Klajdi00/open_mabel/firmware/openarm_dual/include/README

Project headers: CAN bus wrapper (`CanBus.h`), DaMiao and Dynamixel actuators, `Robot`, and the `/robot.json` loader. See ../README.md.
