Klajdi00/open_mabel/web_gui/simulation_control_center/docs/figures/macnav_summary.txt

macnav experimental summary — regenerated by exp_macnav.py
2026-07-02 05:41
================================================================================================
E1 odom   square clean a=0.98            RMS pos 0.008 m (0.3 %/m), yaw RMS 0.26 deg, n=5
E1 odom   square nominal a=0.98          RMS pos 0.011 m (0.4 %/m), yaw RMS 0.56 deg, n=5
E1 odom   square harsh a=0.98            RMS pos 0.033 m (1.1 %/m), yaw RMS 3.04 deg, n=5
E1 odom   spin clean a=0.98              RMS pos 0.051 m (GT path only 0.12 m), yaw RMS 0.87 deg, n=5
E1 odom   spin nominal a=0.98            RMS pos 0.048 m (GT path only 0.12 m), yaw RMS 1.24 deg, n=5
E1 odom   spin harsh a=0.98              RMS pos 0.037 m (GT path only 0.12 m), yaw RMS 2.79 deg, n=5
E1 scrub  square                         gate on 0.008 m vs off 0.008 m RMS (1.0x, n=5+5)
E1 scrub  spin                           gate on 0.048 m vs off 0.076 m RMS (1.6x, n=5+5)
E1 yaw    square nominal                 wheel-only 1.7 deg vs gyro-only 0.60 deg RMS
E2 slam   home n10                       RMSE 0.050±0.001 m, F1 0.92, IoU 0.17, corr 0.66, 21 ms/upd, n=3
E2 slam   home base_n30                  RMSE 0.050±0.005 m, F1 0.89, IoU 0.15, corr 0.61, 60 ms/upd, n=3
E2 slam   home n50                       RMSE 0.053±0.003 m, F1 0.93, IoU 0.17, corr 0.67, 102 ms/upd, n=3
E2 slam   home no_hill                   RMSE 0.061±0.020 m, F1 0.83, IoU 0.16, corr 0.55, 57 ms/upd, n=3
E2 slam   home nxy0.05                   RMSE 0.052±0.004 m, F1 0.91, IoU 0.16, corr 0.63, 60 ms/upd, n=3
E2 slam   home nxy0.30                   RMSE 0.049±0.003 m, F1 0.92, IoU 0.17, corr 0.65, 59 ms/upd, n=3
E2 slam   factory n10                    RMSE 0.079±0.022 m, F1 0.79, IoU 0.20, corr 0.53, 37 ms/upd, n=3
E2 slam   factory base_n30               RMSE 0.069±0.000 m, F1 0.86, IoU 0.22, corr 0.60, 118 ms/upd, n=3
E2 slam   factory n50                    RMSE 0.061±0.004 m, F1 0.86, IoU 0.22, corr 0.61, 201 ms/upd, n=3
E2 slam   factory no_hill                RMSE 0.063±0.018 m, F1 0.77, IoU 0.18, corr 0.49, 117 ms/upd, n=3
E2 slam   factory nxy0.05                RMSE 0.073±0.006 m, F1 0.74, IoU 0.17, corr 0.46, 120 ms/upd, n=3
E2 slam   factory nxy0.30                RMSE 0.069±0.008 m, F1 0.85, IoU 0.22, corr 0.58, 118 ms/upd, n=3
E2 slam   warehouse n10                  RMSE 0.046±0.010 m, F1 0.83, IoU 0.25, corr 0.58, 41 ms/upd, n=3
E2 slam   warehouse base_n30             RMSE 0.060±0.002 m, F1 0.77, IoU 0.23, corr 0.53, 128 ms/upd, n=3
E2 slam   warehouse n50                  RMSE 0.067±0.003 m, F1 0.82, IoU 0.25, corr 0.57, 214 ms/upd, n=3
E2 slam   warehouse no_hill              RMSE 0.062±0.010 m, F1 0.61, IoU 0.15, corr 0.36, 124 ms/upd, n=3
E2 slam   warehouse nxy0.05              RMSE 0.065±0.001 m, F1 0.77, IoU 0.22, corr 0.53, 115 ms/upd, n=3
E2 slam   warehouse nxy0.30              RMSE 0.060±0.005 m, F1 0.83, IoU 0.26, corr 0.60, 103 ms/upd, n=3
E3 nav    home base K=256 lam=0.35       success 9/10, t 4±1 s, eff 1.21, min clear 0.34 m
E3 nav    factory base K=256 lam=0.35    success 10/10, t 4±1 s, eff 0.98, min clear 0.42 m
E3 nav    warehouse base K=256 lam=0.35  success 8/10, t 4±1 s, eff 0.99, min clear 0.00 m
E3 mppi   home K64_l0.2                  success 4/6, eff 1.15
E3 mppi   home K64_l0.35                 success 5/6, eff 1.07
E3 mppi   home K64_l0.6                  success 5/6, eff 1.11
E3 mppi   home K256_l0.2                 success 4/6, eff 1.04
E3 mppi   home K256_l0.6                 success 5/6, eff 1.04
