Klajdi00/open_mabel/hardware_bridge/docs/gravity_ff_tracking.pdf

## Gravity feed-forward vs. position tracking on the MABEL left arm

Hardware-bridge experiment gravity ff tracking

2026-07-14

Question

Does gravity feed-forward measurably improve joint position tracking on the real arm, and by how much? The concern is the classic failure of a PD servo: it sags under a sustained load and cannot be tuned out.

Why tuning cannot fix it

The arms run the DaMiao MIT law T = kp(q

∗ − q) + kd( ˙q

∗ − q˙) + tff. At a static hold ˙q = 0, so the motor must supply the joint’s gravity torque τg(q):

kp (q

∗ − q) + tff = τg(q) | =⇒ | ess =

τg(q) − tff
kp

With no feed-forward (tff = 0) the steady-state error is a pure droop ess = τg(q)/kp. It is not a tuning problem: DaMiao packs kd into 12 bits over [0, 5], so kd ≤ 5 is a hardware cap; a critically damped loop then caps kp ≈ 15 on the shoulder. A bigger gain is simply unavailable. A correct feed-forward tff = τg(q) cancels the load and drives ess → 0 regardless of kp.

Method

The left shoulder-pitch joint (left arm 2, kp = 14.9) was commanded to three elevated angles where gravity actually loads it (τg from 3.1 N m hanging to 7.3 N m lifting out). Each target was held 12 s; the steady-state angle is the median of the last 3 s. Targets were sent over the :9090 joint command wire message — the same path the iOS app uses — so this also confirms the operator control path end to end. The run was executed twice, once with MABEL HW ARMS FF SCALE=1 and once =0, and the FF state of each pass was verified against the running process (a first automated attempt left FF on in both passes; that run was discarded).

Result

target | FF OFF (pure PD) | FF ON (grav. comp) improvement
(deg) | settled (deg) | error | settled (deg) | error
17.2 | 10.0 | −7.2
| | ◦ | 16.8 | −0.3 ◦ 6.8

◦
31.5 | 19.0 | −12.5
- | 34.1 | +2.6
| | | | ◦ 9.9

◦
45.8 | 28.9 | −16.9
- | 50.2 | +4.4
| | | | ◦ 12.5

◦

1

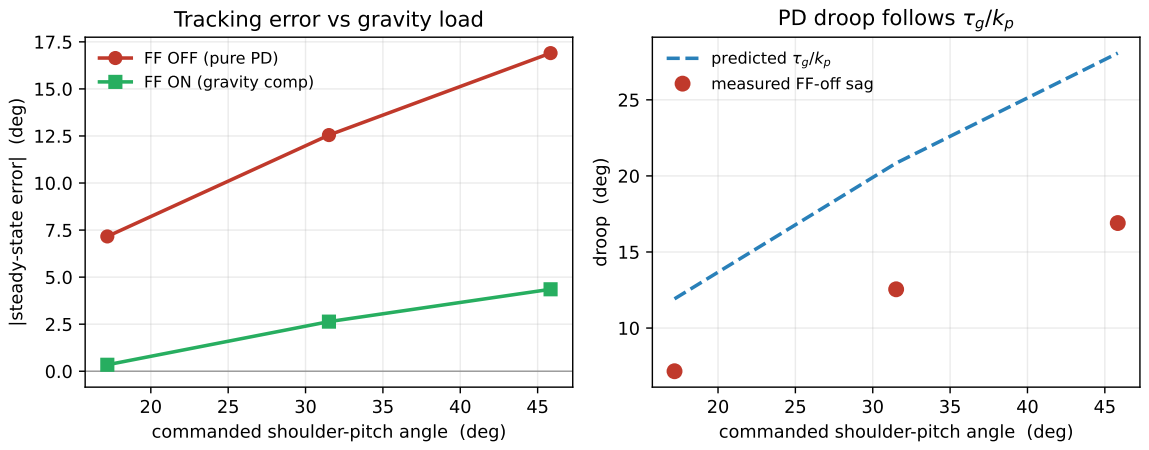
[picture p11: figure]
commanded shoulder-pitch angle (deg); |steady-state error| (deg); Tracking error vs gravity load; FF OFF (pure PD) FF ON (gravity comp); droop (deg); PD droop follows τg/kp; predicted τg/kp measured FF-off sag

Conclusion

Gravity feed-forward reduces the steady-state tracking error from as much as 17◦ of droop to within 4

◦
, and the FF-off droop tracks the predicted τg/kp — confirming the sag is the gravity term, not friction or a control bug. The remaining FF-on error is a slight over -shoot (+4.4

◦
) at the highest
angle, i.e. the model lifts marginally too hard there; this is the one open knob (the shoulder-mount tilt, 0◦ on the metal vs. −10◦
in the MJCF, and the hands-removed mass model). It is small and can be trimmed with MABEL HW ARMS FF SCALE slightly below 1 or by revisiting the mount angle. Net: gravity compensation is working and is essential — without it the arm cannot hold a lifted pose.

2
