Klajdi00/open_mabel/hardware_bridge/docs/figures/arm_controllers.pdf

Steady-state tracking error vs gravity load — the 3 controllers on the real left arm

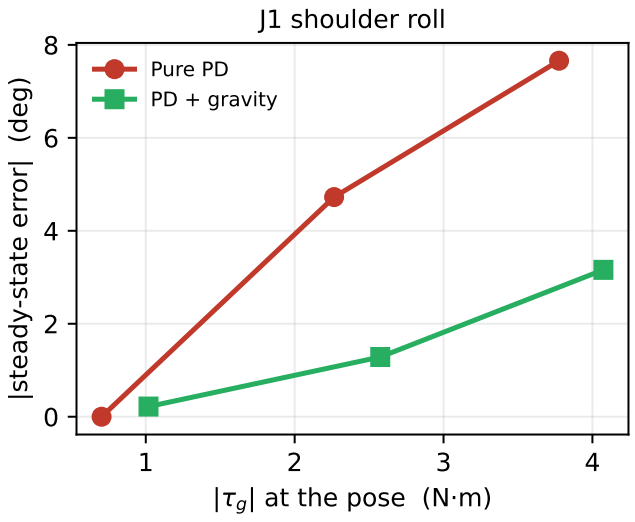
[picture p15: figure]
|τg| at the pose (N·m); |steady-state error| (deg); J1 shoulder roll; Pure PD PD + gravity
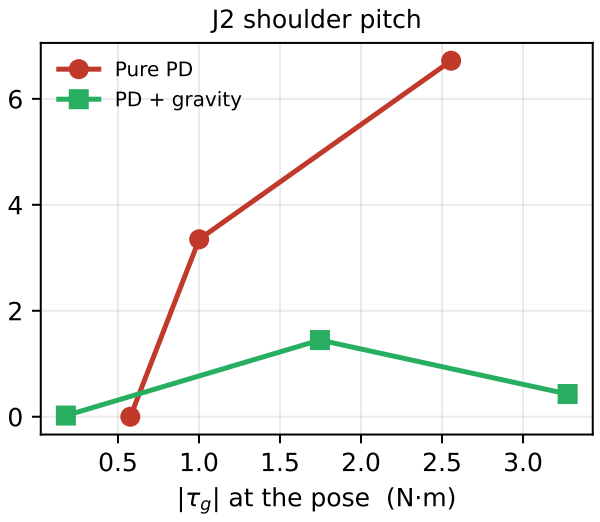
[picture p16: figure]
0.5 1.0 1.5 2.0 2.5 3.0 |τg| at the pose (N·m); J2 shoulder pitch; Pure PD PD + gravity
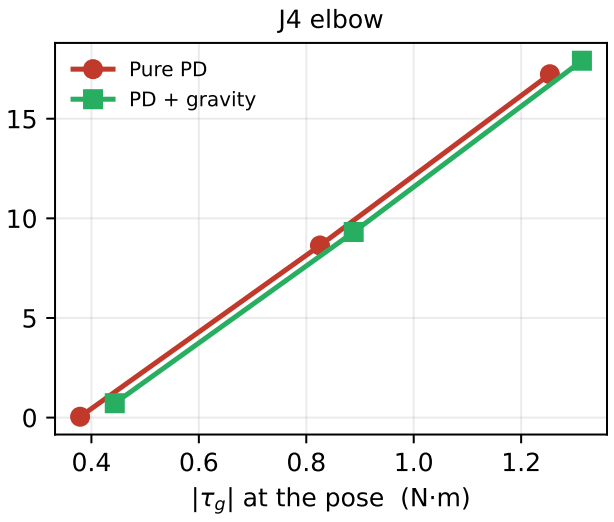
[picture p17: figure]
|τg| at the pose (N·m); J4 elbow; Pure PD PD + gravity
