Klajdi00/open_mabel/hardware_bridge/docs/figures/gravity_ff_tracking.pdf

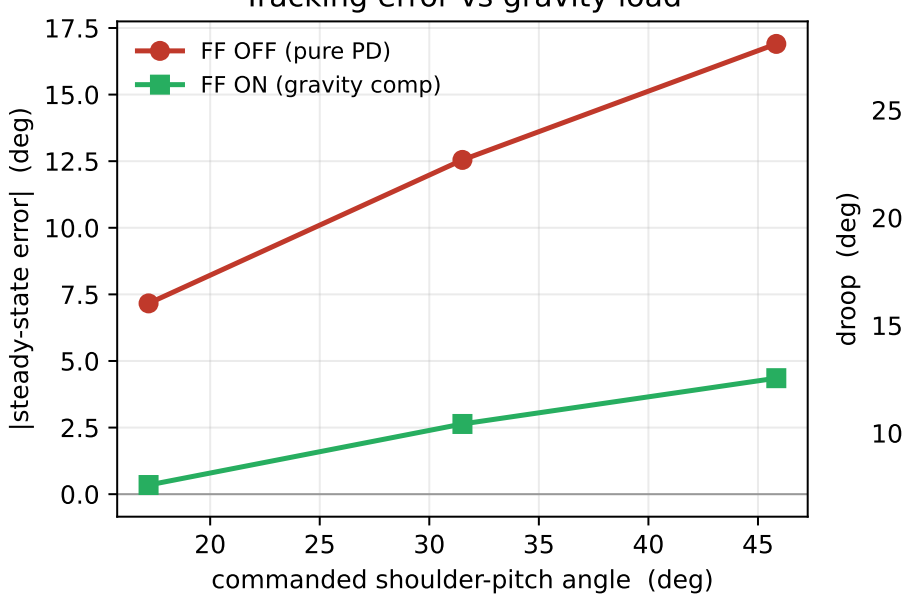
[picture p18: figure]
commanded shoulder-pitch angle (deg); |steady-state error| (deg); FF OFF (pure PD) FF ON (gravity comp); droop (deg)

### Tracking error vs gravity load

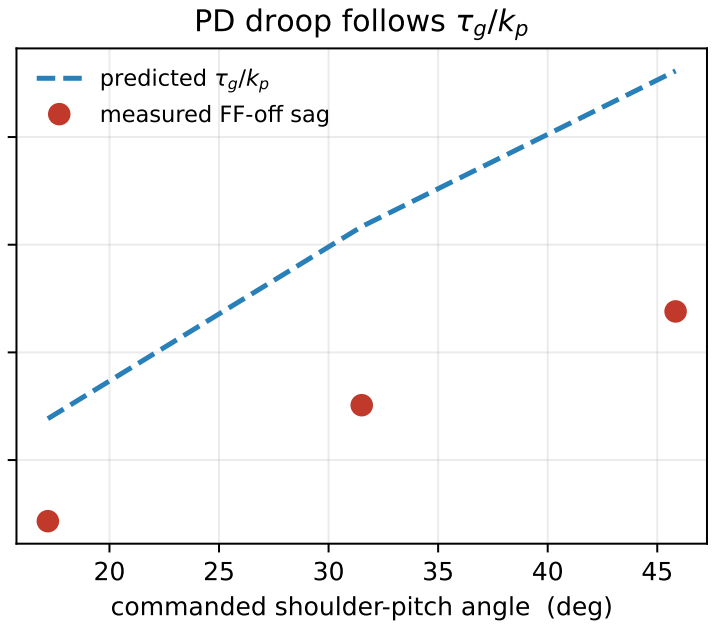
[picture p19: figure]
commanded shoulder-pitch angle (deg); ollo

p measured FF-o | r e dic t e d τ | / kp g ff sag
