Klajdi00/open_mabel/controller/docs/basic_controller.pdf

## A Minimal Task-Space Arm Controller for MABEL: Pure PD, and What Gravity Compensation Buys

MABEL controller subsystem

19 July 2026

Abstract

We rebuild MABEL’s arm controller from the smallest law that can hold a limb — a joint-space PD — and add task-space wrist tracking on top of it as a separate, independently measurable stage. The rewrite is motivated by a diagnosis problem rather than a performance one: in the layered controller it had become impossible to answer which stage was responsible when an arm misbehaved. We characterise the pure-PD baseline, show that its steady-state droop is exactly the uncompensated gravity torque (τg/kp, measured against prediction per joint), and quantify what a gravity feed-forward is worth. At kp = 400 the feed-forward reduces palm error from 14.2 mm to 0.38 mm — a 37× improvement — and a compensated arm at kp = 100 is more accurate than an uncompensated one at kp = 800, i.e. the feed-forward buys more than an eightfold stiffness increase without the stiffness.

Keywords: joint-space PD, gravity compensation, damped least squares, task-space control, redundancy resolution, MuJoCo.

## 1 Motivation

The previous arm controller was a layered stack: a retargeting engine, a whole-body torque engine, per-region set-points, and a facade routing between them. It worked, but it had one property that made it expensive to own — when the arm did something unexpected, the observable was a single symptom (“the arm sags”, “the hand goes crazy”) and there was no measurement that localised the cause. Two failures traced to that opacity: a gravity feed-forward that ran only when an operator pose frame arrived, so it never ran in the stick-only drive mode; and a set-point map that silently skipped the wrists, so the torque law re-defaulted them to the measured angle every tick — a damper, not a hold, which creeps.
This document describes the replacement baseline. The design goal is not peak performance; it is that every stage reports its own error.

## 2 Method

### 2.1 Joint-space PD

For each joint i in the controlled chain,

τi = kp,i (q

∗
i − qi) − kd,i q˙i + gi(q)
| {z }
optional
, | (1)

clamped to the actuator’s declared force range. With g ≡ 0 this is a pure PD. At equilibrium q˙ = 0 and the joint settles where the proportional term balances the load,

kp,i ei = τg,i | =⇒ | ei =

τg,i

kp,i

, | (2)

so the steady-state droop is fully determined by the gravity torque and the gain. Equation (2) is a prediction we test directly in §3.2.

One law per joint. The MJCF drives these joints with position actuators, which are themselves a PD (kp=100, kd=20 on the arms). Attaching our controller therefore neutralises the servo of every joint it owns and restores it on detach. Without this, any measurement describes the sum of two controllers rather than the one under test — an easy and completely silent way to characterise the wrong system.

Gravity term — model-based, and the same on hardware. The compensation is computed from an a-priori rigid-body model and the measured joint angles, in numpy, with no call into the simulator:
τg,i(q) = −

X

j≥i

zˆi × (cj − pi)
- (mj g), | (3)

the weight of every link distal to joint i, moment-armed about that joint’s axis. The axes zˆi
, anchors
pi and link centres of mass cj come from forward kinematics on q; the constants mj , the fixed link transforms and the COM offsets are baked once from the MJCF (extract arm params.py), the same class of a-priori data a URDF carries. An earlier version read MuJoCo’s qfrc bias — correct and one line, but privileged: it needs a live simulator, which the physical arm does not have, and it folds in contacts and external wrenches, which a feed-forward should not. Equation (3) needs only the model and the encoders, both of which exist on hardware, so one controller runs in simulation and on the robot. It is velocity-free by construction — no Coriolis, so no risk of cancelling the damping (1) relies on. Its agreement with MuJoCo’s own gravity torque (§3.7, < 3 × 10⁻⁷ N m over the workspace) is what licenses the swap. The finger links are lumped into their nearest arm ancestor at the hand’s rest pose; with the hand fully articulated this costs at most 0.14 N m (0.9%), measured, not assumed.

Base orientation. Gravity enters through the shoulder’s orientation, so a pitched torso changes the load. (3) takes the world←base rotation; on the robot it comes from the torso/lift encoders or an IMU, and it defaults to the rest-pose lean baked by the extractor rather than to a bare “upright” assumption, which would be a silent 10–20% error on the shoulder joints.

### 2.2 Task-space wrist tracking

The wrist target is resolved to joint angles by damped least squares. With J ∈ R

3×n
the palm’s
positional Jacobian restricted to the chain and e = x

∗ − x the task error,

∆q = J

⊤

JJ⊤ + λ
2
I

−1
e +
I − J
| | +J
kn (qrest − q). | (4)

The chain is 7-DOF against a 3-DOF task, so the null space is four-dimensional and must be resolved or it drifts: two frames identical at the fingertip can differ by an elbow swung through the torso. The second term applies a weak posture pull with gain kn.

Damping is a safety parameter. Near a singularity, or for a target outside the reachable set, JJ⊤ is ill-conditioned and an undamped pseudo-inverse requests unbounded joint rates — the familiar failure where dragging a target past the arm’s reach makes the arm explode. The λ

2
I term
bounds the step; §3.5 shows the residual growing linearly and the joints remaining inside their limits rather than diverging. λ should be tuned for stability, never for speed.

The ORCA wrist is excluded from the chain. It carries the hand and belongs to grasp orientation, not to reaching. Allowing a position-only solver to spend it is what twists the hand while the palm sits perfectly on target.

## 3 Experiments

All figures are regenerated from scratch by controller/experiments/exp basic controller.py against the canonical MJCF (simulation/mabel mujoco/scenes/mabel home.xml), right arm, 2 ms timestep, 4 s of settling per steady-state measurement, kd = 2p
kp.

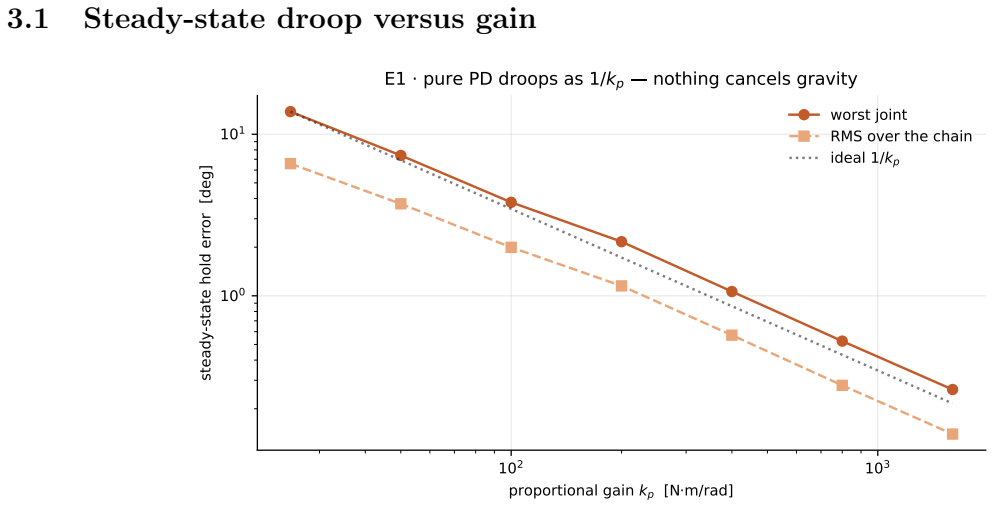
[picture p20: figure]
3.1 Steady-state droop versus gain; proportional gain kp [N·m/rad]; steady-state hold error [deg]; worst joint RMS over the chain; ideal 1/kp

E1 · pure PD droops as 1/kp nothing cancels gravity

The droop follows 1/kp across six octaves: 13.80◦ at kp=25 falling to 0.26◦ at kp=1600, each doubling of gain halving the error, exactly as (2) requires.

### 3.2 Per-joint droop against prediction

J1 | J2 | J3 | J4 | J5 | J6 | J7

1

0

1

2

3

4

steady-state error [deg]

E2 · the droop IS the gravity torque the PD cannot cancel

measured droop
predicted g/kp

Joint measured [◦
] predicted τg/kp [
| | ◦
]
J1 | +3.460 | +4.026
J2 | −0.762 | −0.950
J3 | +0.514 | +0.711
J4 | +3.791 | +4.073
J5 | −0.000 | +0.021
J6 | +0.070 | +0.189
J7 | −0.829 | −1.071

Measurement tracks prediction in sign and magnitude on every joint, and the load concentrates in J1 and J4 as expected. The systematic 10–25% shortfall is itself explained by (2): the joint droops, which changes the configuration, which reduces τg — the prediction is evaluated at the commanded pose, the measurement at the settled one.

### 3.3 Static wrist tracking, and where the error lives

+x | -x | +y | -y | +z | -z | diag

0

5

10

15

20

25

error [mm]

E3 · where the error lives: the IK found it, the PD did not hold it

IK residual (solver)
palm error (solver + PD)

At kp=400 over seven 10 cm offsets, the IK residual is 0.06–0.65 mm while the settled palm error is 12–27 mm. The solver is two orders of magnitude better than the arm that follows it: the entire task-space error is the joint-space droop. This is the diagnostic the rewrite exists to produce.

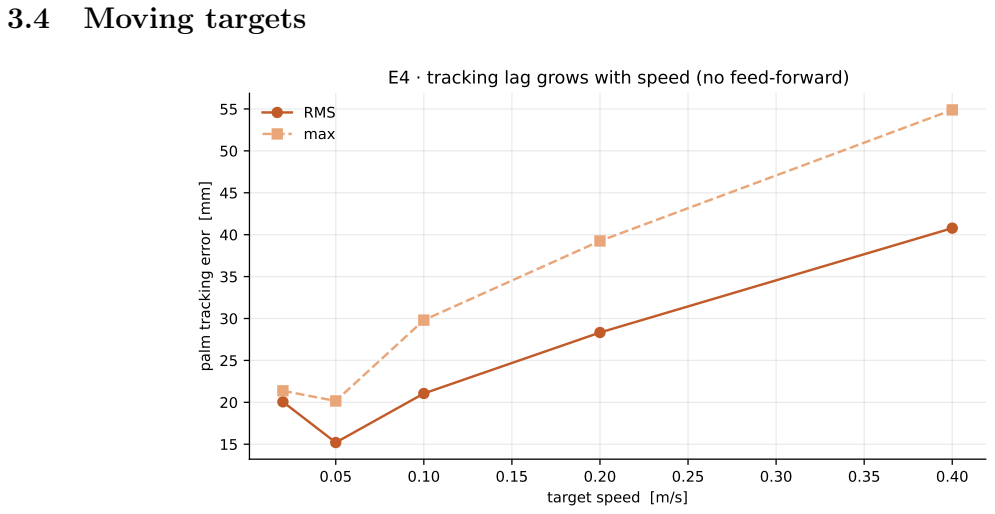
[picture p21: figure]
3.4 Moving targets; target speed [m/s]; palm tracking error [mm]; RMS max

E4 · tracking lag grows with speed (no feed-forward)

Tracking a 6 cm circle, RMS palm error grows from 20 mm at 0.02 m/s to 41 mm at 0.40 m/s. With no velocity feed-forward the lag is expected to grow with speed; the floor at low speed is again the static droop.

### 3.5 Behaviour past the reach limit

0 | 10 | 20 | 30 | 40 | 50 | 60
target distance beyond the home palm position [cm]

0

100

200

300

400

IK residual [mm]

E5 · past the reach limit the solver saturates, it does not diverge

Pushing the target outward, the residual stays near zero to ∼15 cm beyond the home palm position and then grows linearly (120 mm at +0.30 m, 417 mm at +0.60 m) — the solver saturates against the joint limits and reports a large residual rather than diverging.

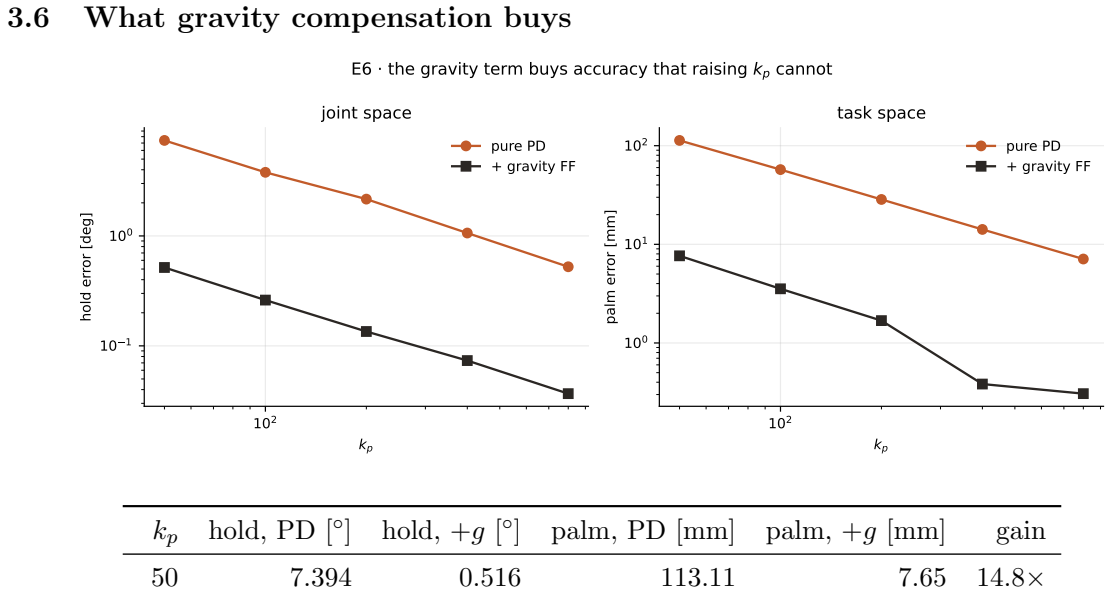
[picture p22: figure]
3.6 What gravity compensation buys; hold error [deg]; joint space; pure PD + gravity FF; palm error [mm]; task space; hold, PD [◦; ] hold, +g [; ] palm, PD [mm] palm, +g [mm]; gain

E6 · the gravity term buys accuracy that raising kp cannot

100 | 3.791 | 0.261 | 57.24 | 3.54 | 16.2×
200 | 2.162 | 0.135 | 28.51 | 1.69 | 16.9×
400 | 1.063 | 0.073 | 14.16 | 0.38 | 36.9×
800 | 0.524 | 0.037 | 7.10 | 0.31 | 23.2×

The feed-forward is worth one to two orders of magnitude at every gain. The practical statement is the cross-comparison: a compensated arm at kp=100 (3.44 mm) outperforms an uncompensated one at kp=800 (7.10 mm), so the gravity term buys more than an eightfold stiffness increase and leaves the arm compliant. Raising kp to hide droop purchases stiffness nobody asked for and an oscillation nobody wants.

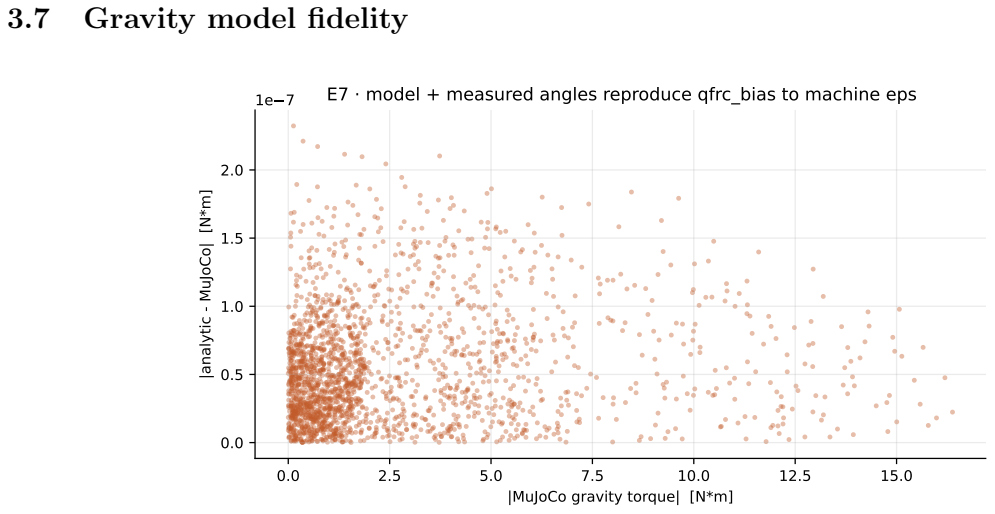
[picture p23: figure]
3.7 Gravity model fidelity; |MuJoCo gravity torque| [N*m]; |analytic - MuJoCo| [N*m]

1e 7 E7 · model + measured angles reproduce qfrc_bias to machine eps

Over 300 random arm poses the analytic model of (3) reproduces MuJoCo’s qfrc bias to 2.3 × 10⁻⁷ N m against torques up to 16.4 N m — machine precision, computed at runtime in numpy from the baked constants and the joint angles alone. This is the evidence that replacing the simulator-privileged term with a hardware-portable one costs nothing in simulation, so the same code can be trusted on the physical arm.

## 4 Implementation and usage

from mabel.basic import TaskSpaceArm
arm = TaskSpaceArm(model, data, side="right", kp=400, kd=40,
gravity=True).attach() | # numpy-only gravity model
arm.set_wrist_target([x, y, z]) | # world metres; None -> hold
while running:
arm.set_base_orientation(torso_R) | # encoders/IMU on the robot
arm.step() | # IK -> q*, then torque
mujoco.mj_step(model, data) | # (or the real arm’s step)
print(arm.ik_err, arm.task_error(), arm.joint_error())

mabel/basic/ is: pd.py (the law + actuator ownership), wrist ik.py (DLS with null-space posture), arm.py (the composition + measurement surface), gravity.py (the numpy gravity model) and arm params.py (constants baked by extract arm params.py). Guarded by controller/tests/test basic controller.py (15 tests): the 1/kp law, the > 5× gravity improvement, torque clamping, actuator restoration, out-of-reach saturation, the velocity-independence of the gravity term, the machine-precision match to qfrc bias, that gravity.py imports no simulator (AST-checked), and that the baked masses still match the MJCF.

## 5 Limitations

- Position-only IK. Palm orientation is unconstrained. Grasping needs a 6-DOF task; (4) extends to a stacked Jacobian, but the redundancy shrinks to one dimension and the posture term matters more.
- No velocity feed-forward. §3.4’s lag is the direct consequence. A x˙
∗
term through J

+ is
the obvious next step.
- Model-based gravity, fixed payload. g(q) is only as good as the baked masses. The arm’s own links are known well; a grasped load is not modelled, and the ORCA hand alone is 1.74 kg per wrist, so a heavy object will droop until an online payload estimate is added.
- Single arm, no whole-body coupling. Torso, lift and base are outside the chain, so their motion is a disturbance the PD rejects rather than a coordinated degree of freedom.
- Simulation only. Every number here is MuJoCo. Nothing in this document has been measured on the physical robot.

## 6 References

1. Y. Nakamura and H. Hanafusa, “Inverse kinematic solutions with singularity robustness for robot manipulator control,” J. Dyn. Sys. Meas. Control, 108(3), 1986.
2. C. W. Wampler, “Manipulator inverse kinematic solutions based on vector formulations and damped least-squares methods,” IEEE Trans. SMC, 16(1), 1986.

3. S. Chiaverini, “Singularity-robust task-priority redundancy resolution for real-time kinematic control of robot manipulators,” IEEE Trans. Robotics and Automation, 13(3), 1997.
4. B. Siciliano and O. Khatib (eds.), Springer Handbook of Robotics, 2nd ed., 2016, ch. 8 (Motion Control).
5. E. Todorov, T. Erez, Y. Tassa, “MuJoCo: A physics engine for model-based control,” IROS, 2012.
