Klajdi00/open_mabel/controller/docs/mabel_controller.pdf

## The MABEL Teleoperation Control Stack: A Complete and Honest Technical Reference

Frames, Retargeting, Whole-Body Control, Mobile-Base IK, the Tip-Over Motion Model, Self-Collision Avoidance, and Safety

MABEL Project — Control & Teleoperation

July 28, 2026

Abstract

This is the single, end-to-end reference for MABEL’s teleoperation control stack: an operator wearing a head-mounted tracker (Apple Vision Pro, but the design is device-agnostic) drives a mobile bimanual humanoid — a 3-module swerve base, a cascaded vertical lift, a leaning torso, a 3-DoF neck, two 7-DoF arms, and two 17-DoF ORCA hands. We follow the data the whole way through, from raw operator poses to robot actuator targets, deriving every optimization, stating every control law, and — critically — being explicit about every hardcoded constant and every design decision taken along the way (the --lock mode, the collision-avoidance integration, the ORCA-wrist treatment, the objective-weight balancing). All robot-side quantities are computed by forward kinematics on the robot model (no privileged simulator state), so the same code runs in simulation and on hardware. The document is honest about the present state: two implementations coexist and are being consolidated (§1); we say which is which throughout.

Keywords: teleoperation, humanoid whole-body control, inverse kinematics, control barrier functions, swerve drive, tip-over stability, retargeting, MuJoCo.

## Contents

1 State of the codebase (read this first) | 2
2 The pipeline at a glance | 3
3 Frames and the operator→robot map | 3
4 Hand retargeting optimization | 4
5 Arm IK optimization | 5
6 Neck optimization | 7
7 Whole-body control | 7
8 Mobile-base inverse kinematics (swerve) | 9
9 Base motion model (tip-over safety) | 9

10 Self-collision avoidance | 10
11 Safety: fail-safe engagement and clutch | 11
12 Deployment: the bridge integration | 12
13 Experiments | 13
14 The configuration registry: control param.json | 17
15 Every hardcoded part, in one place (honesty section) | 18
16 Limitations | 19

## 1 State of the codebase (read this first)

Two control stacks currently exist and are being merged into one library:

- Production controller — the package controller/mabel/. It is installable (pip install -e

controller/, or controller/install.sh; import mabel) and exposes a frontend-agnostic facade MabelTeleop mapping an OperatorPose to a RobotCommand. Since the 2026–07 reorganisation the package is structured by control responsibility: sources/ (device ingest: wire / Vision Pro ZMQ / mock → OperatorPose); hand retargeting/ (keypoint IK, vector, anatomical — positioncontrolled, decoupled from the body); whole body retargeting/ (clutch wrist SE(3) map, cosine arm IK, the decoupled neck look-at, lazy followers, per-operator calibration); motion model/ (the lift-aware tip-over/ZMP envelope tip over.py — NumPy-only, re-exported by config — plus live CoM measurement and the calibrated base response); dynamic models/ (the MuJoCo dynamics oracle, the generalized-momentum observer, and the three control regions arms/, upper body/, whole body/); and whole body controller/ (differential IK, the Day-1 PD position controller, gravity compensation, capsule collision avoidance, admittance = wrench estimation + base glide, region-selectable compliance, the swerve base controller, and the WBCEngine runtime). plant.py is the single sim/real seam. Every old flat module path (mabel.wbc, mabel.swerve, mabel.dynamics, . . . ) remains importable through compatibility shims.

- Research / simulation stack — the package simulation/mabel mujoco/scripts/teleop/, driven by avp teleop.py. It re-implements retargeting with a cosine-similarity formulation (the subject of most of §4–§7), and adds the safety layer (§11) and the arm self-collision projector (§10).

Where a component differs between the two, both are described and the difference is flagged. The shared, single-source pieces — the swerve IK (§8), the tip-over motion model (§9), and the capsule self-collision guard (§10) — live in mabel and are used by both. The safety primitives (§11) were developed in the research stack and have been ported into mabel.safety.

Single | deployment | surface. As of this revision the production WebSocket bridge
(server/sim teleop bridge.py) drives the robot exclusively through MabelTeleop: every frontend

(Apple Vision Pro, iOS, web) sends the same teleop frame wire payload, which the package itself ingests (OperatorPose.from teleop frame, mabel.wire), and the bridge issues one teleop.update() per physics substep. All control orchestration — mode/region switching, the whole-body torque engine, the direct joint override, the operator push, the clutch and the fail-safe — now lives behind the facade (§12), so the controller can be modified without touching the bridge or the apps.

## 2 The pipeline at a glance

The control loop is a feed-forward flow with two cross-cutting layers (safety and self-collision) wrapped around it:

operator pose

§3
−−→ frame map −→

h
hand retarget
| | {z | }
| §4
, arm IK | {z }

§5

, neck |{z}

§6

i

−→ whole-body cascade
| | {z | }
§7

−→ base motion model
| | {z | }
§9
−→ swerve IK | | {z | }

§8

−→ robot.

The self-collision filter (§10) projects the arm targets onto a barrier-safe set; the safety supervisor (§11) eases the whole body to a home pose on tracking loss and re-engages on recovery. The robot is physically simulated: retargeted joint angles drive position-servo actuators with a feed-forward gravity torque g(q) so the arms/lift/torso hold their pose without PD sag.

## 3 Frames and the operator→robot map

Operator poses arrive in an ARKit-style world: +Y up, +X right, −Z forward. They are carried into the robot world (Z up, −X front, +Y right) by a fixed rotation A, anchored once at calibration by the pair (p

op
0

, prob
0

) = (operator head, robot head via FK):

W(p) = p

rob
0 + s A (p − p

op
0

), A =

0 0 1
1 0 0
0 1 0
- , | s = reach scale. | (1)

A maps forward→front, up→up, right→right. [hardcoded] A is a fixed permutation; in the production stack it is config.AVP TO ROBOT and the relative-rotation variant composes it with a fixed WRIST ALIGN (identity unless a headset needs a calibrated wrist-axis correction). Because the anchor is a world reference, the robot tracks the operator’s global translation and heading (walking, turning), not just head-relative motion.

Reach calibration (design decision). s is not a guess: the operator extends both arms straight forward; we measure the human reach (head→wrist, mean of the tracked hands) and the robot reach (a self-contained damped-least-squares extension of the arm), and set s = robot reach/human reach (clipped to [0.5, 3.0], default 1.2). Only the arm targets are scaled by s; the finger optimization is fully decoupled with its own per-finger scales (§4).

Capture rule (redesigned 2026-07-19). The app-driven capture (engine. calibrate step) locks the scale when the arm-length number stabilises: over a rolling 1.0 s window the reach samples must (i) number n ≥ 3, (ii) span ≥ 0.5 s of wall time, and (iii) have standard deviation ≤ 2 cm; after 0.25 s of sustained stillness the window median is captured. The previous rule (≥ 5 samples

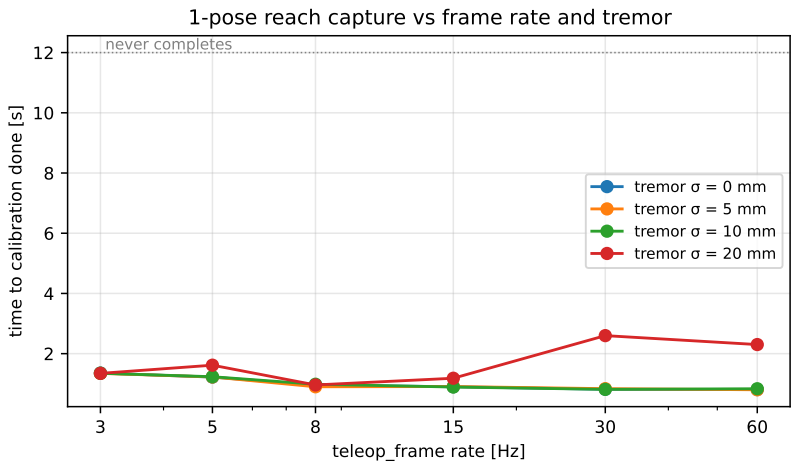
[picture p39: figure]
teleop_frame rate [Hz]; time to calibration done [s]; never completes; tremor = 20 mm

## 1-pose reach capture vs frame rate and tremor

tremor = 0 mm tremor = 5 mm tremor = 10 mm

Figure 1: Reach-capture completion time vs. teleop frame rate and synthetic wrist tremor σ under the redesigned stillness rule (span ≥ 0.5 s, n ≥ 3, std ≤ 2 cm, 0.25 s hold, median capture), measured end-to-end over the WebSocket wire. Every cell completes; under the old count-andrange rule the ≤ 5 Hz column and the high-rate σ = 20 mm cells never did. Regenerate with server/tools/exp calibration robustness.py (seeded, 2 trials/cell).

inside a 0.6 s window with max − min ≤ 5 cm) failed in both directions, measured over the real wire by server/tools/exp calibration robustness.py (Fig. 1): below ∼ 8 Hz effective frame rate five samples never fit the window, so the capture could never complete (a loaded headset app streams that slowly), while under 2 cm operator tremor the range statistic grew with the sample count, so a faster stream was more likely to fail (60 Hz failed where 8 Hz passed). Time-span plus standard deviation are rate-independent, and the median rejects single ARKit outliers: after the redesign all 24 sweep cells (3–60 Hz × 0–20 mm tremor, 2 trials each) complete in 0.8–2.6 s; before it, 10 of 24 never completed. The Vision Pro app mirrors the rule on-screen (CalibrationCoach) and additionally displays the server’s own live median (additive calibrationStatus.reachLive/spread/hold telemetry), so the ring can never fill ahead of the capture the server is actually timing.

## 4 Hand retargeting optimization

Goal: map the operator’s finger skeleton to the 16 actuated finger DoFs/hand so the robot fingertips do what the human’s do — including touching when the human’s touch.

Canonical palm frame (key design decision). Each finger keypoint is matched in a canonical palm frame (forward = down the middle finger, side = index→pinky, normal = palm out) built independently from the operator anatomy and from the ORCA geometry. Because both frames come from their own hand, a given anatomical direction aligns by construction; this removed a hand-guessed rotational offset R offset that the earlier version needed (and which made hand orientation track poorly). The frame is built from the named knuckle/metacarpal joints when present, else from the 21-point MediaPipe array.

Cosine-similarity objective (research stack). For the 16-DoF finger vector q, with robot keypoint set {rk(q)} (FK in the canonical frame) and scaled human keypoints {hk}, minimize

Lhand(q) = Wc

1 −

⟨r,h⟩
∥r∥ ∥h∥

| | {z | }
direction

+ Wr

X

(a,b)

(rb−ra) − (hb−ha)

2

| | {z | }
relative (pinch) distances

+Ws∥q − qprev∥

2 + Wreg∥q∥

2
, (2)

where r, h are the stacked keypoint vectors. The relative-distance term over the thumb↔fingertip pairs is what makes the robot fingertips meet when the operator pinches: two coincident operator tips map to one robot point regardless of scale, so the gap goes 0 → 0. Solved with SLSQP. [hardcoded] the per-finger scales SCALES (default all 1.0), the weights Wc=20, Wr=150, Ws=0.5, Wreg=0.02, and the finger/joint name maps.

Production stack alternative. HandIKRetargeter solves the same correspondence by Gauss– Newton (4 iterations, ≈ 0.5 ms/hand, warm-started, background-threaded at 20 Hz) — much faster than the SLSQP reference (≈ 3 ms). A legacy frame-invariant angle-extraction mapping (hand retarget) and a pinch-only fallback (hands.apply grasp) also exist.

Live app path (since 2026-07). On the WebSocket app path (Vision Pro / iOS / web via MabelTeleop → TeleopEngine) the fingers run scripts/teleop/hand anatomical.py: a validated line-faithful port of the control-center GUI’s webcam anatomical decomposition (bodyteleop.decomposeHand + the calibrated ORCA ranges, PIP+¹
2DIP coupling, thumb opposition from the metacarpal’s dive below the palm plane), so every input device — webcam or headset — maps hands through one algorithm. Parity with the actual JS is regression-tested to machine precision (scripts/tools/exp vp app teleop.py, E1: max ∆ = 6.7×10⁻¹⁶ rad over 200 random hands; note the chirality sign flips for true-ARKit skeletons because MediaPipe labels handedness on the selfie-mirrored convention). The SLSQP optimizer (2) remains the desktop-entry solver and still provides the canonical robot palm frame to the arm retargeter. The same 2026-07 rewiring restored the arm cost’s elbow term on the headset path (elbows derived from ARKit forearm arm) and the base yaw-follow (elbow-line body yaw estimated in-engine); see teleop system.pdf §6.

## 5 Arm IK optimization

Goal: place each hand at the operator’s wrist/contact target with a human-like posture — no weird twist, graceful near singularities, fast.

Why cosine SLSQP, not Jacobian DLS. The research arm IK lifts the finger optimizer’s idea to the arm: it matches directions and a contact point rather than inverting a Jacobian, so it is smooth and never erratic at singularities (no J

−1
). The optimized vector is q = [Arm1 . . . Arm7, wrist] (§5.1). The cost is

Larm(q) = Wwrist ∥c(q) − c

⋆
∥

2
(contact position — primary)

+ Welbow
1 − eˆ(q)·eˆ

⋆
(elbow direction from the shoulder )

+ Worient-
(1 − f ·f

⋆
) + (1 − u·u

⋆
)
(palm forward + normal axes) (3)

+ Wsmooth∥q − qprev∥

2 +

X

i

ρi (qi − q

nom
i

)

2
. (temporal + per-joint posture)

The contact point c(q) = wrist(q) +hand reach·Rp(q) ˆx sits a fixed distance ahead of the ORCA wrist along the palm, so bimanual fingertip contact maps to one robot point (scale-invariant, like the fingers). The elbow term takes the direction from the shoulder (not the head) — this is the single most important anti-twist term: it pins the redundant elbow to the human’s, stopping the arm from “flipping” into back-of-robot configurations.

Objective-weight balancing (experimentally tuned, §13). The balance principle, confirmed by a sweep: position must dominate (Wwrist=600 ≫ the rest) or the hand misses; the elbow term shapes the null-space but if it climbs (≳ 100) it fights the wrist and tracking degrades — Welbow=30 is the balance; orientation Worient=20; smoothness Wsmooth=2 is the sweet spot (1 jitters, ≥ 4 lags and loses accuracy). The per-joint posture weights ρi are a mobility prior : [hardcoded] ARM REG W= [0.08, 0.08, 0.40, 0.08, 0.02, 0.08, 0.60] — hold shoulder-roll (Arm3) hard so the roll is done by the forearm, leave forearm-roll (Arm5) free so the hand can flip up, and hold wrist-yaw (Arm7) hard.

Wrist-yaw constraint (design decision). A human wrist barely yaws (radial/ ulnar deviation ≈ ±25◦
). So Arm7’s optimization bound is hard-clipped to rest ±arm j7 yaw lim = 0.45 rad (intersected with the model range), forcing any palm flip onto the forearm and the ORCA wrist rather than letting the solver spin the last joint to fake orientation. This was added after observing exactly that failure mode (Arm7 spinning, arm twisting).

The --lock mode (design decision). A CLI flag fixes Arm7 at its rest value, giving a 6-DoF arm + the ORCA wrist. It was added for hardware where Arm7 is unreliable or for a simpler kinematic chain; the IK then optimizes 6 (or 7 with the wrist) joints and Arm7 is held at j7 lock val.

### 5.1 The ORCA wrist as a jointly-optimized DoF

This was a deliberate change with a measured justification. The ORCA hand has a 1-DoF wrist (pitch). Originally it was hardcoded: the operator’s 1-DoF wrist flexion was projected onto it (set wrist flex), decoupled from the arm IK. We made it an 8th jointly-optimized DoF (solved from the orientation objective, ARM OPTIMIZE WRIST=True, light regularization ARM REG WRIST= 0.03). Rationale: the extra DoF adds redundancy that the orientation term can use to flip the palm up/down without twisting Arm7 or the shoulder. Measured head-to-head (§13), even giving the hard-coded mode the oracle (ground-truth) wrist, the jointly-optimized wrist tracked better (contact 23 → 20 mm), matched orientation better, and twisted less (wrist-yaw 9.1 → 7.1

◦
). End-to-end
IK accuracy improved 30 → 16 mm (median). The +2 ms cost of the 8th DoF was recovered by lowering the SLSQP iteration cap 45 → 35 (the wrist DoF aids convergence). When hardcoded mode is selected, set wrist flex maps the human flexion with [hardcoded] WRIST FLEX GAIN= 1, WRIST FLEX SIGN= 1.

Production stack alternative. WholeBodyIK tracks the palm SE(3) pose with weighted dampedleast-squares: ˙q = W⁻¹J

⊤(JW⁻¹J

⊤ +λ
2
I)

−1vdes plus a null-space posture pull to qrest, integrating lift + torso + 7 arm + wrist per side (8 DoF/side). It is faster per step but can be erratic near singularities; the cosine method trades a little speed for robustness.

## 6 Neck optimization

The research stack maps the operator’s relative head rotation (vs. calibration) into the 3-DoF neck: ∆R = A (RhR⊤
h,0

) A⊤ gives yaw/pitch/roll, each scaled by NECK GAIN= 1 and a per-axis sign ([hardcoded] yaw +, pitch −, roll + — the pitch sign was flipped after the head tilted the wrong way). The production NeckController instead solves an active-perception look-at-point: given a gaze target it computes the 3-DoF neck that points HEAD FORWARD LOCAL at the point (HoMMI-style), used in both teleop modes so the robot looks where the operator looks.

## 7 Whole-body control

Goal: coordinate the redundant body DoFs (torso, lift, base) that extend the operator’s reach, so the arms stay inside their comfortable workspace and the wrist never ends up behind the body.

Head-displacement bounding box (research stack). The base-engage criterion is an asymmetric, front-of-head box on the operator’s head displacement ∆ = A(phead − phead,0), decomposed into forward f = −∆x (robot front = −x) and lateral ℓ = ∆y. The part inside the box, fin = clip(f, −bback, bfwd), is absorbed by the torso (it bends ∝ fin, the fast first responder); only the overflow f − fin drives the base, with a position target ∝ w(f − fin) resolved by a P-controller to a body velocity. The box is [hardcoded] deep in front (bfwd = 0.18 m, so leaning/reaching forward uses torso+lift, not the wheels) and shallow behind (bback = 0.02 m, so backing up engages the base immediately); the per-direction weights (wback > wfwd) and the high gain Kp = 3.5 make backing up the most responsive. These are pure sensitivity gains, not separate objectives. The lift follows head height (speed-limited), and the operator’s body heading drives the base yaw.

Front-line clamp (design decision — “no twist to the back”). Even an eager base cannot out-run a fast operator, so we additionally hard-clamp the wrist/contact target to stay in front of the body’s vertical line: in the chassis frame, xcontact ≤ arm wrist front = −0.05 m. The arm therefore physically cannot be stretched/twisted behind the robot, regardless of base lag; the base then backs up to bring the operator’s intent forward of the line. Because the line rides with the chassis, the system is stable (the base moving back releases the clamp).

Production stack alternative. lazy base.LazyBase/LazyLift/LazyTorso are reactive boundingbox followers keyed to the hand targets (rather than the head), with their own LAZY * envelopes; same intent (keep the hands reachable), different signal.

Task-space | (wrist-method) | whole-body | reach | (2026-07). The | wrist | method’s
dragged/streamed palm targets now get the same reach cascade, via three additions (measured end-to-end in the Control Lab; full experiments and the defect chain in web gui/control lab/docs/control lab.tex §Wrist task-space reach):
- Sync-Lift units in WholeBodyIK. The lift is a tendon-cascaded stage pair (Sync Lift: Upper = Lower; ctrl = stage sum). The IK now keeps target q["Lift"] in joint units, doubles the lift Jacobian column, clips to the stage joint range, writes ctrl = 2×target, and moves both stage joints in every scratch-pose FK — dragging the targets up recruits the lift at the 60 mm/s hardware ceiling (0.442 m in 8 s, palm settling at 22.6 mm). Consumers mirror the target onto the wire as lift lower=lift upper=target.

- task space.BaseFollow — the base is the EAGER reach DoF. The base is not an IK DoF; this follower (new module in whole body controller/) is a hysteretic position+heading servo implementing the human-like priority (operator directive): the chassis drives to its HOMEpose offset from the target centroid (the working distance the arms were designed for, ∼80% of the measured 0.67 m usable reach — ∼2 cm of drag engages) and the heading squares the shoulders to the target PAIR axis pr−pl (wrapped ±90◦
): equal-lateral drags STRAFE (a centroid-bearing turn left the far palm 200 mm short), a rotated pair YAWS the robot with the operator’s body turn; the centroid bearing is only the degenerate-pair fallback and the comeabout override, min-distance-gated (the ungated bearing servo measured a −3.3 rad/s spin limit cycle on arrival). Both servos are snap-stop hysteretic (engage > ON, decisive minimum speed, ZERO below OFF — a plain P-law floats near its deadband), all errors are planar, the LAZY lift/torso (weights 50/30) are eased to rest while .active (“don’t lean into what you’re walking to”), a deliberate stick wins, and everything routes through safe base step. Edge-case sweep (12 cases: fwd/back/left/right/up/down/ squeeze/spread/diagonal/rotate, realtime): all settle 0.8–5.2 s, float ≤1 mm std, zero residual twist, pitch ≤0.5

◦
- Static-stability: rate caps + a CoM net. Chasing an out-of-reach target, the DLS slams the torso and the swing’s angular momentum tips the robot (MABEL’s home support margin is only 0.094 m; full both-arm forward reach is statically infeasible). MAX TORSO IK SPEED (= 0.5 rad/s) removes the slam — natural trajectories then bottom out at +0.014–0.031 m of live margin without falling — and WholeBodyIK.apply carries a last-ditch CoM guard below that band (COM GUARD MARGIN= 0.010 m): near the line it projects ˙q onto the margin-preserving tangent (CBF damper on the finite-differenced support margin). A uniform stop-scale ratchets into folded-arm attractors (0.6–0.9 m of lost reach), which is why the net does not shape normal operation.

The same audit fixed two latent lift-unit bugs on the hold path: TeleopEngine.hold current now adopts the measured lift extension (the tendon actuator is excluded from the joint-transmission hold list, so a Stiff re-entry used to replay a stale ctrl), and the facade’s measured ctrl no longer indexes jnt qposadr with the Lift’s tendon id (torque re-enable reseeded a stored lift target from the free joint’s x).

Torque engine — Hold (impedance) vs Soft (compliance), by region. WBCEngine (the same object the standalone scripts/compliance.py drives) runs the joint/wrist methods as a per-joint torque law τj = bj (q, q˙) + K (q

des
j − qj ) − D q˙j on the managed joints (their stiff position servos are neutralised on enter, so they are torque-driven and back-drivable). Hold = impedance (K > 0, the app’s stiffness slider): it springs to the set-point q

des, which the app supplies via joint targets. Soft = compliance (K ≡ 0): pure gravity/bias cancellation + viscous damping, so the arm floats and is dragged freely, and q

des
j ← qj is re-anchored to the live pose every tick — the operator drags the robot (in the Mac sim, the desktop viewer, or by hand on the real arm) and it holds where left, with a seamless hand-off to Hold (the set-point already equals the dragged pose). In Soft the engine takes no position target from the app on the managed arm/torso joints (only grips/lift/ fingers still track); the small residual sag is the gravity-comp model error, not a spring. Three regions parameterise how much of the body yields, exactly mirroring the app’s picker: arm (arms + wrists), upper body ( + torso + lift, both gravity-comp), and whole body ( + the mobile base glides under the net push: external base wrench reduces the arm-body wrenches to a planar (fx, fy, mz), BaseAdmittance integrates it, and §9’s tip-safe ramp drives the swerve). The operator push xfrc applied (app external force plus the desktop-viewer Ctrl+drag perturbation)

is composed once per substep, before the control law, so the whole-body base-wrench estimate sees the same forces mj step applies.

Reference smoothing (design decision — “track the wrist slower but surely”). In Hold, the impedance set-point q

des for the wrist method arrives over the wire as a multi-joint IK solution (the green-ball planner, a wrist drag, or a streamed Cartesian goal). Its null-space / redundancy resolution can flip between wire frames, so the raw q

des jumps at the 60 Hz command rate. Fed verbatim into the spring K(q

des
j − qj ) with the modest joint damping D = 0.6, every jump is a torque impulse and the arm buzzes — the operator’s report that “task-space wrist tracking is jittery, unlike the smooth joint slider” (the slider is smooth only because its q
| des moves slowly and
one joint at a time). We therefore filter the reference the spring tracks, at the single choke point in WBCEngine.step: a dt-correct first-order low-pass (time constant τref = 0.08 s) rejects the high-frequency IK wiggle, and a slew cap ( ˙qref ≤ 3.0 rad/s) turns a large jump into a deliberate ramp rather than an impulse. A smooth, slow command — the joint slider, or the client-eased green-ball Execute (joint-space smoothstep) — sits below both the corner and the cap, so it passes with only a few tens of ms of lag; the reference is seeded to the measured pose so the Soft→Hold hand-off stays bumpless. Constants are WBC REF TAU / WBC REF SLEW (env-overridable); the fix is server-side, so it lands for iOS, Vision Pro, and web at once. Quantified in §13.1.

Sticky control spec (design decision — “Soft must not snap back”). The bridge follows one active driver, but the spec (method/type/region) is now sticky: it changes only when the active client sends an explicit control mode, and otherwise persists. Previously, once an operator engaged Soft and then dragged the robot without sending app input, the driver claim expired after CMD HOLD S= 4 s (idle frames carry no claim) — or a brief WebSocket reconnect handed the client a fresh id with no spec — and the effective spec reverted to the navigation default, which exited the torque engine and snapped the arm back onto its position servos. Holding the last explicit spec keeps the robot gravity-compensated until a client deliberately changes mode (leaving the Body tab sends navigation), which is also the safe idle default for a home robot.

## 8 Mobile-base inverse kinematics (swerve)

swerve ik(vx, vy, ω,data) turns a body-frame twist into the three modules’ steering angles and wheel speeds, vmodule = vcom + ω × rmodule. Two practical refinements: shortest-path steering (never sweep a steering column > 90◦ — reverse the wheel instead), and an anti-slip cosine choke drive ×= cos(steer error) when the steering error exceeds [hardcoded] a 0.52 rad deadband, so wheels don’t scrub while reorienting. This is single-source in mabel.swerve and shared by both stacks.

## 9 Base motion model (tip-over safety)

Goal: hand a desired base velocity to the wheels without tipping the robot, especially with the lift raised.
The realized velocity is ramped toward the target through a dynamic envelope whose speed/accel caps shrink as the CoM rises. Braking at |a| tips the robot over the support edge it pushes against (lever d, CoM height h): mah ≤ mgd ⇒ atip = g d/h. Raising the lift raises h ≈ z0 + kz, so the safe accel and speed scale as ∼ 1/h. The binding direction is the front edge (MABEL’s triangular base has a single rear wheel and a slightly forward CoM), so forward braking is kept conservative (safety factor 2.0) while lateral/rear run near the tip limit (SF 1.2) for snappy reversals. For combined motion we enforce the full support-polygon (ZMP) criterion — the zero-moment point xzmp = xcom − (h/g)ac must stay inside the wheel-contact triangle, with ac including Coriolis/centripetal/ tangential terms. config.safe base step does one tip-safe ramp step; it is the single source shared by the teleop smoother and the stability tests. [hardcoded] the levers and CoM fit (re-derived 2026-06 after the 0.10 m lift-base drop, see the stability study: TIP LEVER FWD= 0.078, TIP LEVER BACK= 0.241, TIP LEVER LAT= 0.108, COM Z0= 0.369, COM DZDLIFT= 0.451) are measured from the chassis support polygon in the XML; if the chassis or payload changes they must be re-measured (experiments/wbc stability.py E4 flags drift; currently 0.2 cm XY bias, 1.5 cm height-fit error).

Validated envelope (measured). experiments/exp wbc validation.py (V1–V2) verifies the model: the per-axis speed/decel caps are monotone non-increasing in lift height (forward speed 0.80 → 0.47 m/s, forward decel 1.04 → 0.58 m/s² over the lift range); per-axis steps and reversals never exceed the per-axis accel caps and hold ZMP usage ≤ 1; a stop command from an over-limit twist at full lift converges in 0.74 s (no deadlock). One honest caveat the tests surfaced: usage is quadratic in the twist, so the path between two individually admissible combined twists (drive + spin) is not necessarily admissible — during a target switch the instantaneous usage can transiently exceed 1 (max 1.07 within the teleop-reachable command envelope |v| ≤ 0.8, |ω| ≤ 1.5; max 1.51 under an adversarial unrestricted sweep). The accel clamp’s contract u ≤ max(1, u0) held in all 450k random steps, and physically replaying the adversarial worst case on the floating-base model peaks at 4.2

◦

chassis tilt (the same commands raw fall at >80◦ ); the transient is bounded by the ≥ 1.2 safety factors and is a documented property, not a hazard.

Reverse guard (design decision, from an experiment). A simulation sweep found that at full lift the robot tips when reversing: accelerating backward throws the CoM over the short front lever, and the rigid ZMP model under-protected the compliant articulated robot. We added a reference-governor reverse guard that scales backward velocity to zero as the lift rises (frac = 1−z/zmax); forward/ lateral/turning pass through. With it, every reachable command stays upright across the full lift range (§13). It is a swappable base filter on the whole-body controller — the same hook intended for a future control-barrier/geofence.

## 10 Self-collision avoidance

Goal: a hand can never be driven into the torso, head, or the other arm.

Capsule guard (single source, mabel.self collision). The two forearms and hands (which move under the arm DoFs) and the torso + head (which they crash into) are wrapped in capsules; for a pair the surface gap is d(q) = ∥ca − cb∥ − ra − rb with ca, cb the closest points on the core segments (Ericson’s segment–segment test, so no dependence on a particular MuJoCo version). The discrete control-barrier constraint on the gap rate ˙d = n
⊤(Ja − Jb) ˙q is

− n

⊤(Ja − Jb) ˙q ≤ αc (d − ds) | for d < dinf, | (4)

i.e. the gap may shrink ever more slowly as it nears the safety distance ds. The guard offers three laws: a uniform velocity scale (“stop”), a tracking QP, and a torque barrier force. [hardcoded] the radii (SC RADII: forearm 0.035, hand 0.055, torso 0.09, head 0.12 m) and the monitored pair list.

Arm projector (research stack, design decision). The cosine arm IK can drive a hand into the body, so we keep the natural IK pose qdes and project it onto the safe set with a one-step velocity QP over both arms jointly:

min
q˙

1/2∥q˙ − q˙des∥

2
s.t. Gq˙ ≤ h, q˙lo ≤ q˙ ≤ q˙hi, | qsafe = qcur + ˙q ∆t, | (5)

with G, h assembled from (4) and ˙qdes = (qdes − qcur)/∆t at the frame interval (so αc [1/s] is dimensionally correct). The hand thus slides along the obstacle while tracking as closely as the barrier allows. It is ON by default everywhere as of 2026-07 (config.SELF COLLISION ENABLE=True seeds WholeBodyIK, WBCEngine and the TeleopEngine projector; the bridge exposes an explicit optout, --no-self-collision / MABEL SELF COLLISION=0, and the standalone teleop --no-collision) — previously the guard was opt-in and three of the four entry points started unguarded. A related bug was fixed at the same time: the engine gated the projector on “was ever built” instead of the enable flag, so set self collision(False) did not actually disable a once-enabled guard. When on, it is a strict no-op (targets pass through, no QP, no velocity clamp) until a monitored gap drops below the influence distance — so it never slows free motion. We use a slightly more conservative influence/gain (SELFCOL INFLUENCE= 0.10, SELFCOL ALPHA= 8) than the shared defaults so the margin holds under the snappier (low-smoothing) arm. Measured: a hand marched into the chest holds +4.1 cm (margin 2.5 cm) where the unguarded arm penetrated to −3.5 cm; the QP costs ≈ 0.4 ms.

Why the software guard is the only arm–arm defense (measured). The MJCF deliberately disables arm–arm contact pairs (the arm/hand collision geoms carry conaffinity=0, so two contype=1/conaffinity=0 geoms never generate a contact): with the guard off, crossing the arms passes the hands through each other with no contact force at all. Hand–torso pairs do contact physically, but only after the meshes touch — well inside the capsule margin. The end-to-end validation (exp wbc validation.py V3, §13) therefore treats the capsule guard as a hard requirement, and the default-ON change above is load-bearing for safety.

## 11 Safety: fail-safe engagement and clutch

Tracking-loss fail-safe (EngagementSupervisor). It watches the freshness of the stream, head, hands, and elbows and drives one rate-limited blend scalar α ∈ [0, 1] applied to the upper-body position actuators + the lift: ctrl = (1 − α) home + α live. On loss (headset off → stream stalls, or a limb drops out) α ramps to 0 over SAFE RETREAT TIME= 4 s, easing the upper body to a safe HOME pose (rest arms, [hardcoded] lift lowered to 0) and freezing the base; on re-acquire α ramps to 1 over SAFE ENGAGE TIME= 2.5 s with the live target being the operator’s current pose, and the world map (1) is re-anchored on the rising edge so there is no jump. [hardcoded] the timeouts (0.4 s stream, 0.5 s signal). A stop console command parks the robot at HOME the same way. Signal-adaptive gating: the elbow term is optional — the desktop ZMQ stream and (since 2026-07) the webcam web client carry elbows, and the headset wire path now derives them from ARKit’s forearm arm joint (the elbow end of the forearm), so all paths feed the arm cost’s Welbow term; the supervisor requires the elbow’s freshness only once an elbow has actually appeared. (The wire accepts explicit leftElbow/rightElbow transforms, which win over the derived ones; a present elbow is mapped through the same world map as the contact point — see the webcam retargeting doc, simulation control center/docs/retargeting.pdf §5.3.) Without this, a head+hands frontend could never satisfy the “complete frame” test and the robot would stay pinned at HOME. By the same logic the hands term is dropped in navigation mode (require hands, cleared by the facade when the active method is navigation): driving streams head + joystick only, so requiring hands would disengage the fail-safe and pin the lift at HOME (the base still drives, as the swerve actuators are not supervisor-managed) — the exact symptom of the right-stick lift going dead. Stream and head freshness still gate engagement, so a real link or headset drop still fail-safes while driving.

Clutch / re-indexing (ClutchController). A single-hand double pinch (either hand; hysteresis on each hand’s thumb–index gap, two clicks within CLUTCH DOUBLE WINDOW= 0.6 s, a cooldown so one gesture is one toggle) toggles a whole-body freeze: the robot holds its pose and the base stops while the operator recenters; another double-pinch releases and re-anchors so the robot eases from its held pose to the operator’s new pose. A single pinch is left free for grasping. [hardcoded] the pinch thresholds (0.03 on, 0.055 m off). Design history: this began as a two-handed sustained fist (too twitchy / collided with bimanual grasps), then a keyboard button, and settled on the either-hand double-pinch.

## 12 Deployment: the bridge integration

Every client — Apple Vision Pro, iOS, web — talks to one WebSocket bridge (server/sim teleop bridge.py) that owns transport only (client arbitration, cameras, recording, naming, security) and delegates all control to a single MabelTeleop instance. The apps are never modified to change the controller; the wire contract they already speak is sufficient.

Wire → pose. An app teleop frame carries a head transform and, per hand, an anchorTransform plus a list of named joint localTransforms (ARKit frame). mabel.wire turns this raw payload into an OperatorPose: a joint’s world transform is anchor· local; it builds the wrist/thumb-tip/index-tip list the retargeter reads, keeps the full named skeleton for the finger IK, and derives the thumb– index pinch gap that drives the clutch. The navigation stick is mapped to the controller frame by app joystick (the forward/strafe axes are negated; yaw/lift pass through), so the body-frame convention is a one-line library edit rather than a per-app change.

Message | → | method. Each | wire | message | maps | onto | one | facade | call:
control mode→set control spec (selects navigation / retarget / joint / wrist and, for the torque methods, (re)enters WBCEngine with the chosen type+region on the control thread); joint command→set joint targets (direct overrides applied after IK so an explicit slider wins); external force→apply external force (the world-frame wrench the compliance/whole-body engine admits); reset→reset; recalibrate→recalibrate. The bridge follows a single active driver so a second idle client can neither move the base nor change the mode.

One call per substep. The bridge owns physics: it accumulates real time and, per mj step, calls cmd = teleop.update(pose, joystick, dt). That one call runs the whole stack — clutch → (retarget + whole-body IK or the torque engine) → fail-safe → direct joint override — and returns a RobotCommand (ctrl, engaged, clutched, mode); on hardware the same call runs against a kinematic mirror and the RobotCommand is forwarded to the robot.

### 12.1 The direct joint-target route: measured semantics (2026-07)

The joint command route ( apply joint targets) became the execution backend of the studio’s choreography composer (simulation control center/docs/choreography.pdf), which exercised it far harder than sliders ever did. Its contract, established empirically against the live sim:

- Coverage. | Both | 7-DoF | arms, | both | ORCA | wrists, | individual | finger | joints

({side} {finger} {mcp,pip,dip,abd}), torso, the lift (lift lower+lift upper are summed into the single Lift actuator), and a per-hand scalar {side} grip∈ [0, 1] that maps through the grasp table. The neck has no route — it is owned exclusively by the head-tracking path, a real limitation for scripted expressive motion.

- Latched targets, partial commands. Targets are held after the sender goes silent (verified: a raised-arm pose held for 8+ s with zero re-sends and no reclaim by idle clients). Joints omitted from a joint command keep their previous targets — but a first command that names only one joint leaves every other joint on the controller’s own output, so scripted motion should always send full upper-body poses.
- Tracking. Steady-state error < 0.05 rad in the workspace interior, up to 0.15 rad at gravityloaded extremes (shoulder pitch commanded −1.20, read −1.05); held-pose gravity sag 0.07 rad to 0.14 rad (T-pose abduction 0.104, bow 0.135).
- Arbitration. A stick deflection > 0.04 or any joint command takes the strong (active-driver) claim; idle pose-streaming clients observe without reclaiming.
- Base interaction. With no nav stream, arm reaction forces walk the free swerve base (0.221 m during one wave emote); streaming navJoystick zeros alongside pins it to 0.002 m. Drive gains measured through this route: v = 0.80 ly m/s (forward/reverse symmetric), ω = 1.50 rx rad/s; open-loop turns under-rotate as angle grows (−1.6% at 90◦

, −11% at 180◦
, worse in clutter).
- Release must zero (2026-07). A headless driver (the web Control Center / a phone in basedriving streams a stick but no head pose) sets the base velocity target only from the stick. The unified apply stick path updated the target only while the stick was deflected, so on centering it latched the last non-zero twist and the base drove on non-stop — linear and yaw. Because a head-less frame has no head-follow term to overwrite the target, the centered-stick branch must now command (v, ω) = 0 explicitly (a head-tracked driver still keeps its head-follow base target, so immersive teleop is unchanged). Verified across forward/strafe/yaw: driven |v| = 0.80/0.80/1.50 → released |v|<0.02 (simulation control center/tests/test nav joystick.py). The lift is a rate jog, so it already stops the instant the stick releases.

## 13 Experiments

All numbers are regenerated headless by the harnesses tools/teleop benchmark.py (the live pipeline on a scripted operator) and tools/tune retargeting.py (the weight sweep), both under simulation/mabel mujoco/scripts/. Fig. 2 collects per-stage latency, the tip-safe base envelope, and the self-collision barrier.

- Speed. | Control/physics ≈ 500 Hz (0.6 ms/step, lidar sensors disabled). | Hand retarget
≈ 2.7 ms to 3.7 ms, arm IK ≈ 5 ms (8-DoF, cold-start), self-collision QP ≈ 0.4 ms. Both retargeters run twice per VR frame (≈ 120 Hz aggregate).

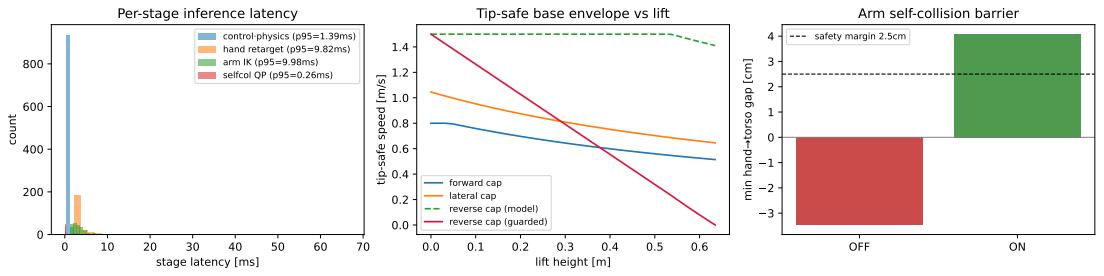
[picture p40: figure]
stage latency [ms]; count; Per-stage inference latency; control·physics (p95=1.39ms) hand retarget (p95=9.82ms) arm IK (p95=9.98ms) selfcol QP (p95=0.26ms); lift height [m]; tip-safe speed [m/s]; Tip-safe base envelope vs lift; forward cap lateral cap reverse cap (model) reverse cap (guarded); OFF; min hand torso gap [cm]; Arm self-collision barrier; safety margin 2.5cm

Figure 2: Left: per-stage inference latency. Middle: tip-safe base speed envelope vs. lift height (forward, lateral, model reverse cap, and the guarded reverse cap that goes to zero raised). Right: minimum hand→torso gap with the arm self-collision barrier OFF vs. ON against the safety margin.

- Arm-IK accuracy. On reachable targets (cold-start): 16 mm (p50)/ 65 mm (p95), improved from 30 mm p50 by the wrist DoF.
- ORCA wrist: hardcoded (oracle) vs jointly-optimized. contact 23→20 mm, orientation err 0.017→0.014, wrist-yaw twist 9.1→7.1

◦
, natural-elbow fraction 23→60%. Optimizing wins on every axis.
- Tip-over. Across the reachable command envelope and lifts {0, 0.32, 0.635} m, max chassis tilt < 4

◦
; the reverse guard takes backward speed 0.8→0 m/s as the lift rises — all upright, where the unguarded model tipped.
- Fail-safe / clutch. Eases to HOME on loss (4 s) and back on re-acquire (2.5 s), re-anchored, no jump; the clutch toggles exactly once per double-pinch and ignores single pinches.
- Weight sweep. The current arm weights sit at/near the optimum; the only robust change was lowering ARM MAXITER 45 → 35 (the wrist DoF aids convergence), and confirming Wsmooth=2 as the jitter/lag sweet spot.
- Direct joint route, live (2026-07). The choreography composer’s validation campaign (30 scripted actions, wire replays on the live sim) doubles as an end-to-end test of §12.1: every animation returned to neutral within 0.05 rad on all 14 arm joints, a 29.5 s five-action choreography executed cleanly, and a full 360◦
scripted pirouette closed within 2.4

◦
. Methods, calibration tables and figures: simulation control center/docs/choreography.pdf.

### 13.1 End-to-end validation harness (2026-07)

controller/experiments/exp wbc validation.py exercises the FULL deployed stack — the MabelTeleop facade (SLSQP hand + arm retargeting, whole-body cascade, fail-safe, clutch, self-collision projector, WBC torque engine) — offline against real physics (mabel home.xml, mj step), with a fixed seed and a patched deterministic clock. Synthetic OperatorPose streams at 100 Hz drive four stressor trajectories; every run is repeated with the self-collision guard ON (default) and OFF. Table 1 gives the measured numbers (tracking error = distance from the robot contact point to the commanded, front-clamped target while it moves, so it includes trajectory-following lag).

WBC torque engine (V4). Joint-impedance steps on Right Arm 4 (+0.4 rad, damping fixed at D=0.6): rise time 0.16/0.09/0.06 s and overshoot 24/38/45 % at K = 20/50/100 Nm/rad —

guard ON (default) | guard OFF
trajectory | err m/p95 [mm] gap [cm] err m [mm] gap [cm] limit viol. | drift
cross-body reach | 154 / 279 | +5.4 | 70 | +1.2 | 0 / 0 | ≤0.1 mm
overhead reach | 42 / 94 | +9.0 | 33 | +8.8 | 0 / 0 | ≤0.1 mm
cross-arm swap | 138 / 293 | +4.4 | 111 | −5.7 | 0 / 0 | ≤0.1 mm
chest poke (deliberate) | 205 / 388 | +2.5 | 58 | −2.5 | 0 / 307 | ≤0.1 mm

Table 1: Retargeting stressors at 100 Hz (V3). With the guard ON no capsule pair ever interpenetrates (min gap ≥ the 2.5 cm margin) and there are zero joint-limit violations; with it OFF the crossing arms pass through each other (−5.7 cm; the MJCF generates no arm–arm contacts) and the chest poke penetrates and jams 307 steps of joint-limit violation. The base holds still (<0.1 mm) when the operator’s head is still. The guard’s tracking cost is zero at rest (all pairs >11 cm > the 10 cm influence), bounded on a near-head pass (+9 mm mean on overhead), and large only when the command itself is unsafe (by design — the wall, not the operator, wins).

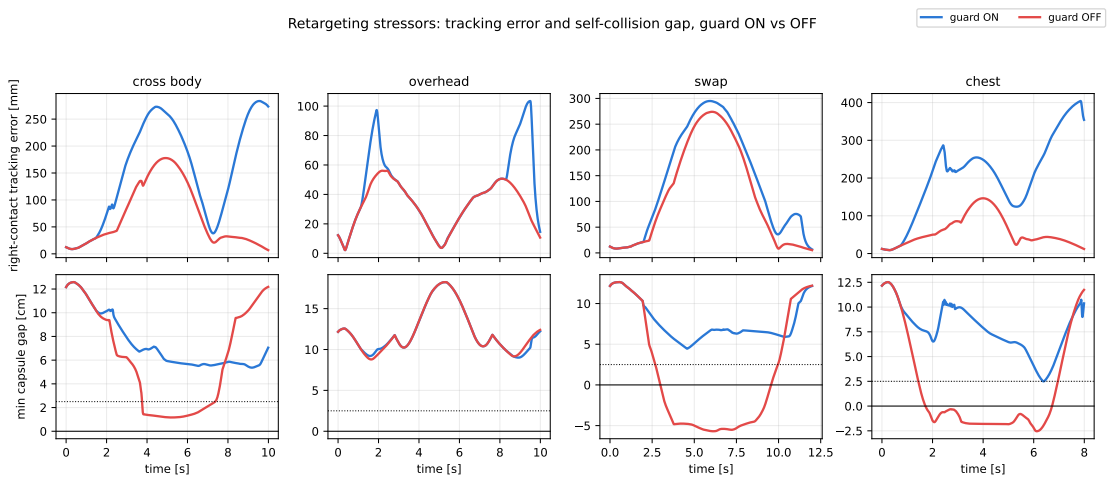
[picture p41: figure]
right-contact tracking error [mm]; cross body; overhead; swap; chest; time [s]; min capsule gap [cm]

Retargeting stressors: tracking error and self-collision gap, guard ON vs OFF | guard ON | guard OFF

Figure 3: V3 traces: right-contact tracking error (top) and minimum capsule gap (bottom) per stressor, guard ON (blue) vs OFF (red). Dotted line = the 2.5 cm safety margin.

the fixed D makes the response more underdamped as K grows (ζ ∝1/

√
K); steady-state error is
< 0.35◦
for every K because the bias feed-forward cancels gravity exactly in simulation. A 40 N push deflects the palm 30 cm and it returns to within 3.6 mm on release; in compliance (K=0) the same class of push yields 86 cm and holds where left (<0.1 mm post-release drift — the documented yield-and-hold design, not a spring-back). The base stays put in region=arm (<0.1 mm during the push). The torque-domain soft wall stops a 30 N drag into the torso at a +1.2 cm capsule gap where the unguarded drag penetrates to −7.9 cm.

### 13.2 Retargeting latency: where the operator’s lag actually lives

An operator reported (2026-07-28) that whole-body retargeting felt “way too slow . . . I need it to be fast and more real time.” “Slow” is at least two different defects with different fixes — the robot starting late (dead time) versus starting on time and crawling (a rate limit) — so the first job was separating them rather than turning a knob.
Two harnesses do it. server/tools/exp retarget latency.py measures the whole loop over

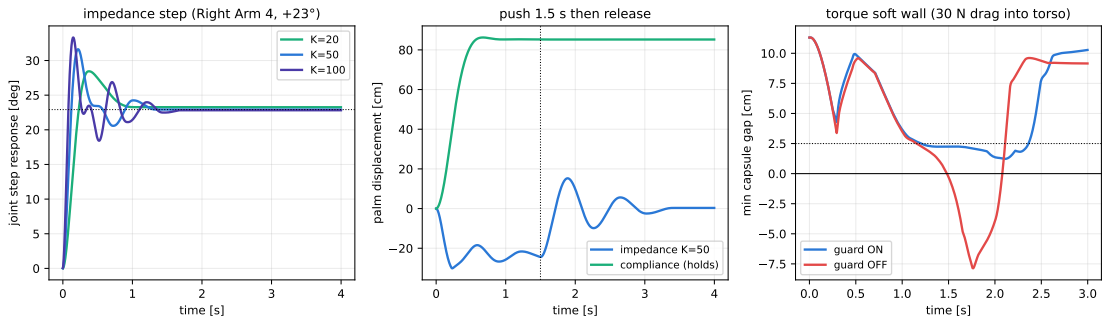
[picture p42: figure]
time [s]; joint step response [deg]; impedance step (Right Arm 4, +23°); palm displacement [cm]; push 1.5 s then release; impedance K=50; compliance (holds); min capsule gap [cm]; torque soft wall (30 N drag into torso); guard ON; guard OFF

Figure 4: V4: impedance step responses vs stiffness (left), impedance push-recovery vs compliance yield-and-hold (middle), and the torque-domain self-collision soft wall (right).

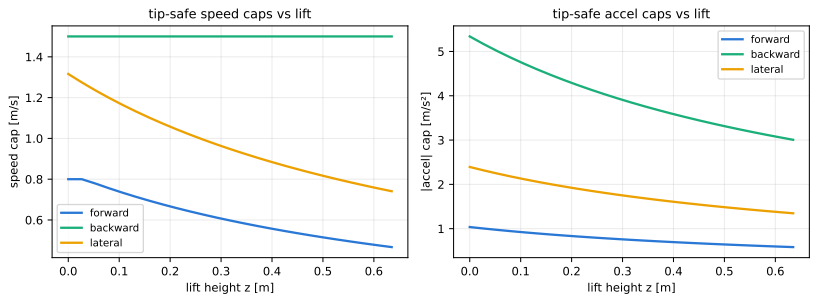
[picture p43: figure]
lift height z [m]; speed cap [m/s]; tip-safe speed caps vs lift; forward backward lateral; |accel| cap [m/s²]; tip-safe accel caps vs lift; forward backward; lateral

Figure 5: V1: tip-safe speed and acceleration caps vs lift height — monotone non-increasing per axis (forward binds; lateral/rear run nearer the tip limit for agility).

the live wire: it streams a scripted operator hand at the app’s 30 Hz, forward-kinematics the joint angles that come back, and reports the step response to a 25 cm hand jump plus the crosscorrelation delay under a continuous 0.4 Hz sweep — the second being what teleoperation actually is. controller/experiments/exp retarget latency.py then runs the same operator against the engine in-process with two different plants: an ideal one where every joint lands on its command instantly, and the real mj step physics. The difference between the two is the servo’s contribution, and it is not measurable from the wire alone.
The decomposition was unambiguous. Against the ideal plant the engine’s following lag is 0 ms: the arm IK is a per-frame solve with no integrator, and neither ARM W SMOOTH nor the trust region binds at conversational hand speeds. Against real physics the same engine lagged 170 ms. The lag was the arm servo, not the retargeter.
The servo gains were then found to be inconsistent within the repository: models/mabel full.xml ran the arm joints at kp = 100, kv = 20, while models/right arm.xml has always run the same joints with the same force limits at kp = 500, kv = 45. Adopting the latter in the full model (with kv ∝

p
kp, which holds the damping ratio — raising kp alone rings) cut the servo’s contribution from 170 ms to 55 ms with no actuator-force saturation and only a mild rise in high-frequency content (a normalised ringing index of 0.93 to 1.21). A 9× cell reached 30 ms but at 1.77, and was not taken. Force ranges are the hardware limit and are unchanged.
That fixed continuous tracking but left the 25 cm step at 455 ms to 63 % of travel, with the arm’s peak joint speed measured at 2.62 rad s⁻¹ — exactly ARM TRUST STEP × f for the app’s f = 30 Hz. The trust region was defined per solve, and its own comment justified the value as “0.10 rad @

60 Hz frames = a 6 rad s⁻¹ per-joint slew — far above human teleop speed.” The Vision Pro app later dropped to 30 Hz to kill a SwiftUI invalidation storm, and the slew silently halved to 3 rad s⁻¹ ,
which is not above human teleop speed. Redefining it as a rate (ARM TRUST RATE, 6 rad s⁻¹
, times
the measured frame interval, capped by ARM TRUST MAX) restores the guarantee the constant always claimed, at whatever rate a client happens to stream.
| before | after | budget
step dead time [ms] | 138 | 79 | 120
step t63 [ms] | 467 | 264 | 350
step t90 [ms] | 761 | 449 | —
following lag [ms] | 245 | 140 | 180
sweep amplitude retained | 0.95 | 1.00 | 0.55
Table 2: | Whole-body retargeting latency, measured over ws://...:9090/teleop against
server/run.sh, before and after the arm-servo gains and the rate-defined trust region. Five of five checks pass after; two of five before.

A note on what did not change: the arm-fidelity battery (server/tools/exp arm fidelity.py, 9/9) and the tracking-channel battery (exp tracking channels.py, 16/16) both still pass, and every arm joint that can hold its parked target got tighter with the stiffer servo (±11◦
to ∼3

◦
). Two
joints cannot hold it at either gain: the wrist roll (±7 N m) sits saturated at exactly 7.00 N m, 45.8
- out at the old gains and 57.1
- at the new, because it must roll the 1.74 kg ORCA hand back against gravity; the elbow (±27 N m) saturates from some parking poses for the same reason. Both were verified in-process with the engine’s gravity feed-forward running, and both predate the gain change — they are the same fact the OpenArm bring-up recorded, that this arm cannot hold itself on PD alone. The channel-park check therefore asserts on the joints that can reach their target and reports these two with their saturation, since asserting a target the actuator cannot hold tests nothing.

## 14 The configuration registry: control param.json

Every tunable in the honesty list below (§15) is now catalogued in one human-editable file,

controller/control param.json, read through controller/mabel/control params.py. The file began (2026-07) as the single source of the arm PD gains and gravity feed-forward — the numbers the setup studio’s armctl, the real-robot arm law (arm control/gravity.py), and mabel hw’s per-joint command defaults all read, so they can never silently disagree. It was then expanded (2026-07-17) into the master registry for the whole control stack: the pure-PD position controller, WBC gravity compensation, the self-collision control barrier, the admittance base, the compliance workspace box, the whole-body IK, the base/tip-over motion model, the neck, the hands, and the lift/torso/body.

Gains and system identity live together. The arm block carries not only the per-joint kp/kd/vmax and the gravity-FF envelope (enabled, clamp, scale, ramp s, pose pad, hand-mass choice) but also the joint system identity — the firmware joint IDs (l j1. . . r j7), their MJCF joint-name map, the backend/link, the calibration slice, and the per-side torque/position/velocity ceilings. The calibration dir and raw window are deliberately not copied here: they are measured by the setup studio and owned by the CalibrationStore (the calib slice), so this file stays the naming-and-limit registry without becoming a second, drifting copy of the calibration.

Block | Authoritative source today | Status
arm.gains / gravity feedforward | control param.json | LIVE
arm.impedance / rate limit | arm control/{impedance,rate limit}.py | MIRROR
position control | position controller/pd.py (servo-inherited) | MIRROR
gravity compensation | gravity compensation/gravity comp.py | MIRROR
collision avoidance | config.py (SC *) | MIRROR
admittance | config.py (ADMIT *) + wrench estimation.py | MIRROR
compliance | config.py (DRAG *, LAZY *) | MIRROR
whole body ik | config.py (IK *) | MIRROR
base / tip over | motion model/tip over.py, config.py | MIRROR
neck | config.py (NECK *) | MIRROR
hands | hand retargeting/*, config.py | MIRROR
lift / torso | config.py (LAZY *), tip over.py | MIRROR
*.hardware, body | mabel hw/config.py | PLACEHOLDER

Table 3: The control param.json registry: each block, where its numbers are authoritative today, and whether the JSON copy is live-wired, a documentation mirror, or a not-yet-configured placeholder.

Three | honesty | tags. Because | most | subsystems | still | read | their | numbers | from
controller/mabel/config.py (and the base/tip-over constants from motion model/tip over.py), each block carries a source tag so the file never lies about what is wired:
- LIVE — read by running code today; editing the number changes robot behaviour with no code change. Currently the arm block (gains + gravity FF + rate limit).
- MIRROR — a documentation copy of a value that is authoritative in config.py / tip over.py. Editing here does not yet change behaviour; the authoritative field names the real source. Kept so this file is the one place to read every tunable. Migrating each MIRROR block to LIVE (having config.py load it from the JSON, exactly as the arm gains already do) is the tracked next step.
- PLACEHOLDER — the subsystem is not yet fully brought up on the real robot (hands’ realized servo gains, the DaMiao body/neck/torso bus, the lift Pico); the numbers are conservative starting points or hardware defaults.

Table 3 maps each block to its authoritative source and status.

## 15 Every hardcoded part, in one place (honesty section)

Every constant below is now catalogued in control param.json (§14); the values here and there are kept in sync.

- Frame map A = avp to robot (fixed permutation); wrist-align identity.
- Reach scale default 1.2 (auto-calibrated, clipped [0.5, 3.0]).
- Hand per-finger SCALES (1.0); weights 20/150/0.5/0.02; finger/ joint/body name maps; fingertip pad offset 22 mm.
- Arm Wwrist/elbow/orient/smooth = 600/30/20/2; ARM REG W = [0.08, 0.08, 0.40, 0.08, 0.02, 0.08, 0.60]; wrist reg 0.03; HAND REACH= 0.14 m; Arm7 yaw clamp ±0.45 rad; ARM MAXITER= 35; j7 lock val (rest); wrist-flex gain/sign 1/1.

- Neck gain 1, per-axis signs (+, −, +), local forward/up axes.
- Whole-body box bfwd/back/lat | = 0.18/0.02/0.12 m; weights wfwd/back/lat | = 1.0/1.3/1.0;
Kp = 3.5, Kp,yaw = 2, vmax = 0.8, ωmax = 1.5; torso gain 2.5; lift rate 0.25; front-line clamp

arm wrist front = −0.05 m.

- Swerve steering-error deadband 0.52 rad; module geometry from the XML.
- Motion model tip levers, CoM fit, safety factors, stop times, speed floors/ceilings — measured from the chassis support polygon; re-measure on any mass/geometry change.
- Self-collision capsule radii, monitored pairs, influence/margin/α (0.10/0.025/8); QP velocity cap 4 rad/s.
- Safety timeouts 0.4/0.5 s; retreat/engage 4/2.5 s; HOME lift 0; clutch pinch 0.03/0.055 m, double-window 0.6 s, cooldown 0.8 s.

## 16 Limitations

(1) Two implementations (§1) still coexist; the consolidation onto mabel is in progress and the cosine vs. DLS arm-IK choice is not yet unified. (2) Walk/reach composition: (1) scales the operator’s global walk by s while the base follows 1:1, so during locomotion the arm target outruns the base by (s − 1)× walk plus the box (≈ 200 mm); the front-line clamp masks the worst case but a cleaner fix scales only the hand-relative component. (3) Reverse at full lift is handled by a guard, not a fundamentally more stable base. (4) The tip-over constants are geometry-specific and must be re-measured if the chassis/payload changes; the envelope also ignores the measured payload / external wrench (the estimator in force estimation.py exists but is not fed into tip usage — a shrink-only coupling is the recommended next step, cf. ZMP disturbance observers). (5) No force/haptic feedback — the loops close vision and motion, not touch. (6) The self-collision projector slows both arms uniformly through the QP coupling and guards only distal links vs. torso/head/opposite arm; since the MJCF generates no arm–arm contacts, it is the sole defense for that pair (§10). (7) The torque engine’s joint damping is a fixed D=0.6, so impedance overshoot grows with the stiffness slider (24 → 45 % for K 20 → 100, §13.1); a critical-damping schedule D ∝

√
K would be the minimal fix. (8) Under combined-twist target switches the instantaneous ZMP usage can transiently exceed 1 (bounded by the ≥1.2 safety factors; physically verified upright, §9).

## References

[1] C. Ericson, Real-Time Collision Detection, Morgan Kaufmann, 2004.
[2] E. Papadopoulos, D. Rey, “A new measure of tipover stability margin for mobile manipulators,” IEEE ICRA, 1996.
[3] O. Khatib, “A unified approach for motion and force control,” IEEE J. Robotics and Automation, 1987.
[4] A. D. Ames et al., “Control barrier functions: theory and applications,” ECC, 2019.
[5] S. Buss, “Introduction to inverse kinematics with Jacobian transpose, pseudoinverse and damped least squares methods,” 2004.
