Klajdi00/open_mabel/controller/docs/motion_model.pdf

## The MABEL Tip-Over Safety Motion Model:

Lift-Aware Speed/Deceleration Envelopes and the Coupled ZMP Limiter
(mabel.motion model)

MABEL Project — Control & Teleoperation

November 2, 2026

Abstract

Every base velocity command in the MABEL stack — joystick, iOS/VisionPro nav sticks, web GUI, ROS navigation, or the admittance glide — must pass through one function, safe base step, before it reaches the swerve inverse kinematics. This document derives that function: the per-direction tip-over acceleration/speed caps and their 1/h dependence on the lift height, the coupled zero-moment-point (ZMP) criterion for combined translation + rotation, the degree-2 homogeneity argument that gives a closed-form projection of a steady twist into the safe envelope, and the transient acceleration clamp. We report the measured constants (CoM levers, the linear CoM-height fit and its ≤ 1.5 cm error), the validation evidence (a 450 000-step random sweep with zero contract violations; physical MuJoCo manoeuvres at 5.7

- peak tilt
where the unprotected base falls at 69◦+), and one honestly-documented limitation: a liveness boundary for artificially injected far-over-limit states. The module is NumPy-only by design so
the ROS navigation node imports it on the robot without MuJoCo.

Keywords: tip-over stability, zero-moment point, mobile manipulation, motion model, teleoperation safety.

## 1 Overview and design position

MABEL is a 62 kg mobile manipulator on a three-wheel (triangular) swerve base with a 0.635 m cascaded lift. Raising the lift raises the centre of mass (CoM), so the base’s safe acceleration — and therefore safe speed — shrinks with lift height. The companion study wbc stability.pdf shows that for MABEL’s mass distribution the dominant and essentially only tip risk is dynamic base acceleration (static CoM shift needs a ∼14–18 kg hand payload to matter), which makes this motion model the robot’s primary anti-tip-over defense.
The subpackage has three modules:
- tip over.py | — the safety envelope and safe base step | (this document’s subject).
NumPy-only; the constants are measured from the canonical MJCF and re-derived by experiments/wbc stability.py (E4). mabel.config re-exports everything, so from mabel.config import safe base step works everywhere.
- com support.py — live measurement of the true CoM, the wheel-contact support polygon and the support margin from a running MuJoCo model; used to verify and re-fit the constants baked into tip over.py.
- base response.py — the system-identified forward model of the base (§5), used by ROS command-odometry.

The rule: never call whole body controller.base controller.swerve ik on a raw twist. Always route it through safe base step first.

## 2 Per-direction tip condition

Model the robot as a rigid body of mass m with CoM at height h braking (or accelerating) at |a| on a flat floor. In the decelerating frame the inertial force ma acts at the CoM; the robot begins to tip about a support edge at horizontal lever distance d (CoM ground-projection to that edge) when the overturning moment exceeds the restoring moment:

m a h ≤ m g d | =⇒ | atip(h) = g d
h
, | (1)

mass cancels. The safe cap divides by a per-direction safety factor S:

a

(k)

max(z) = g dk
Sk h(z)
, | k ∈ {fwd, back, lat}. | (2)

MABEL’s triangular base (single rear wheel) with a slightly forward CoM makes the front edge binding: the measured levers are dfwd = 0.078 m, dlat = 0.108 m, dback = 0.241 m (re-measured 2026-06 after the lift-base drop). Forward braking keeps a conservative Sfwd = 2.0; lateral/rearward run agile at S = 1.2 (more margin and less dangerous).

CoM height vs. lift. The lift raises the CoM approximately linearly. The fit, re-measured from settled MuJoCo states,

h(z) = z0 + k z, | z0 = 0.369 m, k = 0.451, | (3)

has a maximum error of 1.5 cm over the full travel (E4 of wbc stability.py); the worst case under -estimates h at z = 0, over-estimating amax by <4% — comfortably inside the 1.2–2.0 safety factors.

Speed caps. A speed cap is the speed a full stop from which takes a nominal stop time: v

(k)
max =
a

(k)
max · Tk with Tfwd = 0.80 s (long, gentle) and Tagile = 0.55 s (snappy reversals), clamped to

[ vfloor, v

(k)
ceil ] so the robot can always at least crawl (0.15 m/s) fully raised. Fig. 1 plots Eq. (2) and the resulting caps: forward speed falls from 0.80 m/s at z = 0 to 0.47 m/s fully raised (decel 1.04→0.58 m/s

2
).

## 3 Coupled motion: the ZMP criterion

The per-axis caps are the pure-axis special case. Under combined translation + rotation the CoM picks up Coriolis, centripetal and tangential accelerations, so a turn while driving can tip the robot at “safe” per-axis speeds. In the body frame, with CoM ground offset rc = (rx, ry) (measured: (−0.076, −0.001) m), body twist ξ = (vx, vy, ω) and its rate (ax, ay, ω˙), the horizontal CoM acceleration is

ac =

ax − ωvy − ω r ˙ y − ω

2
rx
ay + ωvx + ˙ω rx − ω

2
ry

!
, | (4)

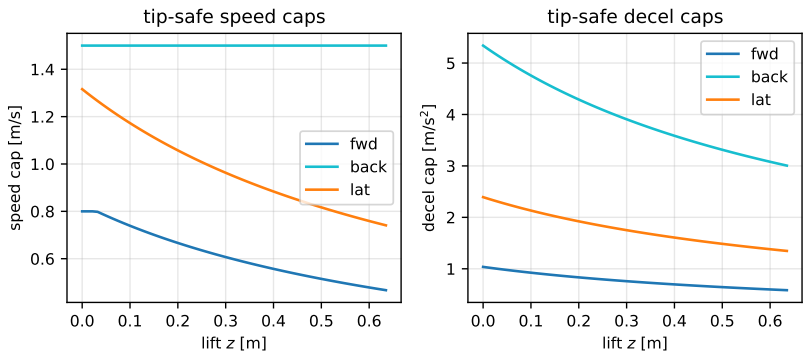
[picture p44: figure]
0.0 0.1 0.2 0.3 0.4 0.5 0.6 lift z [m]; speed cap [m/s]; tip-safe speed caps; fwd back; lat; decel cap [m/s; tip-safe decel caps; fwd back lat

Figure 1: Tip-safe speed (left) and deceleration (right) caps vs. lift height, per direction (Eq. (2); generated by experiments/doc module figures.py).

(transport/Coriolis + tangential + centripetal). The zero-moment point xzmp = xcom − (h/g) ac must stay inside the wheel-contact triangle [1, 2]. Equivalently, for each support edge k with outward unit normal ok and CoM-to-edge lever dk,

(−ok) · ac ≤

g dk
Sk h(z)
. | (5)

We define the usage

u(ξ, ˙ξ, z) = max

k

(−ok) · ac
+
g dk/(Sk h(z)), | (6)

so u ≤ 1 is tip-safe. Fig. 2 maps the steady usage over (vx, ω): the safe region visibly shrinks as

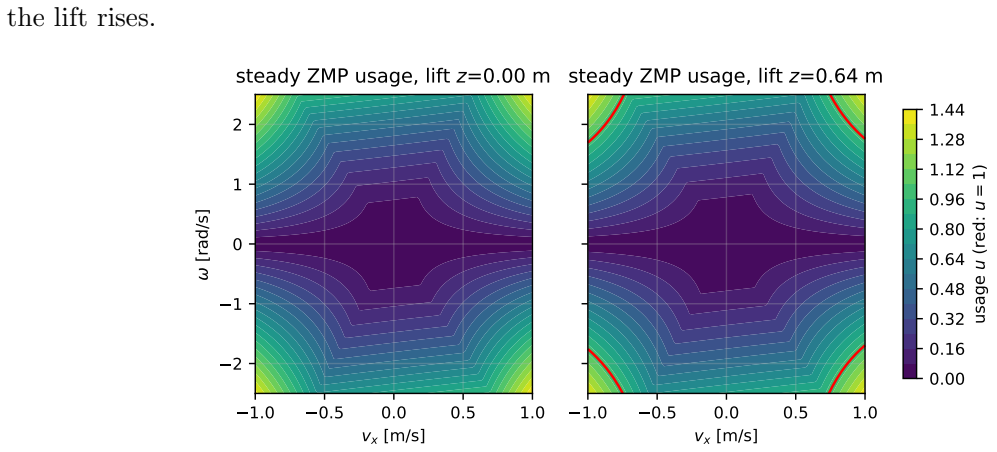
[picture p45: figure]
the lift rises.; [rad/s]; steady ZMP usage, lift z=0.00 m; steady ZMP usage, lift z=0.64 m; usage; u (red: u

Figure 2: Steady ZMP usage (Eq. (6) at zero command acceleration) over forward speed and yaw rate, at z = 0 (left) and full lift (right). Red contour: u = 1.

### 3.1 Closed-form steady projection (homogeneity)

At zero command acceleration the steady CoM acceleration ac = (−ωvy − ω

2
rx, ωvx − ω

2
ry) is
degree-2 homogeneous in the twist: ac(s ξ) = s

2ac(ξ). Usage (Eq. (6)) is positively linear in ac,

hence
u(s ξ) = s
2 u(ξ) | =⇒ | s

⋆ = min
1, u(ξ)

−1/2
(7)

projects any steady twist into the envelope in closed form (tip speed scale). Two properties matter for safety: u(0) = 0 ⇒ s

⋆ = 1, so a stop command is never throttled; and an over-limit target is scaled back in rather than rejected, so the commanded set-point always lies inside the envelope. This replaced an earlier blend that dead-locked (held velocity) when the current twist already violated the constraint. The property u(sξ) = s

2u(ξ) is verified to 10⁻⁹
relative accuracy
over 200 random twists in tests/test motion model.py.

### 3.2 Transient clamp

The per-axis ramp toward the projected target can still create an unsafe transient ac (accelerating while turning). accel safe scale scales the command acceleration (ax, ay, ω˙) by αℓ ∈ [0, 1] such that
u
ξ, αℓ

˙ξ, z
≤ max
1, u0
, | u0 = u(ξ, 0, z), | (8)

found by 12 bisection iterations. The cap max(1, u0) makes αℓ = 0 always feasible and passes any usage-reducing (braking) command through unscaled.

### 3.3 The full step

safe base step(ξ, ξtgt, ∆t, z) chains: (1) clip ξtgt to the per-axis speed caps (Eq. (2)·Tk); (2) project it into the steady envelope (Eq. (7)); (3) ramp each axis toward it at its direction-appropriate acceleration cap; (4) clamp the resulting transient with Eq. (8). The same function runs in the teleop smoother, the navigation stack, the admittance base and the validation harness, so all exercise identical logic.

## 4 Live CoM / support measurement (com support.py)

The constants above are baked; com support.py measures the truth at runtime from a MuJoCo state: the robot subtree CoM (robot com), the support polygon from the actual wheel–floor contacts (support polygon), the signed support margin (distance of the CoM projection to the nearest edge, negative outside), an angular tip margin, and live tip usage (Eq. (6) with the live CoM and polygon instead of the constants). E4 of wbc stability.py compares fixed vs. live: XY bias 0.2 cm at home, height-fit error ≤ 1.5 cm — if a model change pushes these past ∼ 1 cm XY, re-paste the printed constants into tip over.py.

## 5 Calibrated base response (base response.py)

System identification (experiments/motion id.py, full robot on a bare floor through the package’s own swerve IK) found the base’s command response is strikingly clean inside the envelope:

ξactual = G · clamp

ξcmd, envelope
, | G = 0.989, | (9)

one uniform 1.1% slip gain on all three axes, fully decoupled (cross-terms <0.5%), linear with no deadband down to 0.05 m/s. Command changes ramp with a first-order time constant τ = 0.13 s (the steer-and-choke transient, § swerve in whole body controller.pdf); the stateful BaseMotionModel includes it, the stateless predict twist/integrate assume held commands. As a process model it dead-reckons to ∼1% in free space and, because it integrates the command, it is immune to wheel spin — disagreement against wheel encoders (encoders ≫ model) is a slip/stuck detector.

## 6 Experiments

Numbers | from | experiments/doc module figures.py | (figures | here),
experiments/exp wbc validation.py | (V1, | V2) and experiments/wbc stability.py | (E1–E4);
all reproducible from scratch.
claim | | test | | result
per-axis caps monotone in lift | V1 (analytic sweep) | pass (fwd 0.80 → 0.47 m/s)
accel-clamp contract u ≤ max(1, u0) | V1, 450k random steps | 0 violations
teleop envelope |v| ≤ 0.8, |ω| ≤ 1.5 | V1 sweep | max u = 1.069
stop from over-limit (0.5, 0.8, 1.8) @ full lift | V1 liveness | stopped in 0.74 s
combined manoeuvre, physical MuJoCo @ z=0.30 | V2 | tilt 5.7
| | | ◦ (raw: 69.3

◦
| | | | , falls)
combined manoeuvre @ full lift | V2 | tilt 3.2

◦

| | | | (raw: 80.1 ◦
)
worst adversarial transient replay | V2 | tilt 4.2
| | | | ◦
fixed-CoM XY bias / height-fit error | E4 | 0.2 cm / 1.5 cm
homogeneity u(sξ) = s
| 2u(ξ) | pytest, 200 random | | 10⁻⁹ rel.
stop never throttled; braking passes unscaled | pytest | pass

## 7 Per-module actuator model (swerve modules.py)

base response is a body-level filter fitted to the MJCF; it has no wheels and so cannot say whether a motor is inside its limits, nor how non-holonomic the base is while a module resteers. SwerveModules realises a commanded twist module by module: rigid-body module velocities, whole-twist desaturation to a safe wheel speed, a rate-limited first-order steer (shortest path, flip past 90◦
), the controller’s own drive choke (0 past 0.52 rad of steer error, cos e inside it), a torque-derived wheel-acceleration cap, and a least-squares forward kinematics whose residual is scrub. Limits: drive 1.2 m/s safe (80 % of the measured SPARK loop collapse at 1.5 m/s; free speed 4.81 m/s), 5.5 N m (50 % of the MJCF’s 11 N m) ⇒ 7.0 m/s

2
; steer at full speed, which on the hardware is current-limited to a 90◦
turn in ∼170 ms (Ωs = 10 rad/s, τs = 20 ms; measured on NOVA’s identical MAXSwerve modules). Profiles: mabel, mabel mjcf (the faster MJCF steer servo), nova (NOVA’s driver). Derivation, sources and the measurements on a live Vision Pro take are in web gui/retarget lab/docs/retarget lab.pdf (§Swerve modules, E5d); tests in tests/test swerve modules.py. It is used by the Retarget Lab and, through it, by NOVA’s gateway; the robot’s own command path is unchanged (safe base step → swerve ik).

## 8 Implementation & usage

- NumPy-only import (asserted by tests/test imports compat.py): from mabel.config import

safe base step costs no MuJoCo — this is what mabel ws/src/mabel navigation does on the Jetson.

- Per-tick pattern (every consumer):

vx, vy, w = safe base step(vx, vy, w, tvx, tvy, tw, dt, lift z) swerve ik(vx, vy, w, data)

- Constants live in mabel/motion model/tip over.py; re-derive after any MJCF mass/geometry

change with wbc stability.py (E4).

## 9 Limitations

- Liveness boundary for injected states. For a state far outside the envelope (e.g. (1.2, 1.0, 2.0) at full lift, u0 ≫ 1), every braking direction transiently raises the worst-edge usage, so Eq. (8) freezes the state instead of decelerating (tests/test motion model.py documents this as a strict xfail). Such states are unreachable through safe base step itself, but a lift rising under a fast twist shrinks the envelope toward this region. Candidate fix: a small (∼2%) transient usage tolerance for strictly-decelerating commands; requires re-running V1/V2 before adoption.
- The CoM-height fit is linear (max error 1.5 cm); the constants go stale silently when the MJCF changes (mitigated by the E4 re-sync rule).
- Flat, level floor and rigid wheels are assumed; no payload term (a ∼14–18 kg hand payload shifts the static envelope, see wbc stability.pdf).
- The friction limit (wheel slip before tip) is not modelled; on MABEL’s rubber wheels the tip constraint binds first in every measured case.

## References

[1] M. Vukobratovi´c and B. Borovac, “Zero-moment point — thirty five years of its life,” Int. J. Humanoid Robotics, 1(1), 2004.
[2] E. G. Papadopoulos and D. A. Rey, “A new measure of tipover stability margin for mobile manipulators,” Proc. IEEE ICRA, 1996.
[3] Y. Cheng et al., “HoMMI: Learning whole-body mobile manipulation from human demonstrations” (CoM-over-support cost comparison in wbc stability.pdf).
