Klajdi00/open_mabel/controller/docs/whole_body_controller.pdf

## The MABEL Whole-Body Controller Suite:

Differential IK, Day-1 PD, Gravity Compensation, Self-Collision Avoidance, Admittance, Compliance, and the Swerve Base Controller
(mabel.whole body controller)

MABEL Project — Control & Teleoperation

July 24, 2026

Abstract

This document specifies every control law on the output side of the MABEL stack — the layer that turns desired motion (retargeted poses, app joint targets, or an operator’s physical push) into safe per-actuator commands. Each law lives in its own subpackage and composes through a runtime engine: bimanual damped-least-squares differential IK with null-space posture; a plain PD position controller that runs on Day-1 hardware with no system identification (with a measured discrete-stability argument for why its gains must be per-joint); region-selectable gravity compensation; a capsule-based self-collision guard (velocity-damper “stop” law, CBF tracking-QP, and a torque-domain soft wall); admittance control of the mobile base driven by estimated external wrenches; region-selectable compliance (“dance with the robot”); and the delta-swerve base controller with shortest-path steering and an anti-slip cosine choke. Measured highlights: the Day-1 PD droops 0.242 rad under gravity and 0.000 rad with the gravity feedforward hook; the admittance tracks its analytic steady state vss = F/bl exactly and coasts to rest in 0.76 s; whole-body compliance glides the base under a 30 N palm pull while never leaving the tip-safe envelope. A dedicated section states and measures the mode-invariance of gravity compensation — selecting a control space must change the reference generator and nothing else — after a defect in which leaving Drive silently dropped the feedforward on 8 of 22 upper-body DoFs
and walked the operator’s palm 26.5 mm down over five space changes, now 0.7 mm.

Keywords: whole-body control, differential inverse kinematics, impedance control, admittance control, control barrier functions, self-collision avoidance, swerve drive.

## 1 Architecture

subpackage | law | domain
ik | weighted-DLS bimanual SE(3) IK + null-space posture | velocity/position
position controller | per-joint PD (+ optional feedforward hook) | torque
gravity compensation | τ = b(q, q˙) − Dq˙ per region | torque
collision avoidance | capsule CBF / velocity damper / soft wall | both
admittance | wrench estimation + virtual planar mass-damper base | force→velocity
compliance | gravity-comp’d back-drivable region | torque
base controller | swerve IK (steer + wheel speed) | velocity
engine | WBCEngine: (impedance | compliance) × region runtime | orchestration

Two hard safety rules bind every consumer: (1) base twists reach swerve ik only through motion model.safe base step (the tip-over gate, motion model.pdf); (2) the self-collision guard is ON by default and is the only arm–arm defense — the MJCF disables arm–arm contact pairs, so disabling the guard removes the physics backstop too. All torque controllers talk to the robot through the Plant seam (mabel/plant.py), so the identical code drives the MuJoCo twin and the real actuators. Dynamics quantities come from mabel.dynamic models (equations derived in dynamic models.pdf; not repeated here).

## 2 Differential IK (ik.py)

Both palm targets stack into a 12-dimensional task velocity v = (vL, ωL, vR, ωR), built per palm from the pose error with proportional gains, deadbands (2 mm / 0.5

◦
, so the arm never chases
gravity sag at rest) and speed caps (1.5 m/s, 3 rad/s). With the stacked 12 × n Jacobian J and a diagonal weight W (Wlift = 50, Wtorso = 2, arms 1 — higher = lazier joint), the weighted damped-least-squares step is

q˙

⋆ = W⁻¹J

⊤

JW⁻¹J

⊤ + λ
2
I

−1
v +
I − J

+J

k

post
p
(qrest − q), | (1)

i.e. tracking in the weighted least-squares sense (minq˙ ∥Jq˙ − v∥

2 + λ

2∥q˙∥

2
W , λ = 0.05) with a null-space pull toward the rest posture. An arms-only mode drops the lift/torso columns so manipulation never disturbs the body height. The result is post-processed by the self-collision guard (§5): the default “stop” law scales ˙q

⋆ uniformly, the legacy “cbf” law re-solves the QP of Eq. (5). Per-DOF velocity boxes and joint-limit dampers bound the integration, and apply() integrates q

cmd += ˙q ∆t
into the position actuators.

## 3 Day-1 PD position control (position controller/)

Before system identification exists, the only safe torque law is model-free:

τj = kp,j (q

des
j | − qj ) − kd,j q˙j + | τ

ff
| | j
|{z}
| | optional hook
, | |τj | ≤ τ

max
j
. | (2)

Why gains must be per-joint (measured). With explicit integration at ∆t the damping term alone updates ˙q ← q˙(1 − kd∆t/I), stable only if kd∆t/I < 2; the stiffness bound is ω ∆t ≲ 2 with ω =

p
kp/I. A single gain pair that is soft on a shoulder is violently unstable on the tiny ORCA wrist: at ∆t = 2 ms, kd = 4 demands I > 8 × 10⁻³ kg m² — the wrist has O(10⁻³
) and was
measured limit-cycling at 14.7 rad/s. The controller therefore defaults to inheriting each joint’s tuned position-servo gains from the model (kp = gainprm[0], kd = −biasprm[2]), which are per-joint, inertia-matched and stable at the model timestep by construction; hardware plants without a model must pass explicit per-joint gains.

Day-1 → Day-2. With τ

ff = region.gravity ff() the same controller becomes gravity-aware: the measured hold-pose droop falls from 0.242 rad to 0.000 rad (Fig. 1, kp=25 deliberately soft to expose the droop). Targets re-seed bumplessly (hold current()), and the effort clamp τ

max (default
40 Nm) bounds any single-joint fault.

### 4 Gravity compensation (gravity compensation/)

τj = bj (q, q˙)−Dj q˙j on a region’s joints (bias and regions derived in dynamic models.pdf; hold-vs-sag evidence there: 0.000 rad vs 1.01 rad over 2 s). Arm joints use light damping (0.6 Nm s); torso/lift

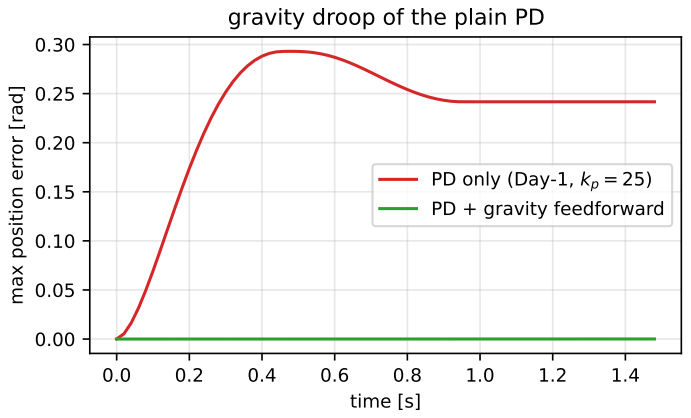
[picture p58: figure]
time [s]; max position error [rad]; gravity droop of the plain PD; PD only (Day-1, kp = 25) PD + gravity feedforward

Figure 1: Gravity droop of the plain PD (Eq. (2)) holding the settled pose, with and without the gravity feedforward hook. Generated by experiments/doc module figures.py.

use “lazy” damping (12 Nm s). The controller optionally adds the guard’s soft-wall torque (§5) and neutralises the managed position servos on entry. It is both a standalone mode (back-drivable float) and the feedforward source for Eq. (2).

## 5 Self-collision avoidance (collision avoidance/)

Each protected link (forearms, hands, torso, head) is wrapped in a capsule; for a pair the surface gap is d(q) = ∥ca − cb∥ − ra − rb with ca, cb the closest points of the core segments. Along the unit separation n, the gap rate is
˙d = n

⊤(Ja − Jb) ˙q ≡ a

⊤q.˙ | (3)

Three enforcement laws share this geometry:

1. “stop” (default): uniform velocity damper. Scale the tracking solution ˙q
| ⋆ by the largest
s ∈ [0, 1] such that every pair’s closing speed obeys

− ˙d ≤ min
α (d − ds),

q
2 astop (d − ds)
, | (4)

the Faverjon–Tournassoud damper [1] plus a braking-distance cap (the fastest approach that can still decelerate to rest at astop = 2 m/s

2 within the remaining gap — the √ | · term dominates

at speed and absorbs the velocity-level linearization error). Pure scaling preserves direction: the hand decelerates to a stop along the operator’s intended path — a wall, not a force field. Tangential sliding and retraction are never impeded.

2. “cbf”: tracking QP. Impose the discrete control-barrier constraint ˙d ≥ −α(d − ds) for all monitored pairs and re-solve tracking:

min
q˙

1/2 q˙

⊤Hq˙ + g

⊤q˙ s.t. Gq˙ ≤ h, q˙lo ≤ q˙ ≤ q˙hi, | (5)

with H = J

⊤J + λ
2W + µI, g = −(J

⊤vdes + µ q˙post) reproducing Eq. (1) when no constraint is active (Goldfarb–Idnani dual active-set via quadprog, OSQP and a clamp as fallbacks). This law can slide the hand around obstacles (the “force-field” feel) — kept as the legacy option.

3. Torque-domain soft wall (for compliance/gravity-comp, where there is no QP):

f = kv

˙dmin − ˙d
+

+ kp

ds − d
+
, | τ += a f, | (6)

with ˙dmin = −α(d − ds): brakes only gap-closing motion and springs back out of the margin; identically zero in free motion (verified at rest in the tests).

Parameters: influence 6 cm, margin 2.5 cm, α = 6 s⁻¹
. Validated by exp wbc validation.py (guard ON: no interpenetration on adversarial crossings; OFF: interpenetrates — which is what makes the guard load-bearing) and re-checked in tests/test collision avoidance.py.

### 6 Admittance (admittance/)

Wrench sensing. Simulation reads the ground truth (external base wrench: xfrc applied reduced to the chassis planar frame). Hardware uses the estimation pipeline — momentum observer → friction/joint-limit attribution → hypothesis-scoring contact localization ON the arm surface — derived in dynamic models.pdf and implemented here (wrench estimation.py); ContactEstimator reduces the wrench from the localized contact point, so pushing the elbow and pushing the hand both steer the base correctly. Estimation is arms-only by design: chassis/lift/torso contacts would require system identification the platform does not have. Validated against ground truth in the Control Lab (web control gui/control lab/experiments/exp wrench est.py): palm pushes recover ∥F∥ to 0.5 N, direction cosine 0.993, contact point 1.7 cm; forearm/elbow 1.1 N / cosine 0.93; rest, post-push and moving-arm negative controls all contact-free.

Base response. The chassis behaves as a virtual planar mass-damper with static (Coulomb) and viscous friction:
m v˙ = F − bl v, | I ω˙ = Mz − ba ω, | (7)

with a static deadband (|F| ≤ 3 N, |Mz| ≤ 5 Nm produce no motion — no creep) and a kinetic stop (unforced and slow ⇒ snap to rest — no endless roll). Steady state vss = F/bl
| | ; time constant
m/bl = 0.20 s (m = 4.5 kg, bl = 22 N s/m, ba high so a one-hand push yaws only gently). A comfort-box gate (referenced to the neutral hand pose) ramps the drive in over 4 cm of excursion so the base engages before the arm reaches its workspace limit. The output twist goes through safe base step — the admittance can never violate the tip envelope. Fig. 2 shows the measured response: the sub-deadband poke produces nothing, the 20 N step rises to exactly vss = 0.909 m/s, release coasts to rest in 0.76 s.

### 7 Compliance (compliance/)

Gravity compensation plus target bookkeeping: while compliant, the desired pose q

des continuously tracks the measured pose, so when the operator later switches to impedance (“Hold”) the arm holds wherever it was left — no spring-back. for region() matches the engine’s region semantics: arms keeps torso, lift and base on their servos; upper body adds the torso (lazy) and frees the lift; whole body is realised by the engine (§9) as compliance + base admittance. Measured (tests/test compliance.py): a 15 N palm push yields >0.1 rad; after release the arm settles within 0.35 rad of where it was left; the arms region provably leaves the lift servo untouched, upper body provably frees it.

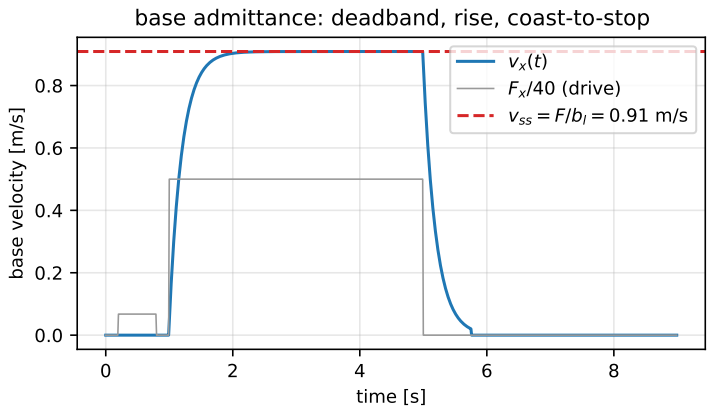
[picture p59: figure]
time [s]; base velocity [m/s]; vx(t) Fx/40 (drive); vss = F/bl = 0.91 m/s

## base admittance: deadband, rise, coast-to-stop

Figure 2: Base admittance (Eq. (7)): Coulomb deadband, first-order rise to vss = F/bl , kinetic
coast-to-stop on release.

## 8 Swerve base controller (base controller/)

For module i at chassis offset ri

, rigid-body kinematics give the wheel velocity vi = (vx−ωri,y, vy + ωri,x); the steering target is θi = atan2(vi,y, vi,x) (minus the module’s mechanical mount yaw) and the wheel speed ∥vi∥/rw (rw = 38.1 mm). Two protections: shortest-path steering — if the steering error exceeds 90◦

, steer to θi ± 180◦ and reverse the drive sign, so a column never sweeps more than ±90◦
; and the anti-slip choke — drive power is scaled by cos(eθ) (the velocity component the misaligned wheel can actually realise) and cut to zero above the 30◦ deadband, so wheels re-aim before they push (Fig. 3). This choke is the physical origin of the 0.13 s command-response ramp

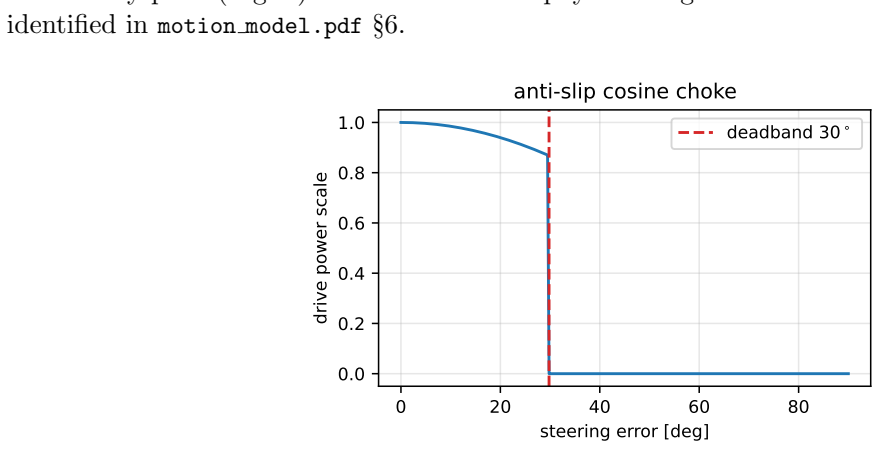
[picture p60: figure]
identified in motion model.pdf §6.; steering error [deg]; drive power scale; anti-slip cosine choke; deadband 30

Figure 3: Anti-slip drive choke vs. steering error: cos eθ, cut at the 30◦ deadband.

## 9 The runtime engine (engine.py)

WBCEngine is what the facade drives when an app selects a torque mode. It is parameterised on two orthogonal axes — control type ∈ {impedance (“Hold”), compliance (“Soft”)} and region ∈ {arm, upper body, whole body} — and applies

τj =

(
bj (q, q˙) + K (q

des

j | − qj ) − D q˙j + τ sc
| j , j ∈ M(region) (the torque law)
gj (q), | j ∈ U \ M(region) (the shared gravity layer)

(8)

with K the operator-tunable stiffness (K=0 in compliance), τ

sc the soft wall (Eq. (6)), M the torque-managed set (§10) and U the actuated upper body of Eq. (2) in dynamic models.pdf. The second case is what makes the engine’s compensation mode-invariant: M ∪ (U \M) = U for every region and control type, so the same 22 DoFs are held against gravity here as under the kinematic stack (§10). Entry/exit is bumpless: entering seeds q
des from the measured pose, neutralises exactly the managed servos (region-dependent; the lift joins in upper body/whole body) and snapshots the actuator gains; exit restores them byte-identically (verified in the tests). In whole-body compliance the engine adds the base loop: wrench (sim truth or estimator) → Eq. (7) → safe base step → swerve ik. Measured (tests/test compliance.py): a sustained 30 N palm pull glides the base at >0.02 m/s with tip usage ≤ 1 throughout; release coasts to <0.02 m/s; the arm region holds the base exactly still under the same pull.

## 10 Mode-invariant gravity compensation

The operator’s control space — Drive, Task, Joint — selects a reference generator, and nothing else is supposed to change. Getting that wrong is an easy and long-lived class of bug, so this section states the invariant and the measurement that enforces it.

The defect (2026-07-24). “When I switch from drive to joint or task space the robot arm will sag.” In the Simulation Control Center those buttons set one wire field: Drive → method="navigation", Task and Joint → method="joint" (Stiff, region arm, K = 27 Nm/rad at the default slider). Gravity compensation, however, was implemented twice, over two different joint sets. The kinematic stack fed all of U; this engine called plant.begin(), which zeroes the whole qfrc applied vector, and then re-applied effort only to M — the 14 arm joints. The ORCA wrists are outside the torque law by design (§9), the torso is outside it in the arm region, and the lift is outside it unless freed. So leaving Drive silently dropped the feedforward on 8 upper-body DoFs, and they settled to their servos’ τg/kp error.

The invariant. One shared layer (dynamic models.pdf, § “One layer for every control space”), with this engine feeding exactly U \M — the second case of Eq. (8). The compensated set is then U in every mode by construction. tests/test mode switch no sag.py asserts the set, not the drift, because drift is only how the violation surfaces and it surfaces far larger on hardware, where kp is finite.

Measurement. experiments/exp mode switch sag.py settles the robot in Drive, switches space, holds, and reports per-group drift — on both deployments, because they fail differently. In-process (sim:mujoco, the Control Lab bench) the engine owns MjData, so servo neutralisation is real. Split (sim:bridge — the default, what server/run.sh runs, and the structural twin of the real robot) the gateway holds a kinematic mirror and ships (targets, effort) to the physics owner at 120 Hz; there a second half of the defect appears, namely that SimBridgePlant.advance() transmitted the effort channel only if wbc active, so in Drive the feedforward was computed into a model the gateway never steps and then discarded — 0 of 22 compensated DoFs reaching the robot. Both halves are fixed; the flag MABEL UNIFIED GRAVCOMP=0 restores the old behaviour, which is how the “before” column below is generated by the same code.

in-process | split (sim:bridge)
quantity | group | before | after | before | after
compensated DoFs, Drive | | 22/22 | 22/22 | 0/22 | 22/22
compensated DoFs, Task/Joint | | 14/22 | 22/22 | 14/22 | 22/22
drift, Drive → Task [deg] | wrists | 1.62 | 0.01 | 1.23 | 0.02
| neck | 0.28 | 0.00 | 0.28 | 0.00
| torso | 0.17 | 0.00 | 0.16 | 0.00
| arms | 0.05 | 0.02 | 0.03 | 0.02
right palm [mm] | | 1.11 | −0.53 | 0.99 | −0.38
5× Drive↔Task | arms [deg] | 0.24 | 0.08 | 1.58 | 0.12
(cumulative) | palm [mm] | 2.17 | 1.02 | 26.53 | −0.68

Three things are worth reading off that table. First, the in-process bench understates the fault by more than an order of magnitude: it shows 1.6 deg of wrist droop and 2.2 mm of palm travel, while the deployment the operator actually runs ratchets — each return to Drive sags the arms with no compensation at all, and the next Task entry re-seeds q

des from that sagged pose, walking the right palm 26.5 mm down over five cycles (run-to-run 22 mm to 40 mm; this loop’s timing is wallclock dependent, so the ratchet magnitude is not deterministic, unlike the single-switch numbers above it, which repeat to the reported precision). After the fix the same five cycles leave 0.7 mm. Second, the drift is independent of K across the operator’s whole slider range (4.5 Nm/rad to 45 Nm/rad), which is the signature of a missing feedforward rather than a soft spring. Third, the residual is a small rise, not a sag: with the wrists compensated they settle nearer their commanded reference than the drooped pose Drive left them in.

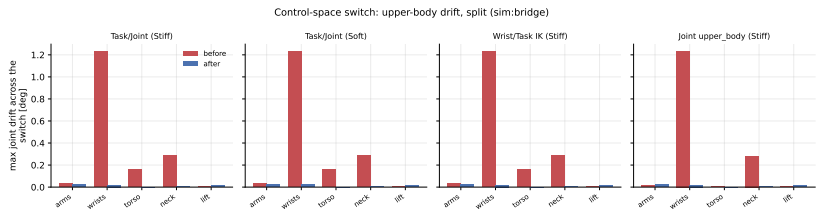
[picture p61: figure]
arms; wrists; torso; neck; lift; max joint drift across the; switch [deg]; Task/Joint (Stiff); before after; Task/Joint (Soft); Wrist/Task IK (Stiff); Joint upper_body (Stiff)

Control-space switch: upper-body drift, split (sim:bridge)

Figure 4: Upper-body drift across each control-space switch on the sim:bridge deployment, before and after unifying the gravity layer. Generated by experiments/exp mode switch sag.py.

## 11 Experiments

Impedance step responses, push-recovery and compliance yield-and-hold are characterised in V4 of exp wbc validation.py (figure wbcval impedance.pdf); self-collision in V3/V4 and tests/test collision avoidance.py; the module-level measurements of this document come from experiments/doc module figures.py and tests/:

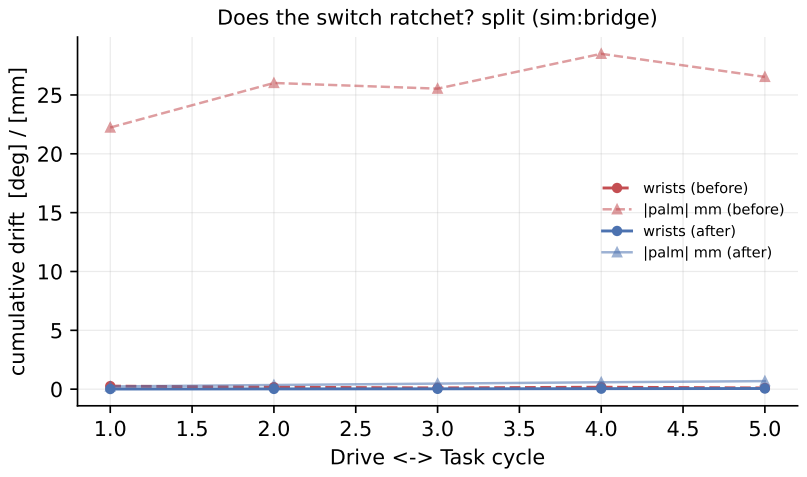
[picture p62: figure]
Drive <-> Task cycle; cumulative drift [deg] / [mm]; wrists (before) |palm| mm (before) wrists (after) |palm| mm (after)

### Does the switch ratchet? split (sim:bridge)

Figure 5: The ratchet: cumulative drift over repeated Drive↔Task cycles. Before the fix the error compounds because each entry adopts the already-sagged measured pose as its set-point.

| law | claim | | | result
PD (Day-1) | step tracking, servo-inherited gains | err <0.15 rad, no limit cycle
PD | droop plain / + gravity ff | 0.242 / 0.000 rad
PD | effort clamp under huge error | |τ | ≤ τ
| | | | | max exactly
gravity comp | hold vs sag, 2 s | 0.000 vs 1.010 rad
admittance | vss vs F/bl | 0.909 vs 0.909 m/s
admittance | deadband / coast-to-stop | no creep / 0.76 s
compliance | yield / hold after release | >0.1 / <0.35 rad
engine | whole-body glide within tip envelope | u ≤ 1 throughout
engine | exit restores servo gains | byte-identical
guard | adversarial crossing, ON / OFF | gap ≥ 0 / interpenetrates

## 12 Implementation & usage

from mabel.whole body controller import (WholeBodyIK, WBCEngine, JointPositionController, GravityCompController, ComplianceController) # Day-1 hardware:
pd = JointPositionController(plant, region joints("arms"))
pd.set targets({"Left Arm 3": 0.4}); pd.update() # per tick
# app torque modes (what the facade does):

eng = WBCEngine(model, data); eng.enter("compliance", "whole body")
eng.step(dt) # wrench=None -> sim truth; pass an estimate on hardware
Legacy | imports | (mabel.wbc, | mabel.wbc runtime, | mabel.swerve, | mabel.self collision,
mabel.admittance) resolve here through compatibility shims.

## 13 Limitations

- The engine’s impedance stiffness K is operator-tunable and unbounded in software; hardware deployment should clamp it against actuator limits.

- The soft wall (Eq. (6)) and the estimated-wrench admittance path are simulation-validated only; hardware validation pending.
- quadprog/osqp absence degrades the “cbf” law to a clamp (the default “stop” law is unaffected).
- The swerve choke trades command latency (0.13 s ramp) for zero scrub; aggressive gains would need the friction limit modelled.
- Guard capsules are hand-fitted at the rest pose (SC RADII); a geometry change requires rechecking the rest pose is collision-free.
- §10 is verified in simulation on both deployments, but the real plant reaches the robot differently: ROSPlant does not read qfrc applied at all — it publishes an arm-only feedforward from ArmGravityCompensator on /arms/command.effort, which is already mode-independent, so the physical arms are covered. The physical neck, torso, lift and ORCA wrists get no host-side feedforward on that path in any mode; they rely on their own servos. Closing that gap needs hardware validation and is deliberately not done blind.
- The gravity layer’s recompute is throttled on a wall clock, so a harness running faster than real time recomputes less often per simulated second. Harmless for the sag measurements above (the robot is stationary and g(q) is then constant — visible in the table as drift that does not move across the stiffness sweep), but a fast-motion study should drive it from sim time.

## References

[1] B. Faverjon and P. Tournassoud, “A local based approach for path planning of manipulators with a high number of degrees of freedom,” Proc. IEEE ICRA, 1987.
[2] A. D. Ames et al., “Control barrier functions: Theory and applications,” Proc. ECC, 2019.
[3] B. Siciliano and O. Khatib (eds.), Springer Handbook of Robotics, 2nd ed., 2016 (differential IK, impedance/admittance chapters).
[4] N. Hogan, “Impedance control: An approach to manipulation,” ASME J. Dyn. Sys., 1985.
