Klajdi00/open_mabel/controller/docs/whole_body_retargeting.pdf

## Whole-Body Retargeting for MABEL:

Clutch-Relative and Shoulder-Anchored Wrist Mapping, Cosine-Directional Arm IK, the Decoupled Look-At Neck, and the Lazy Reach Followers
(mabel.whole body retargeting)

MABEL Project — Control & Teleoperation

November 2, 2026

Abstract

This subpackage maps the operator’s body pose — head and wrist transforms plus optional named hand skeletons, from any source (Vision Pro ARKit or a webcam skeleton via the web studios; mabel.sources normalises both) — onto MABEL’s body targets. Every piece is decoupled and independently usable: three wrist-pose retargeting laws (a clutch-relative UMIstyle mapping with per-operator scale, a per-shoulder extension-fraction mapping, and — the live default since 2026-07-24 — a root-uniform scaled-keypoint mapping in the style of Retargeting Matters/GMR [4], which preserves the operator’s head–wrist–wrist pose triangle so the robot tracks the human’s scale), a cosine-directional contact-point arm IK for parity with the apps’ engine, a 3-DOF gaze look-at neck controller that reads only the head pose and writes only the neck (verified), and the lazy base/lift/torso followers that recruit the big DOFs only when the hand centroid leaves a comfort box. Per-operator anthropometry (the scale γ, shoulder anchors, finger sizes) comes from the calibration pipeline documented separately in calibration.pdf. Finger retargeting is deliberately not here (hands are position-controlled and decoupled, hand retargeting.pdf). We also report and fix a pervasive redundant-arm limit cycle (a trust-region artifact) that made held poses visibly oscillate — the reported instability.

Keywords: teleoperation retargeting, general motion retargeting, scaled keypoint mapping, workspace mapping, look-at control, mobile manipulation, embodiment transfer, redundancy resolution.

## 1 Structure

module | class | role
teleop engine/ | TeleopEngine | GMR scaled-keypoint wrist map (live; §4)
wrist clutch.py | Retargeter | wrist SE(3) targets (clutch / shoulder-anchored)
arm cosine.py | ArmRetargeter | directional contact-point arm IK (damped GN)
neck.py | NeckController | decoupled 3-DOF gaze look-at
followers.py | LazyBase/Lift/Torso | comfort-box reach assists
calibration.py | OperatorProfile | per-operator anthropometry (see calibration.pdf)

Two arm paths coexist deliberately (flagged in mabel controller.pdf): the DLS path — Retargeter produces palm SE(3) targets consumed by the differential IK (whole body controller.pdf §2) — and the cosine path — ArmRetargeter solves arm joints directly, matching the apps’ engine. The neck and the followers compose with either.

### 2 Wrist mapping (wrist clutch.py)

Clutch-relative position (default). At (re-)calibration the operator wrist w0 and robot palm r0 are anchored; thereafter
p
ee = r0 + S ⊙ M (w − w0), | | (1)

where M is the fixed ARKit→robot axis remap and S the per-axis workspace scale. The deliberate amplification (S = (1.3, 1.3, 1.4)) keeps the operator’s hands in a small comfortable box while the lazy followers (§7) carry large reaches. With a calibrated profile the scale is corrected by arm length relative to the reference operator, S ← S · clip(Lref/Luser), so the hand-tuned feel is preserved for the reference operator and adjusted for others (calibration.pdf). In body-relative mode the anchor r0 is stored in the chassis frame and re-expressed through the current chassis pose each frame, so targets ride with the driving/turning base.

Shoulder-anchored position (option). Anatomically faithful reach:

p

ee = c

rob
sh + γ M
w − c

hum
sh |
, | γ =

robot arm reach (live FK)
operator arm length | , | (2)

with the operator shoulder c

hum
sh located from the calibrated head-relative offsets; falls back to Eq. (1) when inputs are missing.

Orientation. Relative-rotation clutch by conjugation:

R

ee =
MRwR

⊤

w0M⊤
R0, | (3)

(the rotation angle is conjugation-invariant, which the diagnostic HUD exploits for a 1:1 tracking check). In skeleton mode with a calibrated palm constant K, the absolute geometric match Ree = FopK⊤ is used instead, making the robot’s natural palm frame equal the operator’s. Grasp scalars derive from the calibrated pinch span.

## 3 Cosine-directional arm IK (arm cosine.py)

A faithful port of the research stack’s arm solver so the apps and the viewer produce matching motion. On a scratch MjData the arm joints q (plus the ORCA wrist as a jointly-optimised 8th DOF) minimise

E(q) = Wwrist
c

rob(q) − c

hum

2 + Welbow
1 − ê

rob(q) · ê

hum

+ Worienth
1 − ˆf
rob
·

ˆf
hum
+
1 − nˆ

rob
- nˆ

hum

i

+ Wsmooth∥q − qprev∥

2 + ∥q − qnom∥

2
Wreg

,

(4)

solved under joint bounds — since 2026-07-22 by a projected damped Gauss–Newton with analytic Jacobians (§5, Solver performance; the damping keeps steps bounded at singularities), previously by SLSQP (35 iterations, warm-started; retained as the parity reference). The terms: the hand contact point c = pwrist +ℓ

ˆf (ℓ = 14 cm along the palm forward axis, ≈ middle fingertip) is tracked in position (W=600, lets the two hands meet precisely); the elbow enters only as a direction from the shoulder and auto-disables when the source sends no elbow (ARKit); palm orientation enters as cosines of the forward and normal axes of the anatomically-constructed natural frame (identical construction on operator skeleton and robot FK, hand retargeting.pdf §2); and the per-joint posture regularisation is deliberately asymmetric (Wreg = (0.08, 0.08, 0.40, 0.08, 0.02, 0.08, 0.60)): hard on shoulder-roll and wrist-yaw so roll resolves at the forearm and wrist pitch — the way a human arm does — instead of spinning the shoulder.

## 4 GMR scaled-keypoint mapping (the live engine map)

The live engine (mabel/teleop engine/engine.py — the controller the MabelTeleop facade composes for BOTH the simulated and the real robot) feeds the cosine arm IK of §3 wrist targets built by a root-uniform scaled-keypoint map in the style of Retargeting Matters/GMR [4]. It supersedes (2026-07-24) the per-shoulder extension map of §5, which superseded the legacy head-anchored map; all three are selectable (MABEL ARM MAP).

Why scale, and why a single root. The live requirement is that the robot reproduce the human’s pose shape: the operator’s three tracked upper-body coordinates — head and the two wrists — must sit, relative to one another, where the robot’s do (up to the size difference). GMR
[4] formalises this as a similarity transform about a common root. For a body b with per-body scale sb and general size ratio h/href, GMR places p

tgt
b = (h/href) sb (p

src
b − p

src
root) + p

tgt
root and
uniformly scales the root translation — crucial to avoid foot sliding in their locomotion setting. MABEL has no legs to slide, but the same one-root similarity is exactly what preserves the head– wrist–wrist triangle. We take the root as the operator’s mid-shoulder point rh =

1/2(s

r
h + s

l
h

)
(ShoulderEstimator.root world) and the robot root as its mid arm-mount rr, one uniform upper-body scale σ = Lr/Lh (robot usable reach over the operator’s measured arm length, §5 Step 3; a single ratio, since MABEL’s two arms are symmetric), and the body-frame rotation Mt of (12):
c0 = rr + σ Mt (w − rh), | σ = Lr/Lh. | (5)

Because a single (σ, Mt

, r) acts on both wrists, the operator’s inter-wrist vector maps to σMt(w

| | r −
w

l
) exactly: the pose triangle is preserved by construction, at every separation and direction. This is the structural cure for the per-shoulder map’s collapse (§5): anchoring each wrist on the robot’s own shoulder — which is 3× narrower than a human’s — distorts the triangle and drove clearly-separated human wrists to overlap on the robot, a defect that map could only paper over with an anti-collapse floor (Step 7). Measured (§5.2): the scaled-keypoint position error (the GMR Eg-mpbpe analogue over head + two wrists) is 26 mm for this map versus 182 mm for the per-shoulder map and 92 mm for the head map, and the inter-wrist scale ratio is 0.965 (ideal 1.0) versus 0.541 and 0.902.

Extension renormalisation near full reach. A pure similarity does not by itself guarantee that a fully extended human arm fully extends the robot: Lh is the operator’s own arm length, so σ∥w − rh∥ at ρ = ∥w − sh∥/Lh = 1 need not sit at the robot’s reach boundary once the root offset r is added. So above a gate ρ ≥ 0.85 the target magnitude about the robot’s own shoulder sr is smoothstep-blended to the extension-exact radius ρLr od(ρ) (the Step-6 law of the extension map, overdrive od and all):

λ = S

ρ−0.85

0.15
, c = sr + û
(1 − λ) ∥c0 − sr∥ + λ ρLr od(ρ)
, û =

c0−sr
∥c0−sr∥
, | (6)

so mid-workspace is the pure pose-preserving GMR map and full extension keeps the extension map’s one guarantee (measured ρr = 0.96 at full human reach, the elbow at its hardware stop).

The bimanual proximity blend and anti-collapse floor of Step 7 still apply, but are now essentially inactive (the triangle is already correct); they matter only at true hand contact, where (14) fades to the operator’s 1:1 separation so touching hands still touch. Steps 1–5 and 8–11 below are shared verbatim (the body frame, shoulder anchors, arm length, synthesised elbow, palm orientation, the solver, and basin escape); only the wrist-target law changes.

## 5 Extension-fraction shoulder-anchored mapping (the prior map)

From 2026-07-21 to -24 this per-shoulder map was the live map, and it remains selectable (MABEL ARM MAP=extension); it is retained here both because it is still shipped and because Steps 1–11 document the shared pipeline the GMR map (§4) builds on. It feeds the cosine arm IK of §3 extension-normalised wrist targets instead of the legacy head-anchored map. Motivation, from a live operator report: with the head map, a fully extended human arm left the robot’s elbow visibly bent. The head map places the target at c = p

rob
head + γxy M0 (w − p

hum
head) with the horizontal offset scaled by the calibrated reach ratio and the vertical mapped 1:1; because the robot’s shoulder does not sit where the scaled human shoulder does relative to the head, the fully extended human wrist lands strictly inside the robot’s reachable envelope and the IK tracks that interior point exactly — elbow bent. Measured (§5.2): interior elbow angle 121◦ at full human extension, 61◦
from the joint
limit.

### 5.1 The mapping pipeline, step by step

Inputs per frame: the ARKit head pose H = (RH, pH) ∈ SE(3) (world +ŷ up), the per-hand named skeletons with wrist positions w

r

, wl
, and the robot’s live FK (chassis rotation Rch, arm-mount positions s

r/l
r ). All operator quantities are in the ARKit world; all robot targets are emitted in the robot world. Superscripts r/l are dropped where a step applies per side.
Step 1 — operator body frame Bop. A yaw-only, gravity-aligned frame with columns [ˆr û

ˆf]
(right, up, forward):

û = êy, rˆ =

A⊤

sin ψ, − cos ψ, 0

⊤

·

,

ˆf = û × r, ˆ | (7)

where ψ is the torso heading from the analytic body-frame estimator (head + two wrists; it rejects look-around, reach, and gaze-fixed motions that fool a head-only heading, and its wrist-consensus grounding makes it non-accumulating — body frame.pdf) expressed through the fixed axis permutation A (AVP TO ROBOT); before the estimator is ready, ˆf falls back to the head heading flattened to the horizontal, ˆf ∝ (I −uûˆ
⊤)(−RHeẑ). Head pitch/roll never tilt this frame, so a glance neither orbits the estimated shoulders (Step 2) nor rotates the map (Step 4).
Step 2 — stature and shoulder anchors. Stature from the HMD eye height with the Winter eye-height ratio, kept as a running maximum so crouching never shrinks the skeleton:

Hst ← max
Hst, clip

pH,y/0.936, 1.40, 2.10

. | (8)

The shoulder centres are fixed offsets in the body frame (measured OperatorProfile values when present, Winter ratios otherwise: half-width b =

1/2 0.259 Hst, eye→acromion drop d = 0.118 Hst):

s

r/l
h | = pH ± b rˆ − d u. ˆ | (9)

Step 3 — operator arm length Lh. The calibrated profile length when measured; otherwise a live estimate floored by the anthropometric prior,

Lh = max
0.332 Hst, runmax
t

med5 ∥w − sh∥

∈ [0.30, 0.90] m, | (10)

where med5 is the median of the last five samples (rejects single-frame ARKit spikes, which a raw running max would latch forever) and samples are discarded outside a plausibility band. The prior FLOOR matters: early sub-maximal reaches must not shrink Lh and over-read the extension; a longer-than-prior arm is adopted after its first full extension (measured: ρr at ρh=0.8 recovers from 0.95 to 0.82 after one full reach). A shorter -than-prior arm requires the measured profile (limitation, §Limitations). The 1-pose arms-forward calibration is MIRRORED (2026-07-23): the retarget runs alongside the capture, so the robot extends with the operator (ρr = 0.96 during the hold, its full-extension maximum) and Lh self-calibrates from those same frames — the earlier hold-still-while-measuring behaviour gave no visual confirmation and starved (10) of exactly the full-reach evidence it needs.

Step 4 — extension coordinates (the body-relative ground truth). Per side,

v = w − sh, ρ = min∥v∥
Lh

, 1

, nˆ =

v
∥v∥

, χ = B

⊤
opn, ˆ | (11)

i.e. the wrist is reduced to how far along the operator’s own arm it is (ρ) and which body-relative direction it points (χ = [χr, χu, χf ]

⊤, components along the operator’s right/up/forward). (ρ, χ) is invariant to where the operator stands and which way they face — this is the representation in which the mapping is defined, so it cannot “mess up over time”: no world anchor is ever consulted.

Step 5 — the frame map Mt (operator body → robot body). The robot’s semantic basis is built from its LIVE chassis rotation (Ralign turns chassis axes into robot-body axes, x=fwd/y=left/z=up; the front is chassis −x):
W = RchRalign, | Rrob =
− Wê2 Wê3 Wê1
(right, up, fwd), Mt = Rrob B

⊤
op. (12)

Mt maps any operator-world vector to the robot-world vector with the SAME body-semantic components. Invariance is immediate: a whole-body operator turn Ry sends Bop → RyBop and every skeleton vector v → Ryv, so Mtv → RrobB⊤

opR⊤
y Ryv = Mtv; a chassis turn cancels identically on the robot side. Before the estimator has axes (or with MABEL ARM BODY FRAME=0) Mt degrades to the fixed world permutation A — the pre-2026-07-22 behaviour, which E6 measures failing at π rad for a 180◦ operator turn.
Step 6 — raw wrist target. With Lr the robot’s usable per-side reach (measured once by DLS from the arm mount: 0.669 m right, 0.660 m left),

c0 = sr + od(ρ) ρ Lr Mt n, ˆ od(ρ) = 1 + 0.04 S

ρ − 0.85
0.15
, | (13)

with S the smoothstep S(x) = clip(x, 0, 1)²
(3 − 2 clip(x, 0, 1)). The robot’s wrist is commanded to the same fraction of its own arm length, along the same body-relative direction from its own shoulder : full human extension is full robot extension by construction, for every operator size and direction, and the target rides the robot’s own body (lift/torso motion carry it). The overdrive od pushes the target marginally past the reach boundary only near ρ = 1, so the IK’s position term overrules the posture regularisers and the elbow saturates its hardware range; mid-workspace stays exactly 1:1.

Step 7 — bimanual coupling (blend + anti-collapse floor). Per-shoulder anchoring is exact per arm but couples the PAIR only through anatomy, and the robot’s biacromial width (0.148 m) is 3× smaller than a human’s (∼0.45 m): inward-angled directions cross the robot’s midline far sooner (measured 1.6 cm robot separation at 30 cm human — the reported wrist overlap). With d = w

r − w

l
(operator, metric):

ω = S

0.35 − ∥d∥
0.35 − 0.12
, | cr/l ← (1 − ω) c

r/l + ω

c¯±

1
2Mt d
, | (14)

F = min
0.18, ∥d∥

, | cr/l ← c¯±
1/2 Fâ iff ∥c

r − c

l
∥ < F, | (15)

where ¯c is the pair midpoint and â the current separation axis. (14) fades the pair to the operator’s EXACT 1:1 metric separation near contact (touching hands touch); (15) is the anti-collapse floor — deliberately absolute, not γ-proportional: it can never push a target whose natural separation already exceeds a hand clearance, so one-arm tasks with the other arm hanging are untouched (a γ∥d∥ floor measurably contaminated them: full-reach ρr rose 0.959 → 0.988 and circle tracking tripled its error), while F → ∥d∥ near contact keeps (14) authoritative. Finally each target is clamped in front of the chassis front line (§2) so no arm can be commanded behind the torso.

Elbow-hint standoff (2026-10-16; applies to Step 8’s output). Whatever produced the elbow hint er (the tracked forearm line or Eq. (17) below, mapped onto the robot’s shoulder sr), it is shifted outward before it enters the IK’s elbow-direction cost:

e

′
r = er + a

Πxy(sr − s

other
r

)
∥Πxy(sr − s

other
r

)∥

, | a = ARM ELBOW ABDUCT = 0.15 m, | (16)

with Πxy the horizontal projection. Only the direction e

′
r − sr is scored (Welbow = 15 against the wrist’s 600), so this is a soft abduction bias, strongest on a hanging arm and fading as the elbow rises; the wrist target is untouched. Reason: a human elbow hangs beside a torso about as wide as the shoulders, while the robot’s shoulders are ∼ 3× narrower against its torso, so copying the operator’s elbow direction parked the upper arm on the self-collision margin (operator on NOVA: “way too close to the body, it feels tucked”). Measured on three live Vision Pro takes through NOVA’s deployed retargeter (E9 of the Retarget Lab doc, web gui/retarget lab/experiments/exp elbow body.py): median elbow clearance to the torso capsule 62–125 → 106–196 mm, upper arm within 20 mm of the torso on 3.6–11.2 → 0.0–0.7 % of frames, wrist error p50 27–38 → 23–33 mm. a = 0 restores the plain copy.
Step 8 — synthesised elbow (swivel from the palm roll). ARKit streams no tracked elbow (its forearm joint is a hand-anchor extrapolation), and with no elbow objective the redundant arm’s configuration is weakly determined for high or close targets (measured 0.36–0.52 rad/tick basin flips). A two-link elbow is synthesised from the estimated shoulder, wrist, and HAND ORI-ENTATION, with u = 0.56Lh (upper arm), f = 0.44Lh (forearm), ℓ = min(∥v∥, u+f). The law of cosines fixes the flexion; the swivel basis (ˆr0,tˆ0) is gravity-referenced:

cos α =

u

2 + ℓ

2 − f

2
2uℓ | , | rˆ0 =

(I − nˆnˆ

⊤)(−û)
∥ · ∥ | , | tˆ0 = ˆn × rˆ0,
eh = sh + u cos α nˆ + u sin α (cos φ rˆ0 + sin φ tˆ0), | (17)

so φ = 0 is the relaxed elbow-down pose. The swivel φ is estimated from the PALM’S ROLL about the arm axis (2026-07-22, “when I push my elbow up the sim does not follow”): raising the elbow rotates the humerus and the whole distal arm rolls with it — and from a palm-down posture pronation is already near-saturated, so the palm must roll with a rising elbow. With ˆnp the palmar normal (the LEFT side’s mirrored normal is flipped first) projected off the arm axis,

θ = atan2
(ˆr0 × pˆ)·n, ˆ rˆ0 ·pˆ

, φraw = clip
sgn θ max(0, |θ| − θdead), ±2.6
, | (18)

where θdead = 60◦ deadbands the pronation/supination slack that rolls the palm with NO elbow motion (the formal under-determination of wrist-only data). φ is EMA-smoothed (α = 0.1/frame; the raw per-frame roll wobbles with hand geometry and unfiltered it tripled the circle direction RMS), and the elbow objective adapts to it: Weff
elbow = Welbow(1+1.5|φ|) and the Arm-3 shoulder-roll regulariser relaxes ∝ |φ| — at a large raise the rolled palm orientation is UNREACHABLE (J5/J6 saturate) and its cost exactly cancelled the elbow gain (two equal-cost basins, the arm stalling halfway); when the operator steers the elbow, its look wins the tie, while a neutral swivel keeps the original balance (fast-circle tracking unchanged at 3.8
- RMS). Finally a TORSO-CLEARANCE clamp solves λ(φ) = P cos φ + Q sin φ + R = λmin exactly (the root nearest the desired φ; an earlier stepped walk made the hint jump discretely) so the elbow never crosses inward past the shoulder — complementing the new l/r upper↔torso pairs added to the self-collision guard (the upper arm was previously entirely unguarded). These are ELBOW SPHERES (r = 0.035 m) with a 3 mm per-pair margin, and the geometry forced both choices: the settled right elbow rests only 0.136 m from the torso axis, so an upper-arm segment capsule sits 6 cm inside the torso capsule at rest, and the global 2.5 cm margin spring-loads the natural rest pose (measured: 15◦ of fake “sag” in impedance holds as the torque-domain barrier pushed a merely-hanging arm), while a zero margin let the discrete CBF overshoot ∼1 mm negative under an adversarial crossing. The hint maps like every other vector, erob = sr + Mt(eh − sh), feeds only the direction cosine of (4), is overridden by any tracked (webcam) elbow, and is gated OFF when ∥d∥ < 0.35 (near bimanual contact it measurably fought closure by 3 cm). Validation (E7): the robot’s elbow swivel follows a commanded 0 to −115◦

sweep with 23–40◦
error — the robot’s INTRINSIC capability is itself ∼20◦
short at mid swivels (probed with a dominant Welbow=600: J5/J6 saturate holding the rolled palm) — the elbow visibly rises from −16 cm below the shoulder to 4 cm above, and a cross-body reach holds the upper-arm capsules at the QP’s exact 2.5 cm margin with zero solver fallbacks.
Step 9 — palm orientation. The operator’s natural palm frame Fop (§3) is carried through the SAME map, ˆftgt, nˆtgt from MtFop — with the fixed world map a turned operator’s palm axes stayed world-anchored and the hands twisted with the body heading.
Step 10 — the arm solve. The targets (c, erob,

ˆftgt, nˆtgt) enter the cost (4), minimised by the projected damped Gauss–Newton of the Solver performance paragraph: stacking the weighted residual rows (using 1 − â

⊤ˆb =

1/2∥â − ˆb∥
2
to express the cosine terms as least squares)

r(q) =

√
Wwrist
c

rob(q) − c
p
Welbow/2
ê

rob(q) − ê
p
Worient/2

ˆf

rob(q) − ˆftgt
p
Worient/2
nˆ

rob(q) − nˆtgt
√
Wsmooth

q − qprev
p
Wreg ⊙

q − qnom

,

J

⊤J + λI
∆q = −J
⊤r, | (19)

with every Jacobian block analytic (mj jac; unit-vector blocks via Jvˆ = (I − vˆvˆ

⊤)Jv/∥v∥, rotatingaxis blocks via ∂(Ra)/∂qj = Jω,j × (Ra)), λ = 10⁻²
, bounds handled by the active-set reduction, and warm solves trust-region bounded to qprev ± 0.10 rad (a 6 rad/s slew — far above teleop speed, but inter-frame basin hops become impossible). The engagement-ease clock is separately clamped to 40 ms/tick so a wall-clock stall can never fast-forward the safety ease (a measured 1.5 s stall once published a 1.2 rad step).
Step 11 — basin escape (history independence). A long excursion can strand the warm-started redundant arm in a poorer local minimum which the trust region then faithfully preserves (measured 81 mm residual after a walk loop). Whenever the target has stayed inside a 1 cm ball for 12 frames, the incumbent q is compared against a converged cold solve q◦ from qnom over the full joint range, by total cost with the smoothness term neutralised (else it always vetoes the challenger):

E◦(q◦) < 0.98 E◦(q) =⇒ latch q

⋆ = q◦ and walk q → q

⋆
in trust-bounded steps. (20)

The latch is essential — a single steered step is pulled straight back by the incumbent minimum on the next warm solve — and is dropped the moment the target moves. Since q◦ is a deterministic function of the (body-relative) target, every quasi-static pose becomes history-independent: the property the E6 walk-loop test asserts.

Solver performance (2026-07-22). Profiling on the Mac (canonical model mabel full.xml) took the whole-body retarget frame time from 33 ms p50 — an effective ∼30 Hz ceiling — to 6.0 ms p50 / 10.5 ms p95 (167 Hz p50 / 96 Hz p95). Two fixes live here. First, the cosine arm IK’s SLSQP — whose finite-difference gradients cost nine full-model mj kinematics evaluations each — was replaced by a projected damped Gauss–Newton on the same cost (4) using MuJoCo’s analytic Jacobians (mj jac): 0.2–0.6 ms per side versus 6.2–7.3, with verified-identical optima on static targets (8 outer iterations with early stop, damping 10⁻²
; MABEL ARM SOLVER=slsqp keeps the scipy reference for parity checks). An active-set pass proved essential: coordinates that hit their box bound are fixed at the bound and the reduced normal equations re-solved, so the step slides along the active face — naive clipped GN zig-zags and leaves a 12.4

◦
circle-direction tracking lag at any iteration count, versus 3.9
- with the pass (1.3
- SLSQP reference; the residual is transient lag on a deliberately fast test trajectory — static accuracy is identical). Second, the engine’s ThreadPoolExecutor over the two arm sides became inline sequential solves: with submillisecond solves the pool’s dispatch and GIL handoff measured 5–6 ms per frame — 10× the work it parallelised (MABEL ARM POOL=1 restores it for A/B; the finger-solver savings are documented in hand retargeting.pdf). Separately, the canonical MJCF’s arm position-servo gains were raised kp 100 → 500, kv 20 → 45 (left arm.xml/right arm.xml, 7 actuators each): on a 0.5 Hz / 0.3 rad sine track with gravity compensation the joint error fell from 5.87◦

to 3.33◦ p50 (15.1

- to 5.6 | ◦ p95)
and the phase lag from 188 to 86 ms, with ≤ 4 % overshoot on a 0.5 rad step; the large-step t90 floors at ∼170–200 ms, set by forcerange saturation (±40/27/7 N m) — physics, not gains — and the WBC position controller inherits these gains from the model by design (pd.py reads gainprm). The bridge loop itself was verified healthy: the facade substep fast path (stale frame, memoized) costs 0.038 ms and mj step 3.3 ms at the 4 ms timestep (1.2× real-time) — the old 33 ms retarget spike was what starved the physics accumulator.

Global (body-frame) mapping, separation floor, and basin escape (2026-07-22). Three additions make the map globally consistent, motivated by a live report: after walking around and returning to face forward with the same reach, the retargeting failed to reproduce the configuration, and clearly-separated human wrists sometimes overlapped on the robot. (i) Bodyframe decomposition. The wrist-from-shoulder direction, palm orientation axes and synthesised elbow were mapped through the fixed ARKit→robot world rotation M, so the map depended on the operator’s world heading (and ignored the chassis heading). They are now decomposed in the OPERATOR body frame (right/up/forward from the body-frame estimator — wrist-consensus-grounded, non-accumulating) and reconstructed in the ROBOT’S chassis body frame:
Mt = Rrob
sem(t) Bop(t)

⊤, both sides rotating with their own body, so the same body-relative pose maps to the same body-relative robot config for any operator heading, any walk history, and any chassis yaw (MABEL ARM BODY FRAME=0 reverts). (ii) Anti-collapse separation floor. The robot’s shoulders are 0.148 m apart vs a human’s ∼0.45 m, so inward-angled directions cross the midline far sooner on the robot — the geometric root of the overlap (measured: 1.6 cm robot separation at 30 cm human). The inter-wrist distance is now floored at min(0.18 m, dhuman), symmetric about the pair midpoint: deliberately absolute, so one-arm tasks are never touched (a γ-proportional floor measurably contaminated them), while it fades to the operator’s own 1:1 separation near contact so touching hands still touch. (iii) Basin escape. A long excursion can strand the warm-started redundant arm in a poorer IK basin that the trust region then faithfully preserves (measured 81 mm residual after a walk loop). When the target has been quasi-static (inside a 1 cm ball) for 12 frames, the incumbent is compared against a converged cold solve from the nominal posture (smoothness term neutralised); a genuinely better canonical basin is latched and walked to in trust-bounded steps — one-shot steering is pulled straight back by the incumbent minimum. Quasi-static poses thereby become history-independent.

### 5.2 Experiments (exp retarget fidelity.py)

Headless, deterministic (synthetic clock, fixed seeds), driven through the shipped engine’s per-frame path on synthetic operators with known ground truth; measurements are FK of the commanded actuator targets. Statures 1.55/1.75/1.95 m; the head-map baseline uses its calibrated reach (what the 1-pose calibration measures for the same operator). All 34 assertions across E1–E10 pass. The E8 scale-fidelity battery is the direct test of the live requirement — that the robot track the human’s head–wrist–wrist scale. Over a library of eight bimanual poses it reports the scaled-keypoint position error (the GMR Eg-mpbpe analogue: each wrist relative to the mid-shoulder root, scaled by σ and mapped, versus the robot’s realised wrist relative to its root) and the inter-wrist scale ratio ∥c

r − c

l∥rob/(σ∥w

r − w

l∥hum):

scale fidelity (mean over the pose library) | GMR | extension | head
scaled keypoint error (g-mpbpe analogue) | 26 mm | 182 mm | 92 mm
p95 | 60 mm | 191 mm | 120 mm
inter-wrist scale ratio (ideal 1.0) | 0.965 | 0.541 | 0.902
inter-wrist direction error | 0.7
- 4.3
- 0.1
| | | ◦

The per-shoulder extension map, exact on extension, is by far the worst on scale: anchoring on the robot’s narrow shoulders halves the inter-wrist separation. The GMR map is within 3.5 % of the ideal scale and 26 mm on the triangle. The reach/tracking metrics (unchanged by the map choice — they share Steps 1–11) remain:

metric (forward reach unless noted) | | extension | head (legacy)
ρr at full human extension (mean over statures) | | 0.962 | 0.920
elbow interior angle at full extension (hw max 161.4
| ◦
| ) | 161.9
- 122.8

◦
circle tracking ρ RMS (at ρ=0.7) | | 0.031 | 0.065
circle tracking direction RMS (GN solver) | | 1.6
- 25.7

◦
robot inter-wrist gap at 5 cm human gap | 5.0 cm | —

The trust-region limit cycle (the “very unstable” report), found and fixed. A live report of the whole-body retargeting being “very unstable” resolved to a redundant-arm limit cycle, exposed by the E10 held-pose sweep: a single static hold pose can land in a clean IK basin by luck (an earlier one-pose check read 0.00 mrad), so E10 holds a grid of 36 bimanual reaches and reports the worst per-joint command standard deviation. 16 of 36 poses oscillated at ±0.10 rad — exactly the trust step. The mechanism: the warm-started arm solve ran the Gauss–Newton iterations inside the trust box qprev ± 0.10, which re-centres on qprev every frame; when the basin’s true local optimum lay outside the box, the “converged” q was a box edge — not a stationary point — and that edge flipped sides each frame, a stable 2-cycle (confirmed: escape-off and smoothness ×10 both left it; trust-off removed it, converging to a clean fixed point). The fix (arm.py solve()) is to run the GN on the full joint range from the warm start — a local method, so it stays in the current basin (the anti-hop property the trust region protects is kept: the E6 walk-loop still reproduces the active arm to 6.5 mm) — and clip the result to the trust box. On a static pose the optimum is then a constant, so the arm walks to it monotonically and stops. After the fix:

E10 stability (GMR map, 36-pose held-reach sweep) | before | after
poses that oscillate (> 2 mrad command std) | 16 / 36 | 0 / 36
worst per-joint command std over the sweep | ∼50 mrad | 1.77 mrad
conversational-trajectory wrist tracking RMS | — | 16.9 mm
max per-tick joint step on the slow sweep | — | 0.095 rad

As a bonus the fix improved tracking (warm solves now reach true optima, not box edges): circletracking direction RMS 3.8

- → 1.6

◦

, and the walk-loop idle arm settled from 16 mm/31◦ to
2.3 mm/0.4

◦

Elbow human-likeness (E9). The arm must “bend like a human’s, not twist at weird angles.” The elbow-direction residual is dominated by robot kinematics, not any IK weight (raising Welbow from 30 to 120 moves mean error only 28◦ → 24◦

, p95 flat at 65◦ — and W ≥ 45 re-opens the limit cycle above), so the human-likeness lever is the swivel deadband θdead that maps palm roll to elbow swivel (18). Tightening it 1.05 → 0.45 rad (a human forearm pronates only ∼ ± 25◦ with the elbow still) cuts the swivel-follow error 28.7

- → 15.7

◦
(E9 deadband ablation, GMR map) — the elbow now tracks a commanded raise instead of hiding it — while the wrist-yaw “twist” DoF stays inside its ±25.8
- anatomical clamp. The E6 global-consistency battery asserts the new invariants: the identical body-relative pose at world yaws 0/90/180/270◦ produces identical arm commands (max difference 0.000 rad; the world-fixed map fails at 3.142 rad); after walking a square, spinning 360◦ and returning, the ACTIVE arm reproduces to 8.4 mm wrist / 0.4

◦
elbow /
1.5
- palm (the idle arm’s cost-flat rest micro-pose is bounded loosely at 50 mm); and the separation transfer drob(dhum) is monotone with a minimum 18 cm robot gap while the human is clearly apart (> 25 cm), closing to 5.0 cm at a 5 cm human gap. The robot’s elbow hardware range stops at −95.7

◦
(161.4

◦
interior): at full human extension the extension map drives it to within 0.5
- of
that mechanical maximum — the residual bend is the OpenArm’s geometry, not the retargeting. All 12 edge-case assertions pass: hyper-extension saturation, wrist-at-shoulder degeneracy, handdropout freeze + reacquire, ARKit origin jump (no snap; the shoulder-anchored map is translationinvariant, pose recovered to 0.004 rad), crouch invariance, long-arm self-calibration, immediate profile apply, headless frames, lock j7, and co-existence with the self-collision guard. The endto-end real-dispatch chain (exp real retarget chain.py) passes 5/5 consecutive runs with every published command step-bounded.

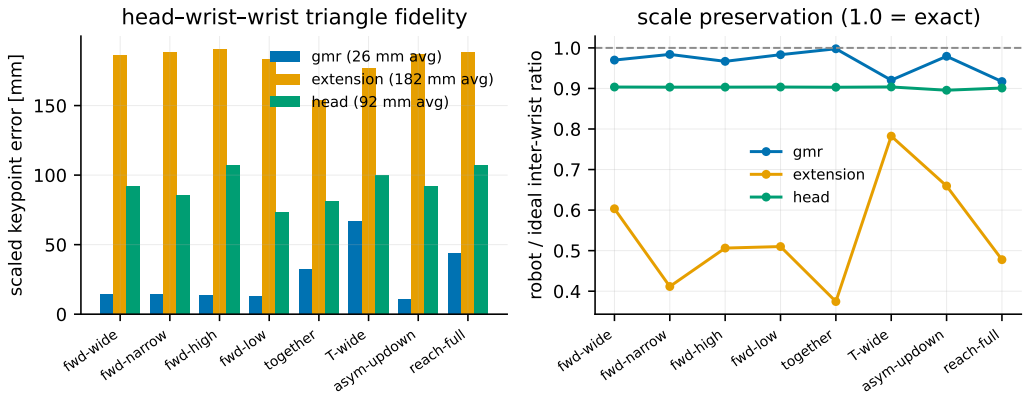
[picture p63: figure]
fwd-wide; fwd-narrow fwd-high; fwd-low together; T-wide; asym-updown reach-full; scaled keypoint error [mm]; head wrist wrist triangle fidelity; gmr (26 mm avg) extension (182 mm avg) head (92 mm avg); robot / ideal inter-wrist ratio; scale preservation (1.0 = exact); gmr extension head

Figure 1: Scale fidelity (E8), the direct test of “track the human’s scale.” Left: per-pose scaled-keypoint error (head–wrist–wrist triangle) for the three maps over the pose library — the GMR map (blue) holds 26 mm average where the per-shoulder extension map (orange) is 7× worse. Right: inter-wrist scale ratio (1.0 = the operator’s separation, scaled); the extension map collapses to 0.54 (the robot’s narrow shoulders), the GMR map tracks 0.965.

## 6 The decoupled neck (neck.py)

Copying the operator’s 6-DOF head pose onto a 3-DOF neck of different height is kinematically impossible; instead the head command reduces to a single 3D look-at point (the HoMMI relaxation: roll left free). The gaze ray (operator head rotation applied to the calibration gaze, made body-local so driving does not drag the gaze) is cast into the scene (mj ray, self-hits within 25 cm rejected, 1.5 m fallback); the neck’s yaw/pitch/roll targets then point the head’s optical axis at the hit point by differential pointing with gain kp=4. Decoupling contract: the controller reads only the head pose/scene and writes only the three neck actuators — asserted by tests/test retargeting.py — so it composes with any arm/hand mode and steps aside entirely when a client drives the neck in joint space (the facade evicts stale neck joint targets when the head-follow owns it).

### 6.1 Live engine: gaze coverage and the neck-yaw→base-yaw handoff

The live engine (teleop engine/geometry.py::neck angles) maps the head’s rotation relative to a latched, torso-relative datum R0 directly onto the neck, after removing the measured chassis yaw ψc and torso pitch: ∆R = Rz(−ψc) M R⊤

0 Rh M⊤, decomposed as yaw–pitch–roll (M = ARKit→robot axes). The full-immersion Vision Pro view shows the head camera on a head-locked window, so the picture is always drawn where the operator looks. It is the right picture only while the neck can follow. Range (MJCF ctrlrange): yaw ±90◦

, pitch ±45◦

, roll ±45◦

Coverage, neck only (experiments/exp head gaze coverage.py, part A). Synthetic ARKit head poses on a 5◦ grid (yaw ±180◦

, pitch −80◦

..+60◦
; 73 × 29 poses) are mapped through neck angles, clipped exactly as the engine clips, and the zed left optical axis is measured by MuJoCo FK in the chassis frame (torso and chassis at the home keyframe). Inside the range the camera follows the head exactly (0.0◦

error at pitch −10/ − 20/ − 30/ − 45◦ and yaw 45/90◦ ; a
nod down moves the camera down 1:1). Outside it the error grows 1:1 with the excess: 15◦ at a 60◦

look-down, 30◦ at a 120◦

look left, 90◦
looking behind. Only 33.2 % of the grid (39.8 % of the

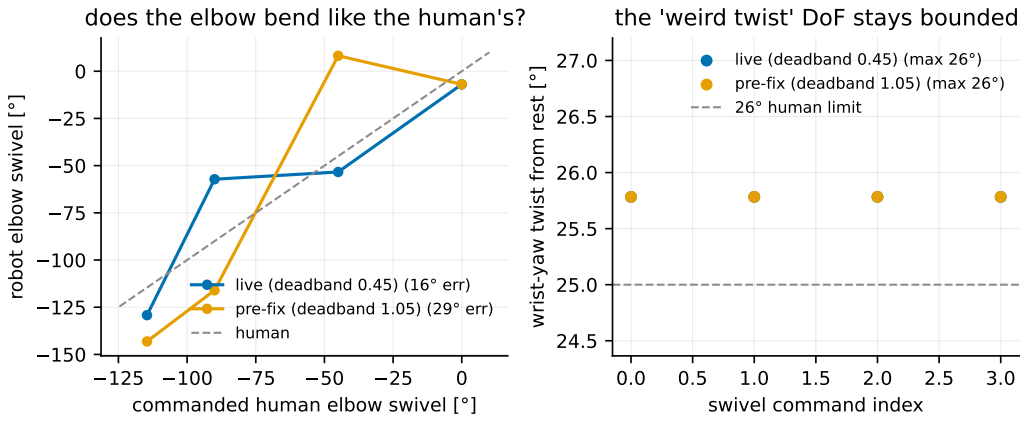
[picture p64: figure]
commanded human elbow swivel [°]; robot elbow swivel [°]; does the elbow bend like the human's?; live (deadband 0.45) (16° err) pre-fix (deadband 1.05) (29° err) human; 0.0 0.5 1.0 1.5 2.0 2.5 3.0 swivel command index; wrist-yaw twist from rest [°]; the 'weird twist' DoF stays bounded; live (deadband 0.45) (max 26°) pre-fix (deadband 1.05) (max 26°) 26° human limit

Figure 2: Elbow human-likeness (E9). Left: robot elbow swivel vs the operator’s commanded swivel (identity dashed) — the tightened deadband (blue) follows a raised elbow that the pre-fix deadband (orange) hid. Right: the wrist-yaw “weird twist” DoF stays inside the ±26◦ human anatomical clamp for both.

sphere, area-weighted) is within 2◦
(Fig. 6).

The handoff (teleop engine/neck handoff.py, operator 2026-10-23: “I need to have 360 view as I move my head”). Let ψn be the unclipped neck yaw that neck angles asks for, so ψn = ψh − ψc. Past a handoff angle ψ

⋆ = 80◦

(10◦
inside the joint limit, so the neck still tracks a fast head while the base catches up) the excess becomes a base yaw rate:

e = ψn − clip(ψn, −ψ

⋆

, ψ⋆
), | ωz = clip(k e, −ωmax, ωmax), | (21)

with k = 2 s⁻¹ and ωmax = 0.8 rad/s, below BASE WMAX. Because ψc is measured (encoders and odometry are mirrored into the model on the real robot, server/plant.py), the turn closes the loop by itself: as the chassis turns, ψn → ψ

⋆ and e → 0. The rate is added at the point of consumption (base step(extra wz=), never written back into the persistent base tgt). It then passes through the tip-safe BaseMotionModel like every base twist. It is active in every scope, but never in Drive (the stick owns the base), while clutched, when the neck is frozen, or when not engaged and streaming. MABEL NECK YAW HANDOFF=0 disables it. Assumptions: the closed loop needs a live chassis-yaw measurement. Stall guard: the handoff integrates the yaw it commanded and the (unwrapped) yaw actually measured. Once commanded exceeds measured by 45◦
| | (stale odometry,
a blocked base), it latches off until the next engage, clutch, or Set Forward. A rate law alone would otherwise spin the base indefinitely.

Closed loop in physics (part B). The operator snaps the head to ψ and holds it. Each 100 Hz tick runs neck angles with the measured chassis yaw, the handoff, BaseMotionModel, swerve ik, and mj step on scenes/mabel bare.xml:

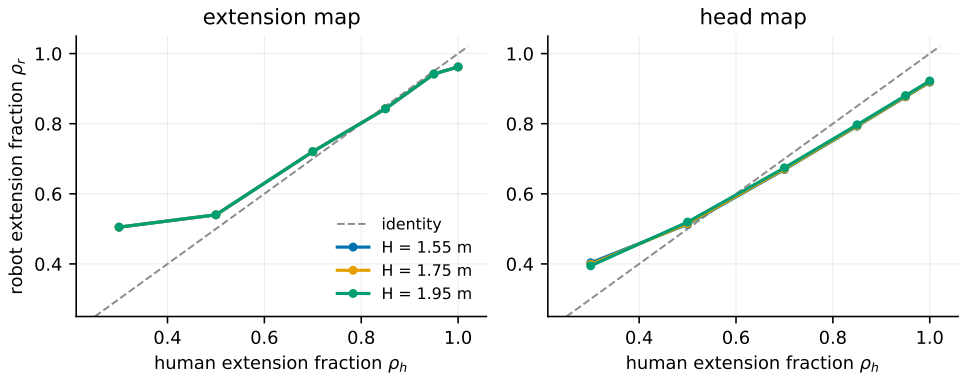
[picture p65: figure]
human extension fraction h; robot e; xtension fraction r; extension map; identity H = 1.55 m H = 1.75 m H = 1.95 m; head map

Figure 3: Extension transfer ρr(ρh), forward reach, three statures. The extension map (left) is identity up to the hardware elbow stop for every operator size; the calibrated head map (right) distorts mid-workspace and saturates at ρr ≈ 0.92 — the reported bent elbow. The GMR map inherits this full-extension guarantee via the renormalisation (6).

hold | t90 [s] final error | neck yaw | chassis yaw | stalled
60◦ | 0.23 | 0.2◦ | 59.8
- 0.0
- no
100◦ | 0.28 | 0.2◦ | 80.3
- 19.9
- no
135◦ | 0.76 | 0.2◦ | 80.3
- 54.9
- no
180◦ | 1.65 | 0.2◦ | 80.7
- 99.6
- no

Every hold, including a look straight behind, converges to 0.2

| | | ◦
, with the neck parked at the handoff angle and the chassis carrying the rest (Fig. 7). Unit contracts (no motion inside the range, sign, cap, closed-loop settle, a full 360◦ without a false stall, latch-off on stale odometry, reset re-arms) are in tests/test neck yaw handoff.py. Pitch has no handoff: the base cannot pitch, so a look down past 45◦
stays capped (the error grows 1:1 past it, as in part A).

## 7 Lazy reach followers (followers.py)

MABEL’s analogue of root-translation handling: the big, slow DOFs move only when the handtarget centroid c leaves a comfort box, each by a piecewise-linear deadband P-law

| v = k

e − emax
| | +

− k

| | | emin − e
| | | +
, | (22)

applied to: the base (forward error over [0, 0.80 m] from the chassis centre — the lower bound pinned to the body line so the base retreats the instant a wrist crosses behind the torso; lateral half-span 0.25 m; yaw deadband 0.30 rad); the lift (centroid height about a 0.63 m reference, half-span 0.12 m, rate capped at the firmware’s 60 mm/s); and the torso (forward lean beyond 0.45 m of forward reach, before the base must translate). Follower base twists pass through safe base step downstream like every other twist.

### 7.1 Live engine torso law: box vs trunk angle

The live engine’s cascade (teleop engine/wholebody.py, WholeBodyController.update targets) drives the torso from the operator’s HEAD displacement (d, h) since calibration (forward, drop;

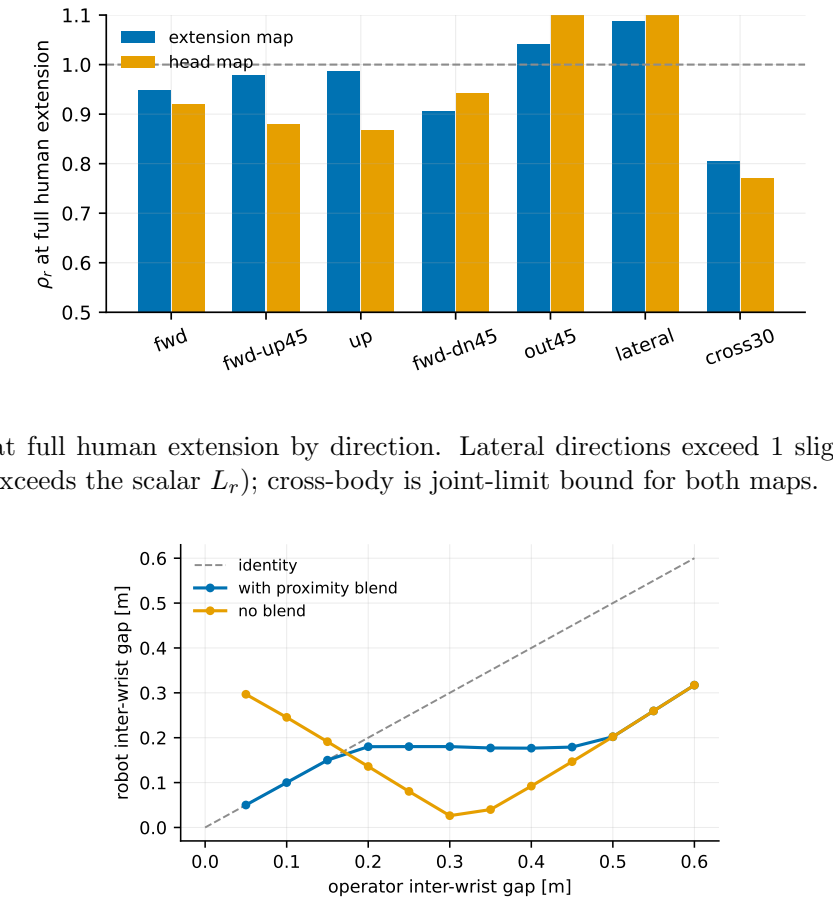
[picture p66: figure]
fwd; fwd-up45; fwd-dn45; out45; lateral; cross30; r at full human e; xtension; extension map head map; operator inter-wrist gap [m]; robot inter-wrist gap [m]; identity with proximity blend no blend

Figure 4: ρr at full human extension by direction. Lateral directions exceed 1 slightly (the true lateral reach exceeds the scalar Lr); cross-body is joint-limit bound for both maps.

Figure 5: Bimanual closure: robot inter-wrist gap vs the operator’s, with and without the proximity correction.

robot frame). The shipped box law is

qtorso = q0 − kt db

clip(d, −bback, bfwd), δ
, | kt = 2.5, bfwd = 0.18, δ = 0.06, | (23)

(db the soft deadband), which saturates at kt(bfwd−δ) = 0.30 rad (17◦ ) however deep the bend, on a joint that reaches 60◦
. On a live Vision Pro take the torso sat at exactly −0.300 while the operator’s head went 0.23 m forward and 0.15 m down (web gui/retarget lab/docs/retarget lab.pdf, E5). The angle law (TORSO LEAN MODE=angle) reads the trunk pitch from a hip-pivot model of length L (0.70 m, hip to eyes): a pitch θ moves the head Lsin θ forward and L(1 − cos θ) down, so
θd = atan2(d, L − h), | θh = arccos(1 − h/L), | θ = max

θd, min(θh, arcsin(d/Lmin)) , (24)

and qtorso = clip(q0−kθ db(θ, δθ)) with kθ = 1, δθ = 0.08 rad. The forward reading is robust for small leans; the drop reading carries deep bends, in which the neck and lower spine also flex and the head falls further than a rigid hip pivot predicts (measured: θd = 22◦

, θh = 38◦
); the cap arcsin(d/Lmin), Lmin = 0.35 m, makes a squat (drop with no forward travel) a lift motion rather than a bend. Two couplings follow from the model: in GLOBAL scope the base walks only on the forward travel a

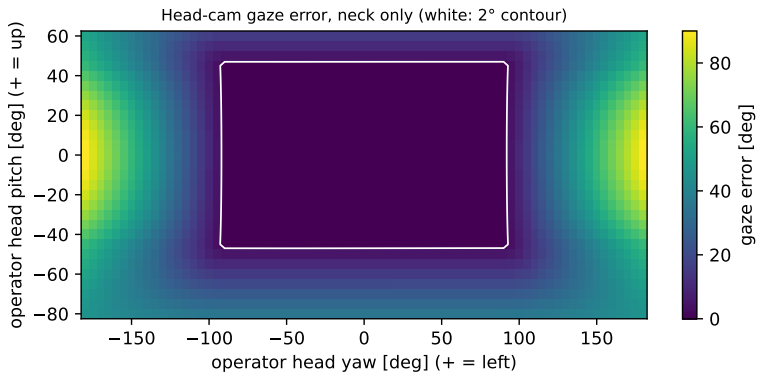
[picture p67: figure]
operator head yaw [deg] (+ = left); operator head pitch [deg] (+ = up); gaze error [deg]

Head-cam gaze error, neck only (white: 2° contour)

Figure 6: Head-camera gaze error over operator head yaw × pitch, neck only. The white contour

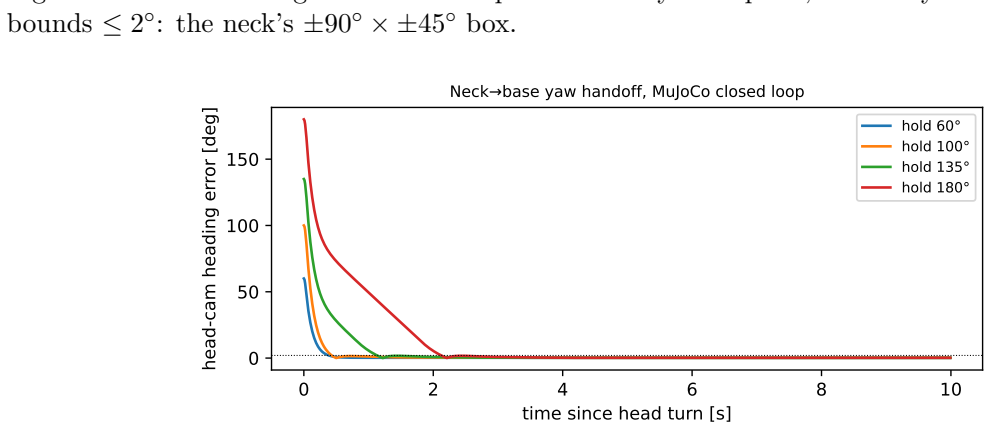
[picture p68: figure]
bounds ≤ 2; : the neck’s ±90◦ × ±45◦ box.; time since head turn [s]; head-cam heading error [deg]; hold 60° hold 100° hold 135° hold 180°

Neck base yaw handoff, MuJoCo closed loop

Figure 7: Neck→base yaw handoff in MuJoCo: heading error after the operator turns and holds the head. Dotted line: 2◦

bend does not explain, d − clip(d, 0, Lsin θh) (a walk keeps the head level, a bend lowers it); and the lift follows head height plus L(1 − cos θ), since the robot’s own torso bend reproduces that drop. Assumptions: the operator bends at the hips facing forward; a sideways lean or a crouchand-reach violates the model (it degrades to the forward reading). Default box on the robot: a 60◦
real torso lean moves the CoM far forward and must be validated with wbc stability.py first. The Retarget Lab runs angle. Pinned by tests/test torso lean model.py (box saturation as the control, 20/40/55◦ bends, the measured deep bend, squat, walk vs bend in GLOBAL, lift).

## 8 Experiments

claim | source | result
mapping anchors and stays finite; R ∈ SO(3); unit gaze | pytest | pass
neck writes only neck actuators | pytest | pass
followers silent inside the comfort box | pytest (facade e2e) | pass
end-to-end retarget under physics (V3 rig) | exp wbc validation.py | currently failing
per-operator scale recovery | calibration.pdf | Fig. 8

Honesty note: the V3 harness (wbcval retarget.pdf traces) predates an in-flight engine change and fails at its priming assertion (world ref never anchored) independently of the 2026-07 package reorganisation (byte-identical before/after); it needs re-alignment with the engine before its

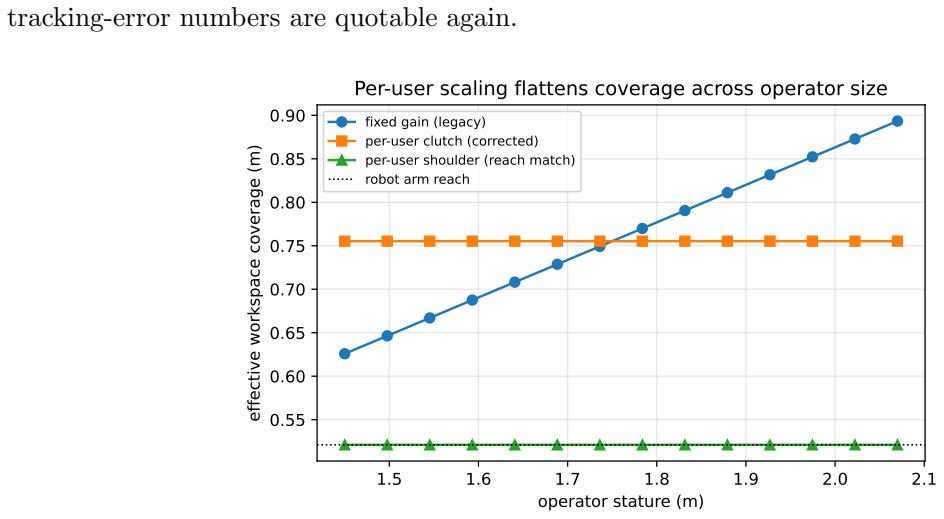
[picture p69: figure]
tracking-error numbers are quotable again.; operator stature (m); effective workspace coverage (m); robot arm reach

Per-user scaling flattens coverage across operator size

fixed gain (legacy) per-user clutch (corrected) per-user shoulder (reach match)

Figure 8: Per-operator workspace-scale recovery (from the calibration pipeline; derivations and full experiments in calibration.pdf).

### 8.1 Operator heading: the lazy-neck model

Both whole-body channels are referred to the operator’s TRUNK heading: the base yaw follows it (GLOBAL scope) and the arm map’s body frame is built on it (ShoulderEstimator, every scope). ARKit measures only the head. The live engine fused head and both wrists (BodyFrameEstimator); on real Vision Pro data (H1, below) it latched 30–75◦ offsets from where the operator faced after a hand-tracking dropout — it re-seeds from its own last state and has no absolute reference — and kept them for tens of seconds.

Model. The head yaw ψh is absolute and drift-free; the neck turns the head relative to the trunk within a comfortable range, and a head held turned means the trunk turned. With trunk estimate ψb and slack β,

e = wrap(ψh − ψb), | ψb ← ψb + sign(e) max(0, |e| − β), | (25)
ein = wrap(ψh − ψb), | ψb ← ψb +

| 1 − e −∆t/τ
g ein, | g = ⊮

|ψ˙

h| < 20◦
/s
, | (26)

with |ψ˙
h| low-passed at 0.15 s. Properties (each a test in tests/test heading and follow.py): (i) |ψb−ψh| ≤ β at every instant; (ii) ψb → ψh exponentially (τ ) whenever the head is held — no offset can persist, which is the defect; (iii) a turn larger than β is followed at once; (iv) a glance that returns within ∼ τ moves ψb by at most (1 − e

−theld/τ ) of it, and not at all while the head moves;
(v) hands are not used, so a hand dropout cannot corrupt it. Output in the engine’s body yaw convention (the robot-frame heading of the body’s right axis, atan2(rx, −ry); π when facing ARKit −z). Assumption and its cost: the trunk eventually faces where the head is held. A seated operator who looks at a side task for several seconds turns the robot.

H1–H3 (experiments/exp heading.py; three live Retarget Lab takes and 96 seated EgoDex clips, every 8th of the corpus). H1 return: the heading error wherever the operator faces their calibration direction again (head within 10◦

, held 3 s). H2 follow: |ψb − ψh| during held turns (> 60◦ , 1 s). H3
seated spread: p95 of |ψb − ψb,0| per clip, where the trunk is fixed by construction and the head looks around (head spread 2.9/12.1◦
, median/p90 clip). The head is the reference only where it is unambiguous: ARKit gives no trunk truth.
H1 return p90 [deg] H1 return p90 | H1 return p90 | H3 seated spread p95 [deg]
estimator | live test1 | walking | rotations | median / p90 clip (worst)
head+wrist (shipped) | 13.3 | 72.7 | 51.0 | 3.1 / 14.4 (82.0)
lazy neck, β = 25◦
, τ = 2 s | 4.7 | 5.0 | 3.5 | 1.6 / 7.7 (23.9)

Table 1: H1/H3. The lazy-neck model against the shipped estimator.

Base follow, 1:1 in the body frame. With BASE TRANSLATION MODE=body the head displacement d (robot frame via AVP TO ROBOT) is rotated into the operator’s current body frame, db = R(−(ψb − π)) d; the comfort box and the lean are read on db; the overflow ob = db − clip(db, box) is rotated out along the robot’s heading, R(ψchassis,0 + ∆ψb) ob, and added to the calibration base pose with gain 1. The shipped law (shipped) used a backward gain of 1.3, a reach multiplier up to 2× and the box in world axes: a lean after a turn read as a sidestep, and an operator not facing ARKit’s −z at calibration walked the robot partly sideways. The base yaw then tracks ψb with no deadband. Measured end to end in the Retarget Lab (its E6): heading p90 72→8

- and position
p90 0.69→0.34 m on the walking take.

Follow rates. The lift target was a per-frame low-pass (frame-rate dependent, ∼60 ms at 60 Hz, unbounded speed); it is now slewed at LIFT FOLLOW SPEED (0.03 m/s) and the torso lean at TORSO FOLLOW SPEED (0.5 rad/s, config.MAX TORSO IK SPEED’s tip-over reason), whenever the engine passes its frame interval. Robot defaults: HEADING MODE=bodyframe, BASE TRANSLATION MODE=shipped (unchanged); the rate limits apply everywhere.
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
