Klajdi00/open_mabel/server/docs/data_collection.pdf

## Imitation-Learning Data Collection for MABEL: A Single-Tap Full-Bus Recorder from rosbag2/MCAP to Rerun

MABEL project — server/

October 17, 2026

Abstract

This document describes the MABEL data-collection subsystem: the pipeline that captures complete teleoperation demonstrations — robot proprioception, the human operator’s commands, every camera and depth stream, point clouds, the volumetric environment mesh, the 2-D occupancy map, odometry, and the full transform tree — into a single self-describing dataset suitable for learning long-horizon navigation and manipulation policies. A demonstration is started and stopped with one tap in the iOS app; the teleoperation bridge that owns the simulated robot spawns a ros2 bag record child that writes the entire ROS 2 message bus to a rosbag2 / MCAP container on the local host (never pushed to version control). A companion converter replays a bag into a Rerun recording, reconstructing the tf tree as a spatial entity hierarchy so the whole episode — images, depth, clouds, mesh, map, paths, and every joint/command time series — is visualized in one coherent, time-synchronized scene. We document the trigger path, the storage-format rationale, the recorded topic schema, the recorder lifecycle, and the bag-to-Rerun mapping, and we report the current verification state.

Keywords: imitation learning, demonstration recording, rosbag2, MCAP, Rerun, ROS 2, teleoperation, mobile manipulation, navigation, MuJoCo.
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
