Klajdi00/open_mabel/simulation/mabel_mujoco/assets/textures/artdeco.png

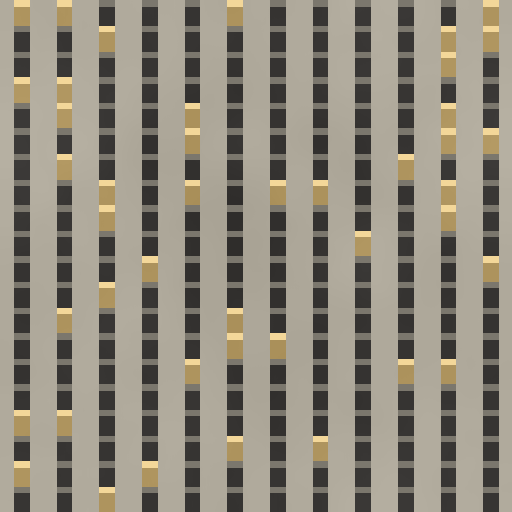
simulation/mabel_mujoco/assets/textures/artdeco.png
