Klajdi00/open_mabel/simulation/mabel_mujoco/assets/textures/asphalt.png

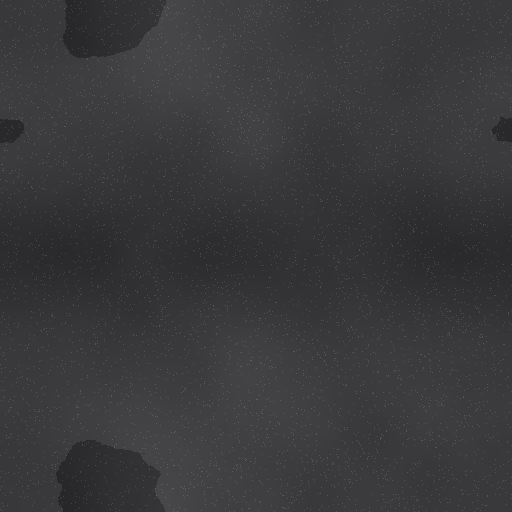
simulation/mabel_mujoco/assets/textures/asphalt.png
