Klajdi00/open_mabel/simulation/mabel_mujoco/assets/textures/awning_green.png

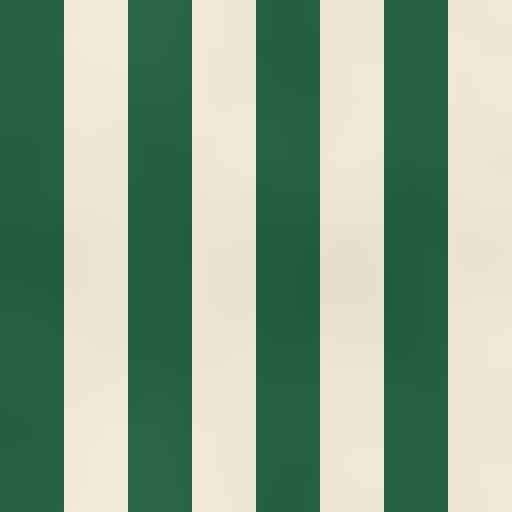
simulation/mabel_mujoco/assets/textures/awning_green.png
