Klajdi00/open_mabel/simulation/mabel_mujoco/assets/textures/bark.png

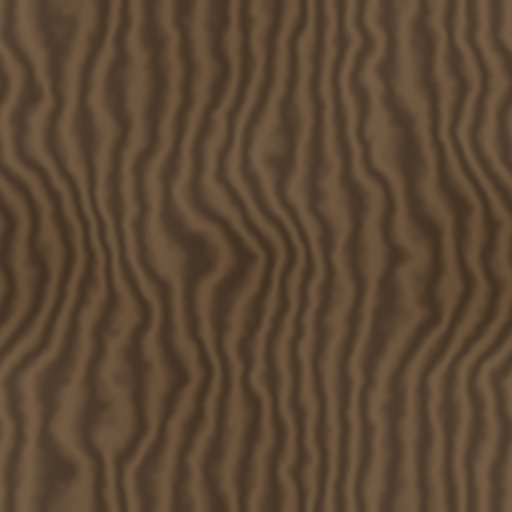
simulation/mabel_mujoco/assets/textures/bark.png
