Klajdi00/open_mabel/simulation/mabel_mujoco/assets/textures/bedding.png

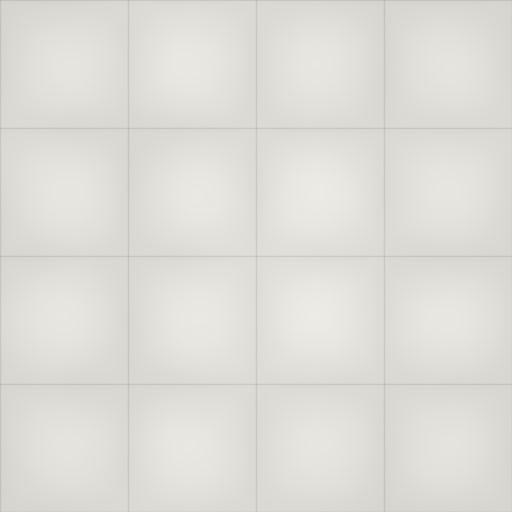
simulation/mabel_mujoco/assets/textures/bedding.png
