Klajdi00/open_mabel/simulation/mabel_mujoco/assets/textures/book_spines.png

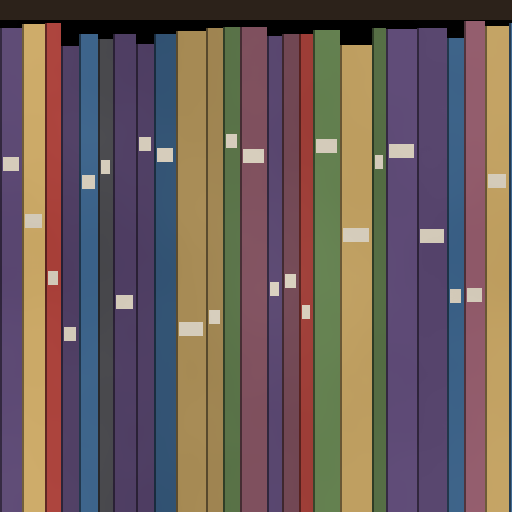
simulation/mabel_mujoco/assets/textures/book_spines.png
