Klajdi00/open_mabel/simulation/mabel_mujoco/assets/textures/brick.png

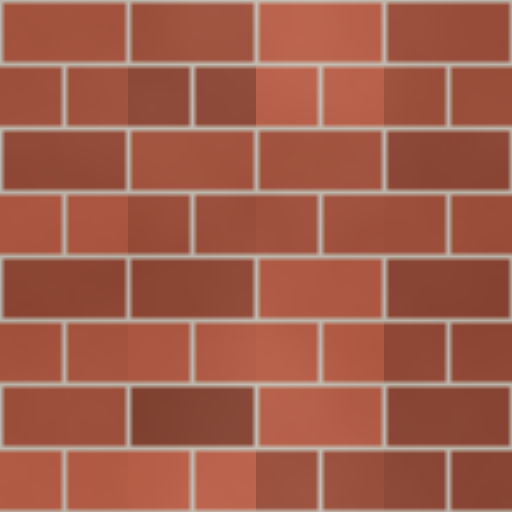
simulation/mabel_mujoco/assets/textures/brick.png
