Klajdi00/open_mabel/simulation/mabel_mujoco/assets/textures/brownstone.png

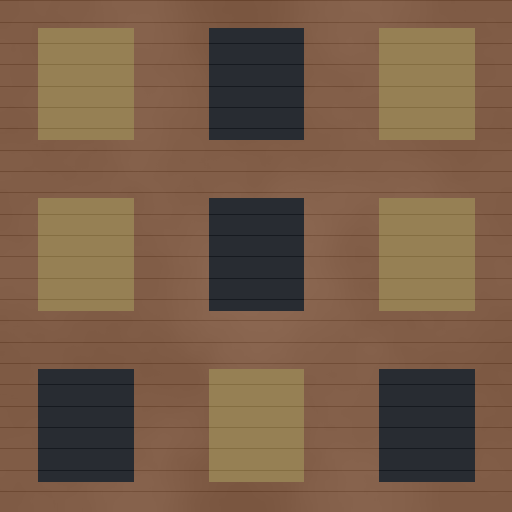
simulation/mabel_mujoco/assets/textures/brownstone.png
