Klajdi00/open_mabel/simulation/mabel_mujoco/assets/textures/cardboard.png

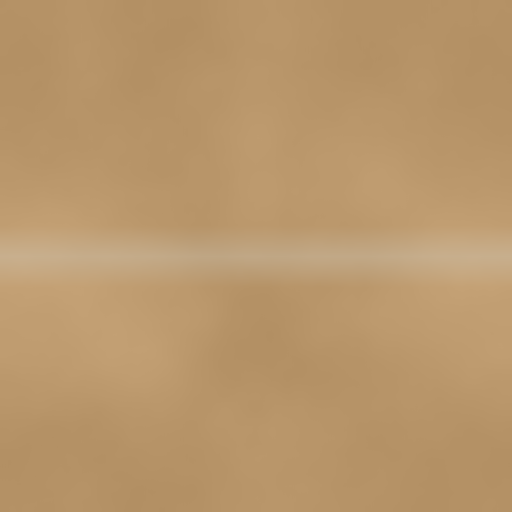
simulation/mabel_mujoco/assets/textures/cardboard.png
