Klajdi00/open_mabel/simulation/mabel_mujoco/assets/textures/carpet_beige.png

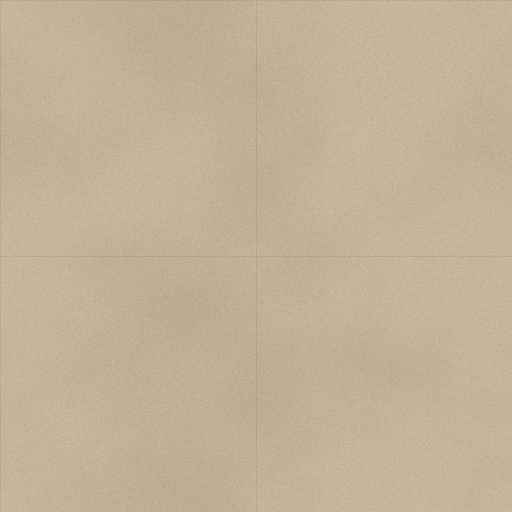
simulation/mabel_mujoco/assets/textures/carpet_beige.png
