Klajdi00/open_mabel/simulation/mabel_mujoco/assets/textures/carpet_gray.png

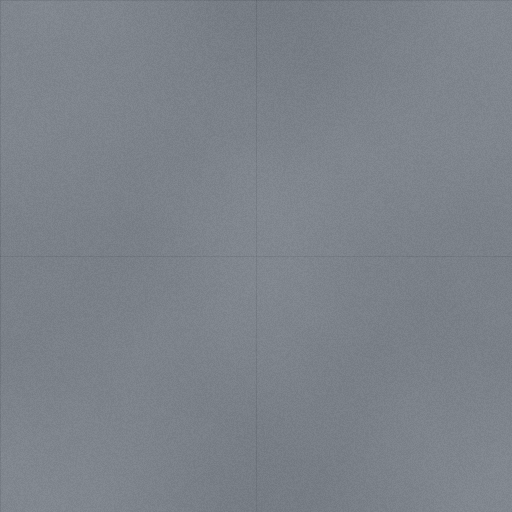
simulation/mabel_mujoco/assets/textures/carpet_gray.png
