Klajdi00/open_mabel/simulation/mabel_mujoco/assets/textures/concrete.png

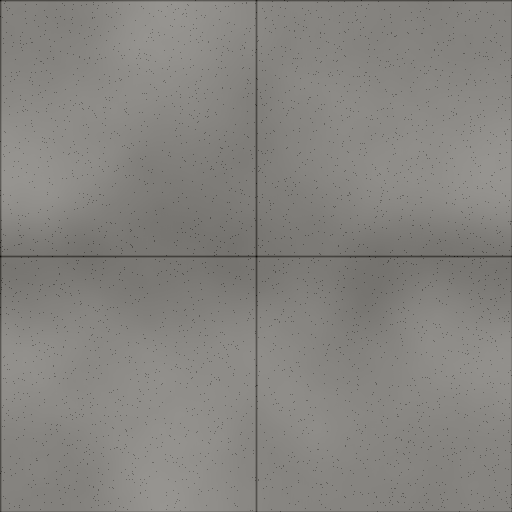
simulation/mabel_mujoco/assets/textures/concrete.png
