Klajdi00/open_mabel/simulation/mabel_mujoco/assets/textures/conveyor.png

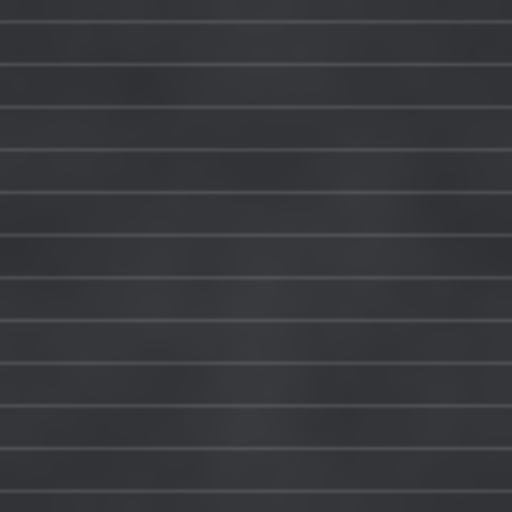
simulation/mabel_mujoco/assets/textures/conveyor.png
