Klajdi00/open_mabel/simulation/mabel_mujoco/assets/textures/curtainwall.png

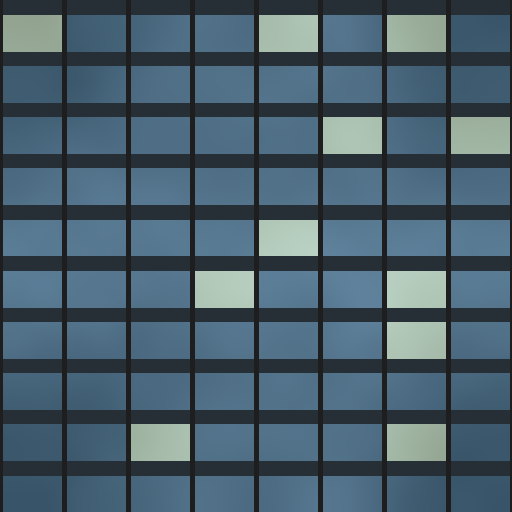
simulation/mabel_mujoco/assets/textures/curtainwall.png
