Klajdi00/open_mabel/simulation/mabel_mujoco/assets/textures/fabric_blue.png

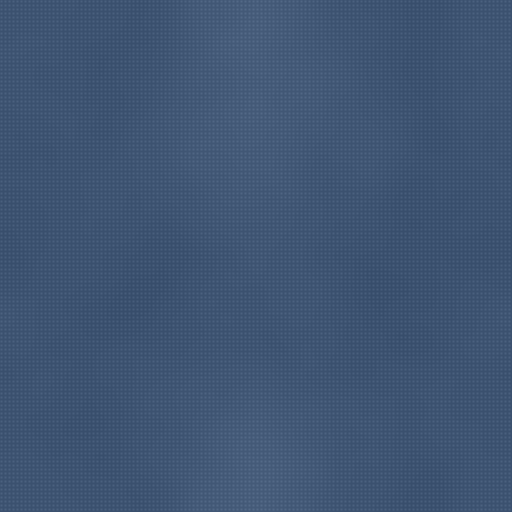
simulation/mabel_mujoco/assets/textures/fabric_blue.png
