Klajdi00/open_mabel/simulation/mabel_mujoco/assets/textures/facade.png

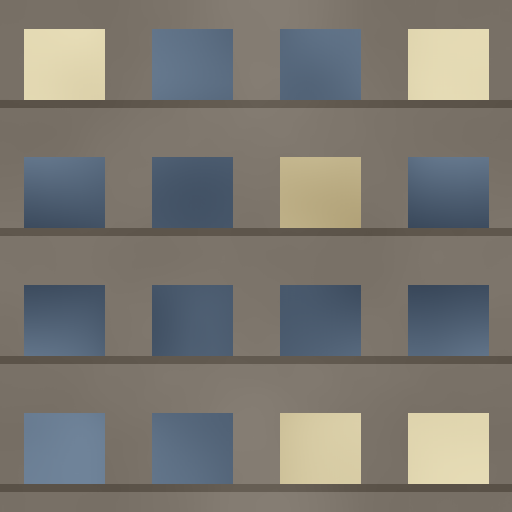
simulation/mabel_mujoco/assets/textures/facade.png
