Klajdi00/open_mabel/simulation/mabel_mujoco/assets/textures/fairway.png

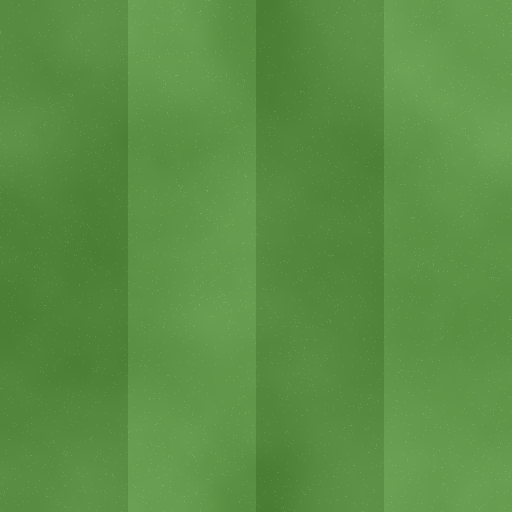
simulation/mabel_mujoco/assets/textures/fairway.png
