Klajdi00/open_mabel/simulation/mabel_mujoco/assets/textures/foliage.png

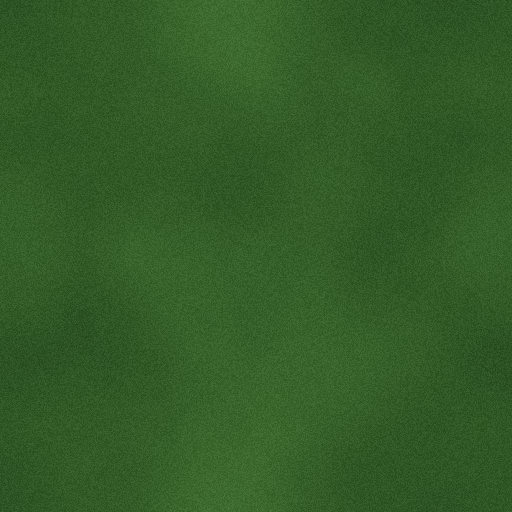
simulation/mabel_mujoco/assets/textures/foliage.png
