Klajdi00/open_mabel/simulation/mabel_mujoco/assets/textures/grass.png

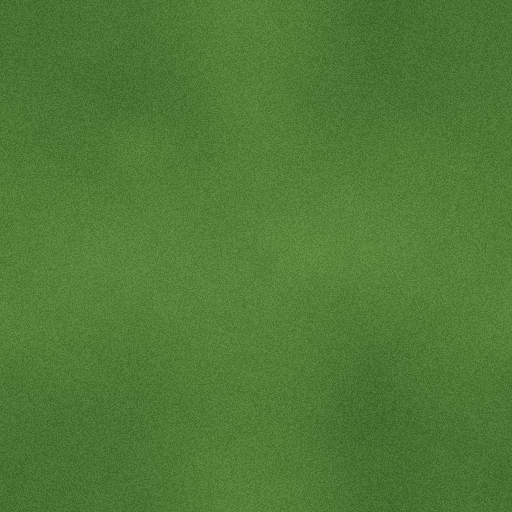
simulation/mabel_mujoco/assets/textures/grass.png
