Klajdi00/open_mabel/simulation/mabel_mujoco/assets/textures/gravel.png

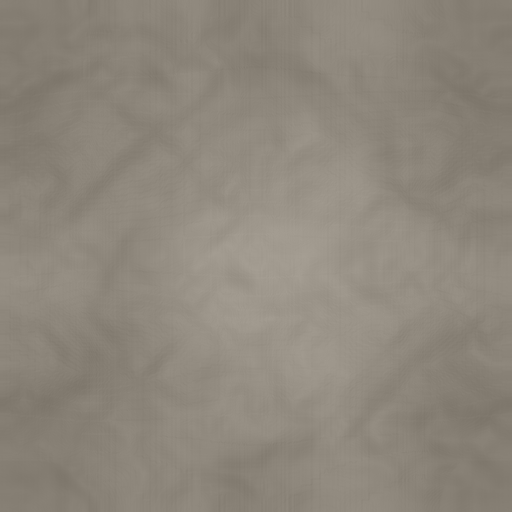
simulation/mabel_mujoco/assets/textures/gravel.png
