Klajdi00/open_mabel/simulation/mabel_mujoco/assets/textures/marble_counter.png

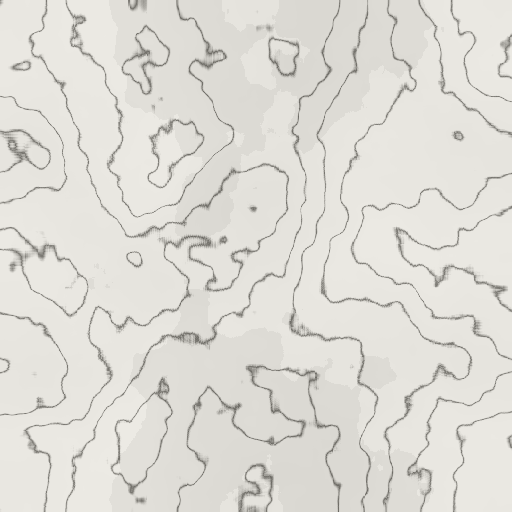
simulation/mabel_mujoco/assets/textures/marble_counter.png
