Klajdi00/open_mabel/simulation/mabel_mujoco/assets/textures/menu_board.png

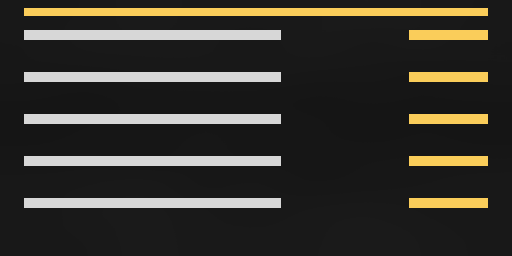
simulation/mabel_mujoco/assets/textures/menu_board.png
