Klajdi00/open_mabel/simulation/mabel_mujoco/assets/textures/metal_brushed.png

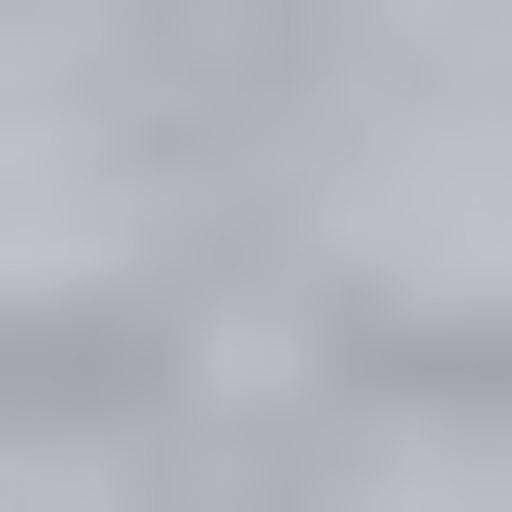
simulation/mabel_mujoco/assets/textures/metal_brushed.png
