Klajdi00/open_mabel/simulation/mabel_mujoco/assets/textures/monitor.png

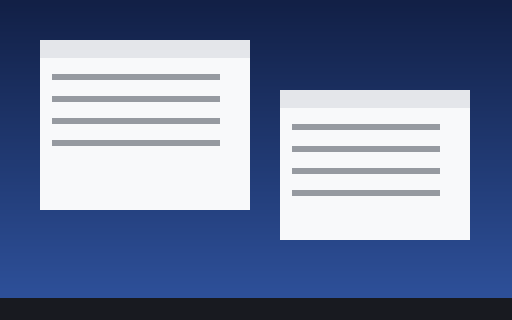
simulation/mabel_mujoco/assets/textures/monitor.png
