Klajdi00/open_mabel/simulation/mabel_mujoco/assets/textures/products.png

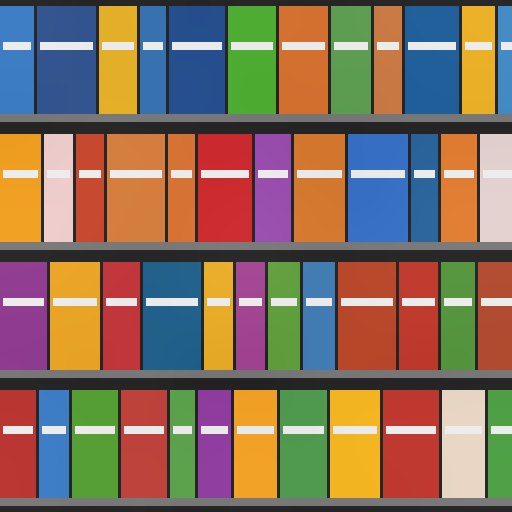
simulation/mabel_mujoco/assets/textures/products.png
