Klajdi00/open_mabel/simulation/mabel_mujoco/assets/textures/rubber_floor.png

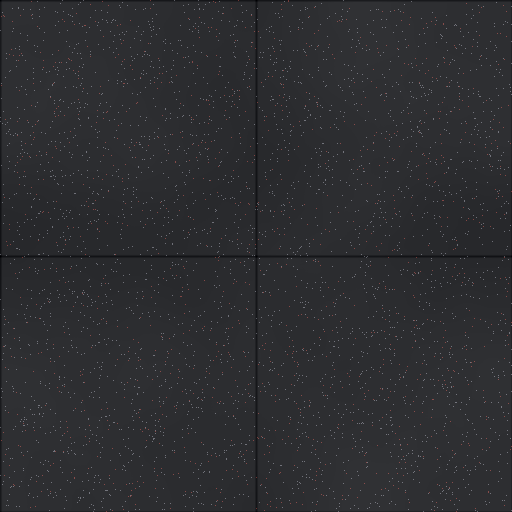
simulation/mabel_mujoco/assets/textures/rubber_floor.png
