Klajdi00/open_mabel/simulation/mabel_mujoco/assets/textures/rug.png

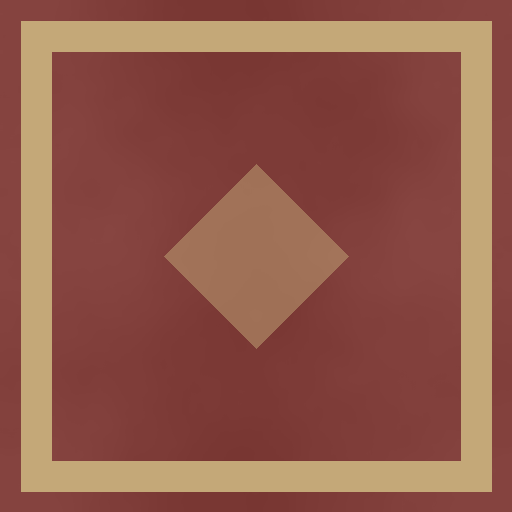
simulation/mabel_mujoco/assets/textures/rug.png
