Klajdi00/open_mabel/simulation/mabel_mujoco/assets/textures/sand.png

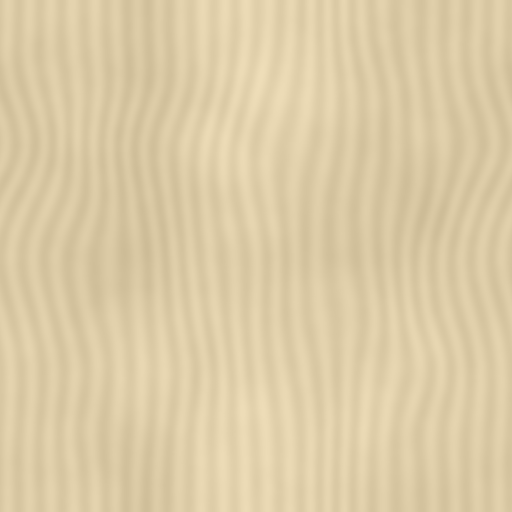
simulation/mabel_mujoco/assets/textures/sand.png
