Klajdi00/open_mabel/simulation/mabel_mujoco/assets/textures/sidewalk.png

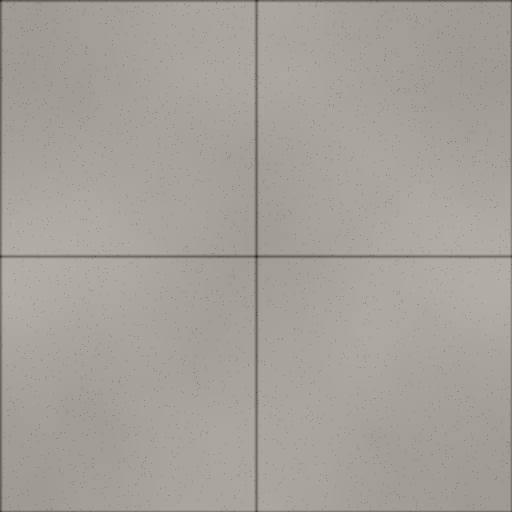
simulation/mabel_mujoco/assets/textures/sidewalk.png
