Klajdi00/open_mabel/simulation/mabel_mujoco/assets/textures/storefront.png

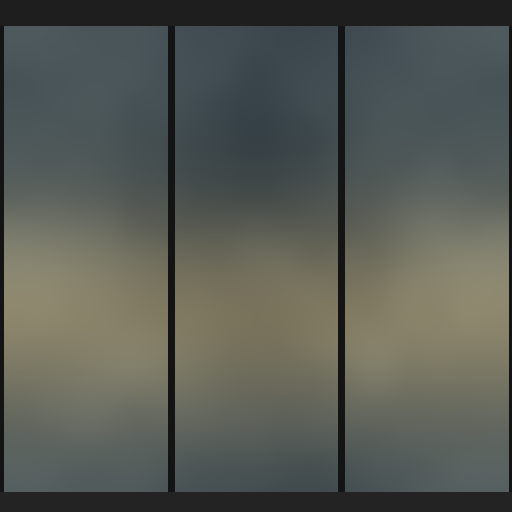
simulation/mabel_mujoco/assets/textures/storefront.png
