Klajdi00/open_mabel/simulation/mabel_mujoco/assets/textures/tile.png

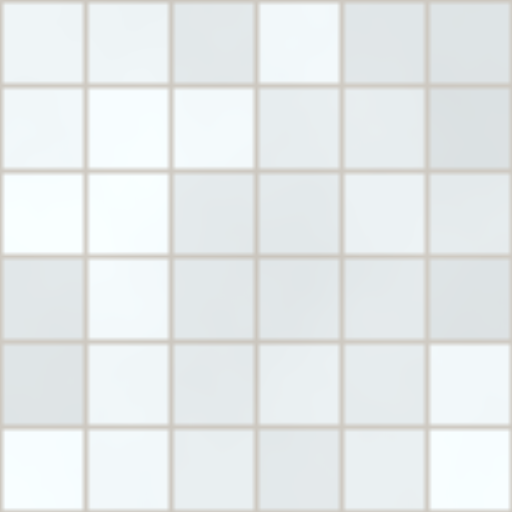
simulation/mabel_mujoco/assets/textures/tile.png
