Klajdi00/open_mabel/simulation/mabel_mujoco/assets/textures/tile_checker.png

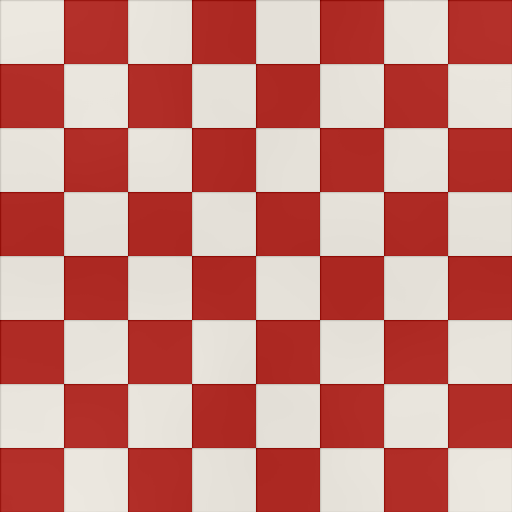
simulation/mabel_mujoco/assets/textures/tile_checker.png
