Klajdi00/open_mabel/simulation/mabel_mujoco/assets/textures/tile_small.png

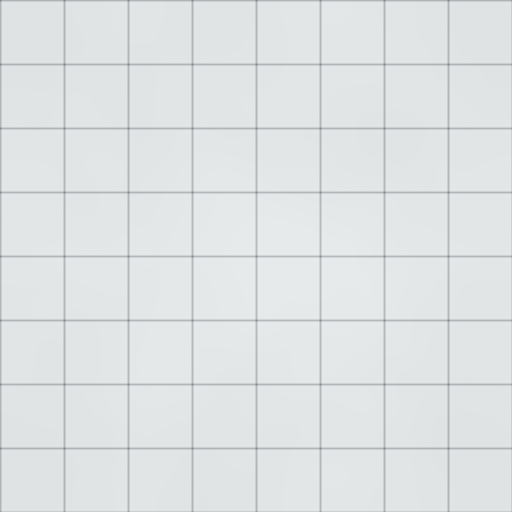
simulation/mabel_mujoco/assets/textures/tile_small.png
