Klajdi00/open_mabel/simulation/mabel_mujoco/assets/textures/wall.png

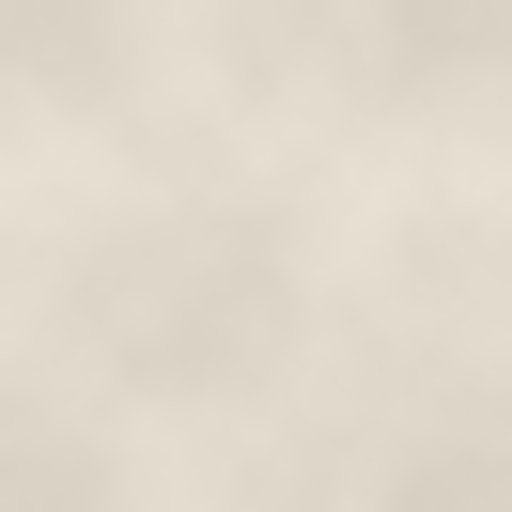
simulation/mabel_mujoco/assets/textures/wall.png
