Klajdi00/open_mabel/simulation/mabel_mujoco/assets/textures/water.png

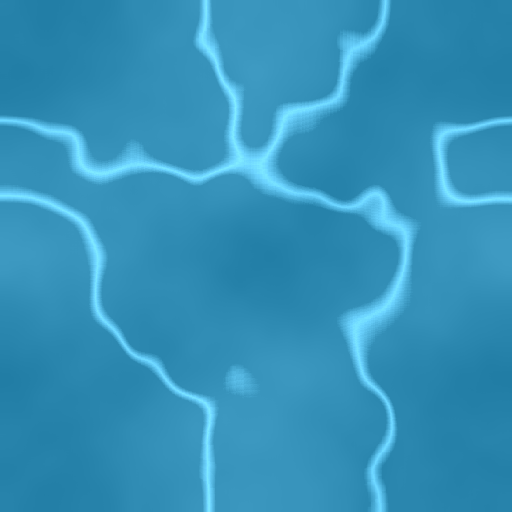
simulation/mabel_mujoco/assets/textures/water.png
