Klajdi00/open_mabel/simulation/mabel_mujoco/assets/textures/whiteboard.png

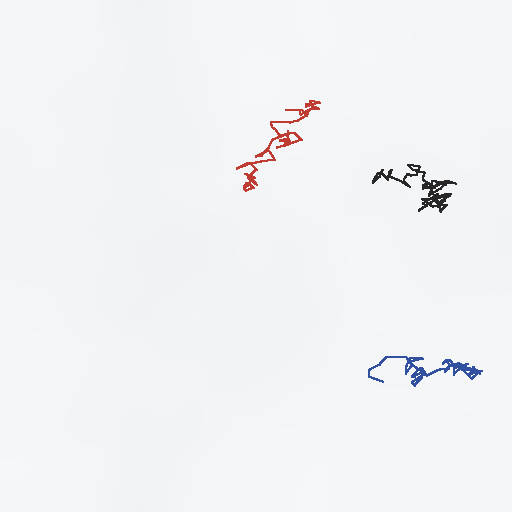
simulation/mabel_mujoco/assets/textures/whiteboard.png
