Klajdi00/open_mabel/simulation/mabel_mujoco/assets/textures/wood_floor.png

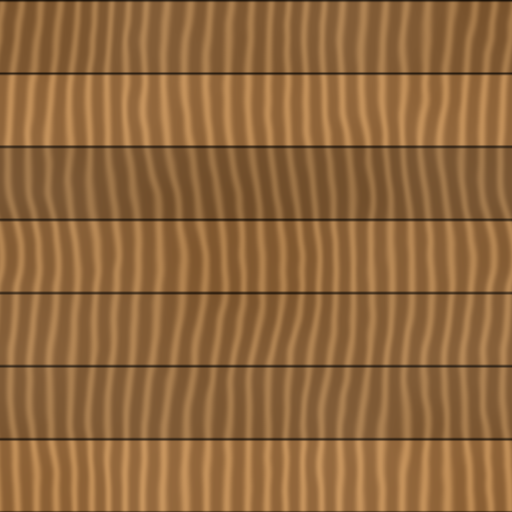
simulation/mabel_mujoco/assets/textures/wood_floor.png
