Klajdi00/open_mabel/simulation/mabel_mujoco/assets/textures/wood_furniture.png

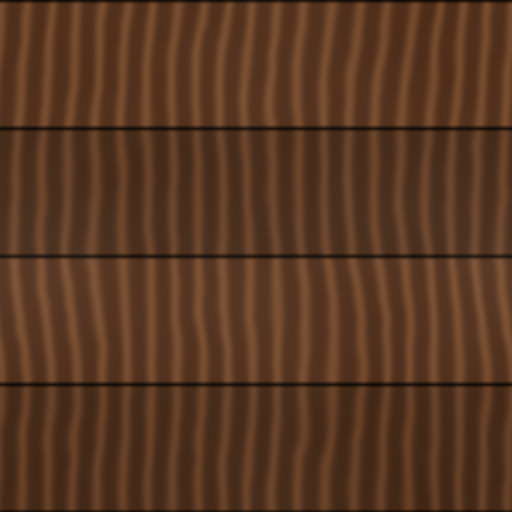
simulation/mabel_mujoco/assets/textures/wood_furniture.png
