Klajdi00/open_mabel/simulation/mabel_mujoco/scenes/thumbs/.small/airport.jpg

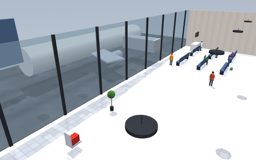
simulation/mabel_mujoco/scenes/thumbs/.small/airport.jpg
