Klajdi00/open_mabel/simulation/mabel_mujoco/scenes/thumbs/.small/bedroom.jpg

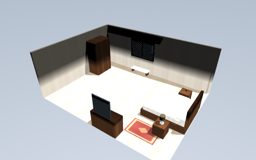
simulation/mabel_mujoco/scenes/thumbs/.small/bedroom.jpg
