Klajdi00/open_mabel/simulation/mabel_mujoco/scenes/thumbs/.small/boulevard.jpg

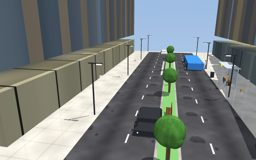
simulation/mabel_mujoco/scenes/thumbs/.small/boulevard.jpg
