Klajdi00/open_mabel/simulation/mabel_mujoco/scenes/thumbs/.small/cafe.jpg

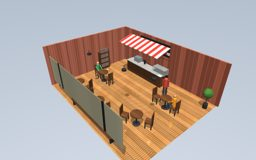
simulation/mabel_mujoco/scenes/thumbs/.small/cafe.jpg
