Klajdi00/open_mabel/simulation/mabel_mujoco/scenes/thumbs/.small/cafe_industrial.jpg

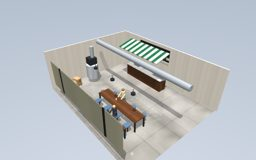
simulation/mabel_mujoco/scenes/thumbs/.small/cafe_industrial.jpg
