Klajdi00/open_mabel/simulation/mabel_mujoco/scenes/thumbs/.small/city_sidewalk.jpg

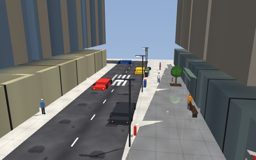
simulation/mabel_mujoco/scenes/thumbs/.small/city_sidewalk.jpg
