Klajdi00/open_mabel/simulation/mabel_mujoco/scenes/thumbs/.small/factory.jpg

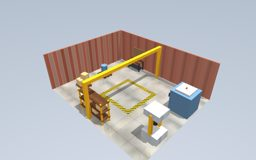
simulation/mabel_mujoco/scenes/thumbs/.small/factory.jpg
