Klajdi00/open_mabel/simulation/mabel_mujoco/scenes/thumbs/.small/fastfood.jpg

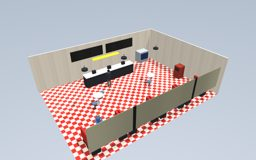
simulation/mabel_mujoco/scenes/thumbs/.small/fastfood.jpg
