Klajdi00/open_mabel/simulation/mabel_mujoco/scenes/thumbs/.small/fine_dining.jpg

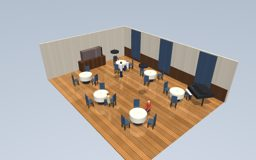
simulation/mabel_mujoco/scenes/thumbs/.small/fine_dining.jpg
