Klajdi00/open_mabel/simulation/mabel_mujoco/scenes/thumbs/.small/front_yard.jpg

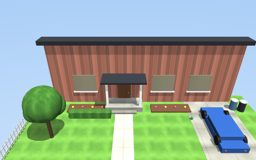
simulation/mabel_mujoco/scenes/thumbs/.small/front_yard.jpg
