Klajdi00/open_mabel/simulation/mabel_mujoco/scenes/thumbs/.small/full_house.jpg

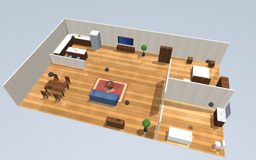
simulation/mabel_mujoco/scenes/thumbs/.small/full_house.jpg
