Klajdi00/open_mabel/simulation/mabel_mujoco/scenes/thumbs/.small/garage.jpg

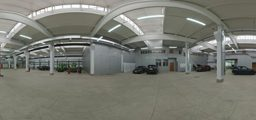
simulation/mabel_mujoco/scenes/thumbs/.small/garage.jpg
