Klajdi00/open_mabel/simulation/mabel_mujoco/scenes/thumbs/.small/golf.jpg

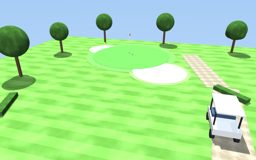
simulation/mabel_mujoco/scenes/thumbs/.small/golf.jpg
