Klajdi00/open_mabel/simulation/mabel_mujoco/scenes/thumbs/.small/gym.jpg

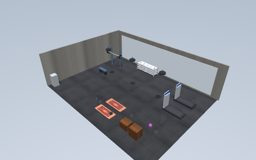
simulation/mabel_mujoco/scenes/thumbs/.small/gym.jpg
