Klajdi00/open_mabel/simulation/mabel_mujoco/scenes/thumbs/.small/home.jpg

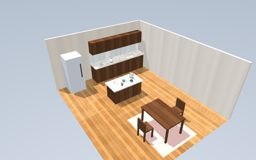
simulation/mabel_mujoco/scenes/thumbs/.small/home.jpg
