Klajdi00/open_mabel/simulation/mabel_mujoco/scenes/thumbs/.small/intersection.jpg

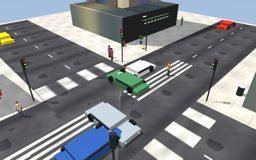
simulation/mabel_mujoco/scenes/thumbs/.small/intersection.jpg
