Klajdi00/open_mabel/simulation/mabel_mujoco/scenes/thumbs/.small/kitchen_fk.jpg

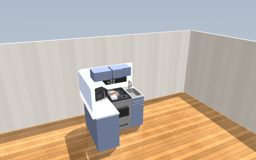
simulation/mabel_mujoco/scenes/thumbs/.small/kitchen_fk.jpg
