Klajdi00/open_mabel/simulation/mabel_mujoco/scenes/thumbs/.small/la_suburb.jpg

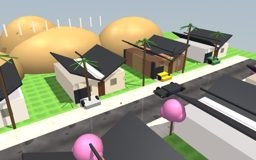
simulation/mabel_mujoco/scenes/thumbs/.small/la_suburb.jpg
