Klajdi00/open_mabel/simulation/mabel_mujoco/scenes/thumbs/.small/living_room.jpg

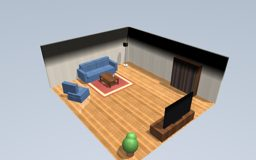
simulation/mabel_mujoco/scenes/thumbs/.small/living_room.jpg
