Klajdi00/open_mabel/simulation/mabel_mujoco/scenes/thumbs/.small/living_room_family.jpg

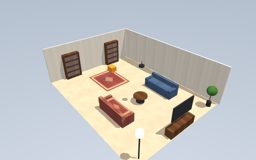
simulation/mabel_mujoco/scenes/thumbs/.small/living_room_family.jpg
