Klajdi00/open_mabel/simulation/mabel_mujoco/scenes/thumbs/.small/loft.jpg

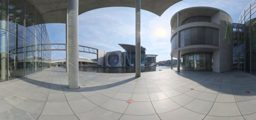
simulation/mabel_mujoco/scenes/thumbs/.small/loft.jpg
