Klajdi00/open_mabel/simulation/mabel_mujoco/scenes/thumbs/.small/manip_table.jpg

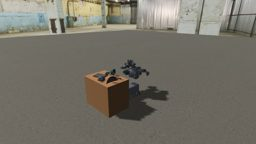
simulation/mabel_mujoco/scenes/thumbs/.small/manip_table.jpg
