Klajdi00/open_mabel/simulation/mabel_mujoco/scenes/thumbs/.small/office.jpg

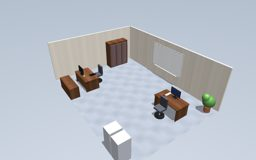
simulation/mabel_mujoco/scenes/thumbs/.small/office.jpg
