Klajdi00/open_mabel/simulation/mabel_mujoco/scenes/thumbs/.small/outdoor.jpg

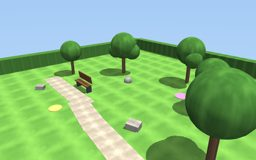
simulation/mabel_mujoco/scenes/thumbs/.small/outdoor.jpg
