Klajdi00/open_mabel/simulation/mabel_mujoco/scenes/thumbs/.small/plaza.jpg

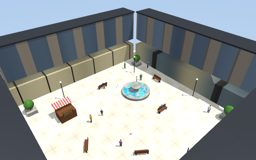
simulation/mabel_mujoco/scenes/thumbs/.small/plaza.jpg
