Klajdi00/open_mabel/simulation/mabel_mujoco/scenes/thumbs/.small/restaurant.jpg

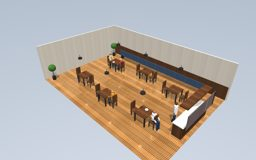
simulation/mabel_mujoco/scenes/thumbs/.small/restaurant.jpg
