Klajdi00/open_mabel/simulation/mabel_mujoco/scenes/thumbs/.small/rooftop_lounge.jpg

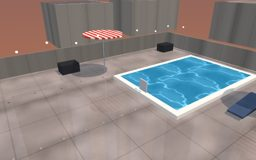
simulation/mabel_mujoco/scenes/thumbs/.small/rooftop_lounge.jpg
