Klajdi00/open_mabel/simulation/mabel_mujoco/scenes/thumbs/.small/street.jpg

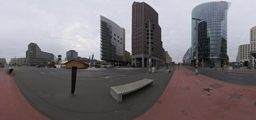
simulation/mabel_mujoco/scenes/thumbs/.small/street.jpg
