Klajdi00/open_mabel/simulation/mabel_mujoco/scenes/thumbs/.small/supermarket.jpg

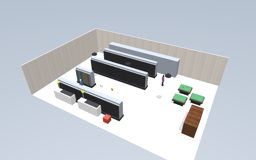
simulation/mabel_mujoco/scenes/thumbs/.small/supermarket.jpg
