Klajdi00/open_mabel/simulation/mabel_mujoco/scenes/thumbs/.small/venice_beach.jpg

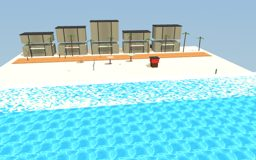
simulation/mabel_mujoco/scenes/thumbs/.small/venice_beach.jpg
