Klajdi00/open_mabel/simulation/mabel_mujoco/scenes/thumbs/.small/warehouse3d.jpg

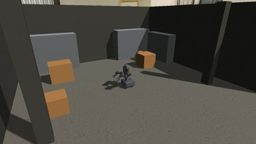
simulation/mabel_mujoco/scenes/thumbs/.small/warehouse3d.jpg
