Klajdi00/open_mabel/simulation/mabel_mujoco/scenes/thumbs/.small/washroom.jpg

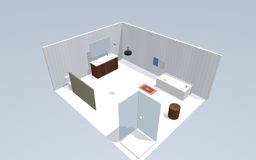
simulation/mabel_mujoco/scenes/thumbs/.small/washroom.jpg
