Klajdi00/open_mabel/simulation/mabel_mujoco/scenes/thumbs/golf.png

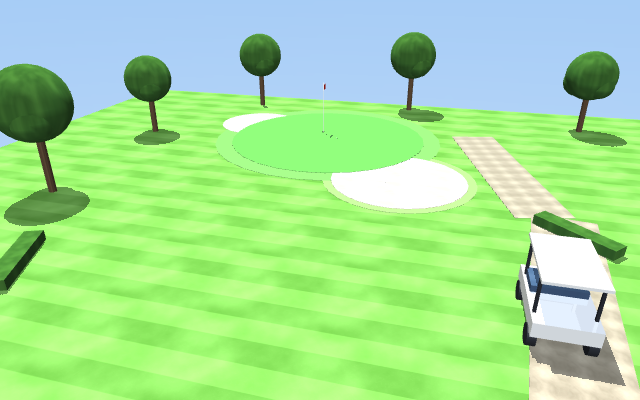
simulation/mabel_mujoco/scenes/thumbs/golf.png
