Klajdi00/open_mabel/simulation/mabel_mujoco/scenes/thumbs/venice_beach.png

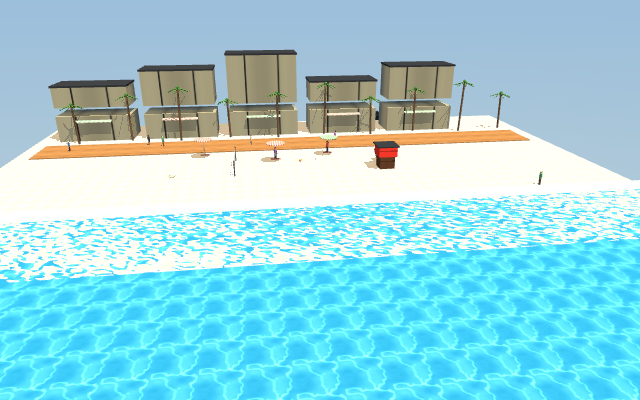
simulation/mabel_mujoco/scenes/thumbs/venice_beach.png
