Klajdi00/open_mabel/simulation/mabel_mujoco/scenes/thumbs/warehouse.png

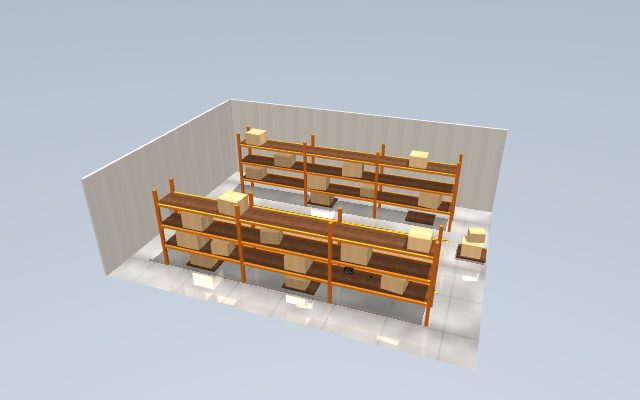
simulation/mabel_mujoco/scenes/thumbs/warehouse.png
