Klajdi00/open_mabel/web_gui/simulation_control_center/docs/figures/retarget_shot_armsup.jpg

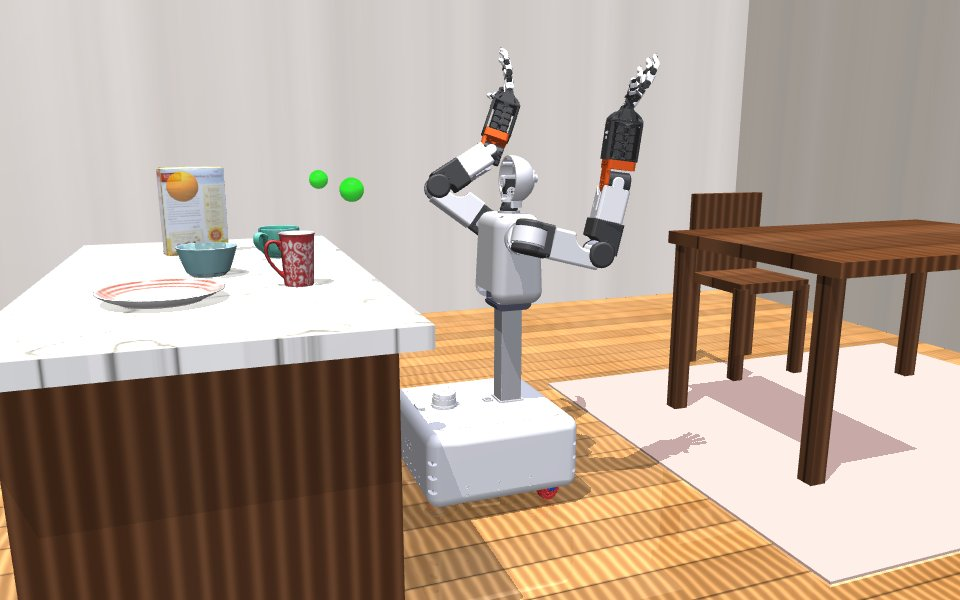
web_gui/simulation_control_center/docs/figures/retarget_shot_armsup.jpg
