Klajdi00/open_mabel/hardware/bom/figures/bom_buildbuy.pdf

0 | 2000 | 4000 | 6000 | 8000
| | USD

MABEL

AgileX PiPER x2

OpenArm 2.0
assembled

OpenArm 2.0 online +
ZED top camera

$2,622

$4,998

$6,480

$7,300

### Arms — both sides

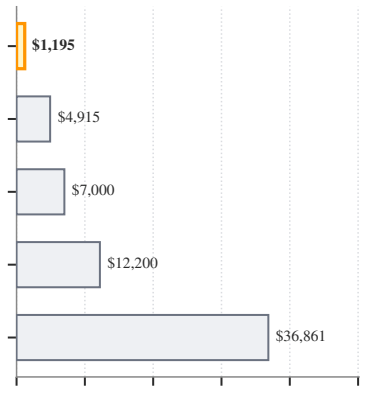
[picture p152: figure]

0 10000 20000 30000 40000 50000 USD

MABEL

ORCA hand

orcahand

orcahand touch

Allegro Hand

### Hands — both sides
