Klajdi00/open_mabel/hardware/bom/figures/bom_functional.pdf

### Where the money goes — Recommended build, $9,283

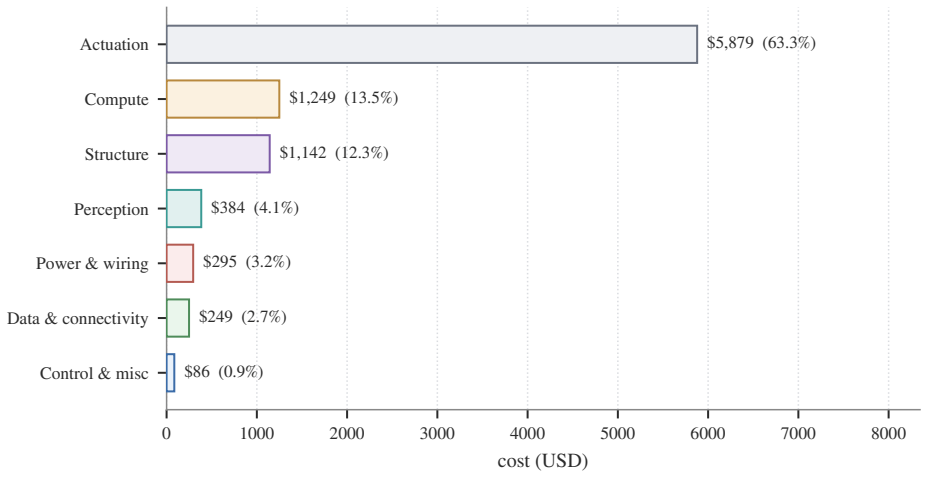
[picture p153: figure]
cost (USD); Control & misc; Data & connectivity; Power & wiring; Perception; Structure; Compute; Actuation
