Klajdi00/open_mabel/hardware/bom/figures/bom_scenarios.pdf

S1
As built

S2
Budget compute

S3
Platform, no
onboard compute

S4
Actuation +
structure only

0

2000

4000

6000

8000

10000

12000

14000

total BOM (USD)

$10k

### Build scenarios

$12,874

$9,624 | $9,375
$7,852
