Klajdi00/open_mabel/hardware/bom/figures/bom_subsystems.pdf

0 | 1000 | 2000 | 3000 | 4000
| | cost (USD)

Structure & fasteners

Head & neck

Electronics & power

Body

Hands

Sensing

Mobile base

Arms

Compute

### MABEL BOM by subsystem — $12,874 as built

$184 (1.4%)

$296 (2.3%)

$611 (4.7%)

$899 (7.0%)

$1,234 (9.6%)

$1,523 (11.8%)

$1,920 (14.9%)

$2,709 (21.0%)

$3,499 (27.2%)
