Klajdi00/open_mabel/hardware/bom/figures/bom_variance.pdf

submitted
sheet

Swerve
modules

Neck
Dynamixel servos

Base
and arm MCUs

Onboard
compute

verified
BOM

0

2000

4000

6000

8000

10000

12000

14000

### total BOM (USD)

## What verification changed

$13,107 | −$352 | +$57 | +$63 | −$1 | $12,874
