Klajdi00/open_mabel/simulation/mabel_mujoco/assets/meshes/hands/left/visual/left_visual_tower_main.stl

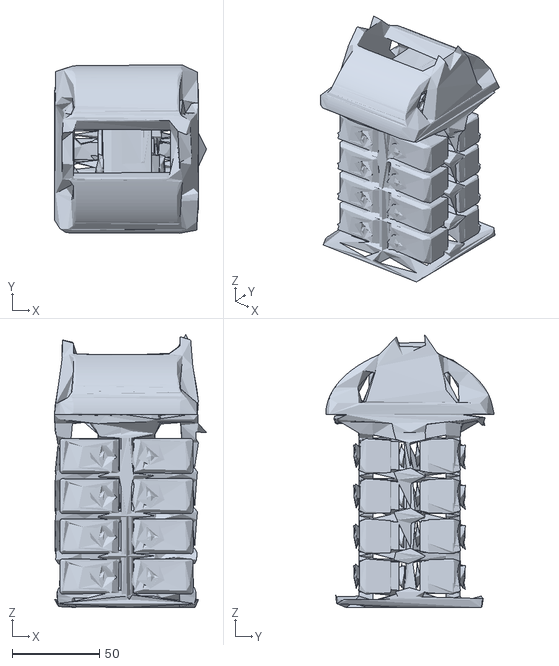
[picture p154: CAD file, 2026-11-04]
simulation/mabel_mujoco/assets/meshes/hands/left/visual/left_visual_tower_main.stl
87.2 x 96.6 x 156.5
