Klajdi00/open_mabel/simulation/mabel_mujoco/assets/meshes/hands/left/collision/left_collision_tower_main.stl

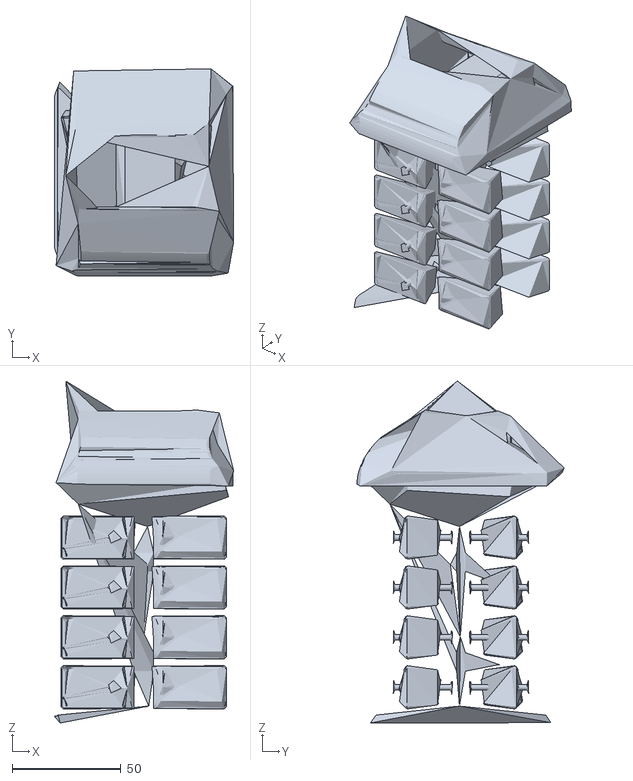
[picture p155: CAD file, 2026-11-04]
simulation/mabel_mujoco/assets/meshes/hands/left/collision/left_collision_tower_main.stl
82.6 x 95.5 x 157.6
