Klajdi00/open_mabel/apps/ios/MABEL Mobile App/Resources/MabelRig/rig_head_mount__v15.ply

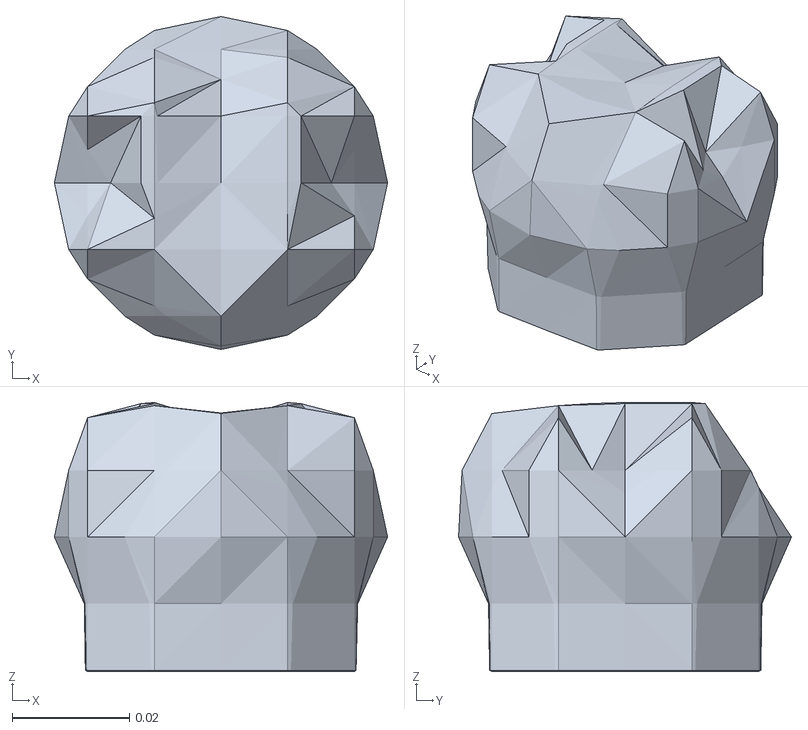
[picture p156: CAD file, 2026-11-04]
apps/ios/MABEL Mobile App/Resources/MabelRig/rig_head_mount__v15.ply
0.057 x 0.0569 x 0.046
