Klajdi00/open_mabel/apps/ios/MABEL Mobile App/Resources/NovaRig/nova_gripper_v1_right_gripper_finger2_47.ply

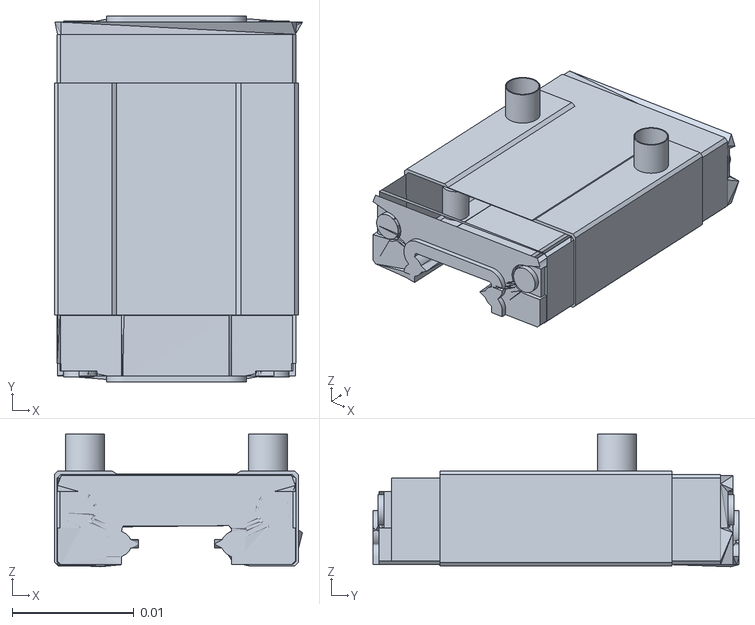
[picture p157: CAD file, 2026-11-04]
apps/ios/MABEL Mobile App/Resources/NovaRig/nova_gripper_v1_right_gripper_finger2_47.ply
0.0203 x 0.03 x 0.0109
