Klajdi00/open_mabel/apps/visionos/MabelTeleop/Resources/NovaRig/nova_gripper_v1_right_gripper_base_43.ply

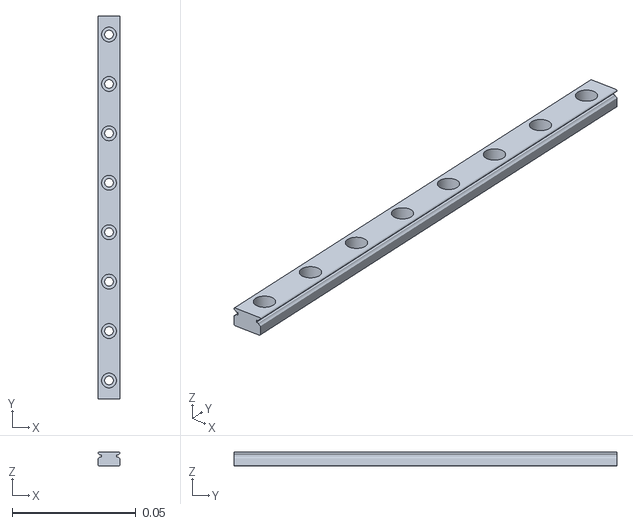
[picture p158: CAD file, 2026-11-04]
apps/visionos/MabelTeleop/Resources/NovaRig/nova_gripper_v1_right_gripper_base_43.ply
0.009 x 0.155 x 0.0055
