Klajdi00/open_mabel/electrical/exports/Motherboard.step

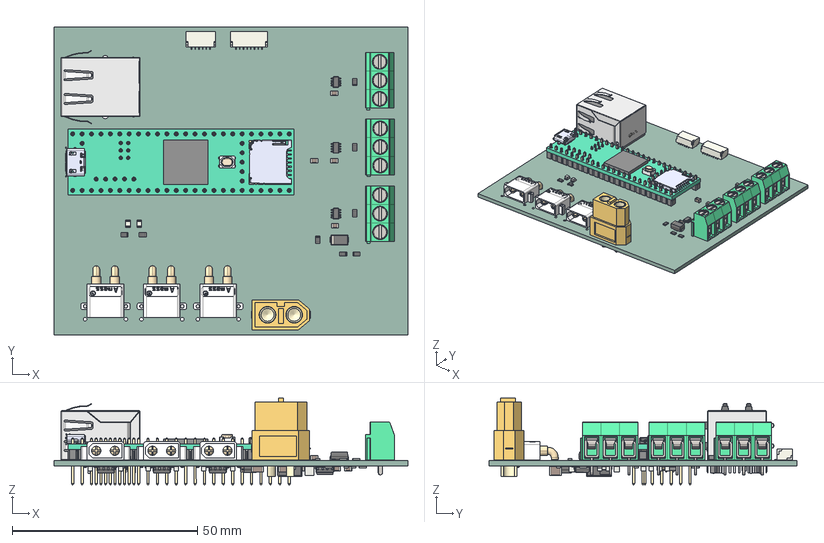
[picture p159: CAD file, 2026-11-04]
electrical/exports/Motherboard.step
95.5 x 83.0 x 23.4 mm
JST_SH_SM06B-SRSS-TB_1x06-1MP_P1.00mm_Horizontal
JST_SH_SM08B-SRSS-TB_1x08-1MP_P1.00mm_Horizontal
TSOT-23-8 x 3
CONN-TH_3P-P5.00_MAX_MX126-5.0-GN01-03P-CU-S-A x 3
CONN-TH_XT30PW-M x 3
C_0805_2012Metric x 19
RJ45-TH_J1B1211CCD
R_0805_2012Metric x 24
DEV-16771
LED_0805_2012Metric x 2
D_SMA x 2
XT60 female v5
C_1206_3216Metric x 3
MP1584EN-LF-P
Crystal_SMD_3215-2Pin_3.2x1.5mm
C_1210_3225Metric
SOIC-8_3.9x4.9mm_P1.27mm x 3
L_APV_APH0630
BNO085
SOT-223
Motherboard_PCB
