Klajdi00/open_mabel/electrical/Motherboard/parts/MP1584EN/MP1584EN.step

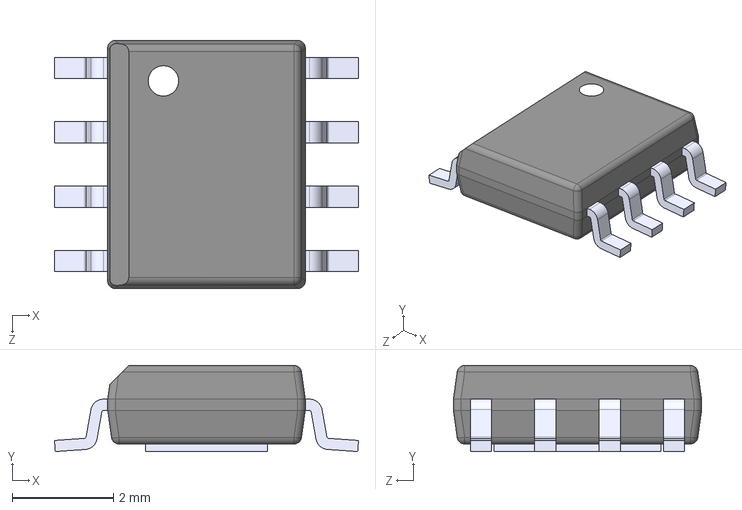
[picture p160: CAD file, 2026-11-04]
electrical/Motherboard/parts/MP1584EN/MP1584EN.step
6.00 x 1.70 x 4.90 mm
