Klajdi00/open_mabel/robot_learning/reinforcement_learning/mjlab/src/mjlab/asset_zoo/robots/i2rt_yam/xmls/assets/model2__12.stl

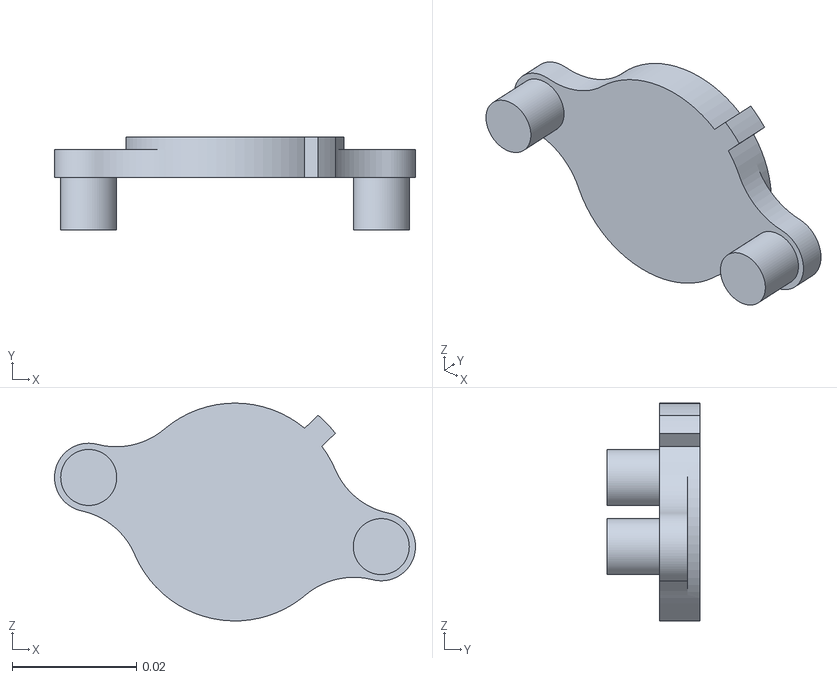
[picture p161: CAD file, 2026-11-04]
robot_learning/reinforcement_learning/mjlab/src/mjlab/asset_zoo/robots/i2rt_yam/xmls/assets/model2__12.stl
0.058 x 0.015 x 0.035
