Klajdi00/open_mabel/robot_learning/reinforcement_learning/mjlab/src/mjlab/asset_zoo/robots/unitree_g1/xmls/assets/left_ankle_roll_link.STL

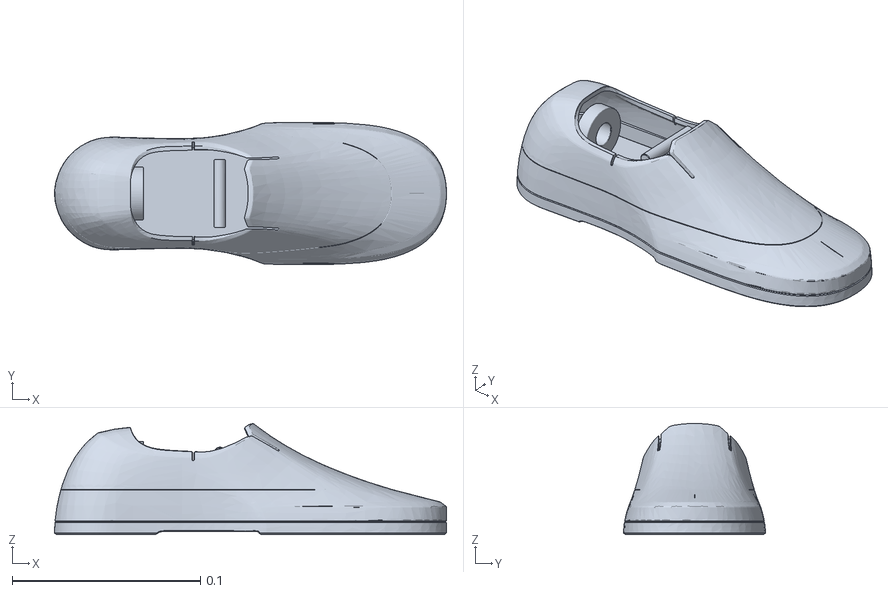
[picture p162: CAD file, 2026-11-04]
robot_learning/reinforcement_learning/mjlab/src/mjlab/asset_zoo/robots/unitree_g1/xmls/assets/left_ankle_roll_link.STL
0.208 x 0.0756 x 0.059
