Klajdi00/open_mabel/robot_learning/reinforcement_learning/mjlab/src/mjlab/asset_zoo/robots/unitree_go1/xmls/assets/trunk.stl

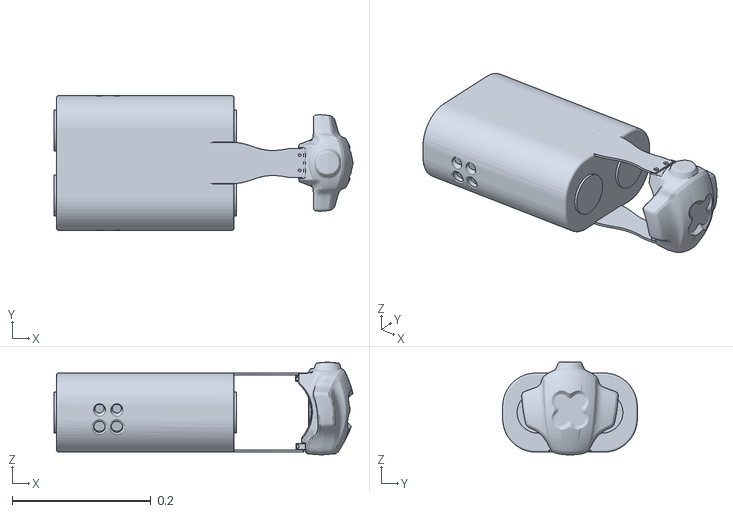
[picture p163: CAD file, 2026-11-04]
robot_learning/reinforcement_learning/mjlab/src/mjlab/asset_zoo/robots/unitree_go1/xmls/assets/trunk.stl
0.431 x 0.194 x 0.134
