Klajdi00/open_mabel/robot_learning/reinforcement_learning/wbc_rl/assets/meshes/openarm_gripper_v1/finger_1.stl

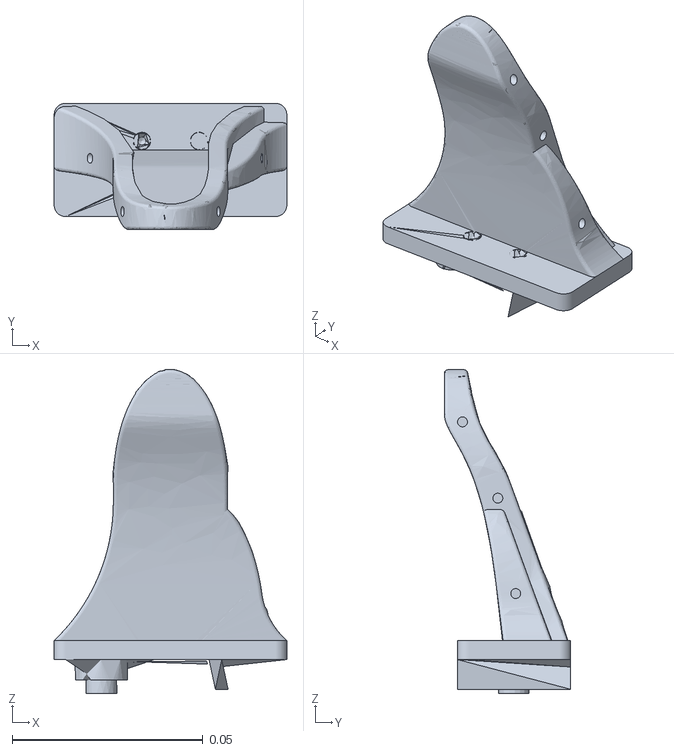
[picture p164: CAD file, 2026-11-04]
robot_learning/reinforcement_learning/wbc_rl/assets/meshes/openarm_gripper_v1/finger_1.stl
0.061 x 0.0332 x 0.0849
