Klajdi00/open_mabel/ros/src/mabel_description/meshes/arms/left/7_linkage_1.stl

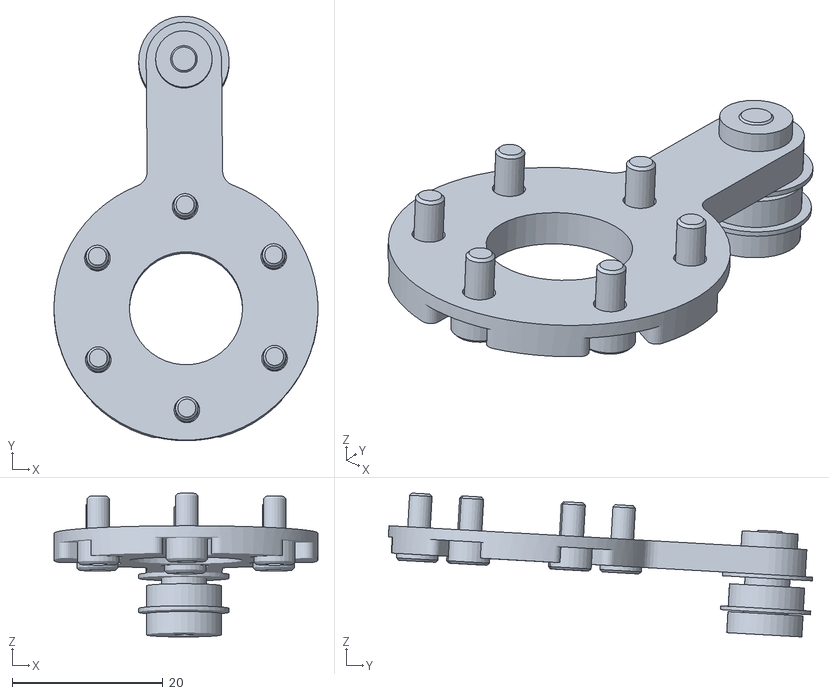
[picture p165: CAD file, 2026-11-04]
ros/src/mabel_description/meshes/arms/left/7_linkage_1.stl
35.0 x 56.3 x 19.1
