Klajdi00/open_mabel/ros/src/mabel_description/meshes/arms/right/3_shoulder_to_elbow.stl

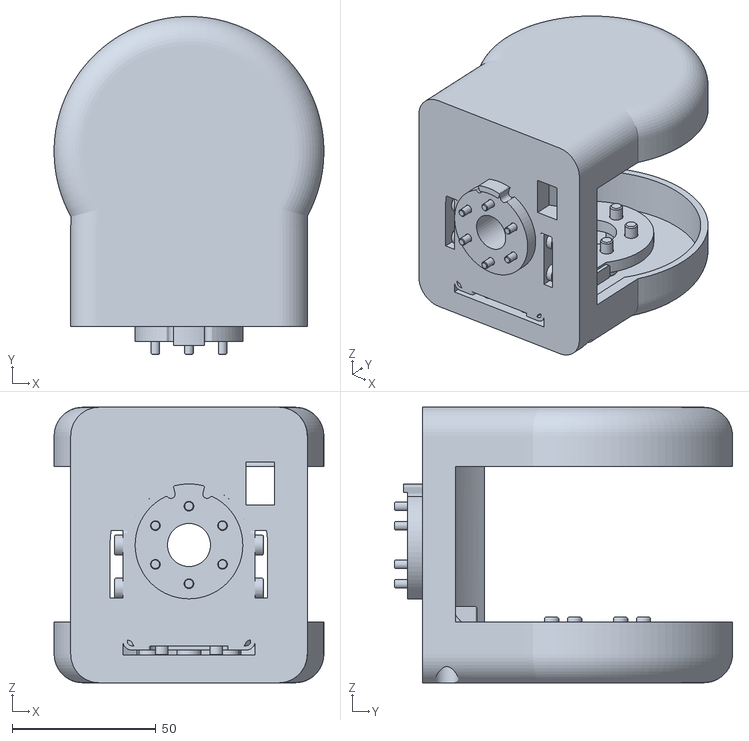
[picture p166: CAD file, 2026-11-04]
ros/src/mabel_description/meshes/arms/right/3_shoulder_to_elbow.stl
94.0 x 117.7 x 96.0
