Klajdi00/open_mabel/ros/src/mabel_description/meshes/base/mobile_base.stl

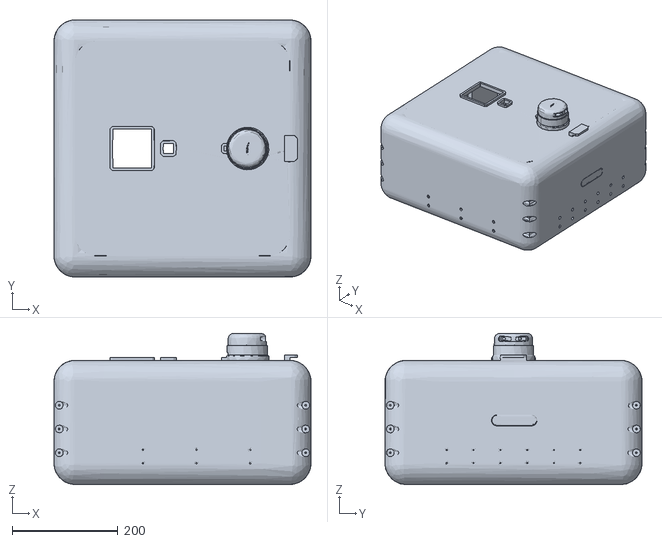
[picture p167: CAD file, 2026-11-04]
ros/src/mabel_description/meshes/base/mobile_base.stl
486.9 x 486.8 x 286.2
