Klajdi00/open_mabel/ros/src/mabel_description/meshes/body/body_link.stl

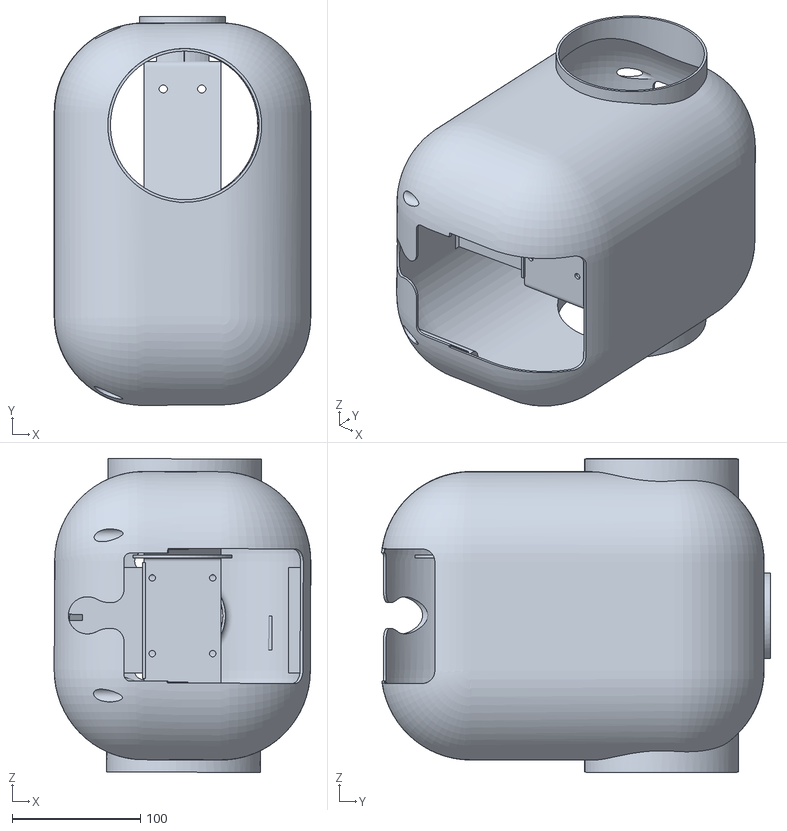
[picture p168: CAD file, 2026-11-04]
ros/src/mabel_description/meshes/body/body_link.stl
200.3 x 303.6 x 245.1
