Klajdi00/open_mabel/ros/src/mabel_description/meshes/hands/left/collision/left_collision_tower_camera.stl

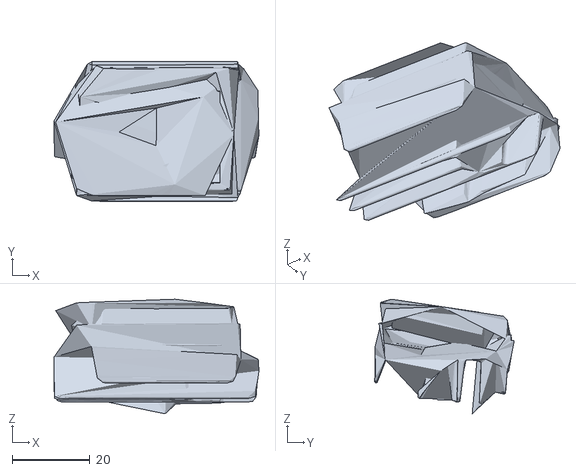
[picture p169: CAD file, 2026-11-04]
ros/src/mabel_description/meshes/hands/left/collision/left_collision_tower_camera.stl
52.6 x 35.9 x 29.4
