Klajdi00/open_mabel/ros/src/mabel_description/meshes/hands/left/visual/left_visual_index_pp_skin.stl

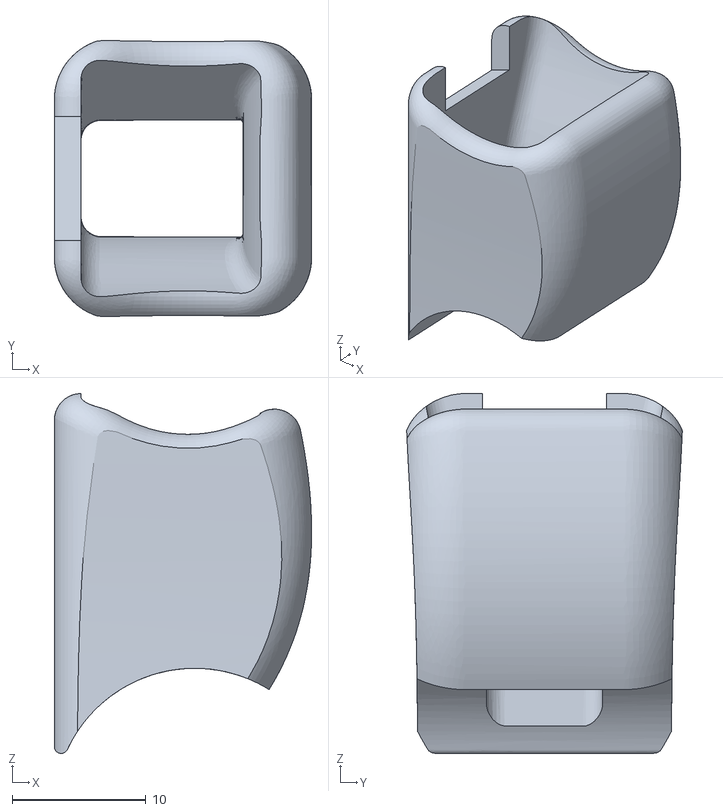
[picture p170: CAD file, 2026-11-04]
ros/src/mabel_description/meshes/hands/left/visual/left_visual_index_pp_skin.stl
19.2 x 20.6 x 26.9
