Klajdi00/open_mabel/ros/src/mabel_description/meshes/hands/right/collision/right_collision_pinky_pp.stl

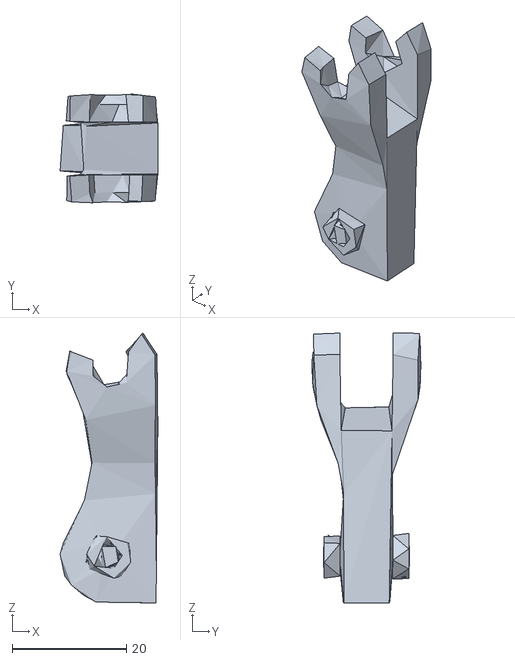
[picture p171: CAD file, 2026-11-04]
ros/src/mabel_description/meshes/hands/right/collision/right_collision_pinky_pp.stl
17.1 x 19.0 x 47.2
