Klajdi00/open_mabel/ros/src/mabel_description/meshes/hands/right/visual/right_visual_middle_ip_skin.stl

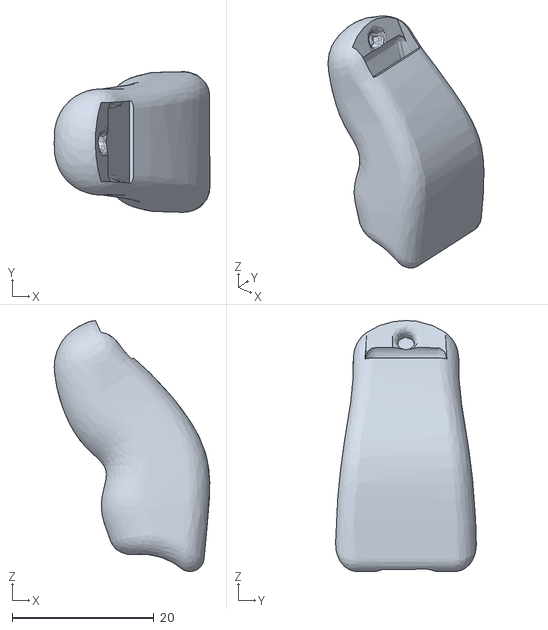
[picture p172: CAD file, 2026-11-04]
ros/src/mabel_description/meshes/hands/right/visual/right_visual_middle_ip_skin.stl
22.0 x 19.9 x 35.5
