Klajdi00/open_mabel/ros/src/mabel_description/meshes/head/3_neck_2.stl

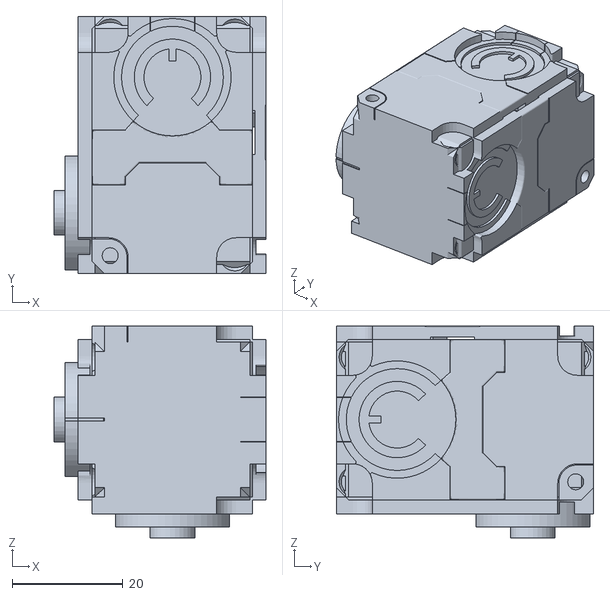
[picture p173: CAD file, 2026-11-04]
ros/src/mabel_description/meshes/head/3_neck_2.stl
38.3 x 46.5 x 38.3
