Klajdi00/open_mabel/ros/src/mabel_description/meshes/lift/lift_mid_link.stl

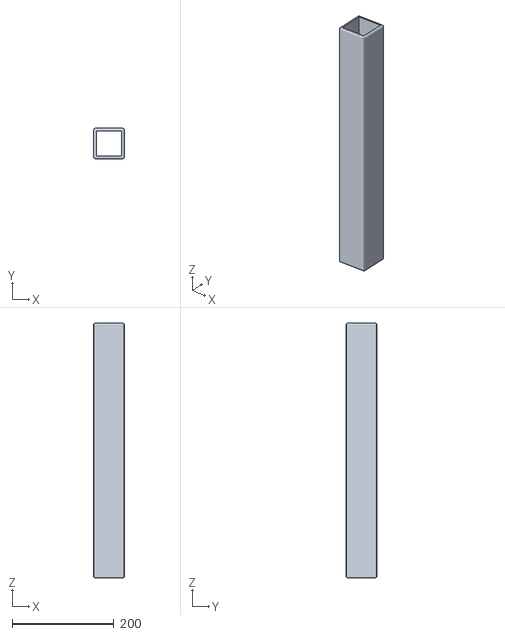
[picture p174: CAD file, 2026-11-04]
ros/src/mabel_description/meshes/lift/lift_mid_link.stl
60.0 x 60.0 x 500.0
