Klajdi00/open_mabel/ros/src/mabel_description/meshes/swerve_drive/drive_motor.stl

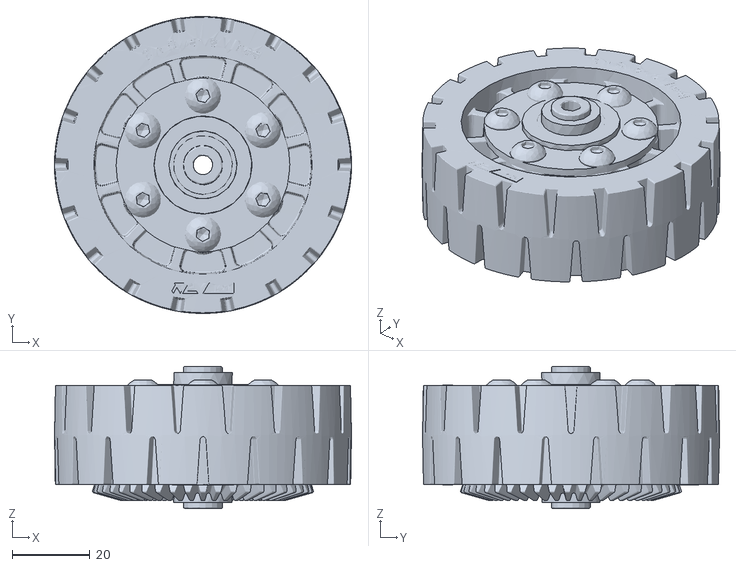
[picture p175: CAD file, 2026-11-04]
ros/src/mabel_description/meshes/swerve_drive/drive_motor.stl
76.2 x 76.2 x 36.5
