Klajdi00/open_mabel/simulation/mabel_mujoco/assets/meshes/arms/left/7_wrist.stl

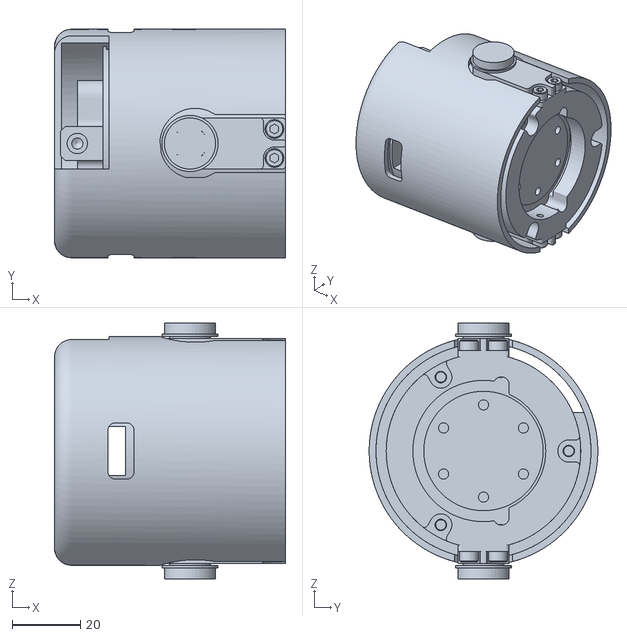
[picture p176: CAD file, 2026-11-04]
simulation/mabel_mujoco/assets/meshes/arms/left/7_wrist.stl
67.7 x 67.0 x 75.0
