Klajdi00/open_mabel/simulation/mabel_mujoco/assets/meshes/arms/right/1_body_to_shoulder.stl

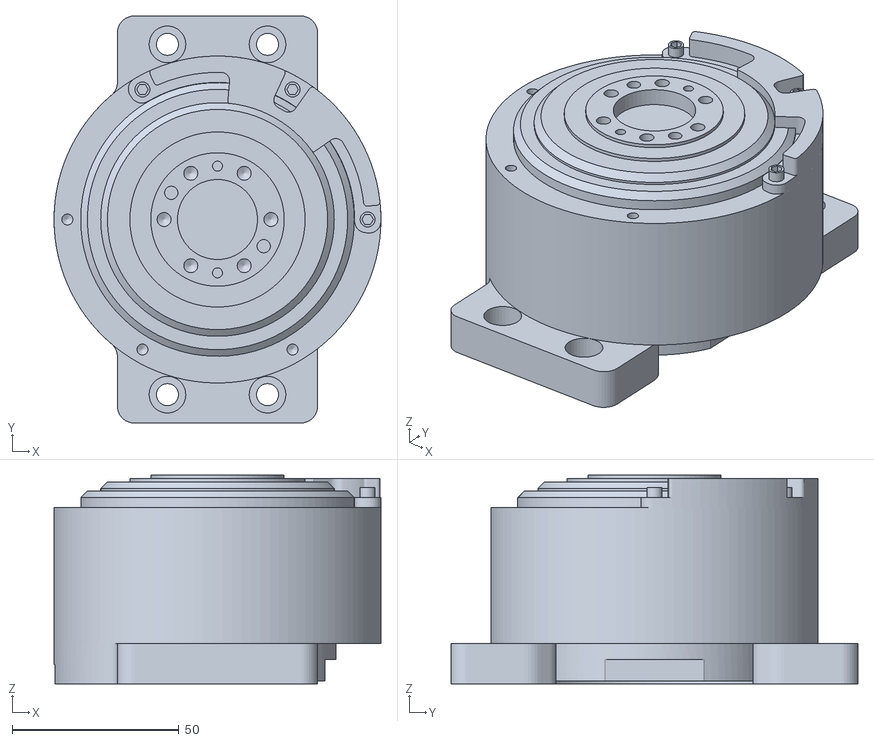
[picture p177: CAD file, 2026-11-04]
simulation/mabel_mujoco/assets/meshes/arms/right/1_body_to_shoulder.stl
98.0 x 122.0 x 62.5
