Klajdi00/open_mabel/simulation/mabel_mujoco/assets/meshes/hands/left/collision/left_collision_index_pp.stl

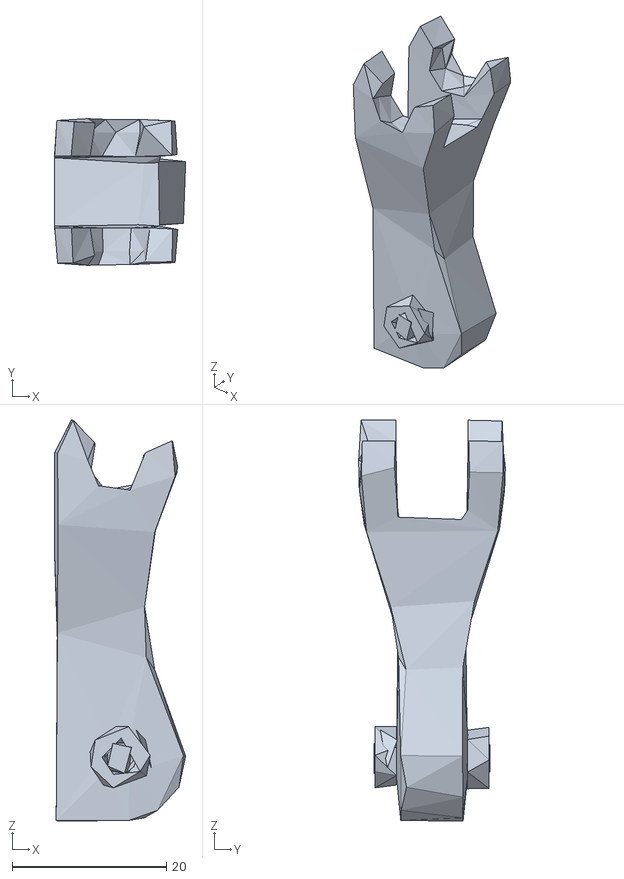
[picture p178: CAD file, 2026-11-04]
simulation/mabel_mujoco/assets/meshes/hands/left/collision/left_collision_index_pp.stl
17.0 x 19.0 x 51.9
