Klajdi00/open_mabel/simulation/mabel_mujoco/assets/meshes/hands/left/visual/left_visual_tower_fans.stl

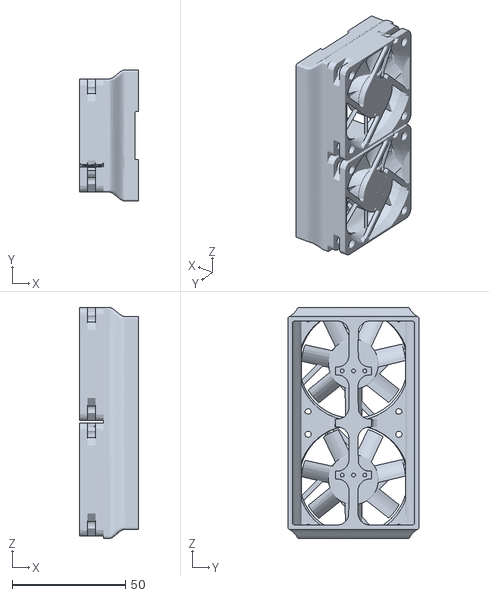
[picture p179: CAD file, 2026-11-04]
simulation/mabel_mujoco/assets/meshes/hands/left/visual/left_visual_tower_fans.stl
26.1 x 58.0 x 102.0
