Klajdi00/open_mabel/simulation/mabel_mujoco/assets/meshes/hands/right/collision/right_collision_palm_skin.stl

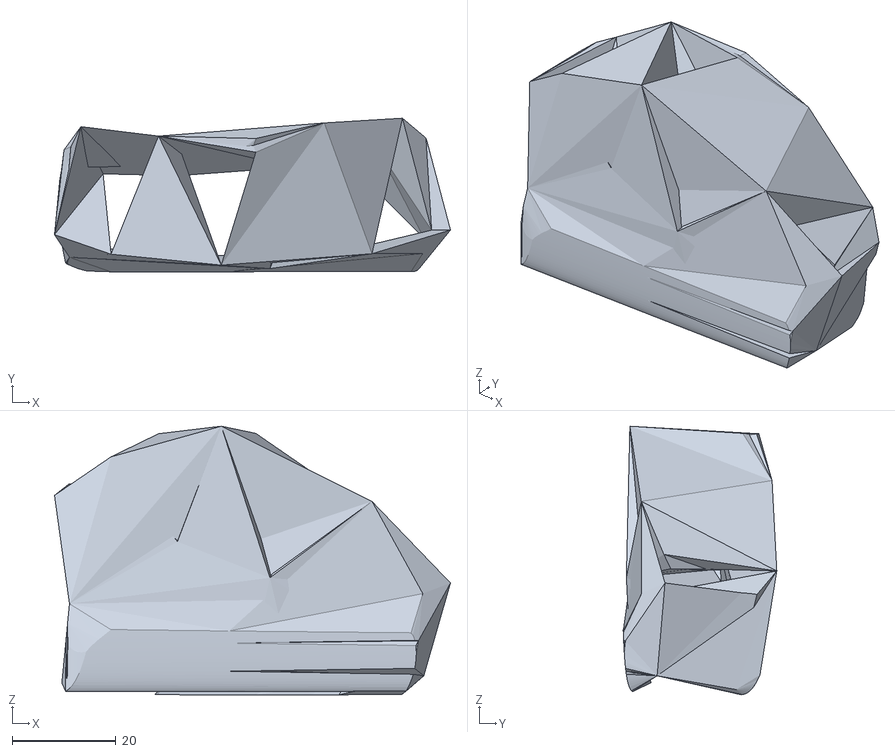
[picture p180: CAD file, 2026-11-04]
simulation/mabel_mujoco/assets/meshes/hands/right/collision/right_collision_palm_skin.stl
76.4 x 29.6 x 51.8
