Klajdi00/open_mabel/simulation/mabel_mujoco/assets/meshes/head/1_body_to_head.stl

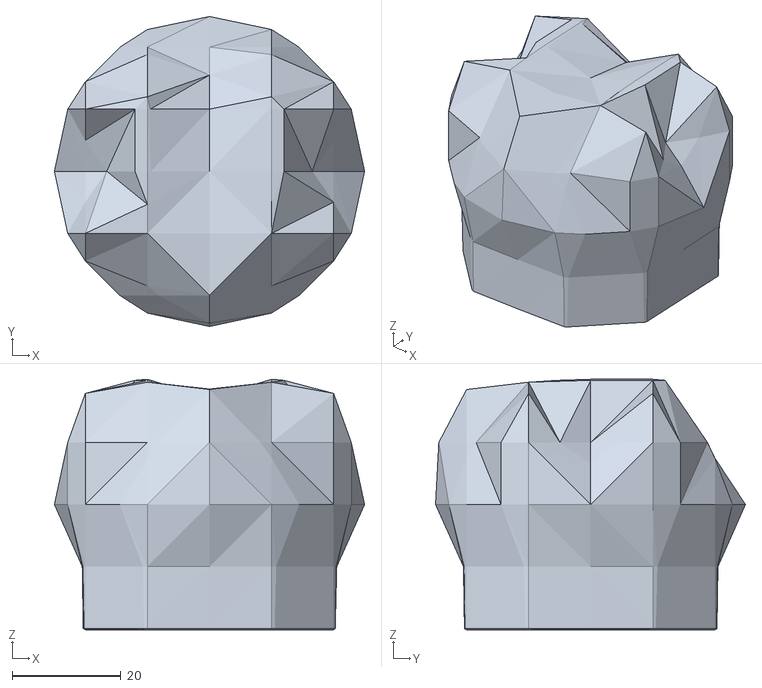
[picture p181: CAD file, 2026-11-04]
simulation/mabel_mujoco/assets/meshes/head/1_body_to_head.stl
57.0 x 56.9 x 46.0
