Klajdi00/open_mabel/simulation/mabel_mujoco/assets/meshes/lift/lift_top_link.stl

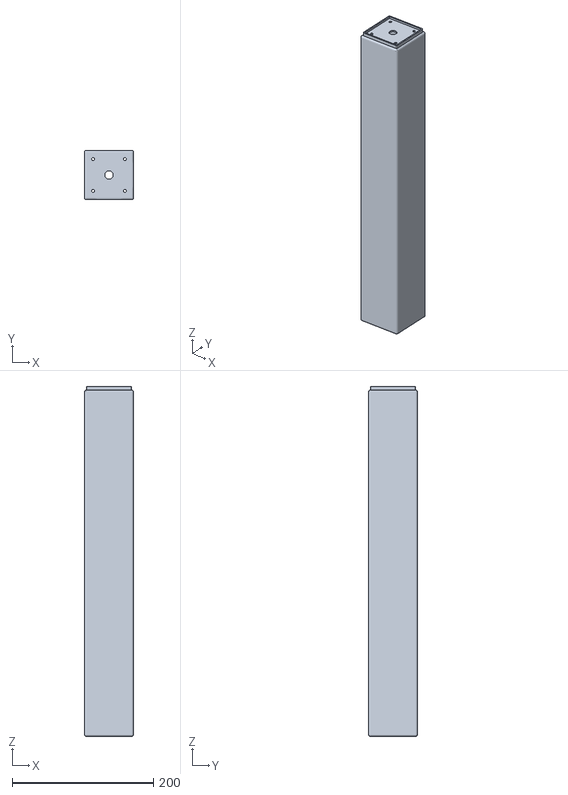
[picture p182: CAD file, 2026-11-04]
simulation/mabel_mujoco/assets/meshes/lift/lift_top_link.stl
70.0 x 70.0 x 495.0
