Klajdi00/open_mabel/simulation/mabel_mujoco/assets/objects/ACE_Coffee_Mug_Kristen_16_oz_cup/model.obj

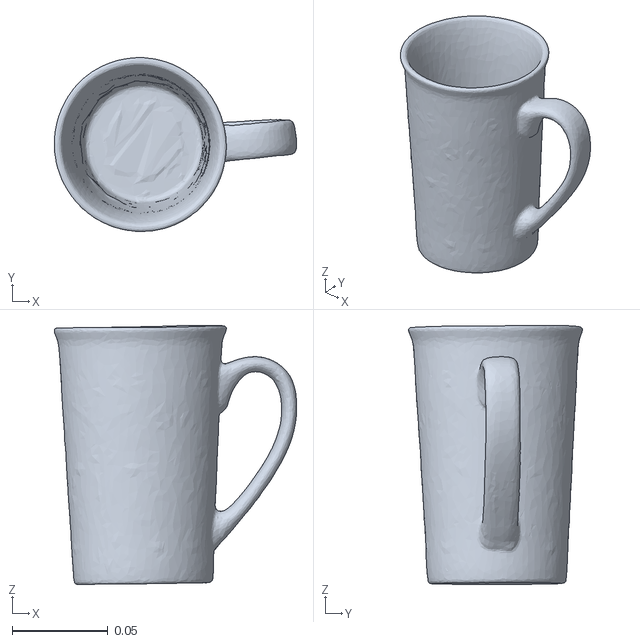
[picture p183: CAD file, 2026-11-04]
simulation/mabel_mujoco/assets/objects/ACE_Coffee_Mug_Kristen_16_oz_cup/model.obj
0.126 x 0.0906 x 0.135
