Klajdi00/open_mabel/simulation/mabel_mujoco/assets/objects/Cole_Hardware_Mug_Classic_Blue/model.obj

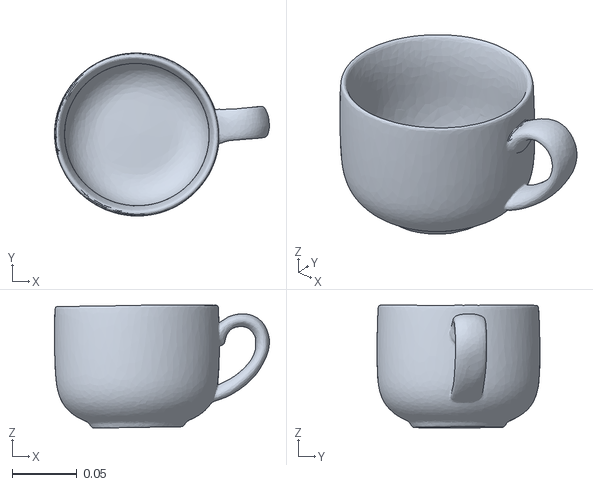
[picture p184: CAD file, 2026-11-04]
simulation/mabel_mujoco/assets/objects/Cole_Hardware_Mug_Classic_Blue/model.obj
0.166 x 0.126 x 0.0948
