Klajdi00/open_mabel/simulation/mabel_mujoco/assets/objects/Room_Essentials_Bowl_Turquiose/model.obj

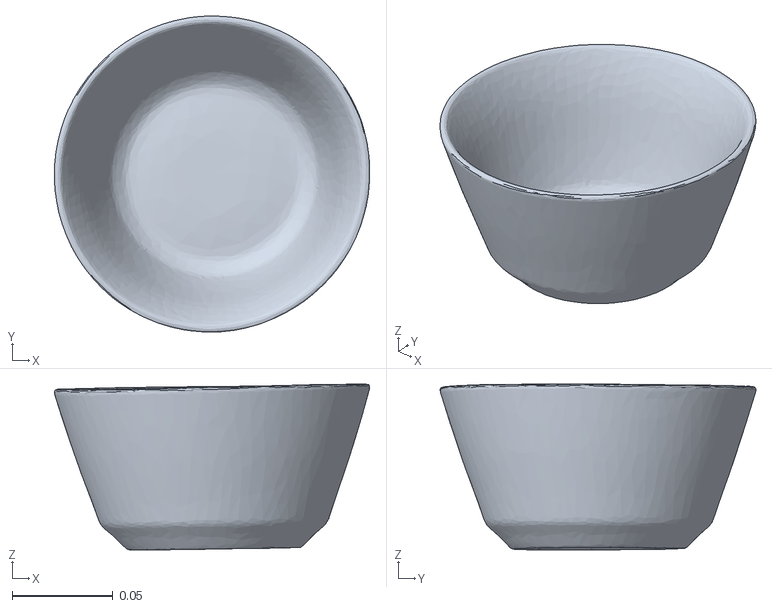
[picture p185: CAD file, 2026-11-04]
simulation/mabel_mujoco/assets/objects/Room_Essentials_Bowl_Turquiose/model.obj
0.157 x 0.157 x 0.0826
