Klajdi00/open_mabel/simulation/mabel_mujoco/assets/objects/Threshold_Bistro_Ceramic_Dinner_Plate_Ruby_Ring/model.obj

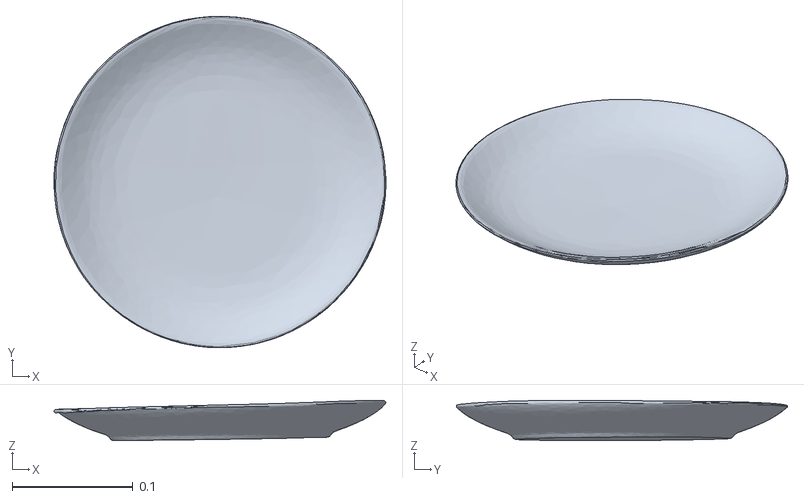
[picture p186: CAD file, 2026-11-04]
simulation/mabel_mujoco/assets/objects/Threshold_Bistro_Ceramic_Dinner_Plate_Ruby_Ring/model.obj
0.274 x 0.274 x 0.0333
