Klajdi00/open_mabel/simulation/mabel_mujoco/assets/objects/Threshold_Porcelain_Pitcher_White/model.obj

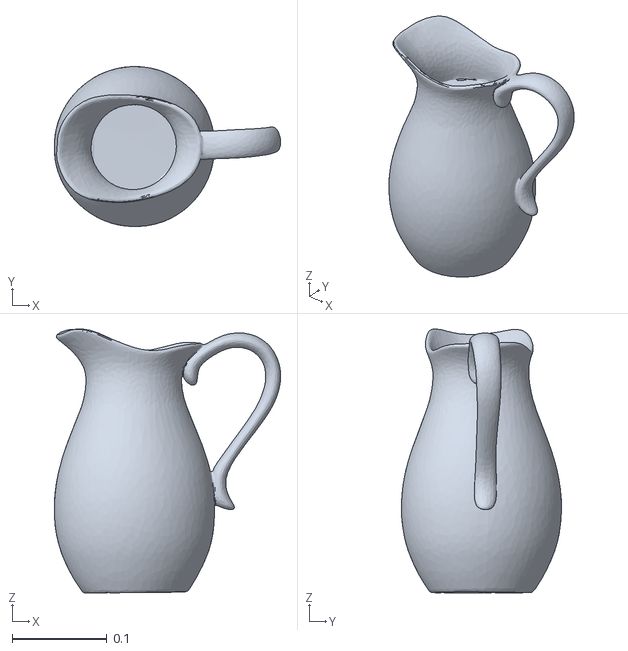
[picture p187: CAD file, 2026-11-04]
simulation/mabel_mujoco/assets/objects/Threshold_Porcelain_Pitcher_White/model.obj
0.239 x 0.169 x 0.278
