Klajdi00/open_mabel/simulation/mabel_mujoco/assets/objects/Threshold_Porcelain_Teapot_White/model.obj

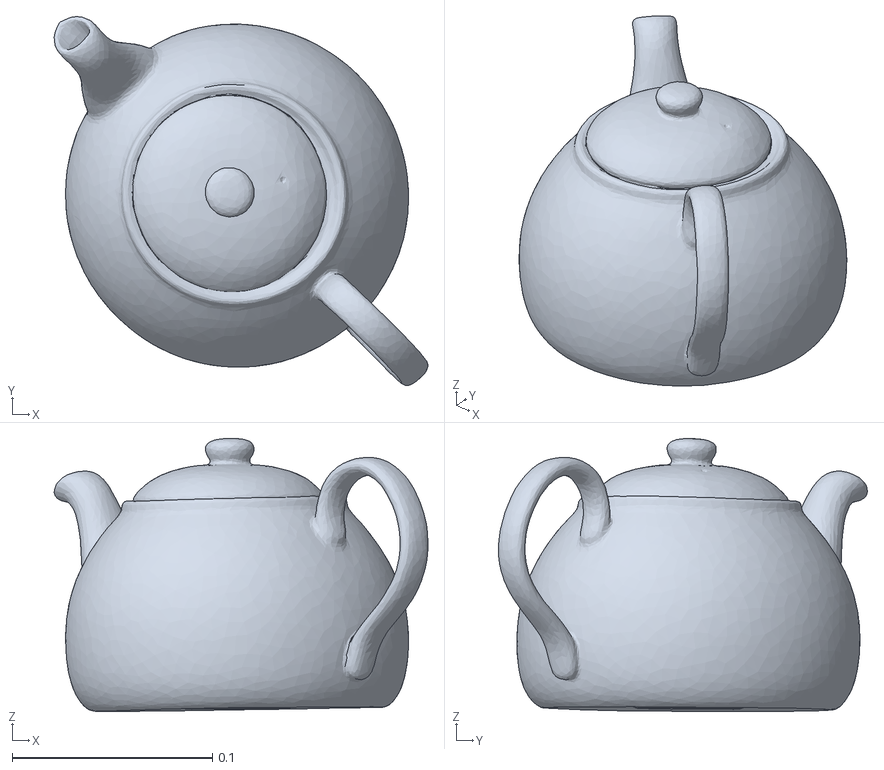
[picture p188: CAD file, 2026-11-04]
simulation/mabel_mujoco/assets/objects/Threshold_Porcelain_Teapot_White/model.obj
0.187 x 0.184 x 0.136
