Klajdi00/open_mabel/simulation/mabel_mujoco/models/meshes/collision/gripper/hand.stl

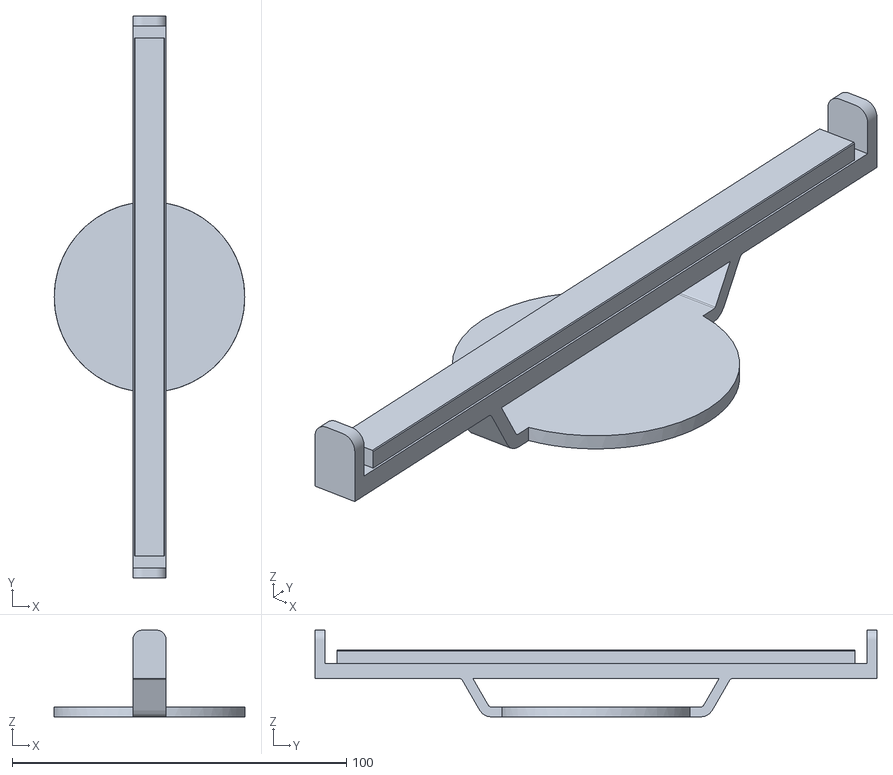
[picture p189: CAD file, 2026-11-04]
simulation/mabel_mujoco/models/meshes/collision/gripper/hand.stl
57.0 x 168.1 x 26.0
