Klajdi00/open_mabel/simulation/mabel_mujoco/models/meshes/visual/arm/link7_0.obj

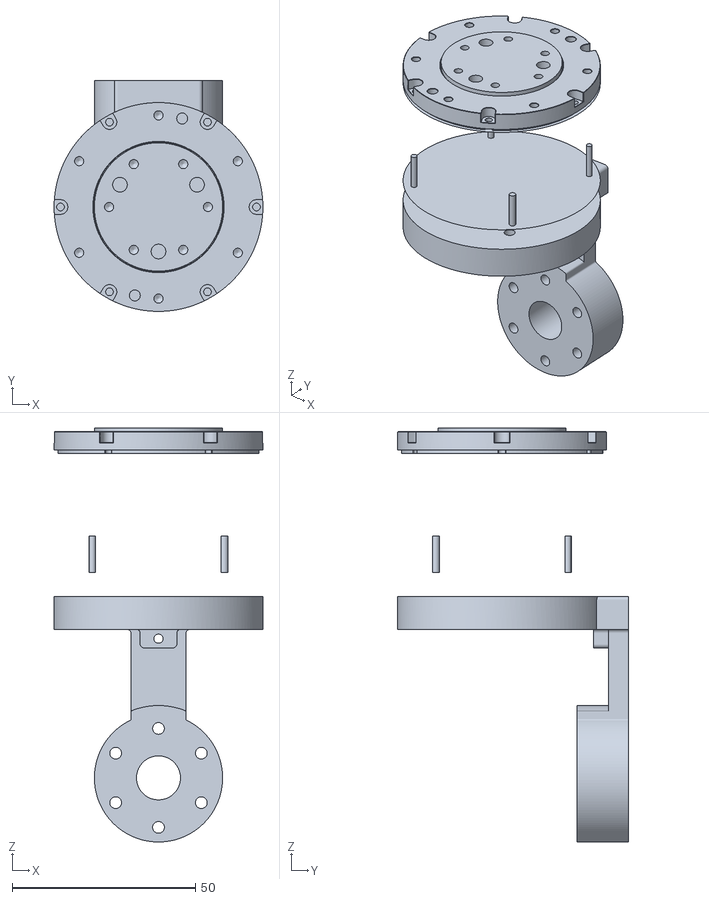
[picture p190: CAD file, 2026-11-04]
simulation/mabel_mujoco/models/meshes/visual/arm/link7_0.obj
57.0 x 63.0 x 113.0
