Klajdi00/open_mabel/simulation/mabel_mujoco/models/meshes/visual/gripper/hand_0.obj

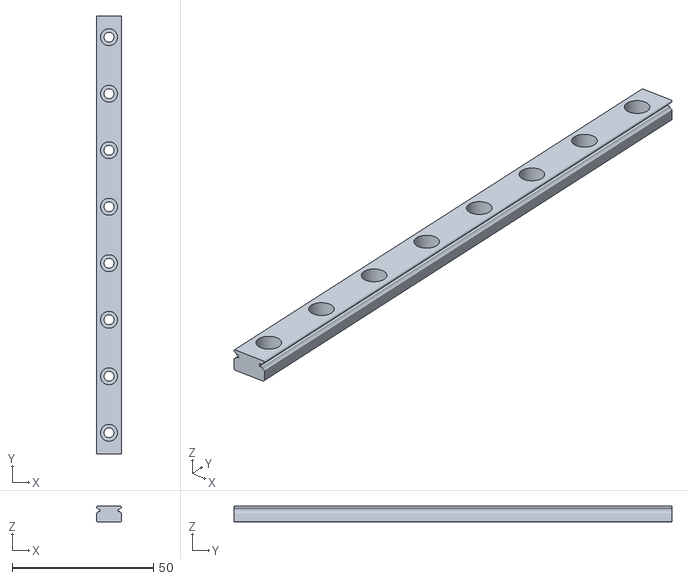
[picture p191: CAD file, 2026-11-04]
simulation/mabel_mujoco/models/meshes/visual/gripper/hand_0.obj
9.00 x 155.0 x 5.50
