Klajdi00/open_mabel/apps/ios/MABEL Mobile App/Resources/MabelRig/rig_left_pinky_mp__v53.ply

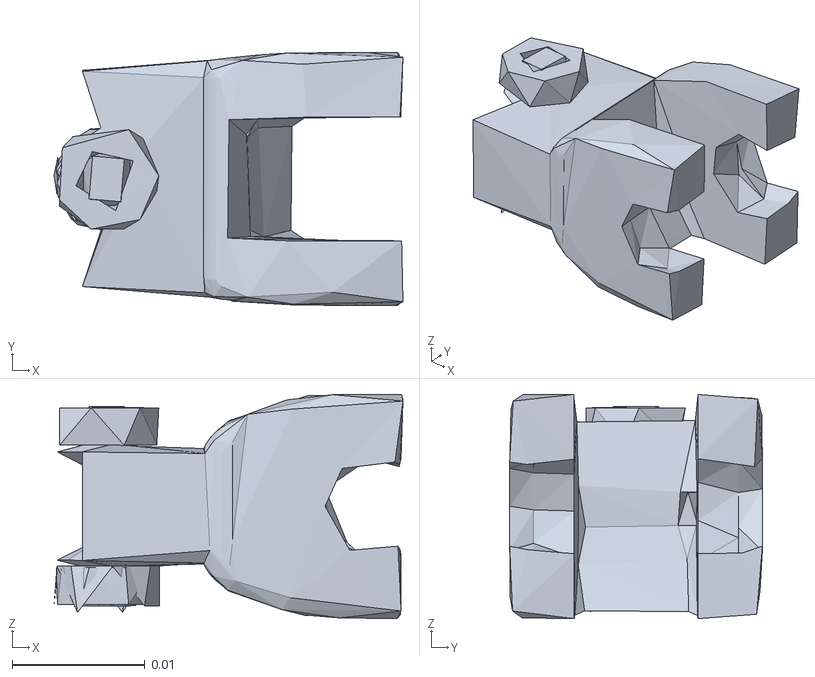
[picture p192: CAD file, 2026-11-04]
apps/ios/MABEL Mobile App/Resources/MabelRig/rig_left_pinky_mp__v53.ply
0.0262 x 0.019 x 0.0169
