Klajdi00/open_mabel/apps/ios/MABEL Mobile App/Resources/NovaRig/nova_hands_v1_left_ring_ip_50.ply

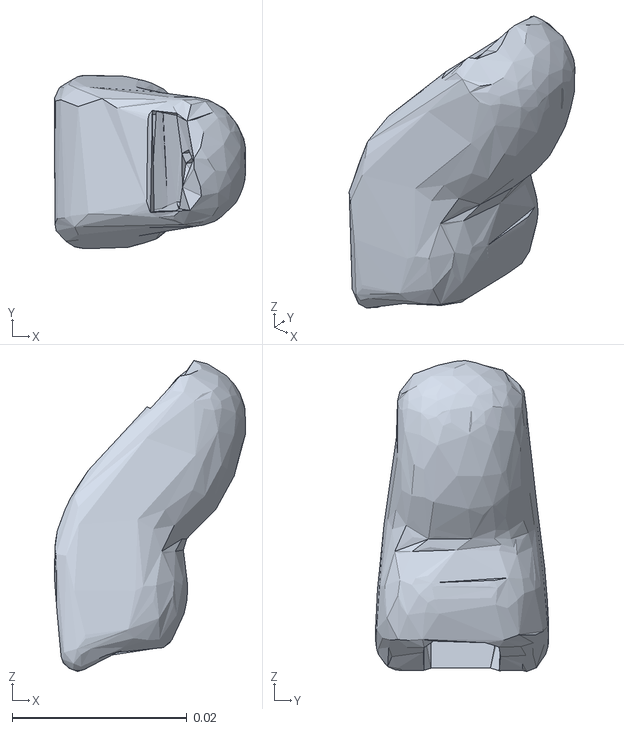
[picture p193: CAD file, 2026-11-04]
apps/ios/MABEL Mobile App/Resources/NovaRig/nova_hands_v1_left_ring_ip_50.ply
0.0219 x 0.0199 x 0.0356
