Klajdi00/open_mabel/apps/visionos/MabelTeleop/Resources/MabelRig/rig_left_index_ip__v42.ply

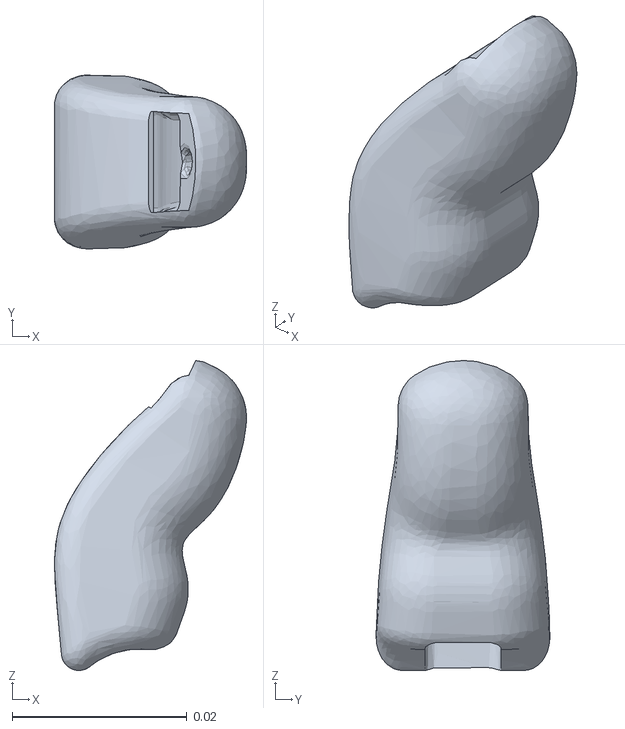
[picture p194: CAD file, 2026-11-04]
apps/visionos/MabelTeleop/Resources/MabelRig/rig_left_index_ip__v42.ply
0.022 x 0.0199 x 0.0355
