Klajdi00/open_mabel/apps/visionos/MabelTeleop/Resources/NovaRig/nova_hands_v1_right_thumb_ip_93.ply

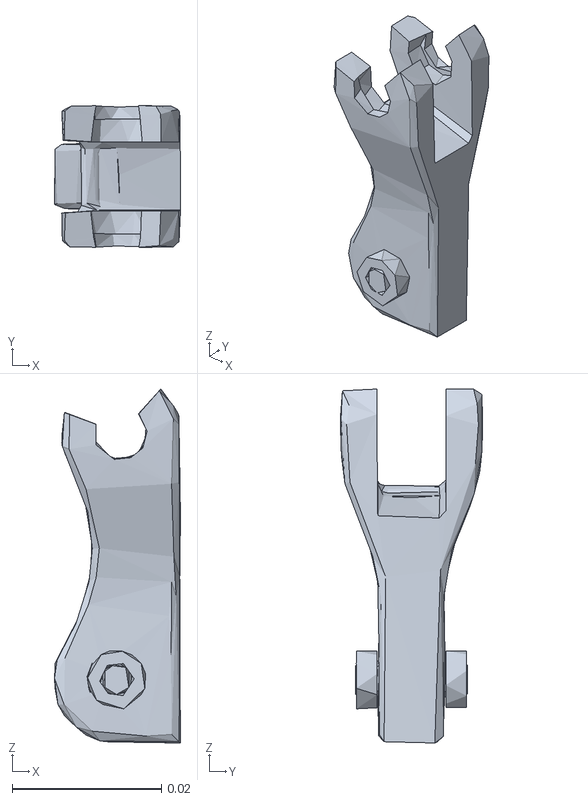
[picture p195: CAD file, 2026-11-04]
apps/visionos/MabelTeleop/Resources/NovaRig/nova_hands_v1_right_thumb_ip_93.ply
0.0169 x 0.019 x 0.0475
