Klajdi00/open_mabel/robot_learning/reinforcement_learning/mjlab/src/mjlab/asset_zoo/robots/i2rt_yam/xmls/assets/model2__6.stl

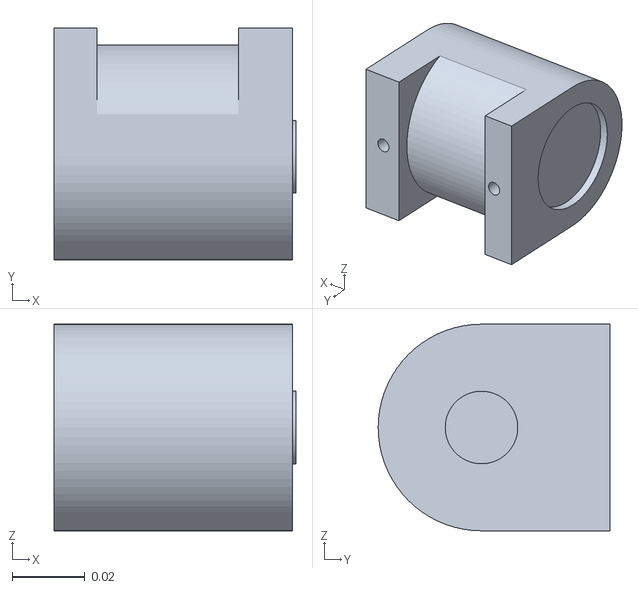
[picture p196: CAD file, 2026-11-04]
robot_learning/reinforcement_learning/mjlab/src/mjlab/asset_zoo/robots/i2rt_yam/xmls/assets/model2__6.stl
0.0668 x 0.0639 x 0.057
