Klajdi00/open_mabel/robot_learning/reinforcement_learning/mjlab/src/mjlab/asset_zoo/robots/unitree_g1/xmls/assets/left_shoulder_pitch_link.STL

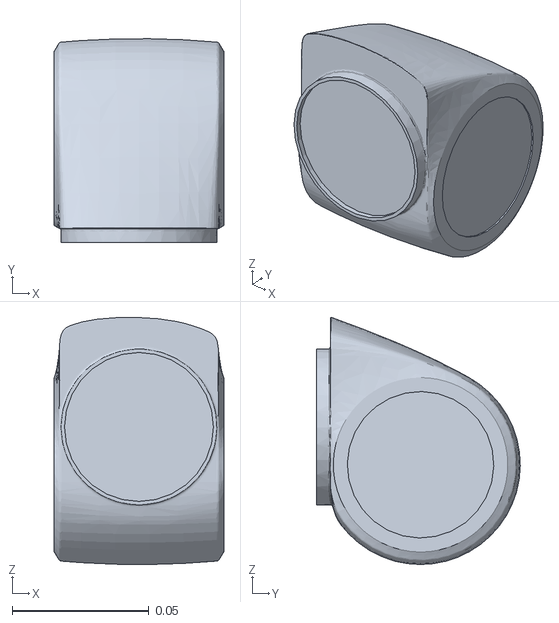
[picture p197: CAD file, 2026-11-04]
robot_learning/reinforcement_learning/mjlab/src/mjlab/asset_zoo/robots/unitree_g1/xmls/assets/left_shoulder_pitch_link.STL
0.062 x 0.0745 x 0.0904
