Klajdi00/open_mabel/robot_learning/reinforcement_learning/mjlab/src/mjlab/asset_zoo/robots/unitree_go1/xmls/assets/calf.stl

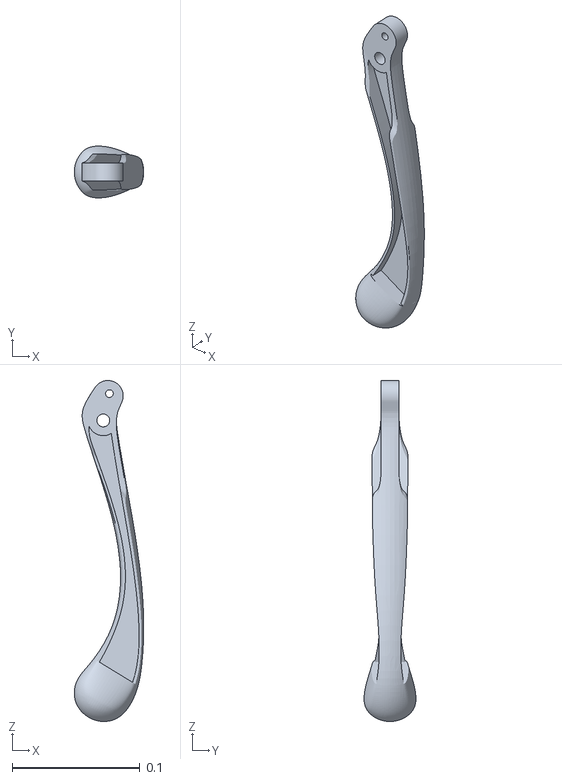
[picture p198: CAD file, 2026-11-04]
robot_learning/reinforcement_learning/mjlab/src/mjlab/asset_zoo/robots/unitree_go1/xmls/assets/calf.stl
0.0543 x 0.0405 x 0.266
