Klajdi00/open_mabel/robot_learning/reinforcement_learning/wbc_rl/assets/meshes/openarm_gripper_v1/link7_1.stl

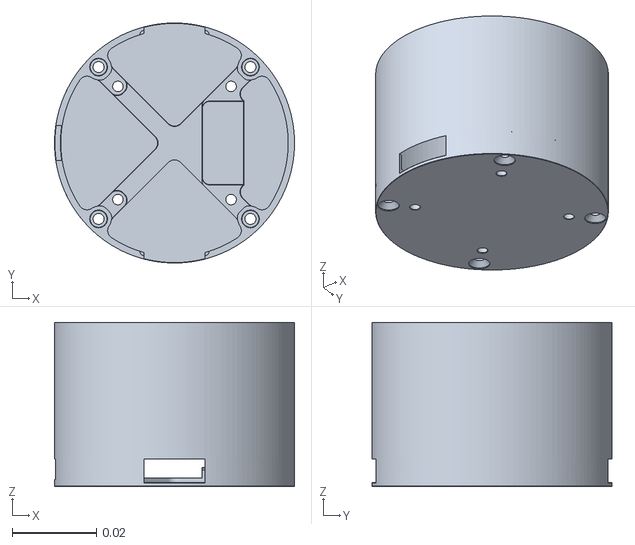
[picture p199: CAD file, 2026-11-04]
robot_learning/reinforcement_learning/wbc_rl/assets/meshes/openarm_gripper_v1/link7_1.stl
0.057 x 0.057 x 0.039
