Klajdi00/open_mabel/ros/src/mabel_description/meshes/arms/left/4_upper_arm.stl

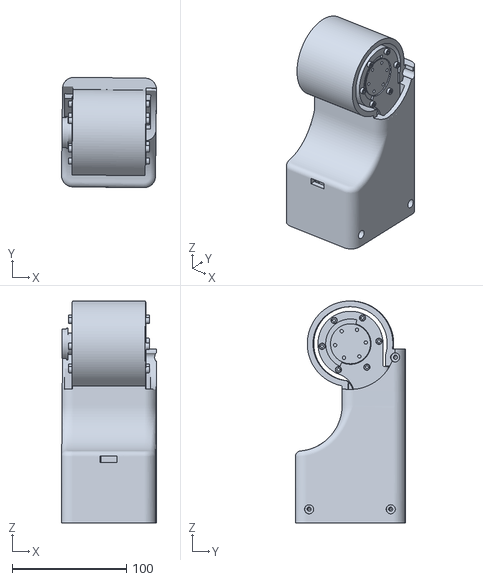
[picture p200: CAD file, 2026-11-04]
ros/src/mabel_description/meshes/arms/left/4_upper_arm.stl
83.3 x 96.7 x 194.5
