Klajdi00/open_mabel/ros/src/mabel_description/meshes/body/lift_to_body.stl

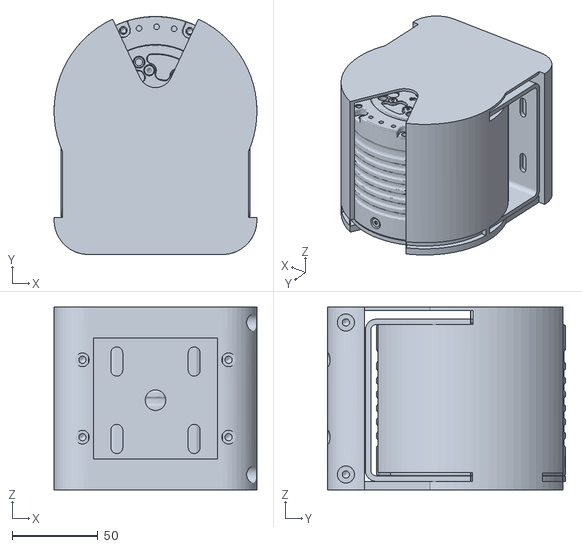
[picture p201: CAD file, 2026-11-04]
ros/src/mabel_description/meshes/body/lift_to_body.stl
118.0 x 138.4 x 106.4
