Klajdi00/open_mabel/ros/src/mabel_description/meshes/hands/right/collision/right_collision_pinky_pp_skin.stl

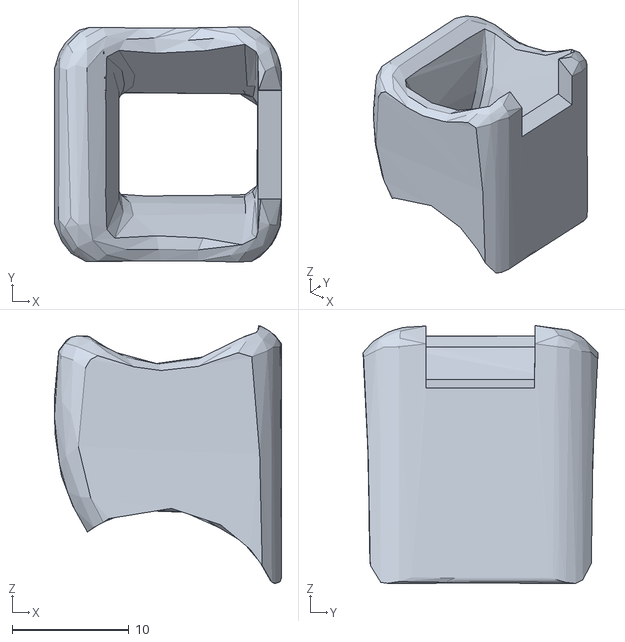
[picture p203: CAD file, 2026-11-04]
ros/src/mabel_description/meshes/hands/right/collision/right_collision_pinky_pp_skin.stl
19.5 x 20.2 x 22.1
