Klajdi00/open_mabel/ros/src/mabel_description/meshes/head/4_head.stl

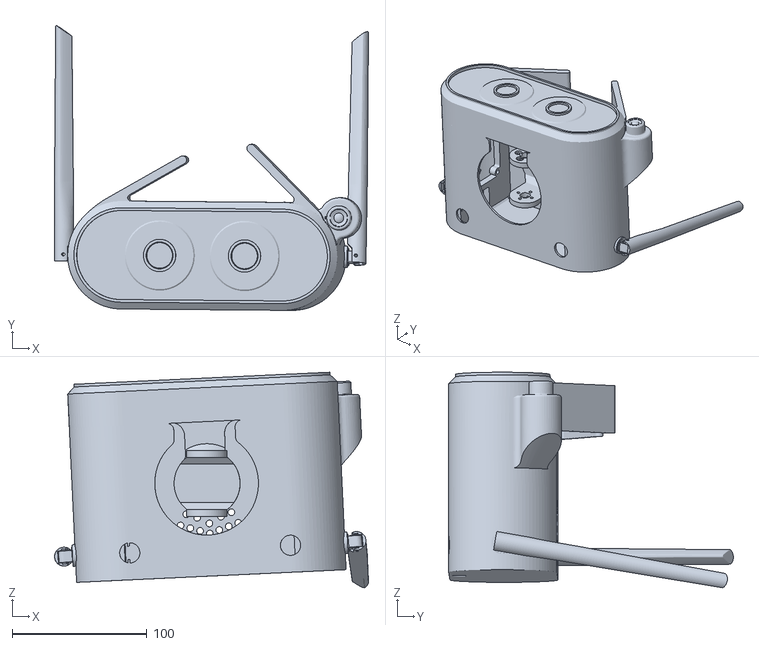
[picture p204: CAD file, 2026-11-04]
ros/src/mabel_description/meshes/head/4_head.stl
232.7 x 211.1 x 159.8
