Klajdi00/open_mabel/ros/src/mabel_description/meshes/swerve_drive/steering_motor.stl

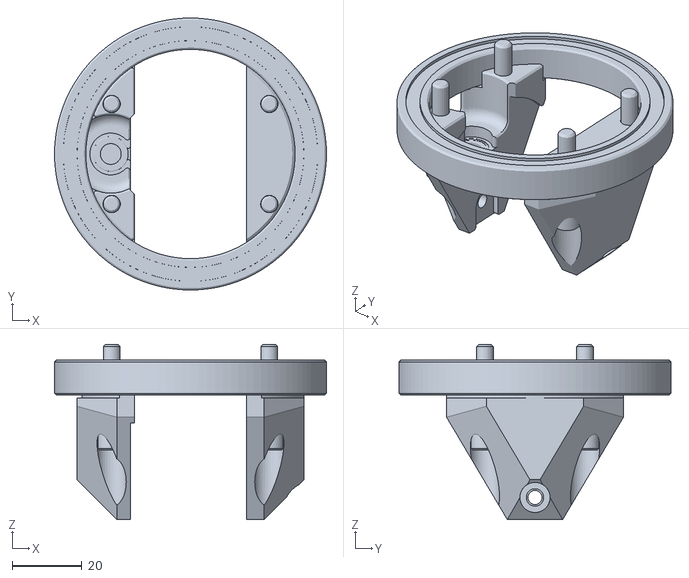
[picture p205: CAD file, 2026-11-04]
ros/src/mabel_description/meshes/swerve_drive/steering_motor.stl
78.0 x 78.0 x 50.2
