Klajdi00/open_mabel/simulation/mabel_mujoco/assets/meshes/arms/left/6_forearm.stl

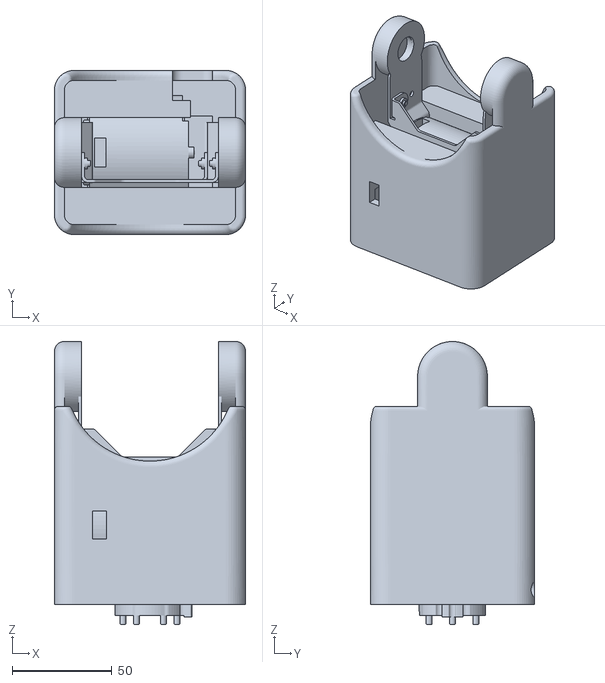
[picture p206: CAD file, 2026-11-04]
simulation/mabel_mujoco/assets/meshes/arms/left/6_forearm.stl
96.0 x 82.4 x 142.0
