Klajdi00/open_mabel/simulation/mabel_mujoco/assets/meshes/hands/left/collision/left_collision_index_ip.stl

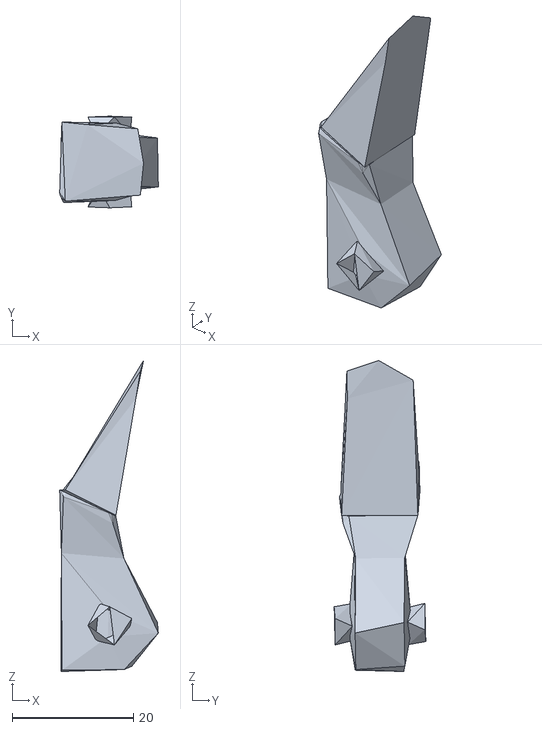
[picture p207: CAD file, 2026-11-04]
simulation/mabel_mujoco/assets/meshes/hands/left/collision/left_collision_index_ip.stl
16.3 x 15.1 x 51.3
