Klajdi00/open_mabel/simulation/mabel_mujoco/assets/meshes/hands/left/visual/left_visual_palm.stl

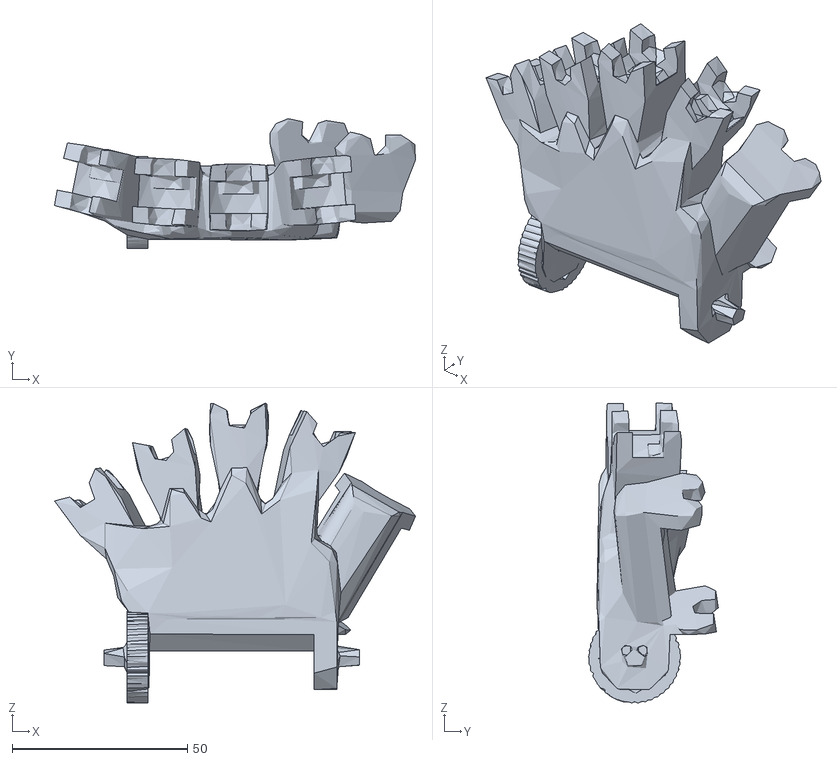
[picture p208: CAD file, 2026-11-04]
simulation/mabel_mujoco/assets/meshes/hands/left/visual/left_visual_palm.stl
103.1 x 37.1 x 85.7
