Klajdi00/open_mabel/simulation/mabel_mujoco/assets/meshes/hands/right/collision/right_collision_thumb_dp.stl

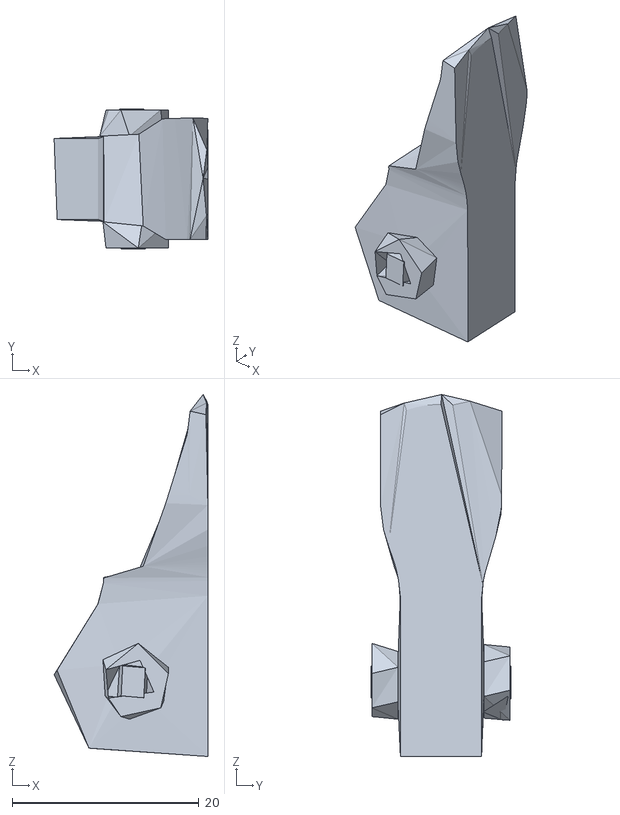
[picture p209: CAD file, 2026-11-04]
simulation/mabel_mujoco/assets/meshes/hands/right/collision/right_collision_thumb_dp.stl
16.5 x 15.0 x 38.8
