Klajdi00/open_mabel/simulation/mabel_mujoco/assets/meshes/hands/right/visual/right_visual_ring_pp.stl

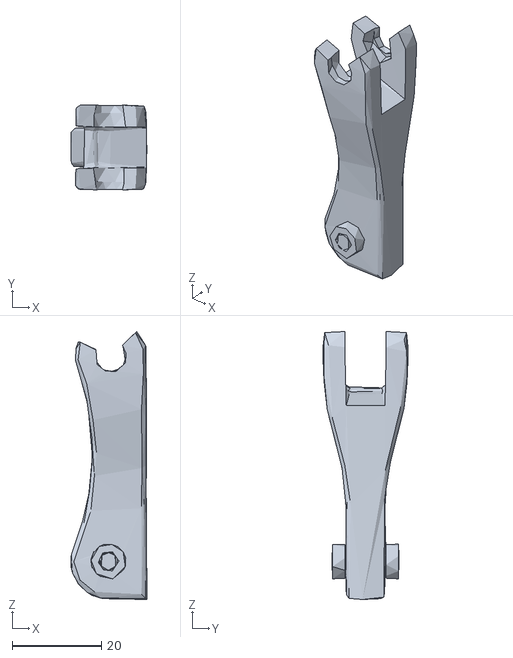
[picture p210: CAD file, 2026-11-04]
simulation/mabel_mujoco/assets/meshes/hands/right/visual/right_visual_ring_pp.stl
17.0 x 19.0 x 60.1
