Klajdi00/open_mabel/simulation/mabel_mujoco/models/meshes/collision/gripper/finger.stl

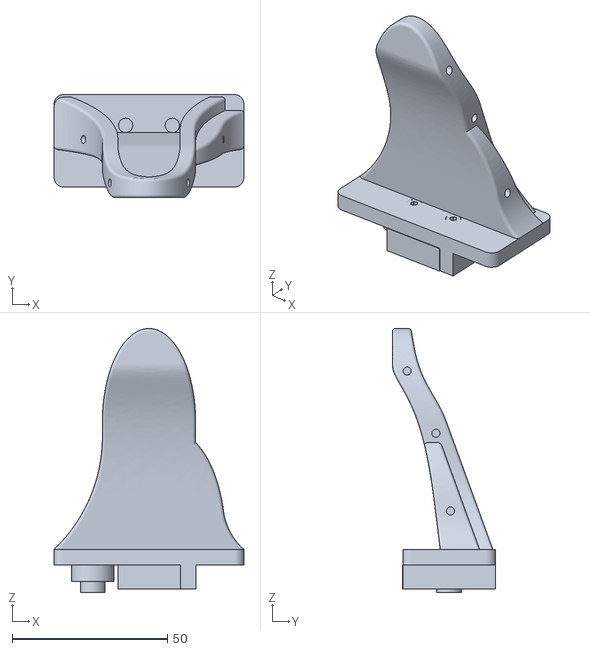
[picture p211: CAD file, 2026-11-04]
simulation/mabel_mujoco/models/meshes/collision/gripper/finger.stl
61.0 x 33.3 x 84.9
