Klajdi00/open_mabel/simulation/mabel_mujoco/models/meshes/visual/arm/link7_1.obj

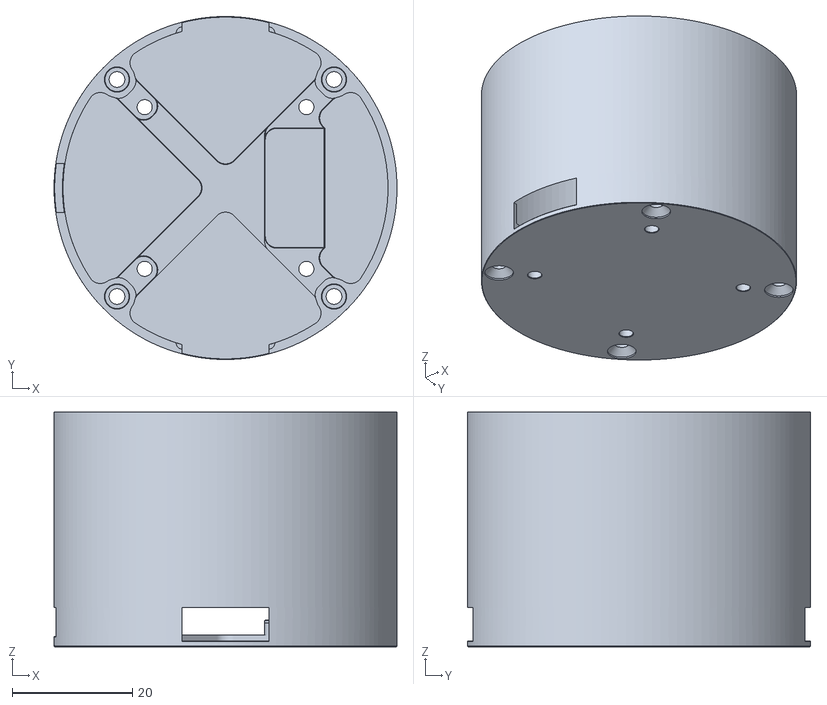
[picture p212: CAD file, 2026-11-04]
simulation/mabel_mujoco/models/meshes/visual/arm/link7_1.obj
57.0 x 57.0 x 39.0
