Klajdi00/open_mabel/simulation/mabel_mujoco/models/meshes/visual/gripper/finger_0.obj

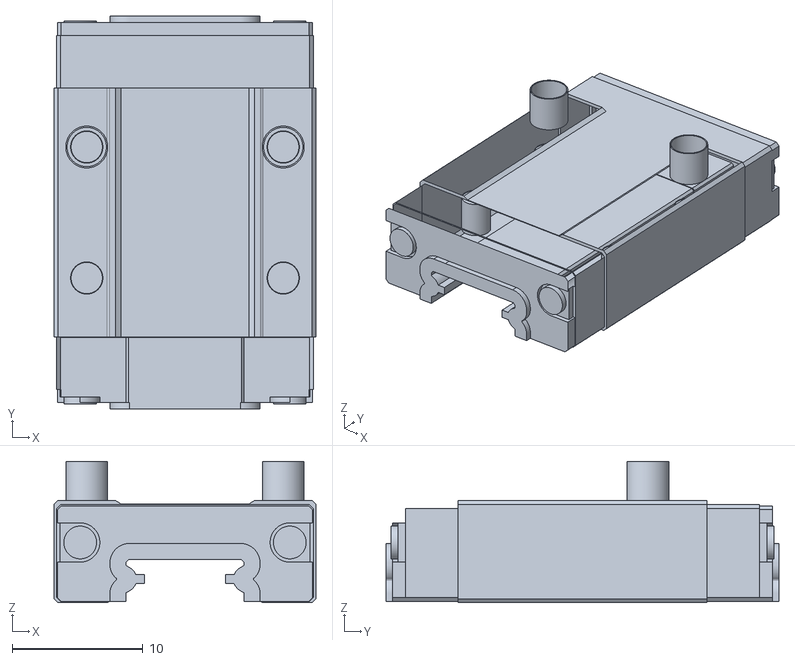
[picture p213: CAD file, 2026-11-04]
simulation/mabel_mujoco/models/meshes/visual/gripper/finger_0.obj
20.0 x 30.0 x 10.8
