Klajdi00/open_mabel/apps/ios/MABEL Mobile App/Resources/NovaRig/nova_hands_v1_left_index_pp_58.ply

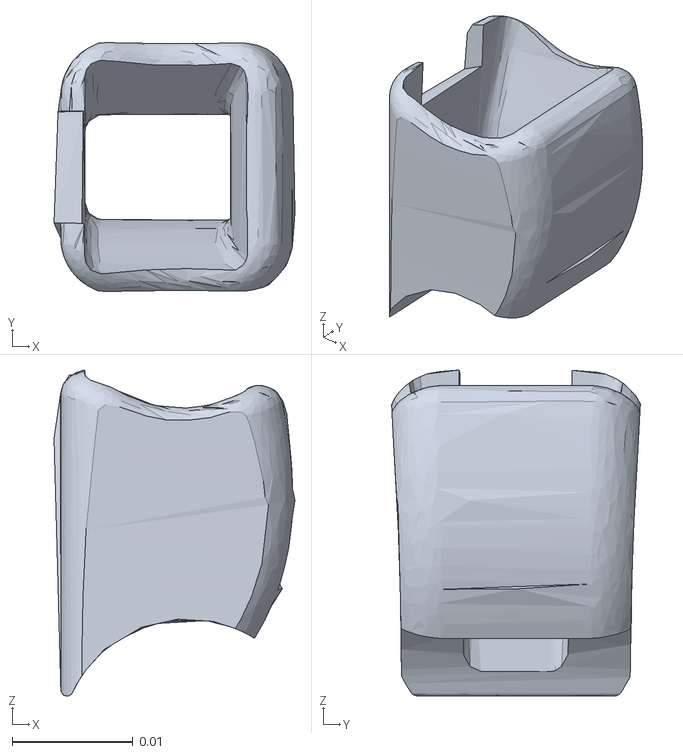
[picture p214: CAD file, 2026-11-04]
apps/ios/MABEL Mobile App/Resources/NovaRig/nova_hands_v1_left_index_pp_58.ply
0.02 x 0.0206 x 0.027
