Klajdi00/open_mabel/apps/visionos/MabelTeleop/Resources/MabelRig/rig_torso__v14.ply

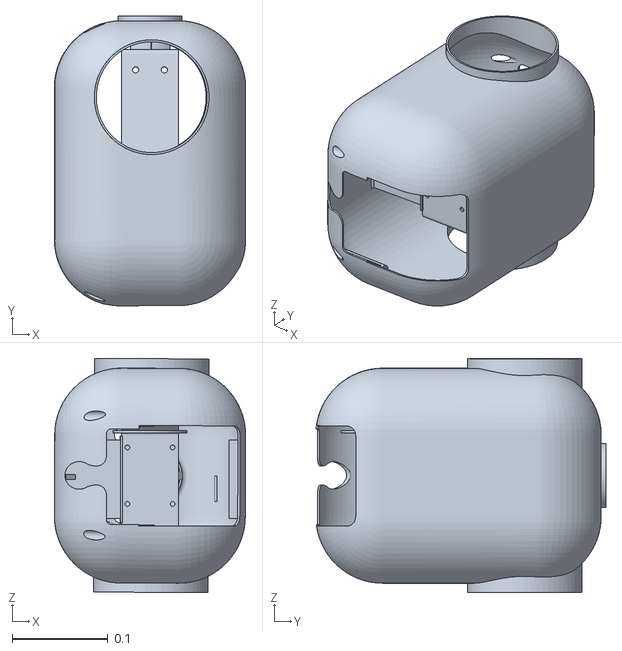
[picture p215: CAD file, 2026-11-04]
apps/visionos/MabelTeleop/Resources/MabelRig/rig_torso__v14.ply
0.2 x 0.304 x 0.245
