Klajdi00/open_mabel/robot_learning/reinforcement_learning/mjlab/src/mjlab/asset_zoo/robots/i2rt_yam/xmls/assets/model2__15.stl

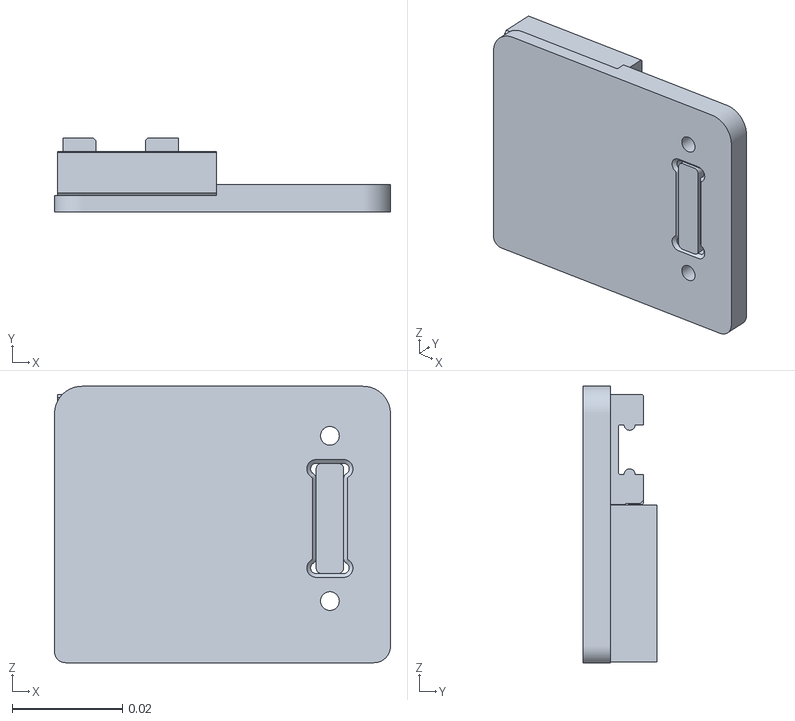
[picture p216: CAD file, 2026-11-04]
robot_learning/reinforcement_learning/mjlab/src/mjlab/asset_zoo/robots/i2rt_yam/xmls/assets/model2__15.stl
0.061 x 0.0135 x 0.0502
