Klajdi00/open_mabel/robot_learning/reinforcement_learning/mjlab/src/mjlab/asset_zoo/robots/unitree_g1/xmls/assets/left_shoulder_roll_link.STL

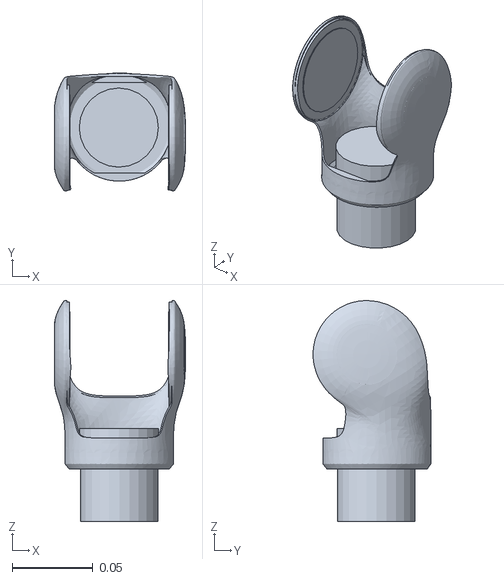
[picture p217: CAD file, 2026-11-04]
robot_learning/reinforcement_learning/mjlab/src/mjlab/asset_zoo/robots/unitree_g1/xmls/assets/left_shoulder_roll_link.STL
0.0812 x 0.0729 x 0.137
