Klajdi00/open_mabel/robot_learning/reinforcement_learning/mjlab/src/mjlab/asset_zoo/robots/unitree_go1/xmls/assets/thigh.stl

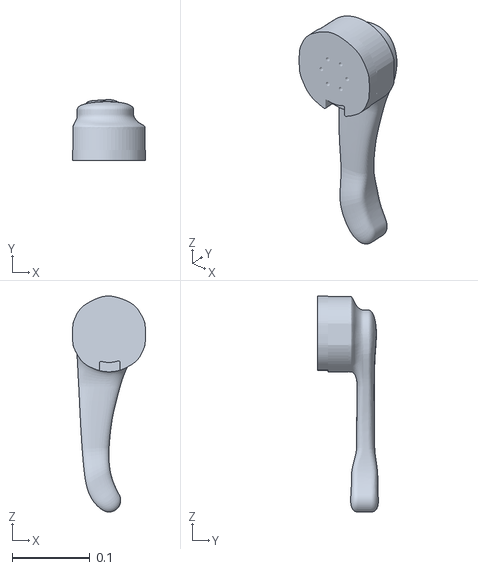
[picture p218: CAD file, 2026-11-04]
robot_learning/reinforcement_learning/mjlab/src/mjlab/asset_zoo/robots/unitree_go1/xmls/assets/thigh.stl
0.094 x 0.0779 x 0.277
