Klajdi00/open_mabel/robot_learning/reinforcement_learning/wbc_rl/assets/meshes/openarm_gripper_v1/link7_0.stl

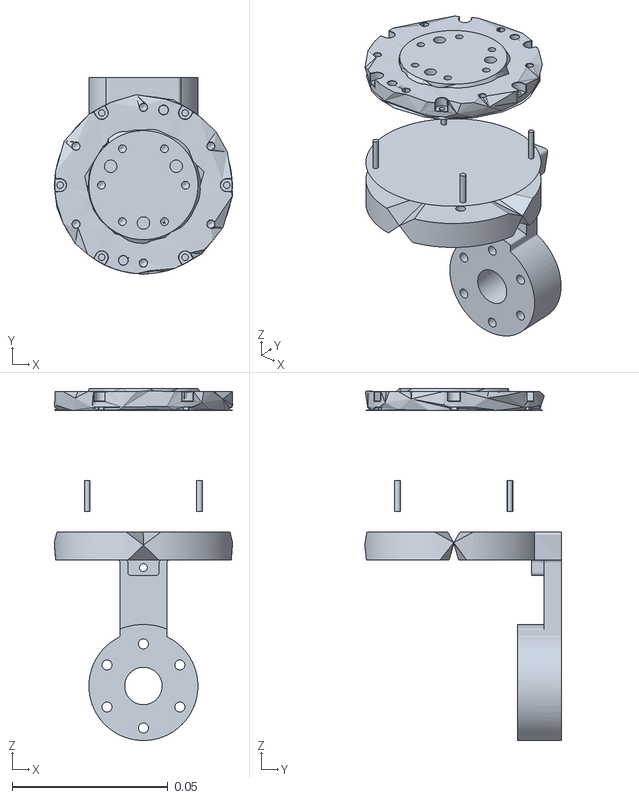
[picture p219: CAD file, 2026-11-04]
robot_learning/reinforcement_learning/wbc_rl/assets/meshes/openarm_gripper_v1/link7_0.stl
0.0573 x 0.0631 x 0.113
