Klajdi00/open_mabel/ros/src/mabel_description/meshes/arms/left/5_elbow.stl

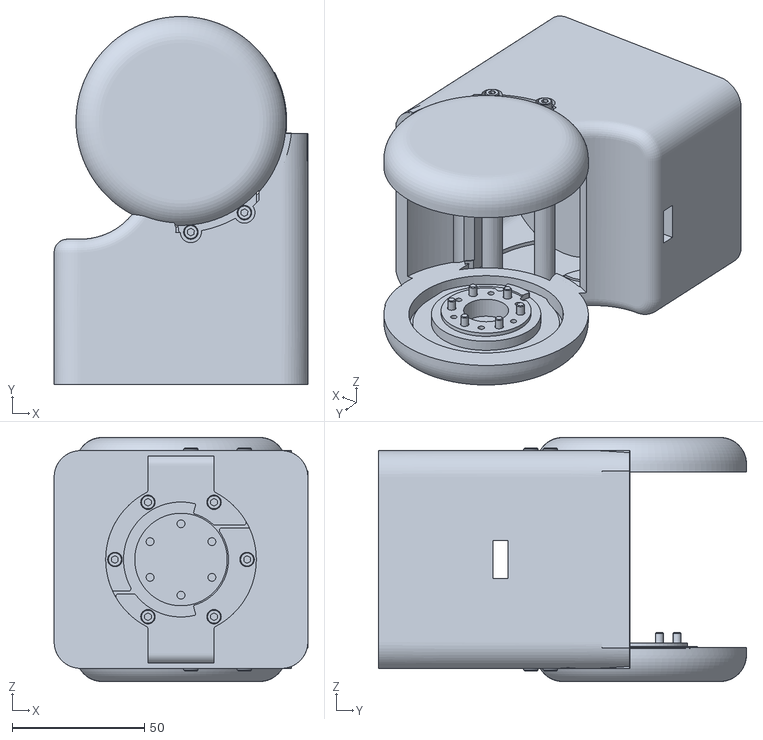
[picture p220: CAD file, 2026-11-04]
ros/src/mabel_description/meshes/arms/left/5_elbow.stl
96.0 x 139.2 x 92.4
