Klajdi00/open_mabel/ros/src/mabel_description/meshes/hands/left/collision/left_collision_palm.stl

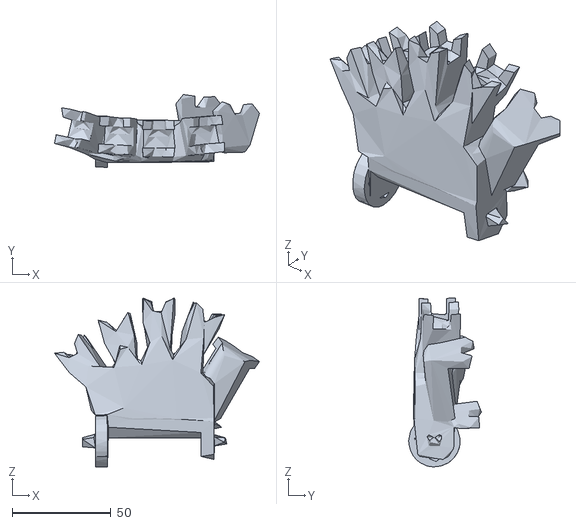
[picture p221: CAD file, 2026-11-04]
ros/src/mabel_description/meshes/hands/left/collision/left_collision_palm.stl
103.8 x 36.9 x 85.5
