Klajdi00/open_mabel/ros/src/mabel_description/meshes/hands/left/visual/left_visual_thumb_mp.stl

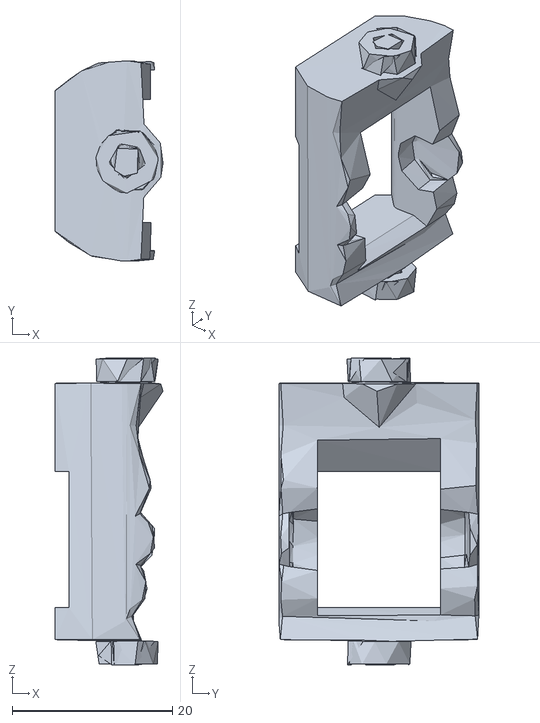
[picture p222: CAD file, 2026-11-04]
ros/src/mabel_description/meshes/hands/left/visual/left_visual_thumb_mp.stl
13.5 x 25.0 x 38.3
