Klajdi00/open_mabel/ros/src/mabel_description/meshes/hands/right/collision/right_collision_ring_pp_skin.stl

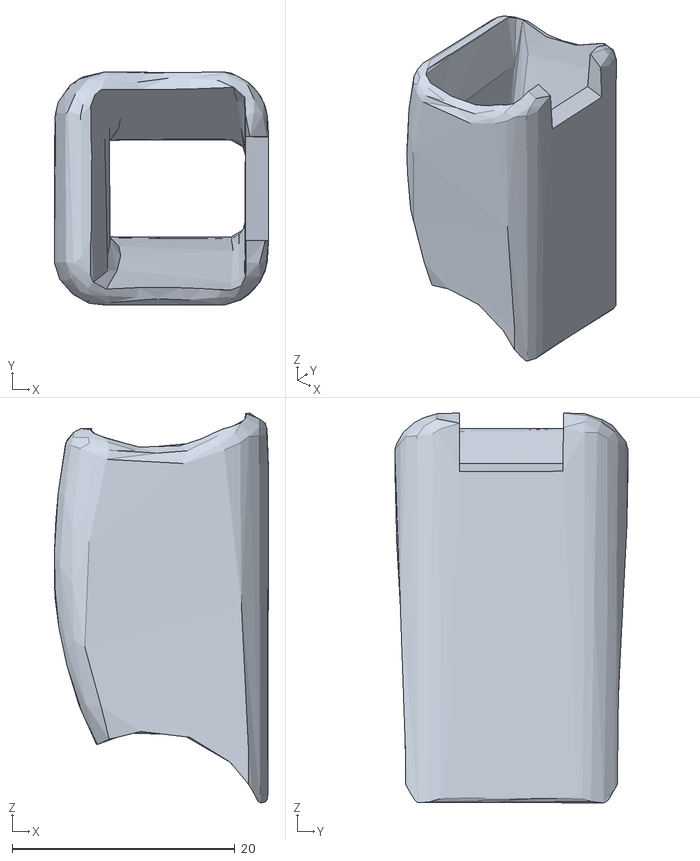
[picture p223: CAD file, 2026-11-04]
ros/src/mabel_description/meshes/hands/right/collision/right_collision_ring_pp_skin.stl
19.2 x 20.9 x 35.0
