Klajdi00/open_mabel/ros/src/mabel_description/meshes/hands/right/visual/right_visual_pinky_mp.stl

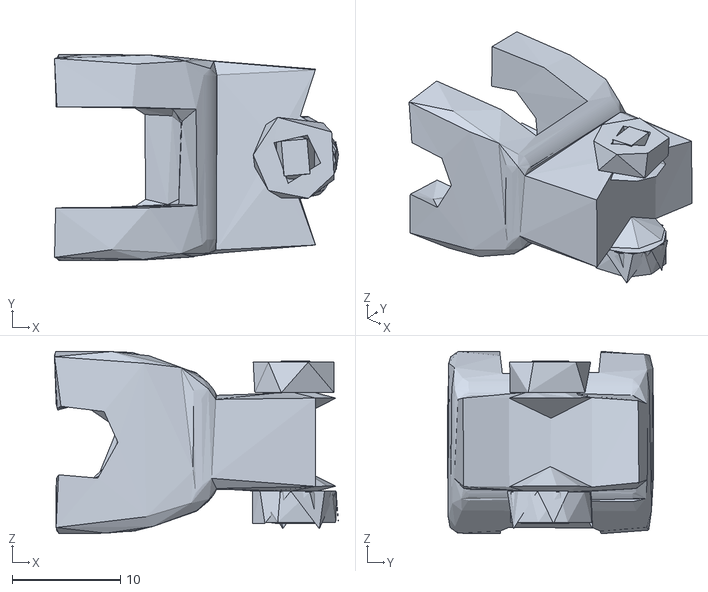
[picture p224: CAD file, 2026-11-04]
ros/src/mabel_description/meshes/hands/right/visual/right_visual_pinky_mp.stl
26.2 x 19.0 x 16.9
