Klajdi00/open_mabel/ros/src/mabel_description/meshes/lift/lift_base_link.stl

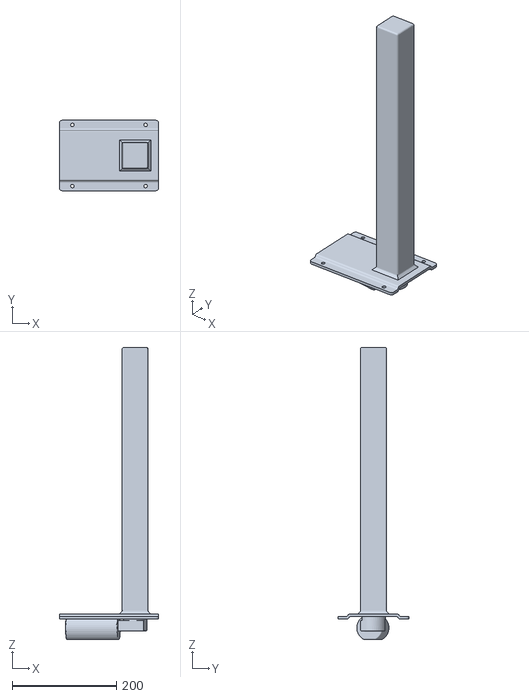
[picture p225: CAD file, 2026-11-04]
ros/src/mabel_description/meshes/lift/lift_base_link.stl
190.0 x 135.0 x 559.1
