Klajdi00/open_mabel/ros/src/mabel_description/meshes/swerve_drive/wheel_to_base.stl

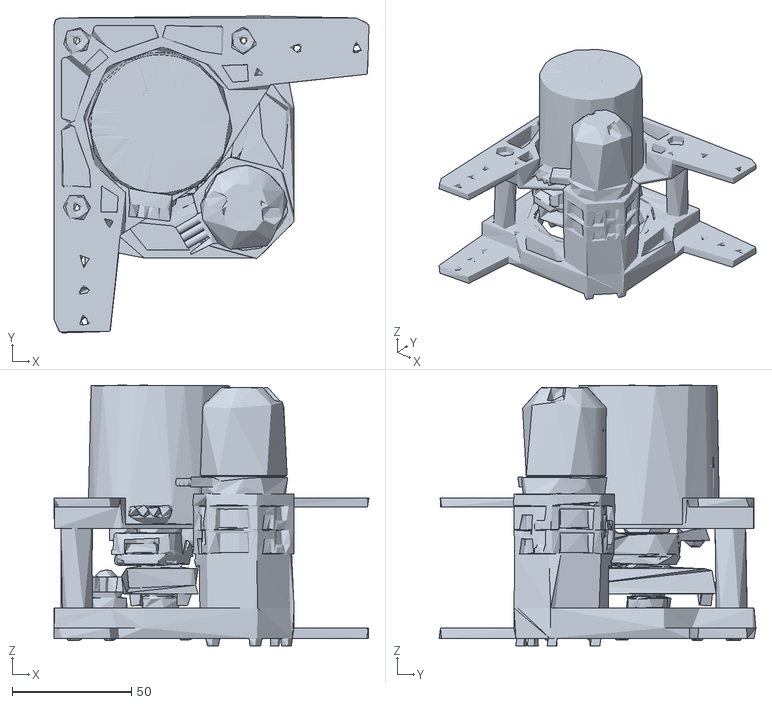
[picture p226: CAD file, 2026-11-04]
ros/src/mabel_description/meshes/swerve_drive/wheel_to_base.stl
131.9 x 132.6 x 109.3
