Klajdi00/open_mabel/simulation/mabel_mujoco/assets/meshes/arms/left/8_arm_to_hand.stl

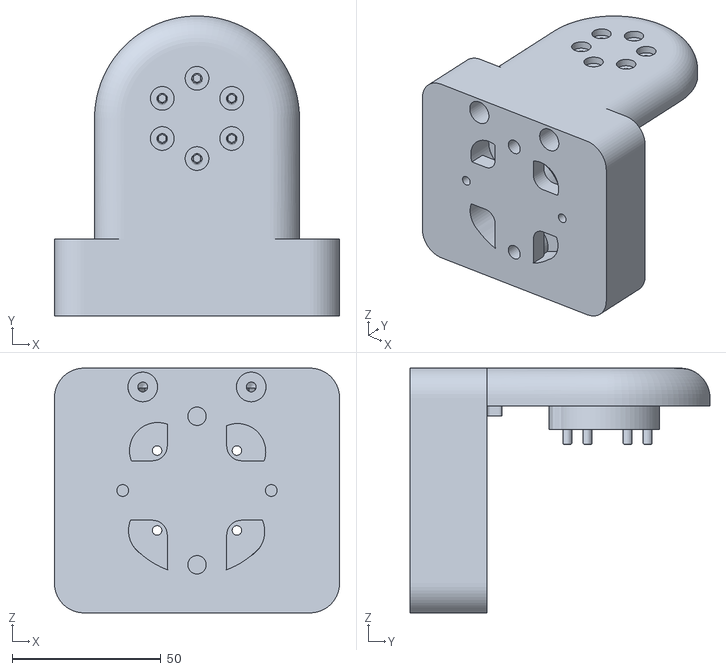
[picture p227: CAD file, 2026-11-04]
simulation/mabel_mujoco/assets/meshes/arms/left/8_arm_to_hand.stl
96.0 x 101.0 x 82.4
