Klajdi00/open_mabel/apps/ios/MABEL Mobile App/Resources/MabelRig/rig_left_thumb_pp__v33.ply

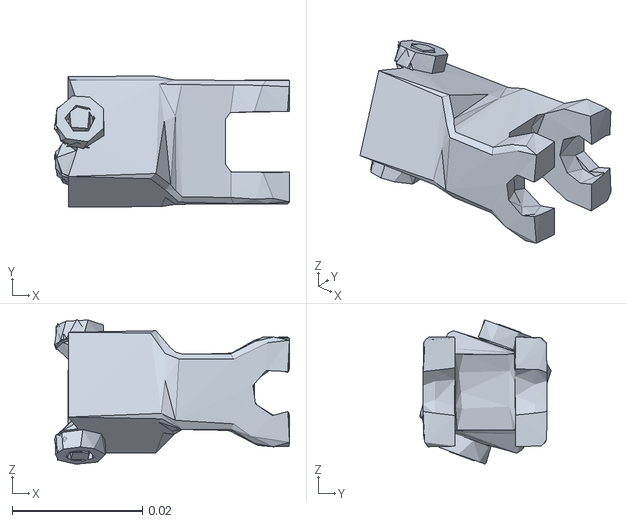
[picture p228: CAD file, 2026-11-04]
apps/ios/MABEL Mobile App/Resources/MabelRig/rig_left_thumb_pp__v33.ply
0.0361 x 0.0202 x 0.0224
