Klajdi00/open_mabel/apps/visionos/MabelTeleop/Resources/MabelRig/rig_left_thumb_ip__v35.ply

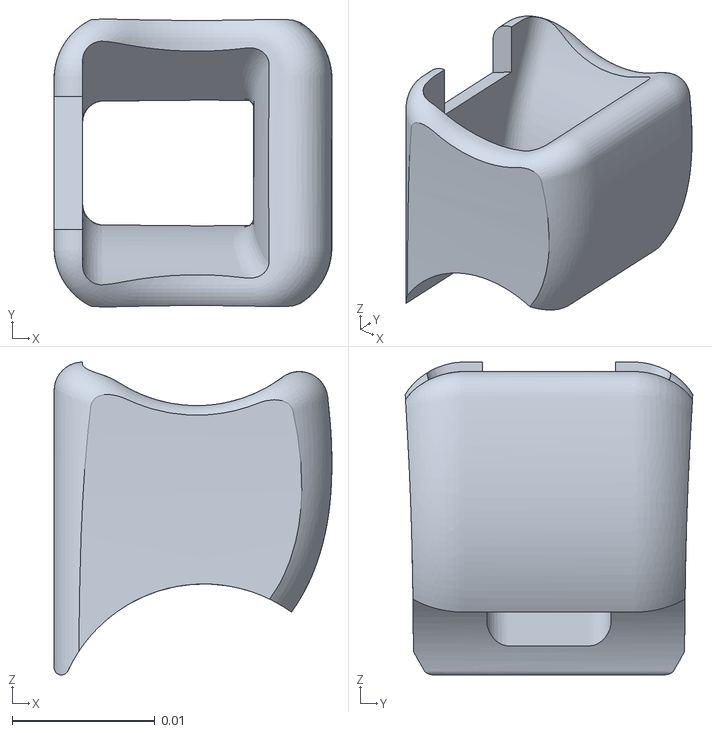
[picture p229: CAD file, 2026-11-04]
apps/visionos/MabelTeleop/Resources/MabelRig/rig_left_thumb_ip__v35.ply
0.0195 x 0.0202 x 0.0219
