Klajdi00/open_mabel/apps/visionos/MabelTeleop/Resources/NovaRig/nova_rig_b_swerve_housing_7.ply

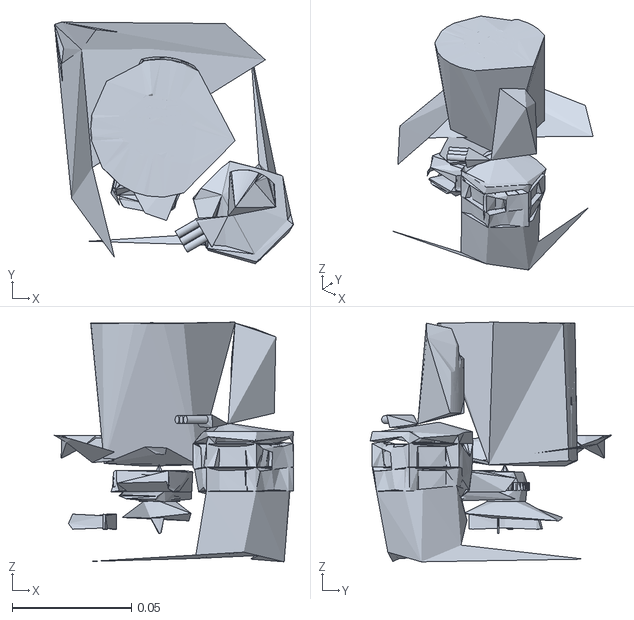
[picture p230: CAD file, 2026-11-04]
apps/visionos/MabelTeleop/Resources/NovaRig/nova_rig_b_swerve_housing_7.ply
0.1 x 0.101 x 0.101
