Klajdi00/open_mabel/robot_learning/reinforcement_learning/mjlab/src/mjlab/asset_zoo/robots/i2rt_yam/xmls/assets/model2__2.stl

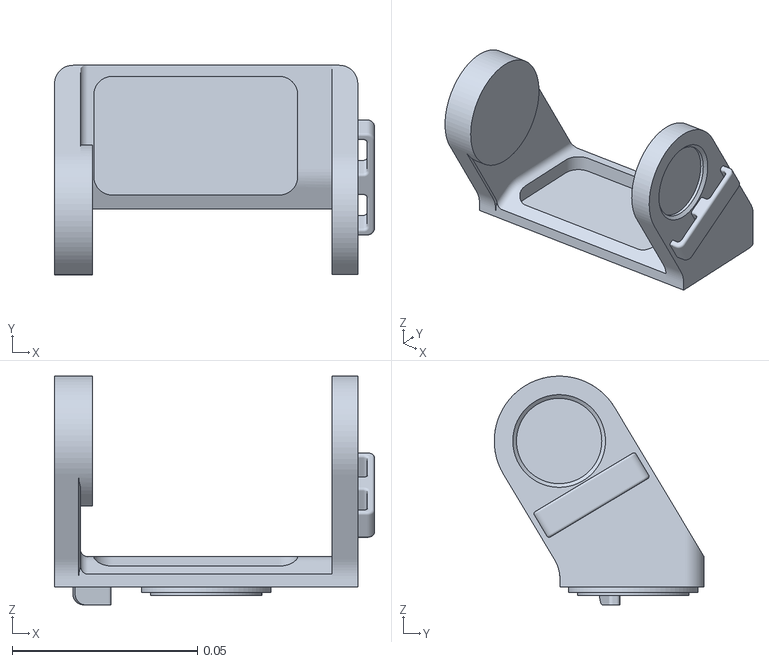
[picture p231: CAD file, 2026-11-04]
robot_learning/reinforcement_learning/mjlab/src/mjlab/asset_zoo/robots/i2rt_yam/xmls/assets/model2__2.stl
0.0863 x 0.0565 x 0.0617
