Klajdi00/open_mabel/ros/src/mabel_description/meshes/arms/left/1_body_to_shoulder.stl

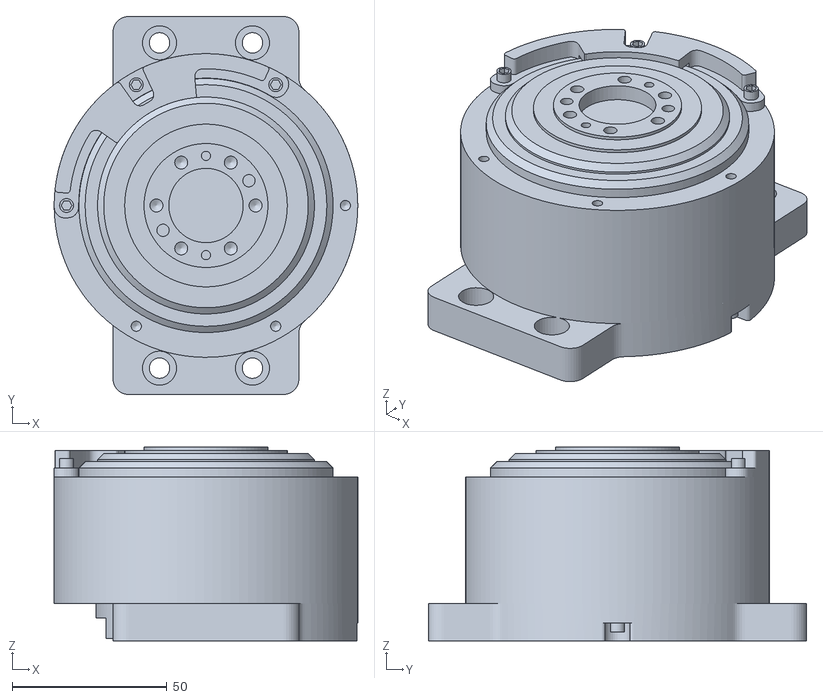
[picture p234: CAD file, 2026-11-04]
ros/src/mabel_description/meshes/arms/left/1_body_to_shoulder.stl
98.0 x 122.0 x 62.5
