Klajdi00/open_mabel/ros/src/mabel_description/meshes/hands/left/visual/left_visual_thumb_dp_skin.stl

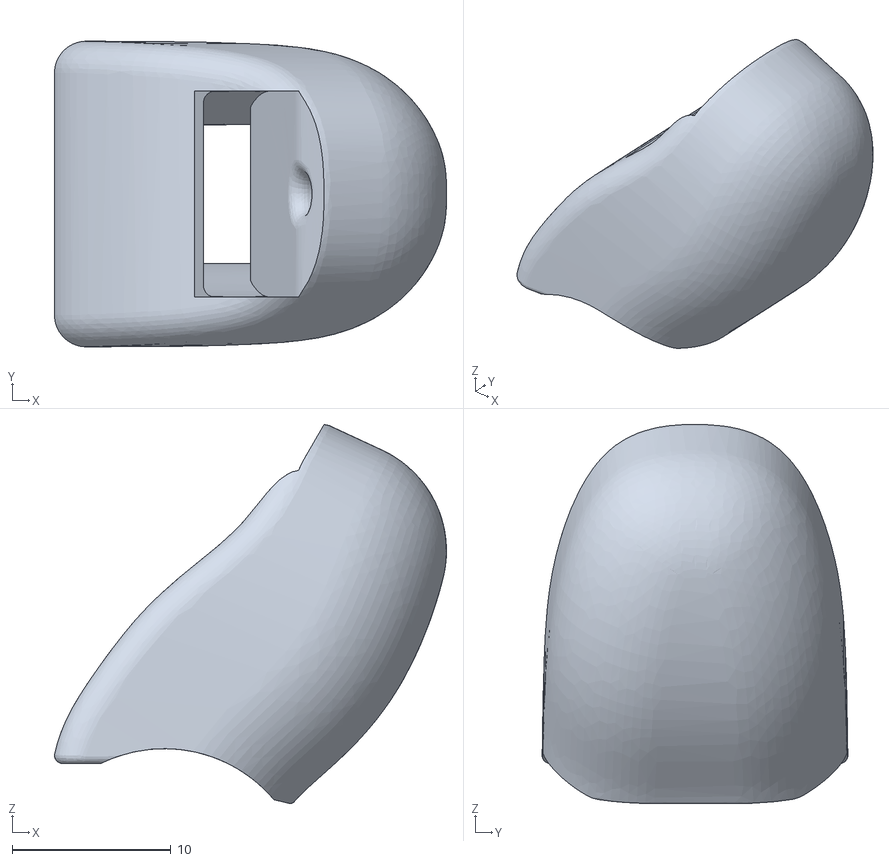
[picture p235: CAD file, 2026-11-04]
ros/src/mabel_description/meshes/hands/left/visual/left_visual_thumb_dp_skin.stl
24.7 x 19.3 x 23.9
