Klajdi00/open_mabel/ros/src/mabel_description/meshes/head/2_neck_1.stl

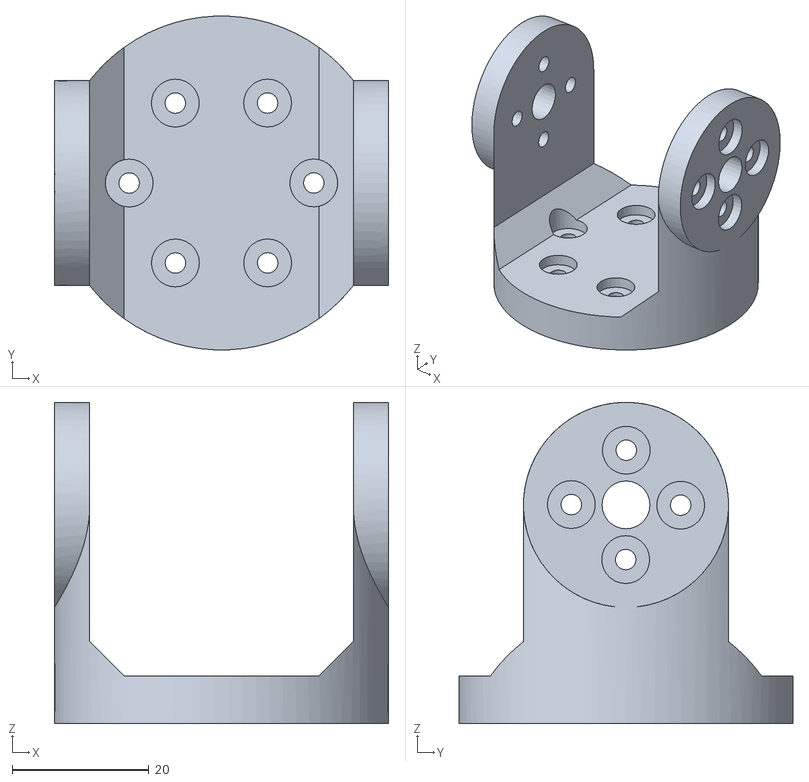
[picture p236: CAD file, 2026-11-04]
ros/src/mabel_description/meshes/head/2_neck_1.stl
48.9 x 48.8 x 47.0
