Klajdi00/open_mabel/simulation/mabel_mujoco/assets/meshes/arms/right/2_shoulder.stl

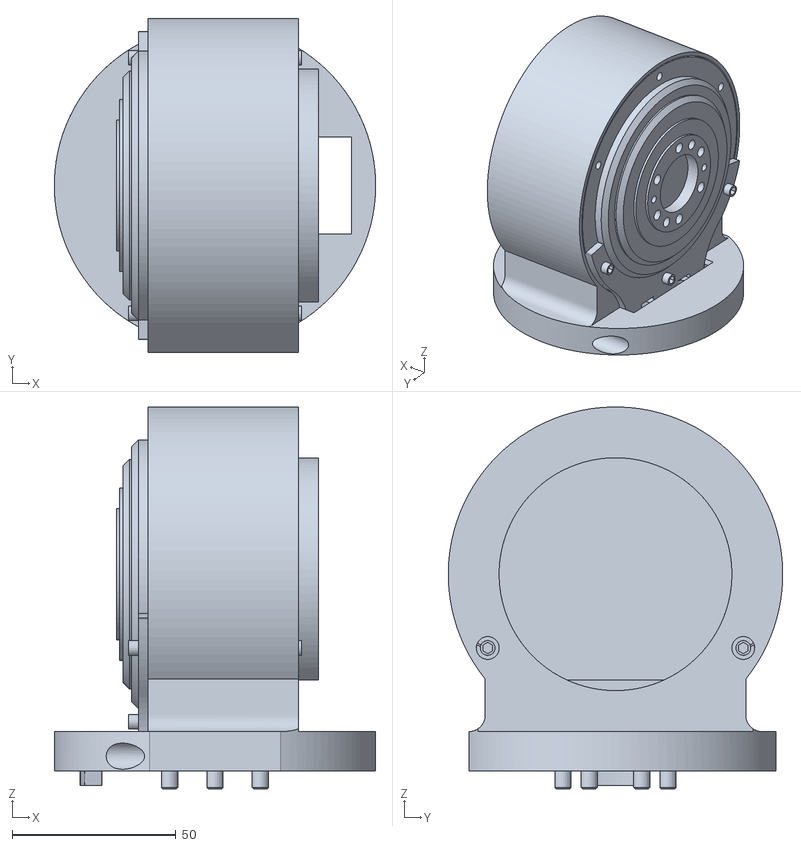
[picture p237: CAD file, 2026-11-04]
simulation/mabel_mujoco/assets/meshes/arms/right/2_shoulder.stl
98.0 x 102.0 x 116.5
