Klajdi00/open_mabel/simulation/mabel_mujoco/assets/meshes/hands/right/collision/right_collision_tower_u2d2.stl

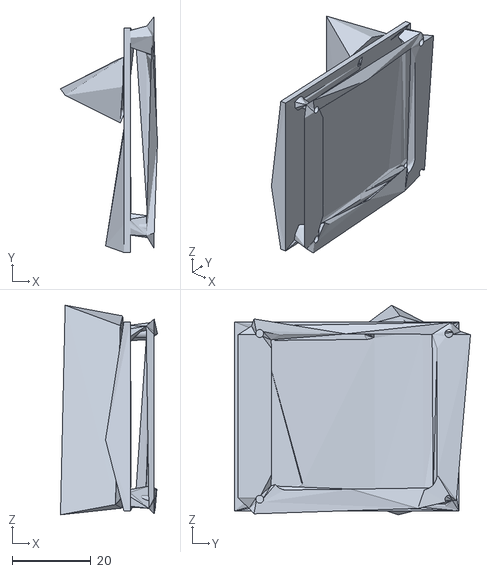
[picture p238: CAD file, 2026-11-04]
simulation/mabel_mujoco/assets/meshes/hands/right/collision/right_collision_tower_u2d2.stl
24.6 x 59.9 x 53.2
