Klajdi00/open_mabel/simulation/mabel_mujoco/assets/meshes/hands/right/visual/right_visual_index_pp.stl

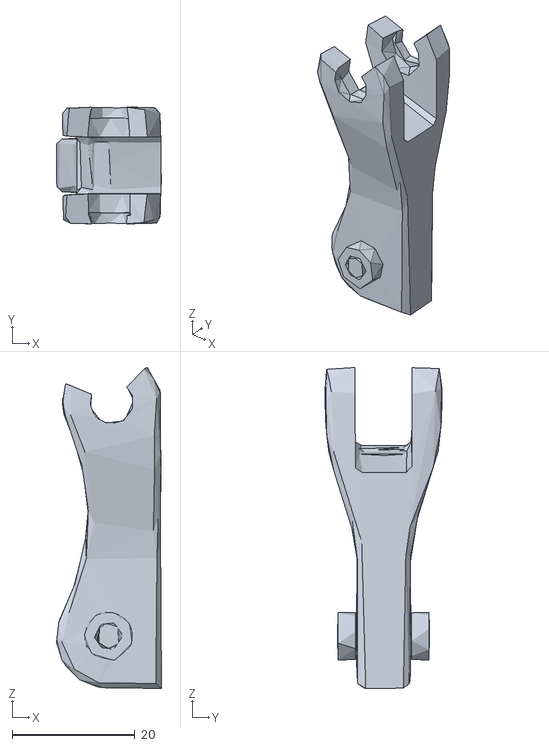
[picture p239: CAD file, 2026-11-04]
simulation/mabel_mujoco/assets/meshes/hands/right/visual/right_visual_index_pp.stl
17.1 x 19.0 x 52.3
