Klajdi00/open_mabel/simulation/mabel_mujoco/models/meshes/visual/gripper/hand_1.obj

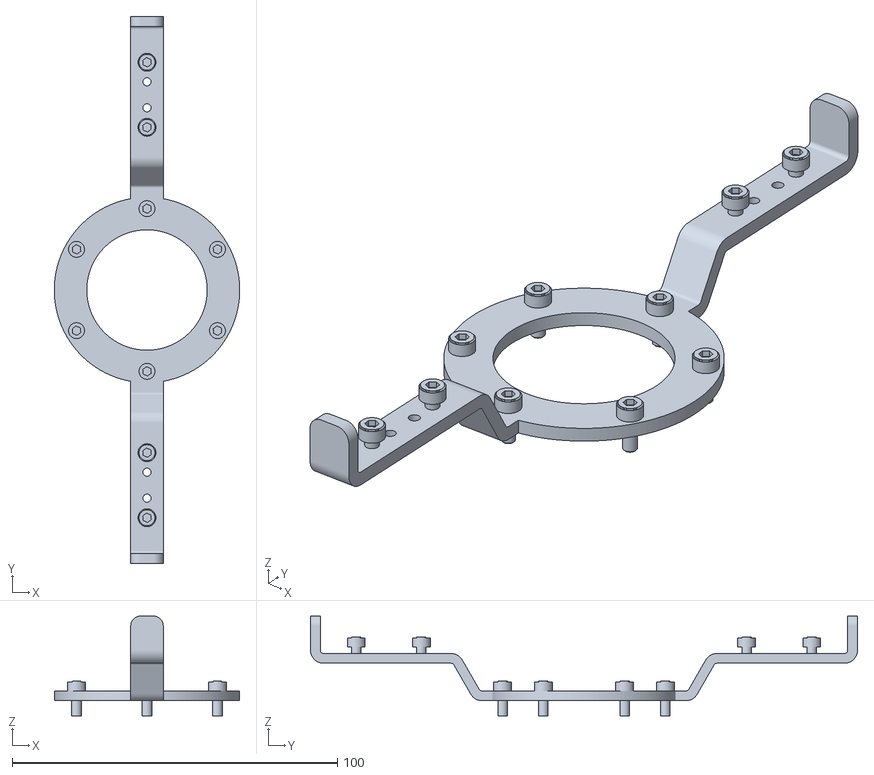
[picture p240: CAD file, 2026-11-04]
simulation/mabel_mujoco/models/meshes/visual/gripper/hand_1.obj
57.0 x 168.1 x 31.0
