Klajdi00/open_mabel/apps/ios/MABEL Mobile App/Resources/MabelRig/mabel_gripper_v1_right_gripper_finger1_finger_0.ply

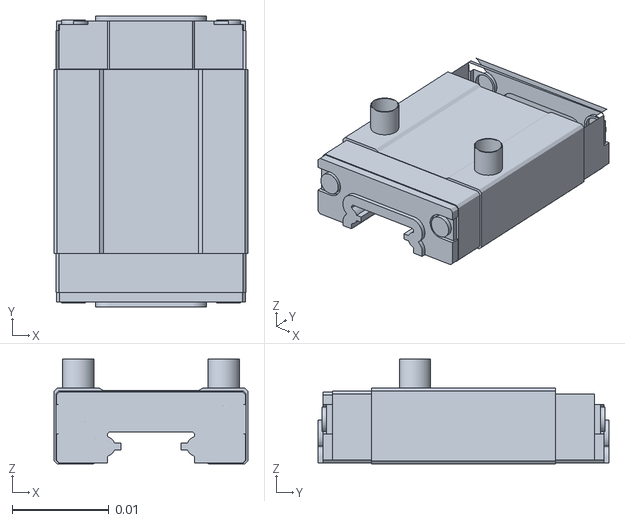
[picture p241: CAD file, 2026-11-04]
apps/ios/MABEL Mobile App/Resources/MabelRig/mabel_gripper_v1_right_gripper_finger1_finger_0.ply
0.02 x 0.03 x 0.0108
