Klajdi00/open_mabel/apps/ios/MABEL Mobile App/Resources/NovaRig/nova_hands_v1_right_thumb_mp_71.ply

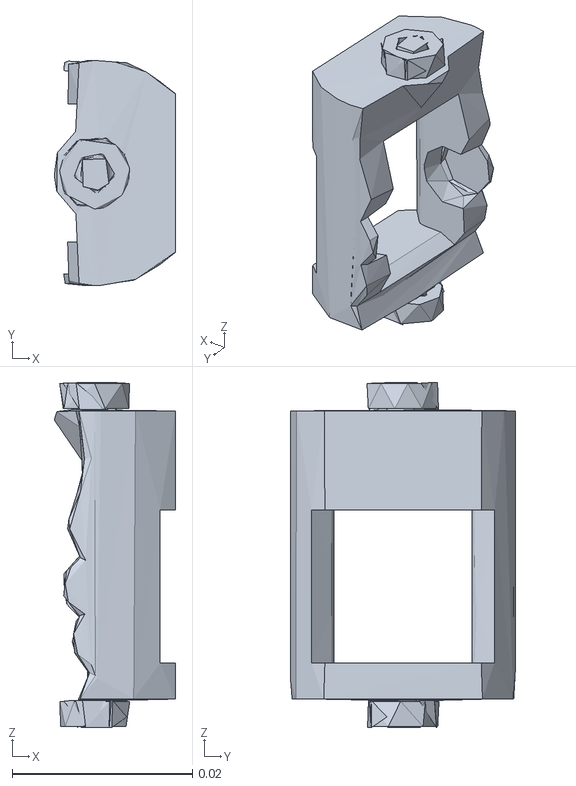
[picture p242: CAD file, 2026-11-04]
apps/ios/MABEL Mobile App/Resources/NovaRig/nova_hands_v1_right_thumb_mp_71.ply
0.0135 x 0.025 x 0.0383
