Klajdi00/open_mabel/apps/visionos/MabelTeleop/Resources/NovaRig/nova_hands_v1_left_pinky_ip_44.ply

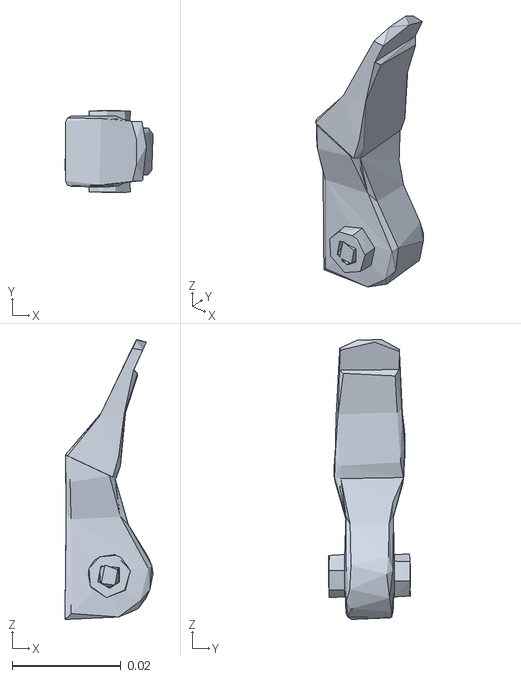
[picture p243: CAD file, 2026-11-04]
apps/visionos/MabelTeleop/Resources/NovaRig/nova_hands_v1_left_pinky_ip_44.ply
0.0162 x 0.015 x 0.0514
