Klajdi00/open_mabel/robot_learning/reinforcement_learning/mjlab/src/mjlab/asset_zoo/robots/unitree_g1/xmls/assets/right_wrist_yaw_link.STL

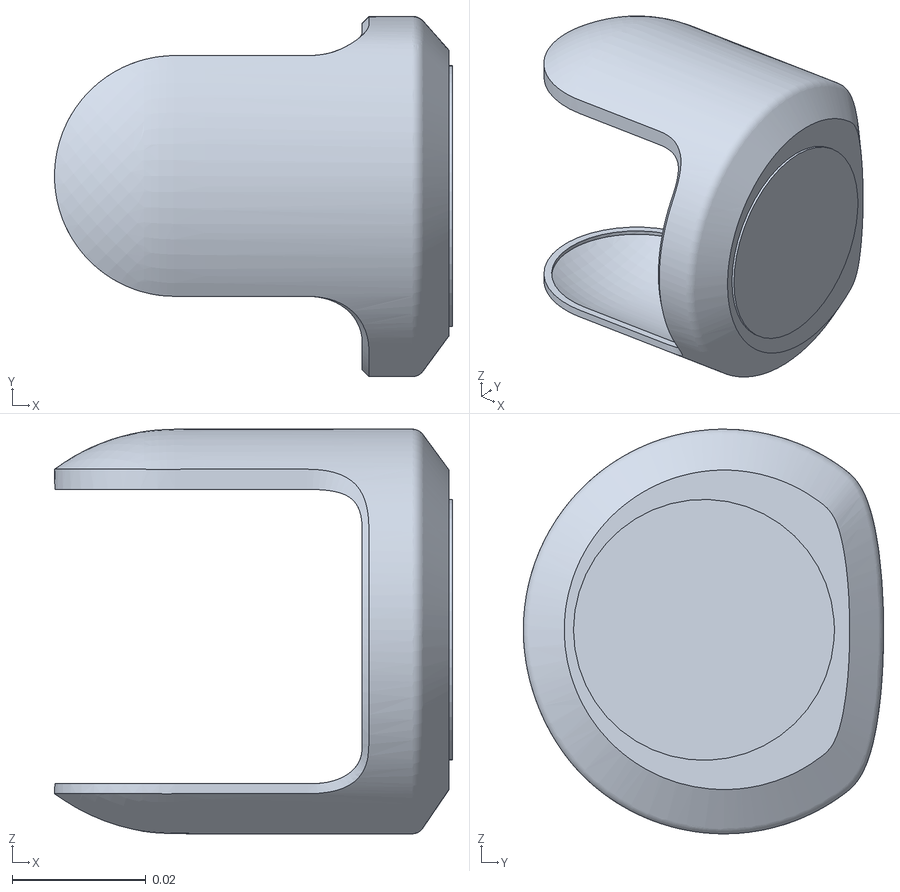
[picture p244: CAD file, 2026-11-04]
robot_learning/reinforcement_learning/mjlab/src/mjlab/asset_zoo/robots/unitree_g1/xmls/assets/right_wrist_yaw_link.STL
0.0595 x 0.0539 x 0.0605
