Klajdi00/open_mabel/robot_learning/reinforcement_learning/mjlab/src/mjlab/asset_zoo/robots/unitree_go1/xmls/assets/hip.stl

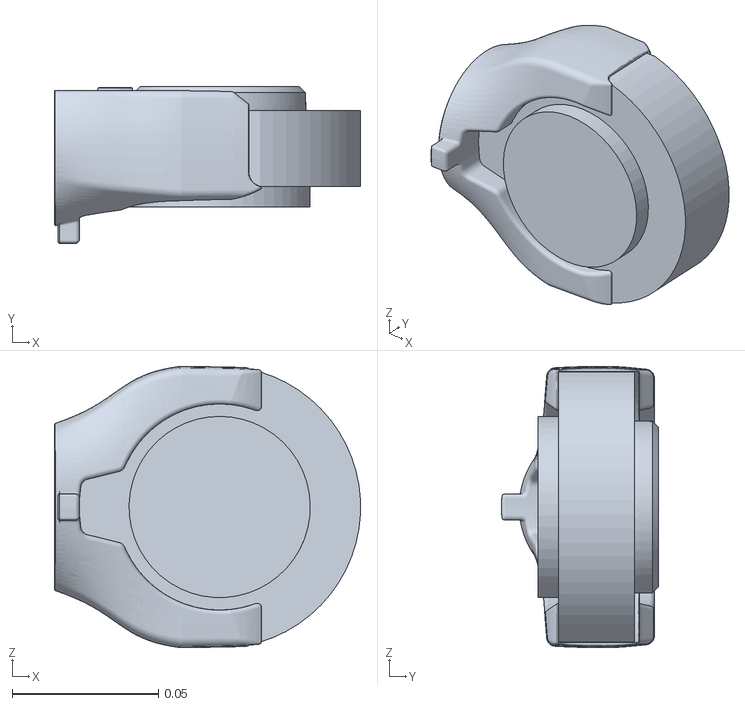
[picture p245: CAD file, 2026-11-04]
robot_learning/reinforcement_learning/mjlab/src/mjlab/asset_zoo/robots/unitree_go1/xmls/assets/hip.stl
0.105 x 0.0538 x 0.0963
