Klajdi00/open_mabel/ros/src/mabel_description/meshes/hands/left/visual/left_visual_tower_u2d2.stl

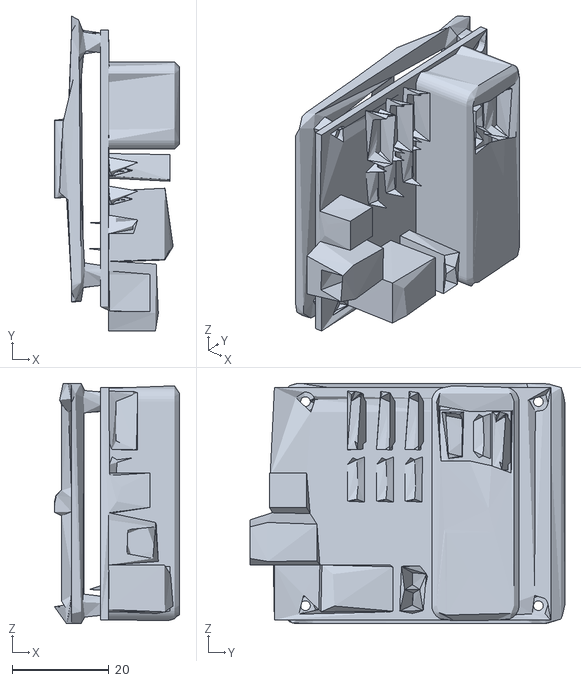
[picture p246: CAD file, 2026-11-04]
ros/src/mabel_description/meshes/hands/left/visual/left_visual_tower_u2d2.stl
25.8 x 65.0 x 49.6
