Klajdi00/open_mabel/simulation/mabel_mujoco/assets/meshes/hands/right/collision/right_collision_thumb_pp.stl

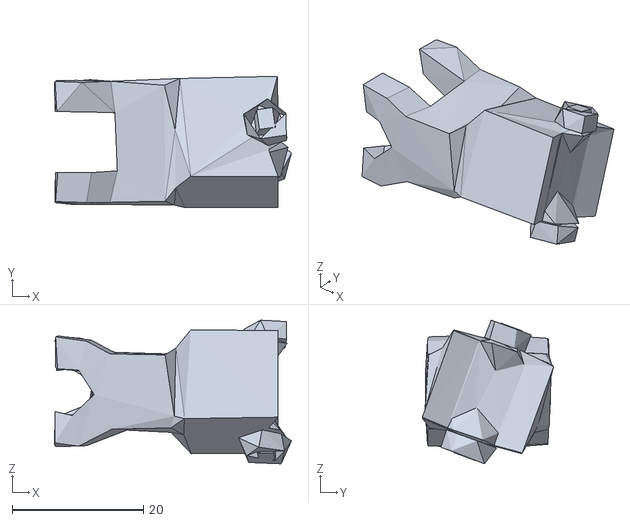
[picture p247: CAD file, 2026-11-04]
simulation/mabel_mujoco/assets/meshes/hands/right/collision/right_collision_thumb_pp.stl
36.1 x 20.0 x 21.9
