Klajdi00/open_mabel/apps/ios/MABEL Mobile App/Resources/MabelRig/rig_right_thumb_dp__v76.ply

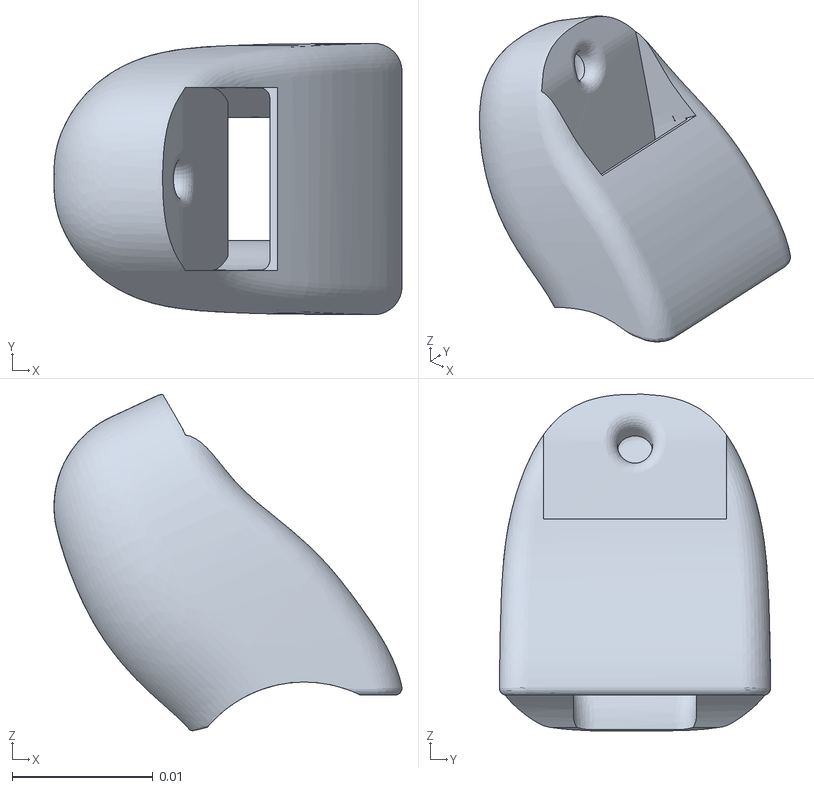
[picture p248: CAD file, 2026-11-04]
apps/ios/MABEL Mobile App/Resources/MabelRig/rig_right_thumb_dp__v76.ply
0.0247 x 0.0193 x 0.0239
