Klajdi00/open_mabel/apps/visionos/MabelTeleop/Resources/MabelRig/rig_left_middle_pp__v45.ply

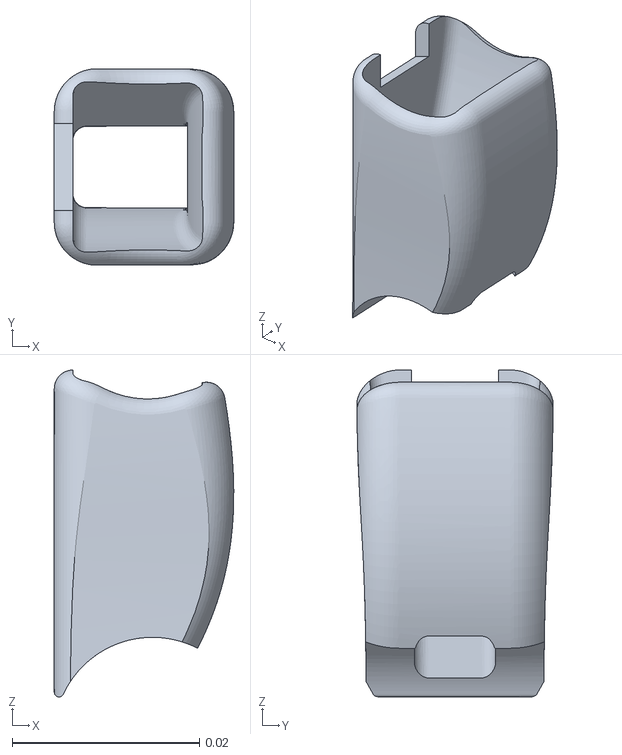
[picture p249: CAD file, 2026-11-04]
apps/visionos/MabelTeleop/Resources/MabelRig/rig_left_middle_pp__v45.ply
0.0192 x 0.021 x 0.0349
