Klajdi00/open_mabel/(list of files, cad)

Other CAD files:
ros/src/mabel_description/meshes/hands/right/collision/right_collision_tower_main.stl
ros/src/mabel_description/meshes/hands/right/visual/right_visual_tower_main.stl
simulation/mabel_mujoco/assets/meshes/hands/right/visual/right_visual_tower_main.stl
simulation/mabel_mujoco/assets/meshes/hands/right/collision/right_collision_tower_main.stl
simulation/mabel_mujoco/assets/meshes/hands/right/visual/right_visual_thumb_ip.stl
ros/src/mabel_description/meshes/arms/right/4_upper_arm.stl
ros/src/mabel_description/meshes/hands/left/visual/left_visual_ring_ip_skin.stl
ros/src/mabel_description/meshes/hands/right/visual/right_visual_thumb_ip.stl
apps/visionos/MabelTeleop/Resources/NovaRig/nova_gripper_v1_left_gripper_finger1_37.ply
simulation/mabel_mujoco/assets/meshes/arms/right/8_arm_to_hand.stl
simulation/mabel_mujoco/assets/meshes/hands/left/collision/left_collision_middle_pp_skin.stl
simulation/mabel_mujoco/models/meshes/visual/gripper/finger_1.obj
apps/ios/MABEL Mobile App/Resources/NovaRig/nova_gripper_v1_left_gripper_base_33.ply
robot_learning/reinforcement_learning/wbc_rl/assets/meshes/openarm_gripper_v1/finger_1_flip.stl
ros/src/mabel_description/meshes/arms/right/5_elbow.stl
ros/src/mabel_description/meshes/hands/right/collision/right_collision_index_ip.stl
simulation/mabel_mujoco/assets/meshes/arms/left/3_shoulder_to_elbow.stl
simulation/mabel_mujoco/assets/meshes/hands/left/visual/left_visual_index_ip_skin.stl
robot_learning/reinforcement_learning/mjlab/src/mjlab/asset_zoo/robots/i2rt_yam/xmls/assets/model2__16.stl
robot_learning/reinforcement_learning/wbc_rl/assets/meshes/openarm_gripper_v1/hand_0.stl
ros/src/mabel_description/meshes/arms/right/6_forearm.stl
ros/src/mabel_description/meshes/hands/left/collision/left_collision_thumb_ip_skin.stl
simulation/mabel_mujoco/assets/meshes/arms/right/4_upper_arm.stl
simulation/mabel_mujoco/assets/meshes/hands/left/collision/left_collision_thumb_ip.stl
simulation/mabel_mujoco/assets/meshes/hands/right/visual/right_visual_palm.stl
apps/ios/MABEL Mobile App/Resources/NovaRig/nova_rig_torso_14.ply
apps/ios/MABEL Mobile App/Resources/MabelRig/mabel_gripper_v1_left_gripper_base_hand_0.ply
apps/ios/MABEL Mobile App/Resources/MabelRig/mabel_gripper_v1_left_gripper_base_hand_1.ply
apps/ios/MABEL Mobile App/Resources/MabelRig/mabel_gripper_v1_left_gripper_finger1_finger_1.ply
apps/ios/MABEL Mobile App/Resources/MabelRig/mabel_gripper_v1_left_gripper_finger2_finger_0.ply
apps/ios/MABEL Mobile App/Resources/MabelRig/mabel_gripper_v1_left_gripper_finger2_finger_1.ply
apps/ios/MABEL Mobile App/Resources/MabelRig/mabel_gripper_v1_left_openarm_link7_link7_0.ply
apps/ios/MABEL Mobile App/Resources/MabelRig/mabel_gripper_v1_left_openarm_link7_link7_1.ply
apps/ios/MABEL Mobile App/Resources/MabelRig/mabel_gripper_v1_right_gripper_base_hand_0.ply
apps/ios/MABEL Mobile App/Resources/MabelRig/mabel_gripper_v1_right_gripper_base_hand_1.ply
apps/ios/MABEL Mobile App/Resources/MabelRig/mabel_gripper_v1_right_gripper_finger1_finger_1.ply
apps/ios/MABEL Mobile App/Resources/MabelRig/mabel_gripper_v1_right_gripper_finger2_finger_0.ply
apps/ios/MABEL Mobile App/Resources/MabelRig/mabel_gripper_v1_right_gripper_finger2_finger_1.ply
apps/ios/MABEL Mobile App/Resources/MabelRig/mabel_gripper_v1_right_openarm_link7_link7_0.ply
apps/ios/MABEL Mobile App/Resources/MabelRig/mabel_gripper_v1_right_openarm_link7_link7_1.ply
apps/ios/MABEL Mobile App/Resources/MabelRig/rig_b_steer_body__v8.ply
apps/ios/MABEL Mobile App/Resources/MabelRig/rig_b_swerve_housing__v7.ply
apps/ios/MABEL Mobile App/Resources/MabelRig/rig_b_wheel__v9.ply
apps/ios/MABEL Mobile App/Resources/MabelRig/rig_body_mount__v13.ply
apps/ios/MABEL Mobile App/Resources/MabelRig/rig_fl_steer_body__v2.ply
apps/ios/MABEL Mobile App/Resources/MabelRig/rig_fl_swerve_housing__v1.ply
apps/ios/MABEL Mobile App/Resources/MabelRig/rig_fl_wheel__v3.ply
apps/ios/MABEL Mobile App/Resources/MabelRig/rig_fr_steer_body__v5.ply
apps/ios/MABEL Mobile App/Resources/MabelRig/rig_fr_swerve_housing__v4.ply
apps/ios/MABEL Mobile App/Resources/MabelRig/rig_fr_wheel__v6.ply
apps/ios/MABEL Mobile App/Resources/MabelRig/rig_head__v18.ply
apps/ios/MABEL Mobile App/Resources/MabelRig/rig_l_arm_mount__v19.ply
apps/ios/MABEL Mobile App/Resources/MabelRig/rig_l_elbow__v23.ply
apps/ios/MABEL Mobile App/Resources/MabelRig/rig_l_forearm__v24.ply
apps/ios/MABEL Mobile App/Resources/MabelRig/rig_l_hand_mount__v26.ply
apps/ios/MABEL Mobile App/Resources/MabelRig/rig_l_shoulder_1__v20.ply
apps/ios/MABEL Mobile App/Resources/MabelRig/rig_l_shoulder_2__v21.ply
apps/ios/MABEL Mobile App/Resources/MabelRig/rig_l_shoulder_3__v22.ply
apps/ios/MABEL Mobile App/Resources/MabelRig/rig_l_wrist__v25.ply
apps/ios/MABEL Mobile App/Resources/MabelRig/rig_left_index_ip__v41.ply
apps/ios/MABEL Mobile App/Resources/MabelRig/rig_left_index_pp__v39.ply
apps/ios/MABEL Mobile App/Resources/MabelRig/rig_left_index_pp__v40.ply
apps/ios/MABEL Mobile App/Resources/MabelRig/rig_left_middle_ip__v46.ply
apps/ios/MABEL Mobile App/Resources/MabelRig/rig_left_middle_pp__v44.ply
apps/ios/MABEL Mobile App/Resources/MabelRig/rig_left_palm__v30.ply
apps/ios/MABEL Mobile App/Resources/MabelRig/rig_left_palm__v31.ply
apps/ios/MABEL Mobile App/Resources/MabelRig/rig_left_pinky_ip__v56.ply
apps/ios/MABEL Mobile App/Resources/MabelRig/rig_left_pinky_pp__v54.ply
apps/ios/MABEL Mobile App/Resources/MabelRig/rig_left_ring_ip__v51.ply
apps/ios/MABEL Mobile App/Resources/MabelRig/rig_left_ring_pp__v49.ply
apps/ios/MABEL Mobile App/Resources/MabelRig/rig_left_thumb_dp__v36.ply
apps/ios/MABEL Mobile App/Resources/MabelRig/rig_left_thumb_dp__v37.ply
apps/ios/MABEL Mobile App/Resources/MabelRig/rig_left_thumb_ip__v34.ply
apps/ios/MABEL Mobile App/Resources/MabelRig/rig_left_thumb_mp__v32.ply
apps/ios/MABEL Mobile App/Resources/MabelRig/rig_left_tower__v27.ply
apps/ios/MABEL Mobile App/Resources/MabelRig/rig_left_tower__v28.ply
apps/ios/MABEL Mobile App/Resources/MabelRig/rig_left_tower__v29.ply
apps/ios/MABEL Mobile App/Resources/MabelRig/rig_lift_base__v10.ply
apps/ios/MABEL Mobile App/Resources/MabelRig/rig_lift_mid__v11.ply
apps/ios/MABEL Mobile App/Resources/MabelRig/rig_lift_top__v12.ply
apps/ios/MABEL Mobile App/Resources/MabelRig/rig_mabel_chassis__v0.ply
apps/ios/MABEL Mobile App/Resources/MabelRig/rig_neck_1__v16.ply
apps/ios/MABEL Mobile App/Resources/MabelRig/rig_neck_2__v17.ply
apps/ios/MABEL Mobile App/Resources/MabelRig/rig_r_arm_mount__v58.ply
apps/ios/MABEL Mobile App/Resources/MabelRig/rig_r_elbow__v62.ply
apps/ios/MABEL Mobile App/Resources/MabelRig/rig_r_forearm__v63.ply
apps/ios/MABEL Mobile App/Resources/MabelRig/rig_r_hand_mount__v65.ply
apps/ios/MABEL Mobile App/Resources/MabelRig/rig_r_shoulder_1__v59.ply
apps/ios/MABEL Mobile App/Resources/MabelRig/rig_r_shoulder_2__v60.ply
apps/ios/MABEL Mobile App/Resources/MabelRig/rig_r_shoulder_3__v61.ply
apps/ios/MABEL Mobile App/Resources/MabelRig/rig_r_wrist__v64.ply
apps/ios/MABEL Mobile App/Resources/MabelRig/rig_right_index_ip__v80.ply
apps/ios/MABEL Mobile App/Resources/MabelRig/rig_right_index_ip__v81.ply
apps/ios/MABEL Mobile App/Resources/MabelRig/rig_right_index_mp__v77.ply
apps/ios/MABEL Mobile App/Resources/MabelRig/rig_right_index_pp__v78.ply
apps/ios/MABEL Mobile App/Resources/MabelRig/rig_right_index_pp__v79.ply
apps/ios/MABEL Mobile App/Resources/MabelRig/rig_right_middle_ip__v85.ply
apps/ios/MABEL Mobile App/Resources/MabelRig/rig_right_middle_ip__v86.ply
apps/ios/MABEL Mobile App/Resources/MabelRig/rig_right_middle_mp__v82.ply
apps/ios/MABEL Mobile App/Resources/MabelRig/rig_right_middle_pp__v83.ply
apps/ios/MABEL Mobile App/Resources/MabelRig/rig_right_middle_pp__v84.ply
apps/ios/MABEL Mobile App/Resources/MabelRig/rig_right_palm__v69.ply
apps/ios/MABEL Mobile App/Resources/MabelRig/rig_right_palm__v70.ply
apps/ios/MABEL Mobile App/Resources/MabelRig/rig_right_pinky_ip__v95.ply
apps/ios/MABEL Mobile App/Resources/MabelRig/rig_right_pinky_ip__v96.ply
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
