Klajdi00/open_mabel/controller/docs/figures/pdtune_step.pdf

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

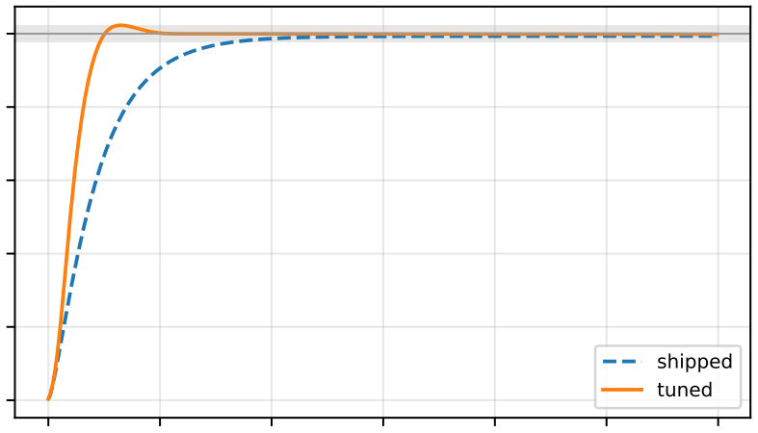
[picture p255: figure]
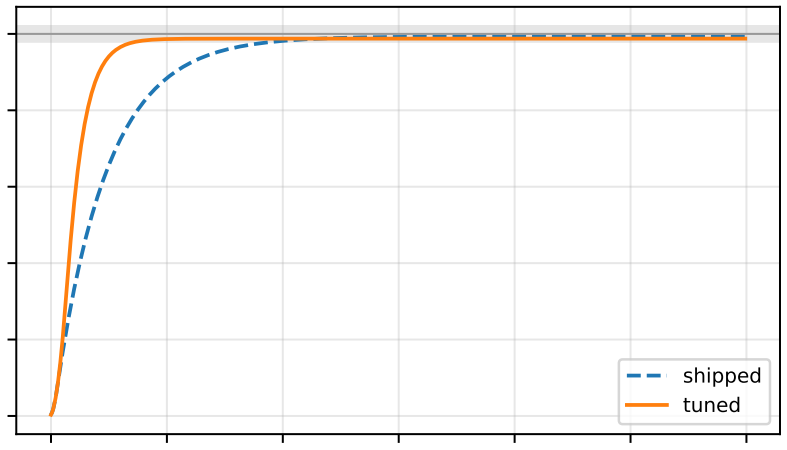
[picture p256: figure]
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
