Klajdi00/open_mabel/simulation/mabel_mujoco/docs/figures/step_response.pdf

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

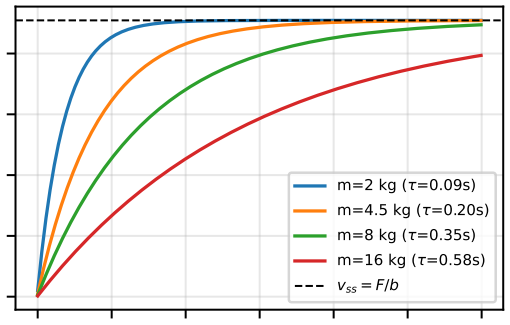
[picture p257: figure]
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
