Klajdi00/open_mabel/robot_learning/reinforcement_learning/mjlab/mabel/docs/figures/bimanual_scene.png

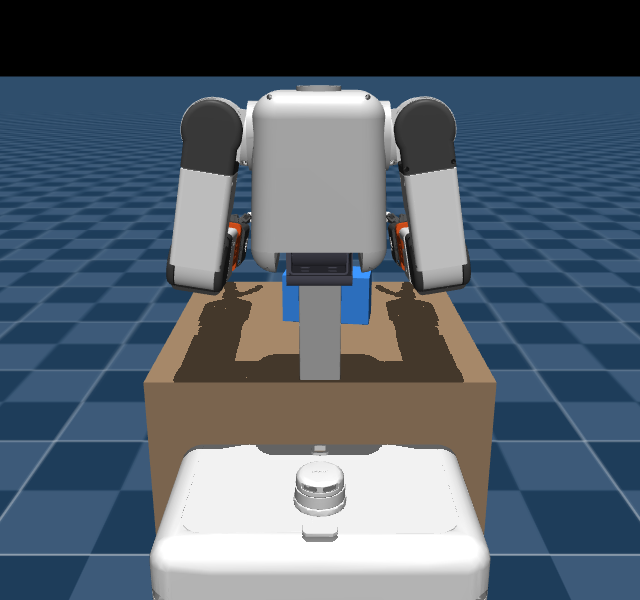
robot_learning/reinforcement_learning/mjlab/mabel/docs/figures/bimanual_scene.png
