Klajdi00/open_mabel/simulation/mabel_mujoco/scenes/thumbs/.small/assembly_line.jpg

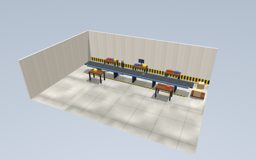
simulation/mabel_mujoco/scenes/thumbs/.small/assembly_line.jpg
