Klajdi00/open_mabel/calibration/arm_calibration/docs/ARM_CALIBRATION.pdf

## MABEL Arm Inertial-Parameter Calibration

Identifying link mass and centre of mass of the 7-DOF right arm for inverse dynamics and gravity compensation

MABEL calibration

June 16, 2026

This package (mabel sysid) identifies the rigid-body inertial parameters — link mass mi and centre of mass ci — of the MABEL right arm, for use in the inverse-dynamics and gravity-compensation feed-forward terms. It deliberately treats the joints as ideal (zero friction and damping); those neglected motor/gearbox effects are identified separately by the companion mabel actid package (see ACTUATOR CALIBRATION.pdf). The whole pipeline is proven in simulation first: the known MuJoCo masses are taken as ground truth, scrambled, and recovered.

## Contents

1 Method | 1
2 Identifiability | 2
3 Simulation validation and results | 2
4 Applying to the real robot | 2

## 1 Method

### 1.1 Linear-in-parameters dynamics

The equation of motion of the arm is

M(q) ¨q + C(q, q˙) ˙q + g(q) = τ. | (1)
Although M, C, g are nonlinear in the joint angles q, each link contributes its mass mi | , first moment

φi = mici ∈ R

3
, and inertia tensor Ii ∈ R

3×3
, and the dynamics are linear in this 10-parameterper-link vector π:
τ = Y (q, q,˙ q¨) π, | (2)

with Y the regressor. Identification is therefore a linear regression: stack the rows Y (qk, q˙k, q¨k) measured along a trajectory and solve a least-squares problem for π. Code: src/mabel sysid/regressor.py, identify.py.

### 1.2 Gravity needs only the first moments

Gravity compensation requires only g(q), which depends solely on the first moments φi = mici (not the full inertia, and not mi and ci separately):

g(q) = X

i

∂
∂q
− mi g

⊤ri(q)
= Yg(q) φ, | (3)

so a set of static holding poses — where ˙q = ¨q = 0 and the measured torque is exactly g(q) — is enough to fit the gravity model. This is the cheapest and most robust experiment.

### 1.3 Two estimators

| Method B (linear). Closed-form least squares on the analytic gravity regressor Yg over
| the static poses; returns the first moments φ directly and exposes observability through the
| singular spectrum of Yg.
| Method A (nonlinear). A MuJoCo-in-the-loop optimiser that adjusts (mi , ci) to match
| the full inverse-dynamics torque over static poses plus a Fourier excitation trajectory; this is
| what separates mi from ci (mass enters only through the acceleration term M(q)¨q).

## 2 Identifiability

A fundamental limit governs how much can be recovered. Static (gravity) data sees only first moments mici

| , so a link’s own mass — which barely moves its frame origin — is unobservable
from gravity alone. Separating mass from COM needs acceleration. In general only certain fixed combinations, the base parameters, are identifiable; the rest lie in the regressor’s null space.
For the MABEL arm the gravity regressor has 7 × 4 = 28 parameters but only 14 observable directions (Table 1): the singular spectrum drops by ∼10 orders of magnitude after the 14th value. The controller only needs those identifiable combinations — and they are recovered to the noise floor — so gravity compensation is excellent even though some individual link masses remain partly indeterminate.

## 3 Simulation validation and results

The model is built from the full robot (tools/extract arm model.py slices the right-arm chain out of mabel full.xml, fixes it to the world with a small base tilt so gravity excites every joint, and zeroes joint friction/damping). The true masses are read, scrambled by ±30% (with COMs shifted up to ±2 cm) to form a “CAD prior”, and then identified from 2250 noisy samples (στ = 0.05 N m). The torque predictions improve by roughly 50×, well below the 0.05 N m sensor-noise floor. Per-link mass (Table 2) is only partially corrected — the expected identifiability limit — while the controller-relevant first moments and the torque fit are essentially exact.

## 4 Applying to the real robot

The procedure is identical except for the data source. Replace the synthetic dataset with recorded (q, q,˙ q, τ ¨ ): command static poses spanning the workspace and log the steady holding torque (iq·Kt
| ,
gravity-consistent) for gravity comp; add a smooth Fourier excitation and filtered differentiation for the full inverse-dynamics fit. Use the CAD values as the prior, validate on held-out poses, and load

Table 1: Gravity-compensation and inverse-dynamics validation. “before” uses the scrambled prior; “after” uses the identified parameters, on held-out poses.
metric | before (prior) after (identified)
gravity-torque RMS (N m) | 0.2024 | 0.0037
inverse-dynamics torque RMS (N m) | 0.4038 | 0.0038
COM mean abs. error (mm) | — | 11.4
per-link mass MAE (kg) | — | 0.117
observable directions / params | 14 / 28

Table 2: Per-link mass: ground truth vs. identified (nonlinear and linear estimators). Distal links recover well; large proximal links stay partly in the null space.
link | true (kg) id. nonlinear (kg) id. linear (kg)
r shoulder 1 | 0.731 | 0.592 | 0.571
r shoulder 2 | 0.698 | 0.672 | 0.712
r shoulder 3 | 1.466 | 1.904 | 1.893
r elbow | 0.942 | 0.978 | 1.006
r forearm | 0.837 | 0.698 | 0.644
r wrist | 0.309 | 0.338 | 0.280
r hand mount | 0.318 | 0.332 | 0.395

the result into the controller’s feed-forward term τff = τrb(q, q,˙ q¨), on top of which the mabel actid friction term is added. Account for the joint friction/damping that is zeroed here (identify it, or include it in τ ), and make sure the mount orientation relative to gravity is correct.

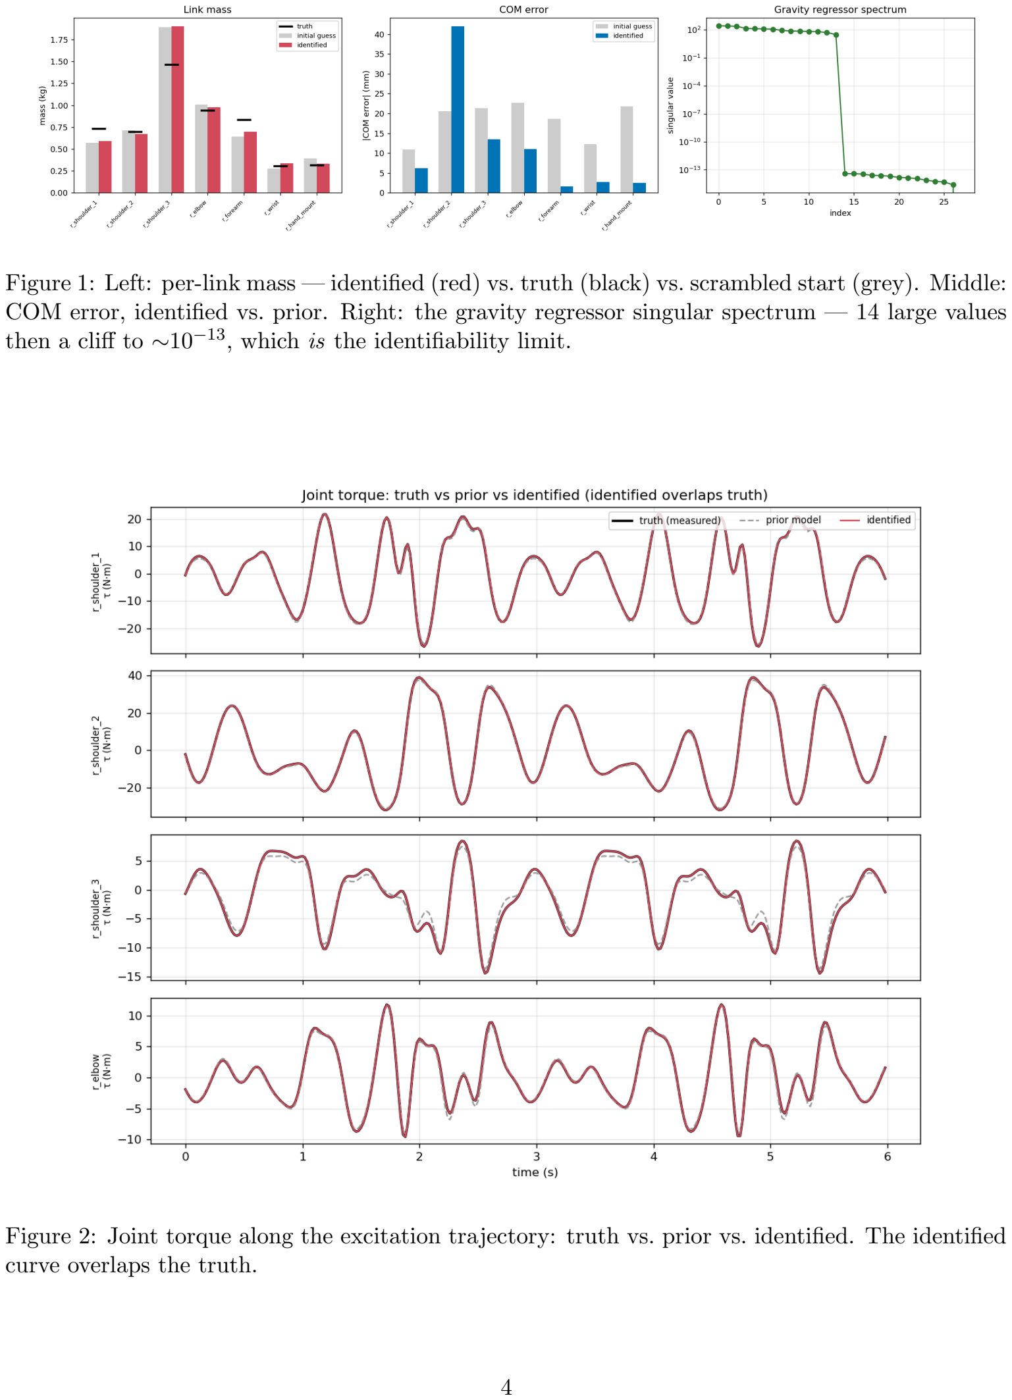
[picture p266: page 4]

Figure 1: Left: per-link mass — identified (red) vs. truth (black) vs. scrambled start (grey). Middle: COM error, identified vs. prior. Right: the gravity regressor singular spectrum — 14 large values then a cliff to ∼10⁻¹³, which is the identifiability limit.

Figure 2: Joint torque along the excitation trajectory: truth vs. prior vs. identified. The identified curve overlaps the truth.
