Klajdi00/open_mabel/calibration/arm_calibration/docs/figures/e10_systematic.pdf

### Systematic errors set the floor; random noise does not

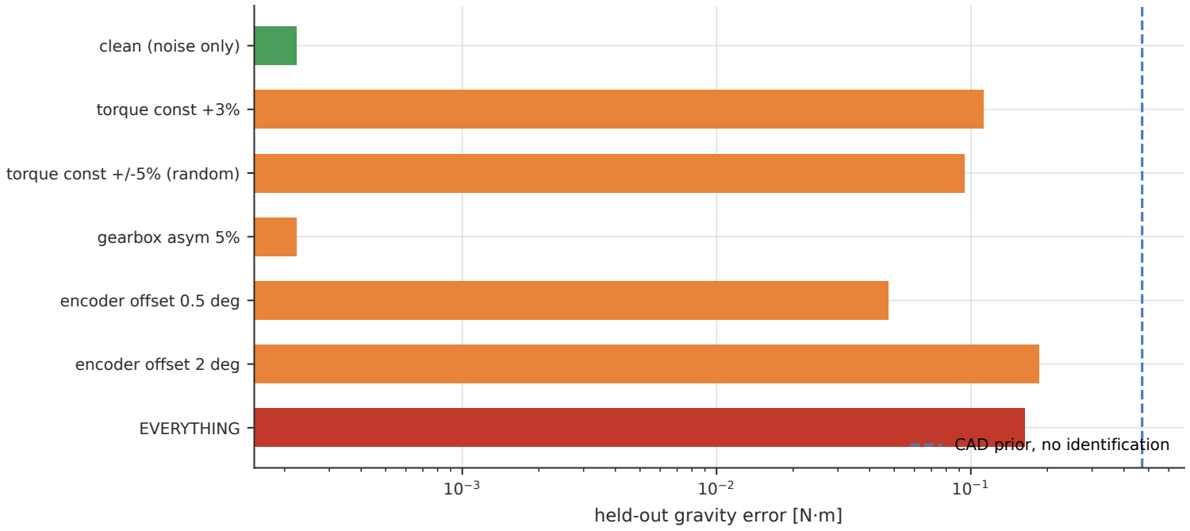
[picture p269: figure]
held-out gravity error [N⋅m]; clean (noise only); torque const +3%; torque const +/-5% (random); gearbox asym 5%; encoder offset 0.5 deg; encoder offset 2 deg; EVERYTHING; CAD prior, no identification
