Klajdi00/open_mabel/calibration/arm_calibration/docs/figures/e2_signal_vs_friction.pdf

### The wrist joints' entire gravity signal is the size of their friction

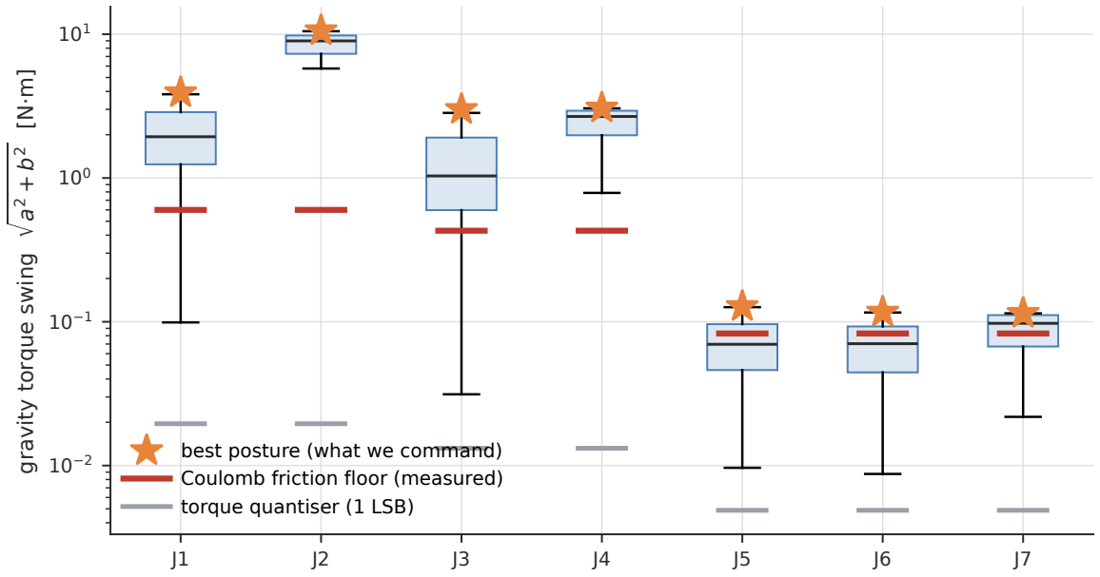
[picture p270: figure]
gravity torque swing √; best posture (what we command) Coulomb friction floor (measured) torque quantiser (1 LSB)
