Klajdi00/open_mabel/calibration/arm_calibration/docs/figures/e3_protocol.pdf

unidirectional | bidirectional

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
held-out gravity

error [N⋅m]

Skipping the return pass costs more than the identification gains

CAD prior (no ID)

J1 | J2 | J3 | J4 | J5 | J6 | J7

0.0000

0.0001

0.0002

0.0003

0.0004

0.0005

| ̂ τc −

τc| [N⋅m]

Coulomb friction recovered in situ (bonus of the return pass)
