Klajdi00/open_mabel/calibration/arm_calibration/docs/figures/e4_accuracy.pdf

### Gravity torque: identified beats CAD by 10-100x

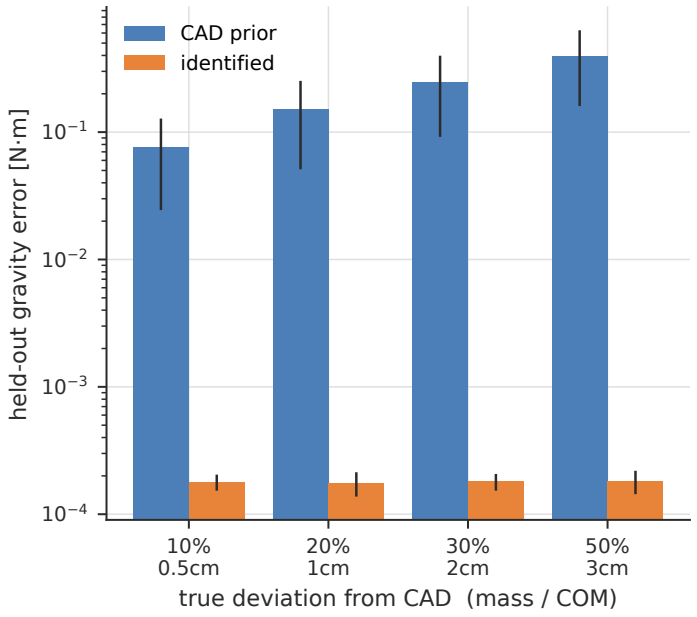
[picture p271: figure]
50% 3cm true deviation from CAD (mass / COM); held-out gravity; error [N⋅m]; CAD prior identified

10%
0.5cm

20%
1cm

30%
2cm

50%
3cm
true deviation from CAD (mass / COM)

0.000

0.025

0.050

0.075

0.100

0.125

0.150

0.175

### Per-link mass stays wrong -- and that is fine (it lives in the blind subspace)

per-link mass MAE [kg]
gravity error [N⋅m]
