Klajdi00/open_mabel/calibration/arm_calibration/docs/figures/e8_gravity_comp.pdf

J1 | J2 | J3 | J4 | J5 | J6 | J7

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
residual gravity torque [N⋅m]

### After identification the model error hides under the friction

Coulomb friction (the achievable floor) CAD prior
identified
