Klajdi00/open_mabel/controller/docs/figures/teleop_benchmark.pdf

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

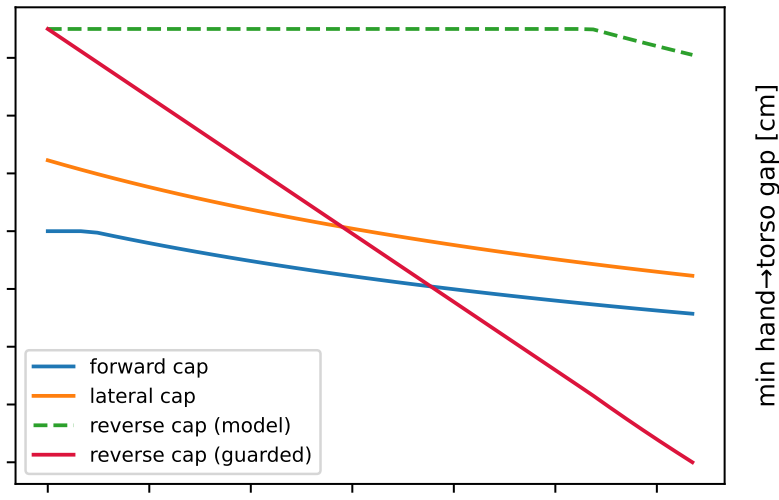
[picture p272: figure]
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
