Klajdi00/open_mabel/calibration/arm_calibration/results/excitation_trajectory.png

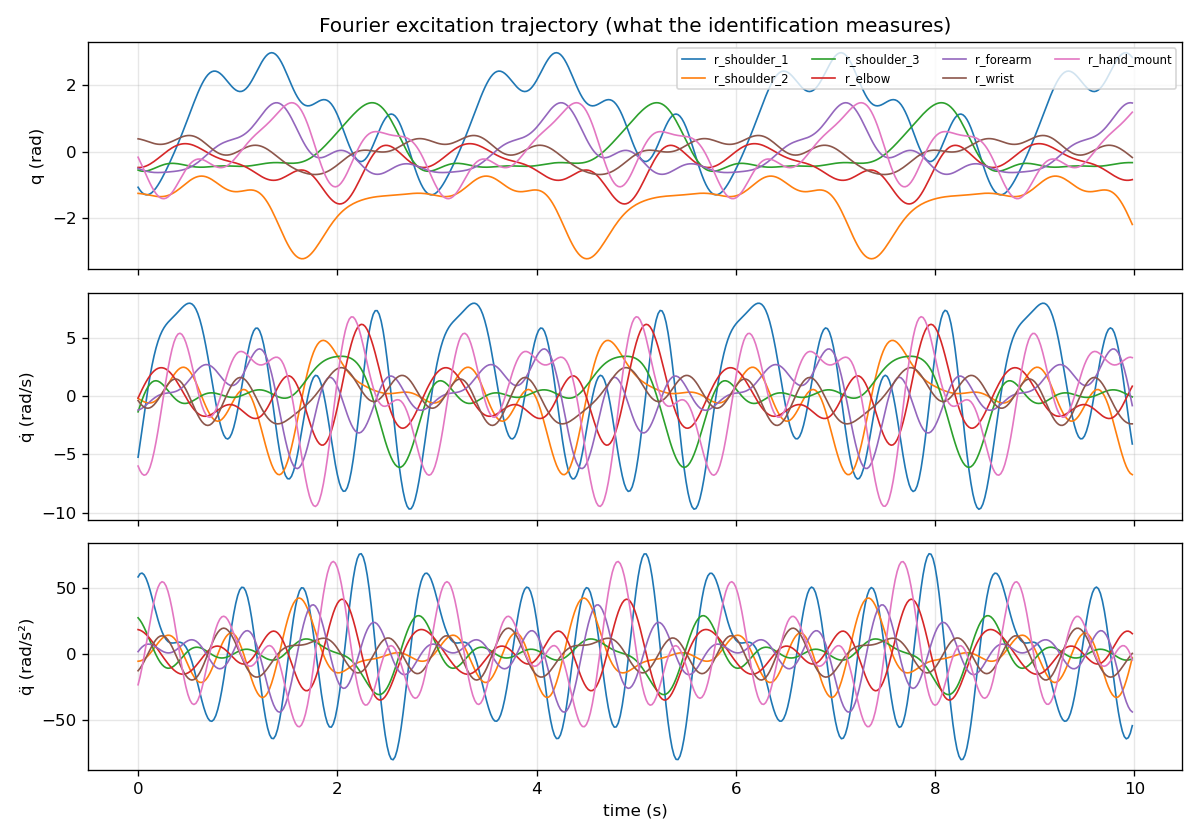
calibration/arm_calibration/results/excitation_trajectory.png
