Klajdi00/open_mabel/calibration/arm_calibration/results/torque_fit.png

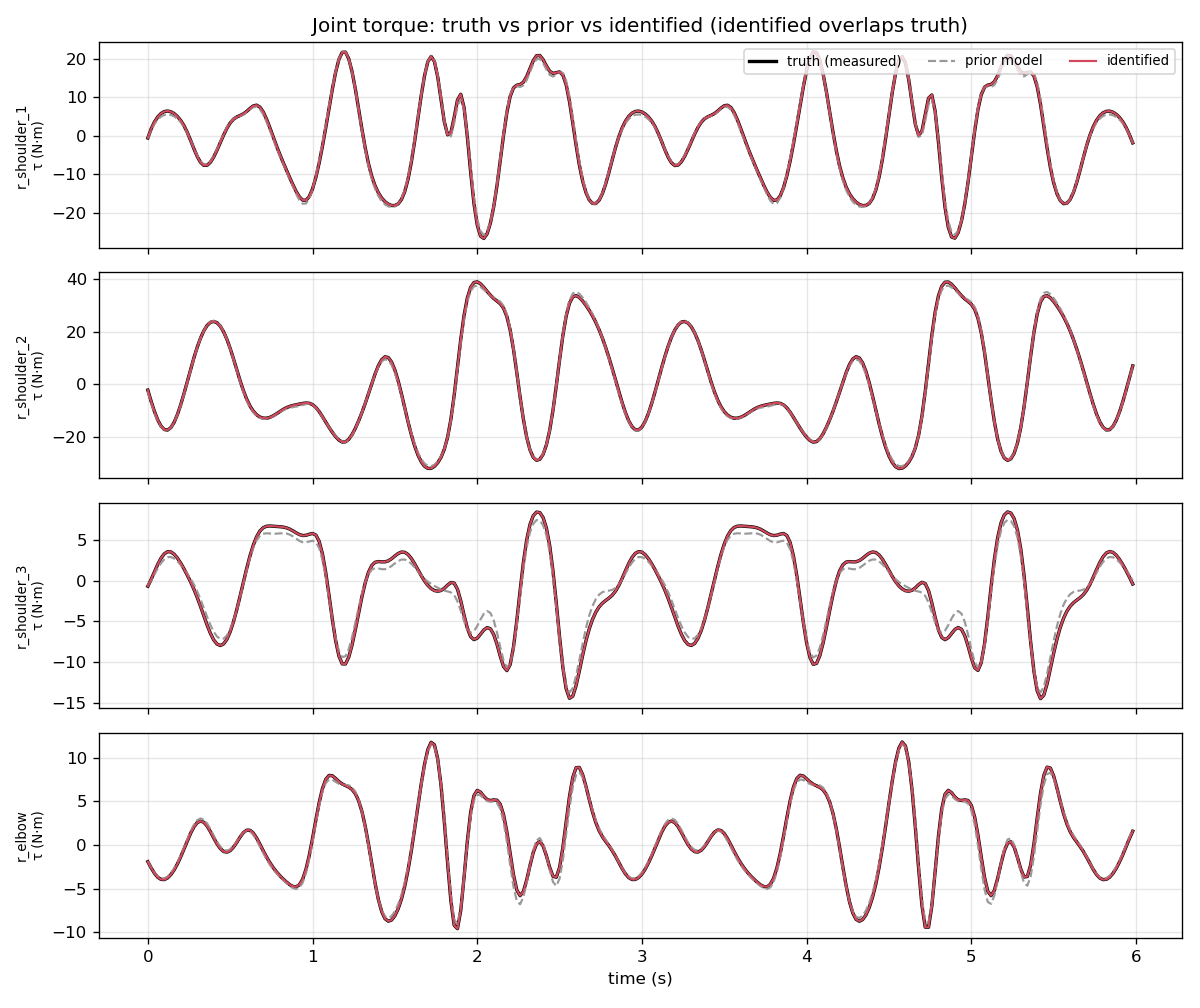
calibration/arm_calibration/results/torque_fit.png
