Klajdi00/open_mabel/calibration/experiments/act_DM-J4340_friction_curve.png

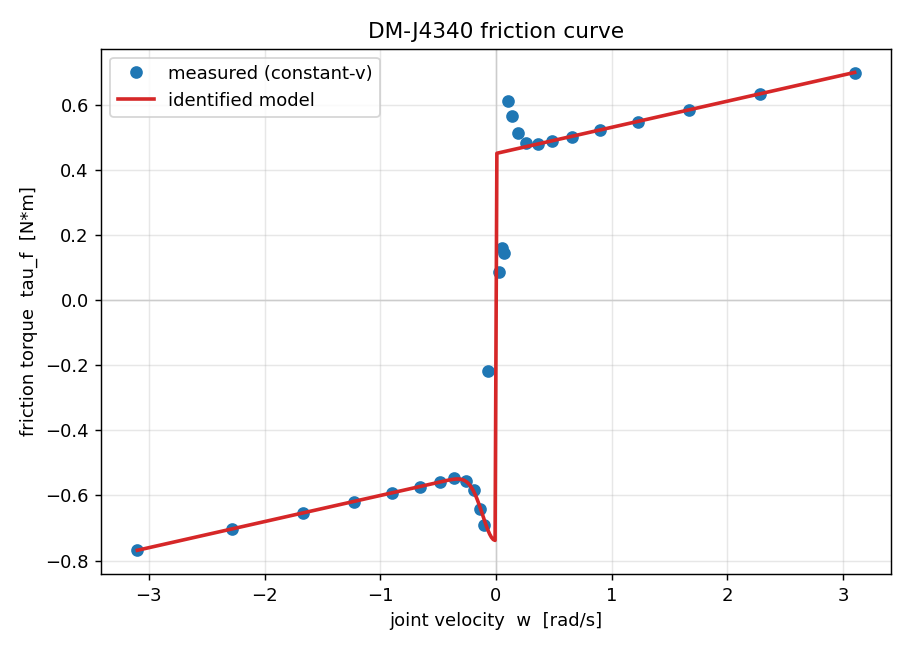
calibration/experiments/act_DM-J4340_friction_curve.png
