Klajdi00/open_mabel/calibration/experiments/act_DM-J4340_torque_fit.png

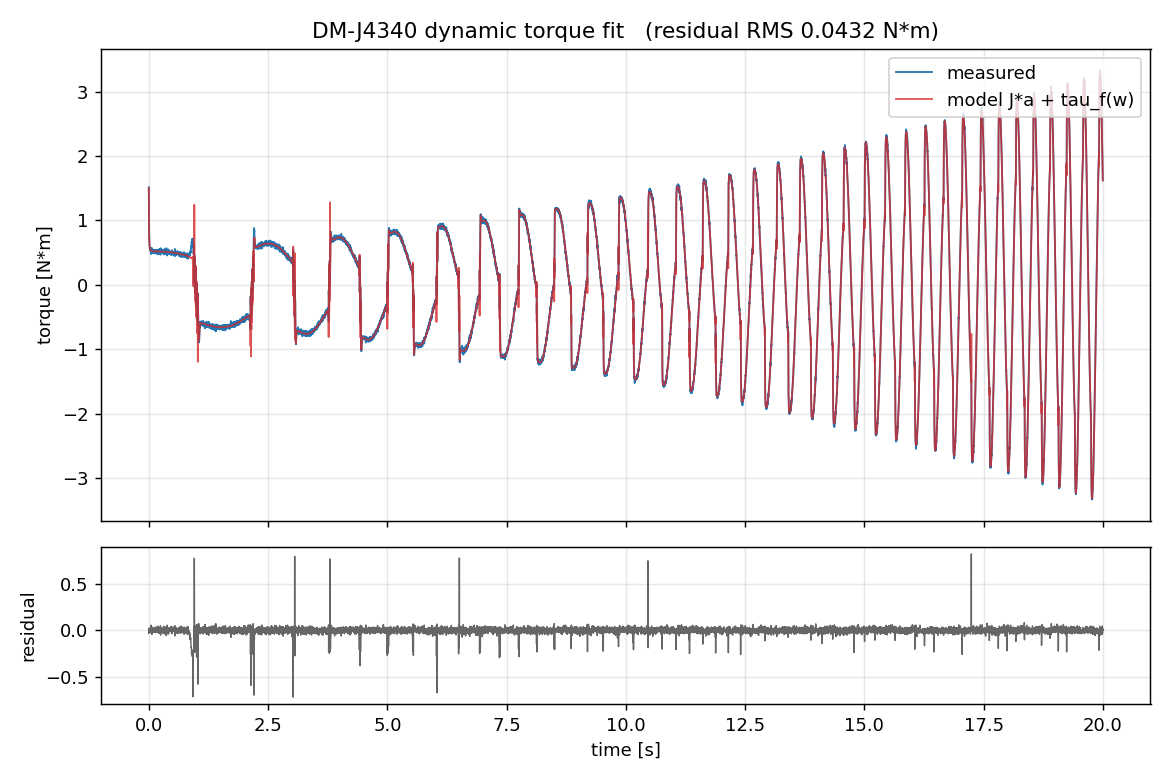
calibration/experiments/act_DM-J4340_torque_fit.png
