Klajdi00/open_mabel/calibration/motor_calibration/results/DM-J4310/plots/friction_curve.png

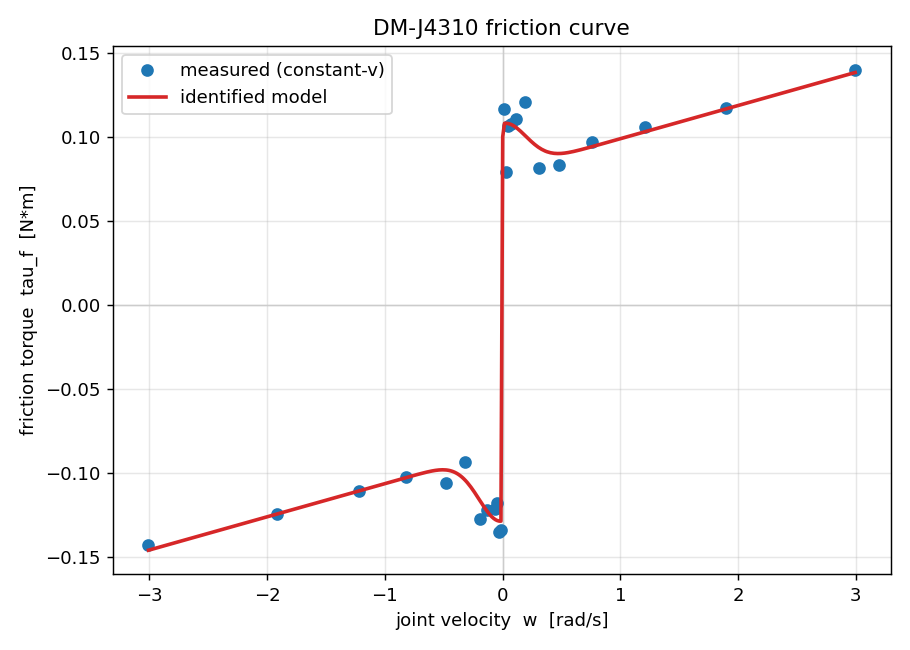
calibration/motor_calibration/results/DM-J4310/plots/friction_curve.png
