Klajdi00/open_mabel/calibration/motor_calibration/results/DM-J4340P/plots/friction_curve.png

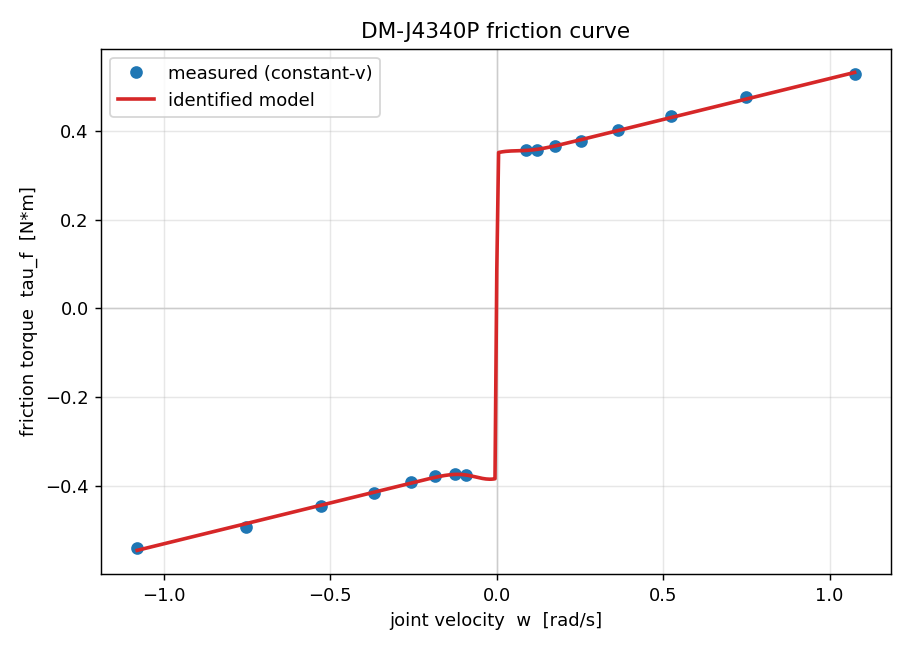
calibration/motor_calibration/results/DM-J4340P/plots/friction_curve.png
