Klajdi00/open_mabel/calibration/motor_calibration/results/DM-J4340P/plots/torque_fit.png

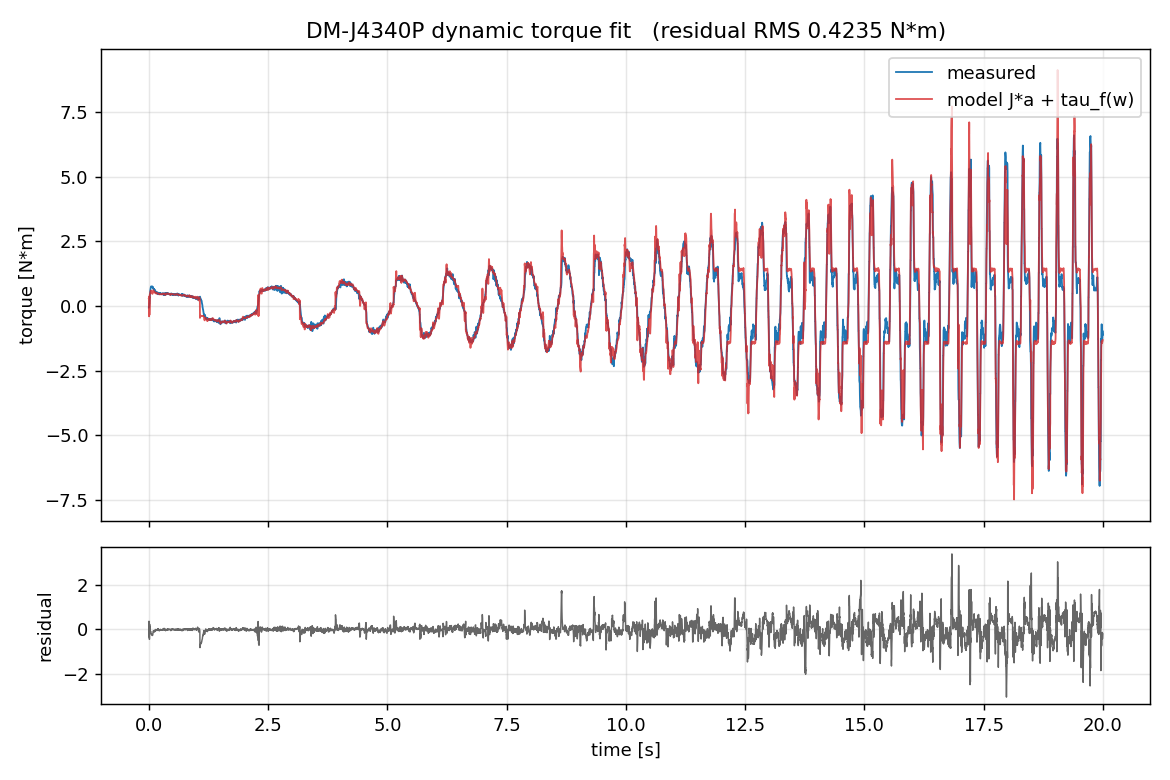
calibration/motor_calibration/results/DM-J4340P/plots/torque_fit.png
