Klajdi00/open_mabel/calibration/motor_calibration/results/DM-J4340P/plots/torque_speed.png

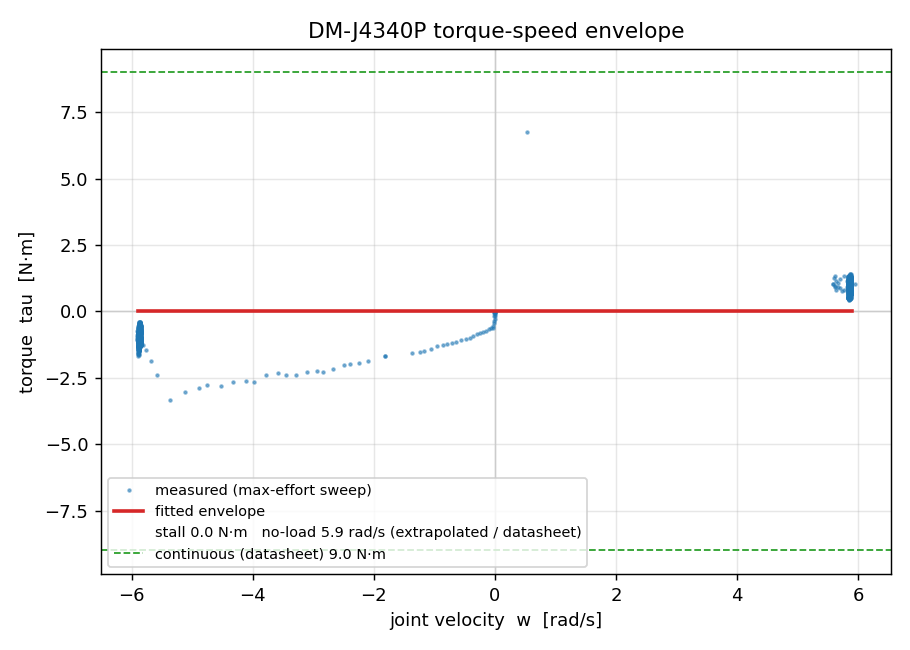
calibration/motor_calibration/results/DM-J4340P/plots/torque_speed.png
