Klajdi00/open_mabel/calibration/motor_calibration/results/DM-J10422P/plots/friction_curve.png

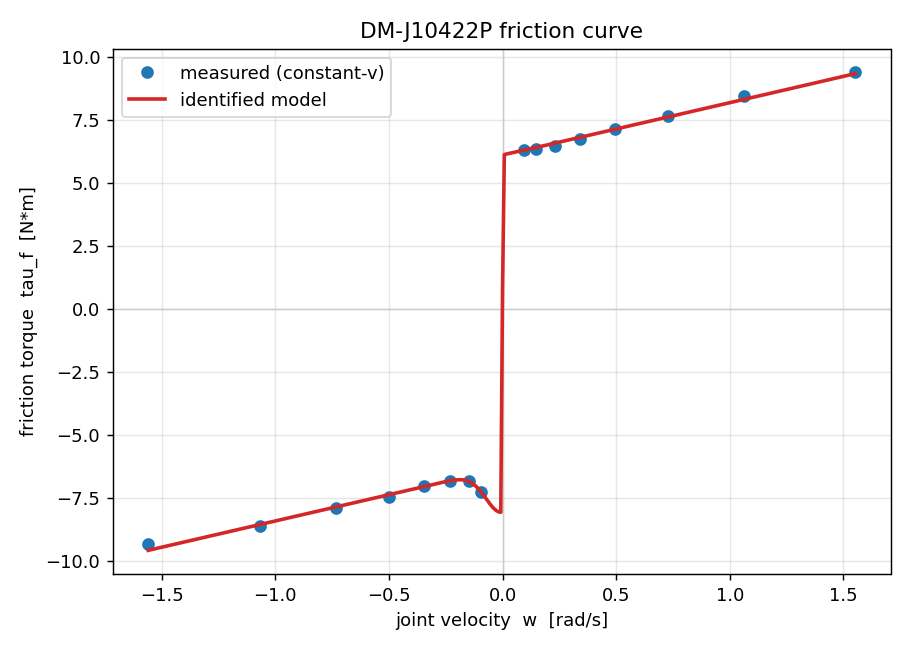
calibration/motor_calibration/results/DM-J10422P/plots/friction_curve.png
