Klajdi00/open_mabel/calibration/motor_calibration/results/DM-J10422P/plots/staircase_data.png

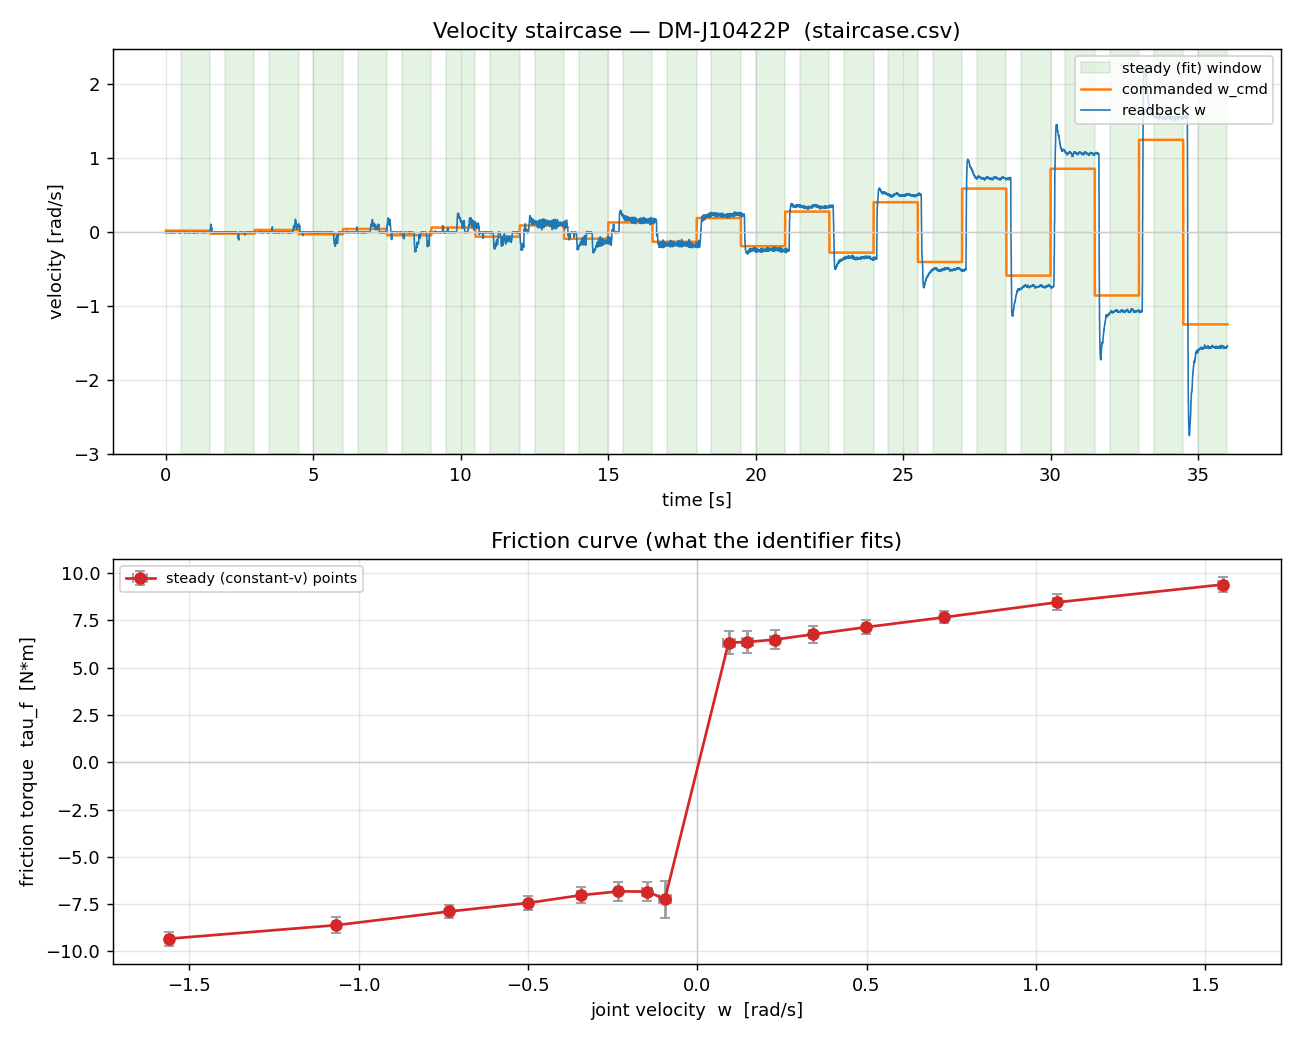
calibration/motor_calibration/results/DM-J10422P/plots/staircase_data.png
