Klajdi00/open_mabel/calibration/motor_calibration/results/DM-J10422P/plots/torque_fit.png

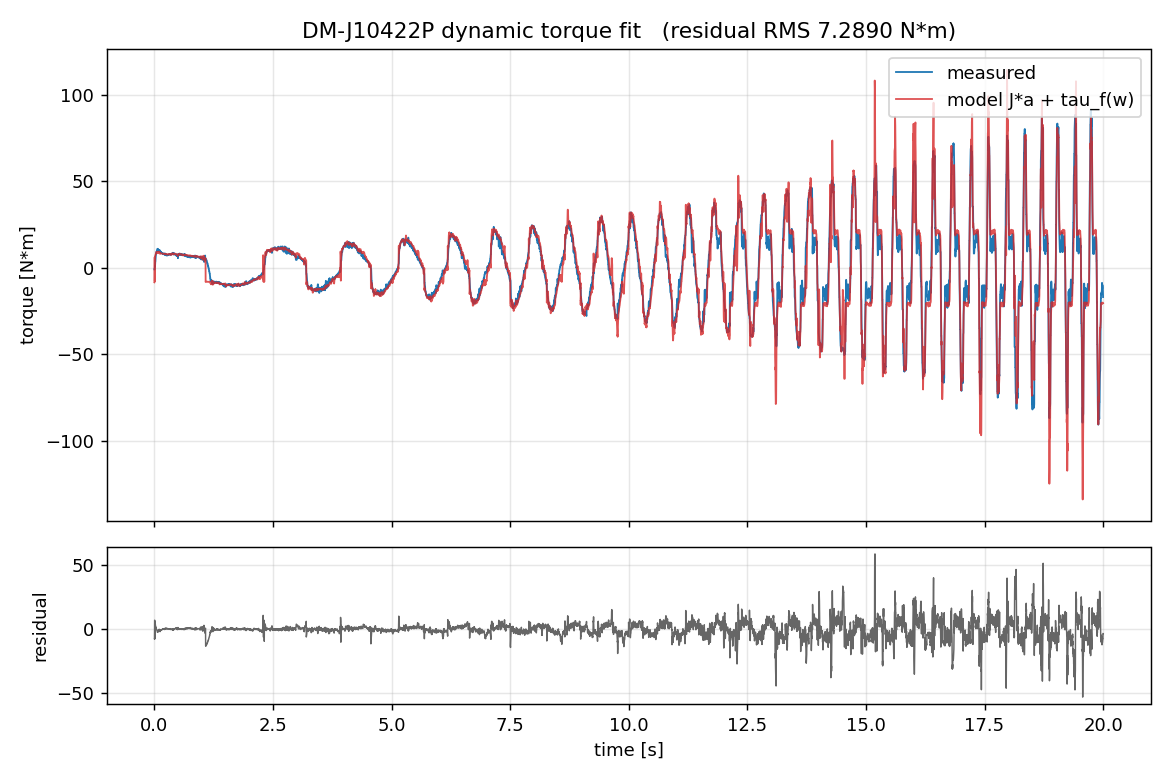
calibration/motor_calibration/results/DM-J10422P/plots/torque_fit.png
