Klajdi00/open_mabel/simulation/mabel_mujoco/assets/textures/hazard.png

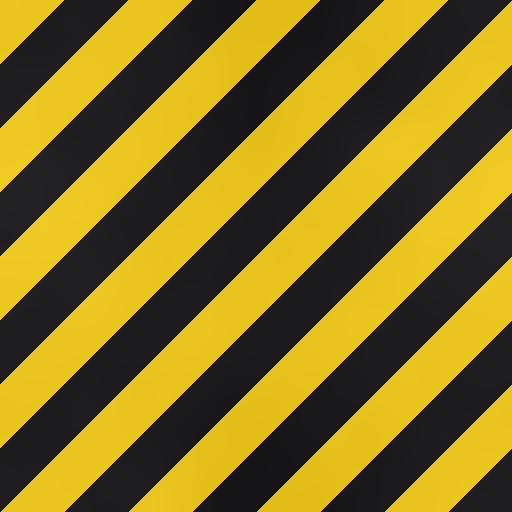
simulation/mabel_mujoco/assets/textures/hazard.png
