Klajdi00/open_mabel/simulation/mabel_mujoco/models/mabel_full.xml

<mujoco model="mabel_full_system">

  <compiler angle="radian" eulerseq="XYZ"/>
  <option gravity="0 0 -9.81" timestep="0.002" integrator="implicitfast" cone="elliptic" noslip_iterations="3"/>

  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
  <statistic extent="1.5" center="0 0 0.6"/>

  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

  <default>
    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

    <default class="sw_visual">
      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
    </default>
    <default class="sw_collision">
      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
    </default>
    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
    <default class="motor_NEO550">   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
      <joint type="hinge" axis="0 0 1" limited="false" armature="0.05" damping="0.1" frictionloss="0.05"/>
    </default>
    <default class="motor_NEO">      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
      <joint type="hinge" axis="0 0 1" limited="false" armature="0.01" damping="0.005" frictionloss="0.01"/>
    </default>

    <default class="l_visual">
      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
    </default>
    <default class="l_collision">
      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
    </default>
    <default class="l_slide">
      <joint type="slide" axis="0 0 1" range="0 0.3175" damping="10" armature="1"/>
    </default>

    <default class="b_visual">
      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
    </default>
    <default class="b_collision">
      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
    </default>
    <default class="b_hinge">
      <joint type="hinge" axis="0 0 1" limited="true" range="-1.0472 0.2618" damping="5" armature="1"/>
    </default>

    <default class="la_visual">
      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
    </default>
    <default class="la_collision">
      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
    </default>

    <default class="ra_visual">
      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
    </default>
    <default class="ra_collision">
      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
    </default>

    <default class="h_visual">
      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
    </default>
    <default class="h_collision">
      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
    </default>

    <default class="hand_base">
      <joint armature="0.001" damping="0.1" frictionloss="0.001" limited="true" margin="0.01" type="hinge"/>
      <position ctrllimited="true" forcelimited="true" forcerange="-1 1" kp="2.0"/>
    </default>
    <default class="hand_visual">
      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
    </default>
    <default class="hand_bone">
      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
    </default>
    <default class="hand_skin">
      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
    </default>
    <default class="hand_collision">
      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
    </default>

    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
    <default class="motor_DM8009">
      <joint frictionloss="0.5" damping="0.5" armature="0.10" limited="true" type="hinge" />
    </default>
    <default class="motor_DM4340">
      <joint frictionloss="0.5" damping="0.5" armature="0.08" limited="true" type="hinge" />
    </default>
    <default class="motor_DM4310">
      <joint frictionloss="0.5" damping="0.5" armature="0.05" limited="true" type="hinge" />
    </default>
    <default class="motor_DM_J10422P">  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
      <joint type="hinge" axis="0 0 1" limited="true" range="-1.0472 0.2618" frictionloss="0.8" damping="2.0" armature="1.0"/>
    </default>
    <default class="motor_dynamixel">
      <joint frictionloss="0.2" damping="0.5" armature="0.02" limited="true" type="hinge" />
    </default>
  </default>

  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
  <worldbody>

    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
    <body name="mabel_chassis" pos="0 0 0.07775">
      <inertial pos="0.0053945323 2.4928114e-06 0.094137249" quat="-0.0059429153 0.7104083 0.0059692826 0.70373936" mass="22.686" diaginertia="0.86513364 0.52064343 0.51664167"/>
      <freejoint name="base_root"/>
      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
      <camera name="body_front_cam" pos="-0.25 0 0.13" xyaxes="0 1 0 0 0 1" fovy="100" resolution="1280 720"/>
      <camera name="body_back_cam" pos="0.25 0 0.13" xyaxes="0 -1 0 0 0 1" fovy="100" resolution="1280 720"/>
      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
      <camera name="front_ir_left" pos="-0.25 -0.025 0.13" xyaxes="0 1 0 0 0 1" fovy="100" resolution="848 480"/>
      <camera name="front_ir_right" pos="-0.25 0.025 0.13" xyaxes="0 1 0 0 0 1" fovy="100" resolution="848 480"/>
      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
      <body name="lidar" pos="0.122 0 0.25">
        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
        <replicate count="360" euler="0 0 0.01745329">
          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
        </replicate>
      </body>
      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

      <body name="fl_swerve_housing" pos="-0.17 -0.17 0.0" euler="0 0 1.570795">
      <inertial pos="0.0085907853 -0.0093218629 0.034598464" quat="0.30152951 0.57382587 -0.23031683 0.72578095" mass="0.488554" diaginertia="0.00062316563 0.00060922993 0.00053167302"/>
        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
        <body name="fl_steer_body" pos="0 0 0">
      <inertial pos="3.4431261e-05 7.2473145e-07 -0.012039447" quat="0.00010441411 0.70103285 -7.7349006e-05 0.71312897" mass="0.0743539" diaginertia="4.595945e-05 3.2657432e-05 2.4766277e-05"/>
          <joint name="FL Steer" class="motor_NEO550"/>
          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
          <body name="fl_wheel" pos="0 0 -0.040" xyaxes="0 0 1 0 1 0">
      <inertial pos="-8.6550403e-07 -1.5526468e-06 -0.00045443722" quat="0.48998918 0.50981381 -0.48997729 0.50982619" mass="0.208434" diaginertia="0.00011329833 6.5071521e-05 6.5022891e-05"/>
            <joint name="FL Drive" class="motor_NEO"/>
            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
          </body>
        </body>
      </body>

      <body name="fr_swerve_housing" pos="-0.17 0.17 0.0" euler="0 0 0">
      <inertial pos="0.0085907853 -0.0093218629 0.034598464" quat="0.30152951 0.57382587 -0.23031683 0.72578095" mass="0.488554" diaginertia="0.00062316563 0.00060922993 0.00053167302"/>
        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
        <body name="fr_steer_body" pos="0 0 0">
      <inertial pos="3.4431261e-05 7.2473145e-07 -0.012039447" quat="0.00010441411 0.70103285 -7.7349006e-05 0.71312897" mass="0.0743539" diaginertia="4.595945e-05 3.2657432e-05 2.4766277e-05"/>
          <joint name="FR Steer" class="motor_NEO550"/>
          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
          <body name="fr_wheel" pos="0 0 -0.040" xyaxes="0 0 1 0 1 0">
      <inertial pos="-8.6550403e-07 -1.5526468e-06 -0.00045443722" quat="0.48998918 0.50981381 -0.48997729 0.50982619" mass="0.208434" diaginertia="0.00011329833 6.5071521e-05 6.5022891e-05"/>
            <joint name="FR Drive" class="motor_NEO"/>
            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
          </body>
        </body>
      </body>

      <body name="b_swerve_housing" pos="0.15 0 0.0" euler="0 0 3.9269926">
      <inertial pos="0.0085907853 -0.0093218629 0.034598464" quat="0.30152951 0.57382587 -0.23031683 0.72578095" mass="0.488554" diaginertia="0.00062316563 0.00060922993 0.00053167302"/>
        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
        <body name="b_steer_body" pos="0 0 0">
      <inertial pos="3.4431261e-05 7.2473145e-07 -0.012039447" quat="0.00010441411 0.70103285 -7.7349006e-05 0.71312897" mass="0.0743539" diaginertia="4.595945e-05 3.2657432e-05 2.4766277e-05"/>
          <joint name="B Steer" class="motor_NEO550"/>
          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
          <body name="b_wheel" pos="0 0 -0.040" xyaxes="0 0 1 0 1 0">
      <inertial pos="-8.6550403e-07 -1.5526468e-06 -0.00045443722" quat="0.48998918 0.50981381 -0.48997729 0.50982619" mass="0.208434" diaginertia="0.00011329833 6.5071521e-05 6.5022891e-05"/>
            <joint name="B Drive" class="motor_NEO"/>
            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
          </body>
        </body>
      </body>

      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
      <body name="lift_base" pos="-0.096 0 0.00" euler="0 0 3.1415926">
        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
        <body name="lift_mid" pos="0 0 0.17575">
          <joint name="Lift Lower" class="l_slide" ref="0.15875"/>
          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
          <body name="lift_top" pos="0 0 0.16575">
            <joint name="Lift Upper" class="l_slide" ref="0.15875"/>
            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

            <body name="body_mount" pos="0 -0.043 0.56" euler="1.570796 0 0">
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
                                        </body>
                                      </body>
                                    </body>

                                    <body euler="1.5708 1.5708 0.0" name="right_middle_mp" pos="0.0 0.0 0.05">
                                      <inertial diaginertia="3.4e-07 3.1e-07 2e-07" euler="3.14159 -1.5708 0.0" mass="0.00498" pos="0.01155 0.0 -4e-05"/>
                                      <joint axis="0.0 0.0 -1.0" name="Right Middle Abd" pos="0.02 0.0 0.0" range="-0.64577 0.64577"/>
                                      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
                                      <body euler="0.0 -1.5708 0.0" name="right_middle_pp" pos="0.0 0.0 0.0">
                                        <inertial diaginertia="3.78e-06 3.69e-06 8.9e-07" euler="-3e-05 0.01386 0.0006" mass="0.02006" pos="0.00144 2e-05 0.02021"/>
                                        <joint axis="0.0 -1.0 0.0" name="Right Middle MCP" range="-0.34907 1.58825"/>
                                        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
                                        <body euler="0.0 0.0 0.0" name="right_middle_ip" pos="0.0005 0.0 0.046">
                                          <inertial diaginertia="2.08e-06 2.06e-06 5.4e-07" euler="-0.00042 -0.18549 0.0044" mass="0.01521" pos="0.00071 1e-05 0.01929"/>
                                          <joint axis="0.0 -1.0 0.0" name="Right Middle PIP" range="-0.34907 1.8675"/>
                                          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
                                        </body>
                                      </body>
                                    </body>

                                    <body euler="-1.53597 1.30836 -3.05441" name="right_ring_mp" pos="0.02669 0.00199 0.04014">
                                      <inertial diaginertia="3.4e-07 3.1e-07 2e-07" euler="3.14159 -1.5708 0.0" mass="0.00498" pos="0.01155 0.0 -4e-05"/>
                                      <joint axis="0.0 0.0 -1.0" name="Right Ring Abd" pos="0.02 0.0 0.0" range="-0.47577 0.80577" ref="0.17"/>
                                      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
                                      <body euler="0.0 -1.5708 0.0" name="right_ring_pp" pos="0.0 0.0 0.0">
                                        <inertial diaginertia="3.78e-06 3.69e-06 8.9e-07" euler="-3e-05 0.01386 0.0006" mass="0.02006" pos="0.00144 2e-05 0.02021"/>
                                        <joint axis="0.0 -1.0 0.0" name="Right Ring MCP" range="-0.34907 1.58825"/>
                                        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
                                        <body euler="0.0 0.0 0.0" name="right_ring_ip" pos="0.0005 0.0 0.046">
                                          <inertial diaginertia="2.08e-06 2.06e-06 5.4e-07" euler="-0.00042 -0.18549 0.0044" mass="0.01521" pos="0.00071 1e-05 0.01929"/>
                                          <joint axis="0.0 -1.0 0.0" name="Right Ring PIP" range="-0.34907 1.8675"/>
                                          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
                                        </body>
                                      </body>
                                    </body>

                                    <body euler="-1.49694 0.86149 -2.88373" name="right_pinky_mp" pos="0.05518 0.00831 0.02242">
                                      <inertial diaginertia="3.4e-07 3.1e-07 2e-07" euler="3.14159 -1.5708 0.0" mass="0.00498" pos="0.01155 0.0 -4e-05"/>
                                      <joint axis="0.0 0.0 -1.0" name="Right Pinky Abd" pos="0.02 0.0 0.0" range="-0.12244 1.1691" ref="0.52333"/>
                                      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
                                      <body euler="0.0 -1.5708 0.0" name="right_pinky_pp" pos="0.0 0.0 0.0">
                                        <inertial diaginertia="1.7e-06 1.64e-06 5.9e-07" euler="0.00037 0.03263 0.00034" mass="0.01402" pos="0.00135 2e-05 0.01383"/>
                                        <joint axis="0.0 -1.0 0.0" name="Right Pinky MCP" range="-0.34907 1.71042"/>
                                        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
                                        <body euler="0.0 0.0 0.0" name="right_pinky_ip" pos="0.0005 0.0 0.033">
                                          <inertial diaginertia="2.08e-06 2.06e-06 5.4e-07" euler="-0.00042 -0.18549 0.0044" mass="0.01521" pos="0.00071 1e-05 0.01929"/>
                                          <joint axis="0.0 -1.0 0.0" name="Right Pinky PIP" range="-0.34907 1.88496"/>
                                          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
                                        </body>
                                      </body>
                                    </body>

                                  </body>
                                </body>

                              </body>
                            </body>
                          </body>
                        </body>
                      </body>
                    </body>
                  </body>
                </body>

              </body>
            </body>

          </body>
        </body>
      </body>

    </body>
  </worldbody>

  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

  <equality>
    <joint name="Sync Lift" joint1="Lift Upper" joint2="Lift Lower" polycoef="0 1 0 0 0"/>
  </equality>

  <tendon>
    <fixed name="Total Lift">
      <joint joint="Lift Lower" coef="1"/>
      <joint joint="Lift Upper" coef="1"/>
    </fixed>
  </tendon>

  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

  <actuator>
    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
    <position name="FL Steer" joint="FL Steer" kp="350" kv="12" forcerange="-32 32" ctrllimited="false"/>
    <velocity name="FL Drive" joint="FL Drive" kv="2" forcerange="-11 11" ctrlrange="-126 126" ctrllimited="true"/>
    <position name="FR Steer" joint="FR Steer" kp="350" kv="12" forcerange="-32 32" ctrllimited="false"/>
    <velocity name="FR Drive" joint="FR Drive" kv="2" forcerange="-11 11" ctrlrange="-126 126" ctrllimited="true"/>
    <position name="B Steer" joint="B Steer" kp="350" kv="12" forcerange="-32 32" ctrllimited="false"/>
    <velocity name="B Drive" joint="B Drive" kv="2" forcerange="-11 11" ctrlrange="-126 126" ctrllimited="true"/>
    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
    <position name="Lift" tendon="Total Lift" kp="80000" kv="3000" ctrlrange="0 0.635" ctrllimited="true" forcerange="-5000 5000"/>
    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
    <position name="Torso" joint="Torso" kp="5000" kv="100" ctrlrange="-1.0472 0.2618" ctrllimited="true" forcerange="-400 400"/>

    <position name="Neck Yaw" joint="Neck Yaw" kp="50" kv="5" ctrlrange="-1.571 1.571" ctrllimited="true" forcerange="-10 10"/>
    <position name="Neck Pitch" joint="Neck Pitch" kp="50" kv="5" ctrlrange="-0.785 0.785" ctrllimited="true" forcerange="-10 10"/>
    <position name="Neck Roll" joint="Neck Roll" kp="50" kv="5" ctrlrange="-0.785 0.785" ctrllimited="true" forcerange="-10 10"/>

    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
    <position name="Left Arm 1" joint="Left Arm 1" kp="1204.6" kv="40.15" ctrlrange="-3.491 1.396" ctrllimited="true" forcerange="-40 40"/>
    <position name="Left Arm 2" joint="Left Arm 2" kp="1880.1" kv="62.67" ctrlrange="-0.175 3.316" ctrllimited="true" forcerange="-40 40"/>
    <position name="Left Arm 3" joint="Left Arm 3" kp="760.0" kv="25.33" ctrlrange="-1.571 1.571" ctrllimited="true" forcerange="-27 27"/>
    <position name="Left Arm 4" joint="Left Arm 4" kp="939.8" kv="31.33" ctrlrange="-0.943 1.542" ctrllimited="true" forcerange="-27 27"/>
    <position name="Left Arm 5" joint="Left Arm 5" kp="269.1" kv="8.97" ctrlrange="-1.571 1.571" ctrllimited="true" forcerange="-7 7"/>
    <position name="Left Arm 6" joint="Left Arm 6" kp="248.8" kv="8.29" ctrlrange="-0.785 0.785" ctrllimited="true" forcerange="-7 7"/>
    <position name="Left Arm 7" joint="Left Arm 7" kp="314.5" kv="10.48" ctrlrange="-1.571 1.571" ctrllimited="true" forcerange="-7 7"/>

    <position name="Left Wrist" joint="Left Wrist" ctrlrange="-0.8972 0.6736"/>
    <position name="Left Thumb MCP" joint="Left Thumb MCP" ctrlrange="-0.87266 0.87266"/>
    <position name="Left Thumb Abd" joint="Left Thumb Abd" ctrlrange="-1.08211 0.0"/>
    <position name="Left Thumb PIP" joint="Left Thumb PIP" ctrlrange="-0.7944 1.23"/>
    <position name="Left Thumb DIP" joint="Left Thumb DIP" ctrlrange="-0.85384 1.45"/>
    <position name="Left Index Abd" joint="Left Index Abd" ctrlrange="-1.04577 0.24577"/>
    <position name="Left Index MCP" joint="Left Index MCP" ctrlrange="-0.34907 1.65806"/>
    <position name="Left Index PIP" joint="Left Index PIP" ctrlrange="-0.34907 1.88496"/>
    <position name="Left Middle Abd" joint="Left Middle Abd" ctrlrange="-0.64577 0.64577"/>
    <position name="Left Middle MCP" joint="Left Middle MCP" ctrlrange="-0.34907 1.58825"/>
    <position name="Left Middle PIP" joint="Left Middle PIP" ctrlrange="-0.34907 1.8675"/>
    <position name="Left Ring Abd" joint="Left Ring Abd" ctrlrange="-0.47577 0.80577"/>
    <position name="Left Ring MCP" joint="Left Ring MCP" ctrlrange="-0.34907 1.58825"/>
    <position name="Left Ring PIP" joint="Left Ring PIP" ctrlrange="-0.34907 1.8675"/>
    <position name="Left Pinky Abd" joint="Left Pinky Abd" ctrlrange="-0.12244 1.1691"/>
    <position name="Left Pinky MCP" joint="Left Pinky MCP" ctrlrange="-0.34907 1.71042"/>
    <position name="Left Pinky PIP" joint="Left Pinky PIP" ctrlrange="-0.34907 1.88496"/>

    <position name="Right Arm 1" joint="Right Arm 1" kp="1204.6" kv="40.15" ctrlrange="-1.396 3.491" ctrllimited="true" forcerange="-40 40"/>
    <position name="Right Arm 2" joint="Right Arm 2" kp="1880.1" kv="62.67" ctrlrange="-3.316 0.175" ctrllimited="true" forcerange="-40 40"/>
    <position name="Right Arm 3" joint="Right Arm 3" kp="760.0" kv="25.33" ctrlrange="-1.571 1.571" ctrllimited="true" forcerange="-27 27"/>
    <position name="Right Arm 4" joint="Right Arm 4" kp="939.8" kv="31.33" ctrlrange="-1.670 0.773" ctrllimited="true" forcerange="-27 27"/>
    <position name="Right Arm 5" joint="Right Arm 5" kp="269.1" kv="8.97" ctrlrange="-1.571 1.571" ctrllimited="true" forcerange="-7 7"/>
    <position name="Right Arm 6" joint="Right Arm 6" kp="248.8" kv="8.29" ctrlrange="-0.785 0.785" ctrllimited="true" forcerange="-7 7"/>
    <position name="Right Arm 7" joint="Right Arm 7" kp="314.5" kv="10.48" ctrlrange="-1.571 1.571" ctrllimited="true" forcerange="-7 7"/>

    <position name="Right Wrist" joint="Right Wrist" ctrlrange="-0.6736 0.8972"/>
    <position name="Right Thumb MCP" joint="Right Thumb MCP" ctrlrange="-0.87266 0.87266"/>
    <position name="Right Thumb Abd" joint="Right Thumb Abd" ctrlrange="-1.08211 0.0"/>
    <position name="Right Thumb PIP" joint="Right Thumb PIP" ctrlrange="-0.7944 1.23"/>
    <position name="Right Thumb DIP" joint="Right Thumb DIP" ctrlrange="-0.85384 1.45"/>
    <position name="Right Index Abd" joint="Right Index Abd" ctrlrange="-1.04577 0.24577"/>
    <position name="Right Index MCP" joint="Right Index MCP" ctrlrange="-0.34907 1.65806"/>
    <position name="Right Index PIP" joint="Right Index PIP" ctrlrange="-0.34907 1.88496"/>
    <position name="Right Middle Abd" joint="Right Middle Abd" ctrlrange="-0.64577 0.64577"/>
    <position name="Right Middle MCP" joint="Right Middle MCP" ctrlrange="-0.34907 1.58825"/>
    <position name="Right Middle PIP" joint="Right Middle PIP" ctrlrange="-0.34907 1.8675"/>
    <position name="Right Ring Abd" joint="Right Ring Abd" ctrlrange="-0.47577 0.80577"/>
    <position name="Right Ring MCP" joint="Right Ring MCP" ctrlrange="-0.34907 1.58825"/>
    <position name="Right Ring PIP" joint="Right Ring PIP" ctrlrange="-0.34907 1.8675"/>
    <position name="Right Pinky Abd" joint="Right Pinky Abd" ctrlrange="-0.12244 1.1691"/>
    <position name="Right Pinky MCP" joint="Right Pinky MCP" ctrlrange="-0.34907 1.71042"/>
    <position name="Right Pinky PIP" joint="Right Pinky PIP" ctrlrange="-0.34907 1.88496"/>
  </actuator>

  <sensor>
    <jointpos name="FL Steer Pos" joint="FL Steer"/>
    <jointpos name="FR Steer Pos" joint="FR Steer"/>
    <jointpos name="B Steer Pos" joint="B Steer"/>
    <jointvel name="FL Drive Vel" joint="FL Drive"/>
    <jointvel name="FR Drive Vel" joint="FR Drive"/>
    <jointvel name="B Drive Vel" joint="B Drive"/>
    <jointpos name="Torso Pos" joint="Torso"/>

    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
    <rangefinder name="lidar_range" site="lidar_ray" cutoff="12"/>

    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
    <accelerometer name="front_imu_acc" site="front_imu"/>
    <gyro name="front_imu_gyro" site="front_imu"/>
    <framequat name="front_imu_quat" objtype="site" objname="front_imu"/>
  </sensor>

</mujoco>
