Klajdi00/open_mabel/simulation/mabel_mujoco/models/openarm.xml

<?xml version='1.0' encoding='utf-8'?>
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

<mujoco model="openarm">
  <default>
    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
    <joint stiffness="0" ref="0.0" />
    <default class="robot">
      <default class="motor_DM8009">
        <joint frictionloss="0.1" damping="0.4" limited="true" type="hinge" />
        <motor forcelimited="true" forcerange="-40 40" />
      </default>
      <default class="motor_DM4340">
        <joint frictionloss="0.1" damping="0.4" limited="true" type="hinge" />
        <motor forcelimited="true" forcerange="-27 27" />
      </default>
      <default class="motor_DM4310">
        <joint frictionloss="0.1" damping="0.4" limited="true" type="hinge" />
        <motor forcelimited="true" forcerange="-7 7" />
      </default>
      <default class="motor_finger">
        <joint limited="true" type="slide" damping="2" stiffness="0.5" />
        <position forcelimited="true" forcerange="-333 333" ctrllimited="true" ctrlrange="0 0.044" kp="100" />
      </default>
      <default class="collision">
        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
        <equality solimp="0.99 0.999 1e-05" solref="0.005 1" />
      </default>
      <default class="visual">
        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
      </default>
    </default>
  </default>

  <compiler angle="radian" meshdir="meshes" />

  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

  <worldbody>

    <body name="openarm_body_link0" pos="0 0 0" quat="1.0 0.0 0.0 0.0">
      <inertial pos="0.0 0.0 0.0" quat="1.0 0.0 0.0 0.0" mass="13.89" diaginertia="1.653 1.653 0.051" />
      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
      <body name="openarm_left_link0" pos="0.0 0.031 0.698" quat="0.7071054825112363 -0.7071080798594735 0.0 0.0">
        <inertial pos="-0.0009483362816297526 0.0001580207020448382 0.03076860287587199" quat="1.0 0.0 0.0 0.0" mass="1.1432284943239561" diaginertia="0.001128 0.000962 0.00147" />
        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
        <body name="openarm_left_link1" pos="0.0 0.0 0.0625" quat="1.0 0.0 0.0 0.0">
          <joint name="openarm_left_joint1" type="hinge" ref="0.0" class="motor_DM8009" range="-3.490659 1.3962629999999998" axis="0 0 1" />
          <inertial pos="0.0011467657911800769 3.319987657026362e-05 0.05395284380736254" quat="1.0 0.0 0.0 0.0" mass="1.1416684646202298" diaginertia="0.001567 0.001273 0.001016" />
          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
          <body name="openarm_left_link2" pos="-0.0301 0.0 0.06" quat="0.7071067811882787 -0.7071067811848163 0.0 0.0">
            <joint name="openarm_left_joint2" type="hinge" ref="0.0" class="motor_DM8009" range="-3.3161253267948965 0.17453267320510335" axis="-1 0 0" />
            <inertial pos="0.00839629182351943 -2.0145102027597523e-08 0.03256649300522363" quat="1.0 0.0 0.0 0.0" mass="0.2775092746011571" diaginertia="0.000359 0.000376 0.000232" />
            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
            <body name="openarm_left_link3" pos="0.0301 0.0 0.06625" quat="1.0 0.0 0.0 0.0">
              <joint name="openarm_left_joint3" type="hinge" ref="0.0" class="motor_DM4340" range="-1.570796 1.570796" axis="0 0 1" />
              <inertial pos="-0.002104752099628911 0.0005549085042607548 0.08847470545721961" quat="1.0 0.0 0.0 0.0" mass="1.073863338202347" diaginertia="0.004372 0.004319 0.000661" />
              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
              <body name="openarm_left_link4" pos="-0.0 0.0315 0.15375" quat="1.0 0.0 0.0 0.0">
                <joint name="openarm_left_joint4" type="hinge" ref="0.0" class="motor_DM4340" range="0.0 2.443461" axis="0 1 0" />
                <inertial pos="-0.0029006831074562967 -0.03030575826634669 0.06339637422196209" quat="1.0 0.0 0.0 0.0" mass="0.6348534566833373" diaginertia="0.001577 0.001346 0.001104" />
                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
                <body name="openarm_left_link5" pos="0.0 -0.0315 0.0955" quat="1.0 0.0 0.0 0.0">
                  <joint name="openarm_left_joint5" type="hinge" ref="0.0" class="motor_DM4310" range="-1.570796 1.570796" axis="0 0 1" />
                  <inertial pos="-0.003049665024221911 0.0008866902457326625 0.043079803024980934" quat="1.0 0.0 0.0 0.0" mass="0.6156588026168502" diaginertia="0.000423 0.000445 0.000324" />
                  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
                  <body name="openarm_left_link6" pos="0.0375 0.0 0.1205" quat="1.0 0.0 0.0 0.0">
                    <joint name="openarm_left_joint6" type="hinge" ref="0.0" class="motor_DM4310" range="-0.785398 0.785398" axis="1 0 0" />
                    <inertial pos="-0.037136587005447405 0.00033230528343419053 -9.498374522309838e-05" quat="1.0 0.0 0.0 0.0" mass="0.475202773187987" diaginertia="0.000143 0.000157 0.000159" />
                    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
                    <body name="openarm_left_link7" pos="-0.0375 0.0 0.0" quat="1.0 0.0 0.0 0.0">
                      <joint name="openarm_left_joint7" type="hinge" ref="0.0" class="motor_DM4310" range="-1.570796 1.570796" axis="0 -1 0" />
                      <inertial pos="6.875510271106056e-05 -0.01766175250761268 0.06651945409987448" quat="1.0 0.0 0.0 0.0" mass="0.4659771327380578" diaginertia="0.000639 0.000497 0.000342" />
                      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
                      <body name="openarm_left_link8" pos="1e-06 0.0205 0.0" quat="1.0 0.0 0.0 0.0">
                        <body name="openarm_left_hand" pos="0 -0.025 0.1001" quat="1.0 0.0 0.0 0.0">
                          <inertial pos="0.0 0.002 0.01" quat="1.0 0.0 0.0 0.0" mass="0.15" diaginertia="0.0001 0.00025 0.00017" />
                          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
                          <body name="openarm_left_hand_tcp" pos="0 -0.0 0.08" quat="1.0 0.0 0.0 0.0" />
                          <body name="openarm_left_right_finger" pos="0 0.00 0.015" quat="1.0 0.0 0.0 0.0">
                            <joint name="openarm_left_finger_joint1" type="slide" ref="0.0" class="motor_finger" range="0.0 0.044" axis="0 -1 0" />
                            <inertial pos="0.0064528 -0.01702 0.0219685" quat="1.0 0.0 0.0 0.0" mass="0.03602545343277134" diaginertia="2.3749999999999997e-06 2.3749999999999997e-06 7.5e-07" />
                            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
                          </body>
                          <body name="openarm_left_left_finger" pos="0 0.012 0.015" quat="1.0 0.0 0.0 0.0">
                            <joint name="openarm_left_finger_joint2" type="slide" ref="0.0" class="motor_finger" range="0.0 0.044" axis="0 1 0" />
                            <inertial pos="0.0064528 0.01702 0.0219685" quat="1.0 0.0 0.0 0.0" mass="0.03602545343277134" diaginertia="2.3749999999999997e-06 2.3749999999999997e-06 7.5e-07" />
                            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
                          </body>
                        </body>
                      </body>
                    </body>
                  </body>
                </body>
              </body>
            </body>
          </body>
        </body>
      </body>
      <body name="openarm_right_link0" pos="0.0 -0.031 0.698" quat="0.7071054825112363 0.7071080798594735 0.0 0.0">
        <inertial pos="-0.0009483362816297526 0.0001580207020448382 0.03076860287587199" quat="1.0 0.0 0.0 0.0" mass="1.1432284943239561" diaginertia="0.001128 0.000962 0.00147" />
        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
        <body name="openarm_right_link1" pos="0.0 0.0 0.0625" quat="1.0 0.0 0.0 0.0">
          <joint name="openarm_right_joint1" type="hinge" ref="0.0" class="motor_DM8009" range="-1.396263 3.490659" axis="0 0 1" />
          <inertial pos="0.0011467657911800769 3.319987657026362e-05 0.05395284380736254" quat="1.0 0.0 0.0 0.0" mass="1.1416684646202298" diaginertia="0.001567 0.001273 0.001016" />
          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
          <body name="openarm_right_link2" pos="-0.0301 0.0 0.06" quat="0.7071067811882787 0.7071067811848163 0.0 0.0">
            <joint name="openarm_right_joint2" type="hinge" ref="0.0" class="motor_DM8009" range="-0.17453267320510335 3.3161253267948965" axis="-1 0 0" />
            <inertial pos="0.00839629182351943 -2.0145102027597523e-08 0.03256649300522363" quat="1.0 0.0 0.0 0.0" mass="0.2775092746011571" diaginertia="0.000359 0.000376 0.000232" />
            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
            <body name="openarm_right_link3" pos="0.0301 0.0 0.06625" quat="1.0 0.0 0.0 0.0">
              <joint name="openarm_right_joint3" type="hinge" ref="0.0" class="motor_DM4340" range="-1.570796 1.570796" axis="0 0 1" />
              <inertial pos="-0.002104752099628911 0.0005549085042607548 0.08847470545721961" quat="1.0 0.0 0.0 0.0" mass="1.073863338202347" diaginertia="0.004372 0.004319 0.000661" />
              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
              <body name="openarm_right_link4" pos="-0.0 0.0315 0.15375" quat="1.0 0.0 0.0 0.0">
                <joint name="openarm_right_joint4" type="hinge" ref="0.0" class="motor_DM4340" range="0.0 2.443461" axis="0 1 0" />
                <inertial pos="-0.0029006831074562967 -0.03030575826634669 0.06339637422196209" quat="1.0 0.0 0.0 0.0" mass="0.6348534566833373" diaginertia="0.001577 0.001346 0.001104" />
                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
                <body name="openarm_right_link5" pos="0.0 -0.0315 0.0955" quat="1.0 0.0 0.0 0.0">
                  <joint name="openarm_right_joint5" type="hinge" ref="0.0" class="motor_DM4310" range="-1.570796 1.570796" axis="0 0 1" />
                  <inertial pos="-0.003049665024221911 0.0008866902457326625 0.043079803024980934" quat="1.0 0.0 0.0 0.0" mass="0.6156588026168502" diaginertia="0.000423 0.000445 0.000324" />
                  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
                  <body name="openarm_right_link6" pos="0.0375 0.0 0.1205" quat="1.0 0.0 0.0 0.0">
                    <joint name="openarm_right_joint6" type="hinge" ref="0.0" class="motor_DM4310" range="-0.785398 0.785398" axis="1 0 0" />
                    <inertial pos="-0.037136587005447405 0.00033230528343419053 -9.498374522309838e-05" quat="1.0 0.0 0.0 0.0" mass="0.475202773187987" diaginertia="0.000143 0.000157 0.000159" />
                    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
                    <body name="openarm_right_link7" pos="-0.0375 0.0 0.0" quat="1.0 0.0 0.0 0.0">
                      <joint name="openarm_right_joint7" type="hinge" ref="0.0" class="motor_DM4310" range="-1.570796 1.570796" axis="0 1 0" />
                      <inertial pos="6.875510271106056e-05 -0.01766175250761268 0.06651945409987448" quat="1.0 0.0 0.0 0.0" mass="0.4659771327380578" diaginertia="0.000639 0.000497 0.000342" />
                      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
                      <body name="openarm_right_link8" pos="1e-06 0.0205 0.0" quat="1.0 0.0 0.0 0.0">
                        <body name="openarm_right_hand" pos="0 -0.025 0.1001" quat="1.0 0.0 0.0 0.0">
                          <inertial pos="0.0 0.002 0.01" quat="1.0 0.0 0.0 0.0" mass="0.15" diaginertia="0.0001 0.00025 0.00017" />
                          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
                          <body name="openarm_right_hand_tcp" pos="0 -0.0 0.08" quat="1.0 0.0 0.0 0.0" />
                          <body name="openarm_right_right_finger" pos="0 0.00 0.015" quat="1.0 0.0 0.0 0.0">
                            <joint name="openarm_right_finger_joint1" type="slide" ref="0.0" class="motor_finger" range="0.0 0.044" axis="0 -1 0" />
                            <inertial pos="0.0064528 -0.01702 0.0219685" quat="1.0 0.0 0.0 0.0" mass="0.03602545343277134" diaginertia="2.3749999999999997e-06 2.3749999999999997e-06 7.5e-07" />
                            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
                          </body>
                          <body name="openarm_right_left_finger" pos="0 0.012 0.015" quat="1.0 0.0 0.0 0.0">
                            <joint name="openarm_right_finger_joint2" type="slide" ref="0.0" class="motor_finger" range="0.0 0.044" axis="0 1 0" />
                            <inertial pos="0.0064528 0.01702 0.0219685" quat="1.0 0.0 0.0 0.0" mass="0.03602545343277134" diaginertia="2.3749999999999997e-06 2.3749999999999997e-06 7.5e-07" />
                            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
                          </body>
                        </body>
                      </body>
                    </body>
                  </body>
                </body>
              </body>
            </body>
          </body>
        </body>
      </body>
    </body>
    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
    <camera name="front_camera" mode="track" fovy="90.0" quat="4.329780281177467e-17 4.329780281177466e-17 0.7071067811865475 0.7071067811865476" pos="0.0 2.0 0.5" />
    <camera name="side_camera" mode="track" fovy="90.0" quat="-0.5 -0.4999999999999999 0.5 0.5000000000000001" pos="-2.0 0.0 0.5" />

  </worldbody>

  <tendon>
    <fixed name="split_right">
      <joint joint="openarm_right_finger_joint1" coef="0.5" />
      <joint joint="openarm_right_finger_joint2" coef="0.5" />
    </fixed>
    <fixed name="split_left">
      <joint joint="openarm_left_finger_joint1" coef="0.5" />
      <joint joint="openarm_left_finger_joint2" coef="0.5" />
    </fixed>
  </tendon>
  <equality>
    <joint joint1="openarm_right_finger_joint1" joint2="openarm_right_finger_joint2" solimp="0.95 0.99 0.001" solref="0.005 1" />
    <joint joint1="openarm_left_finger_joint1" joint2="openarm_left_finger_joint2" solimp="0.95 0.99 0.001" solref="0.005 1" />
  </equality>


  <actuator>
    <motor name="left_joint1_ctrl" joint="openarm_left_joint1" class="motor_DM8009" />
    <motor name="left_joint2_ctrl" joint="openarm_left_joint2" class="motor_DM8009" />
    <motor name="left_joint3_ctrl" joint="openarm_left_joint3" class="motor_DM4340" />
    <motor name="left_joint4_ctrl" joint="openarm_left_joint4" class="motor_DM4340" />
    <motor name="left_joint5_ctrl" joint="openarm_left_joint5" class="motor_DM4310" />
    <motor name="left_joint6_ctrl" joint="openarm_left_joint6" class="motor_DM4310" />
    <motor name="left_joint7_ctrl" joint="openarm_left_joint7" class="motor_DM4310" />
    <motor name="left_finger1_ctrl" joint="openarm_left_finger_joint1" class="motor_finger" />
    <motor name="left_finger2_ctrl" joint="openarm_left_finger_joint2" class="motor_finger" />
    <motor name="right_joint1_ctrl" joint="openarm_right_joint1" class="motor_DM8009" />
    <motor name="right_joint2_ctrl" joint="openarm_right_joint2" class="motor_DM8009" />
    <motor name="right_joint3_ctrl" joint="openarm_right_joint3" class="motor_DM4340" />
    <motor name="right_joint4_ctrl" joint="openarm_right_joint4" class="motor_DM4340" />
    <motor name="right_joint5_ctrl" joint="openarm_right_joint5" class="motor_DM4310" />
    <motor name="right_joint6_ctrl" joint="openarm_right_joint6" class="motor_DM4310" />
    <motor name="right_joint7_ctrl" joint="openarm_right_joint7" class="motor_DM4310" />
    <position name="right_finger1_ctrl" joint="openarm_right_finger_joint1" class="motor_finger" />
    <position name="right_finger2_ctrl" joint="openarm_right_finger_joint2" class="motor_finger" />
  </actuator>

  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

  <sensor>
    <framepos name="world_site_pos" objtype="site" objname="world_site" />
    <framequat name="world_site_quat" objtype="site" objname="world_site" />
    <framelinvel name="world_site_linvel" objtype="site" objname="world_site" />
    <frameangvel name="world_site_angvel" objtype="site" objname="world_site" />
    <velocimeter name="world_site_vel" site="world_site" />
  </sensor>
</mujoco>
