Klajdi00/open_mabel/electrical/exports/Motherboard_schematic.pdf

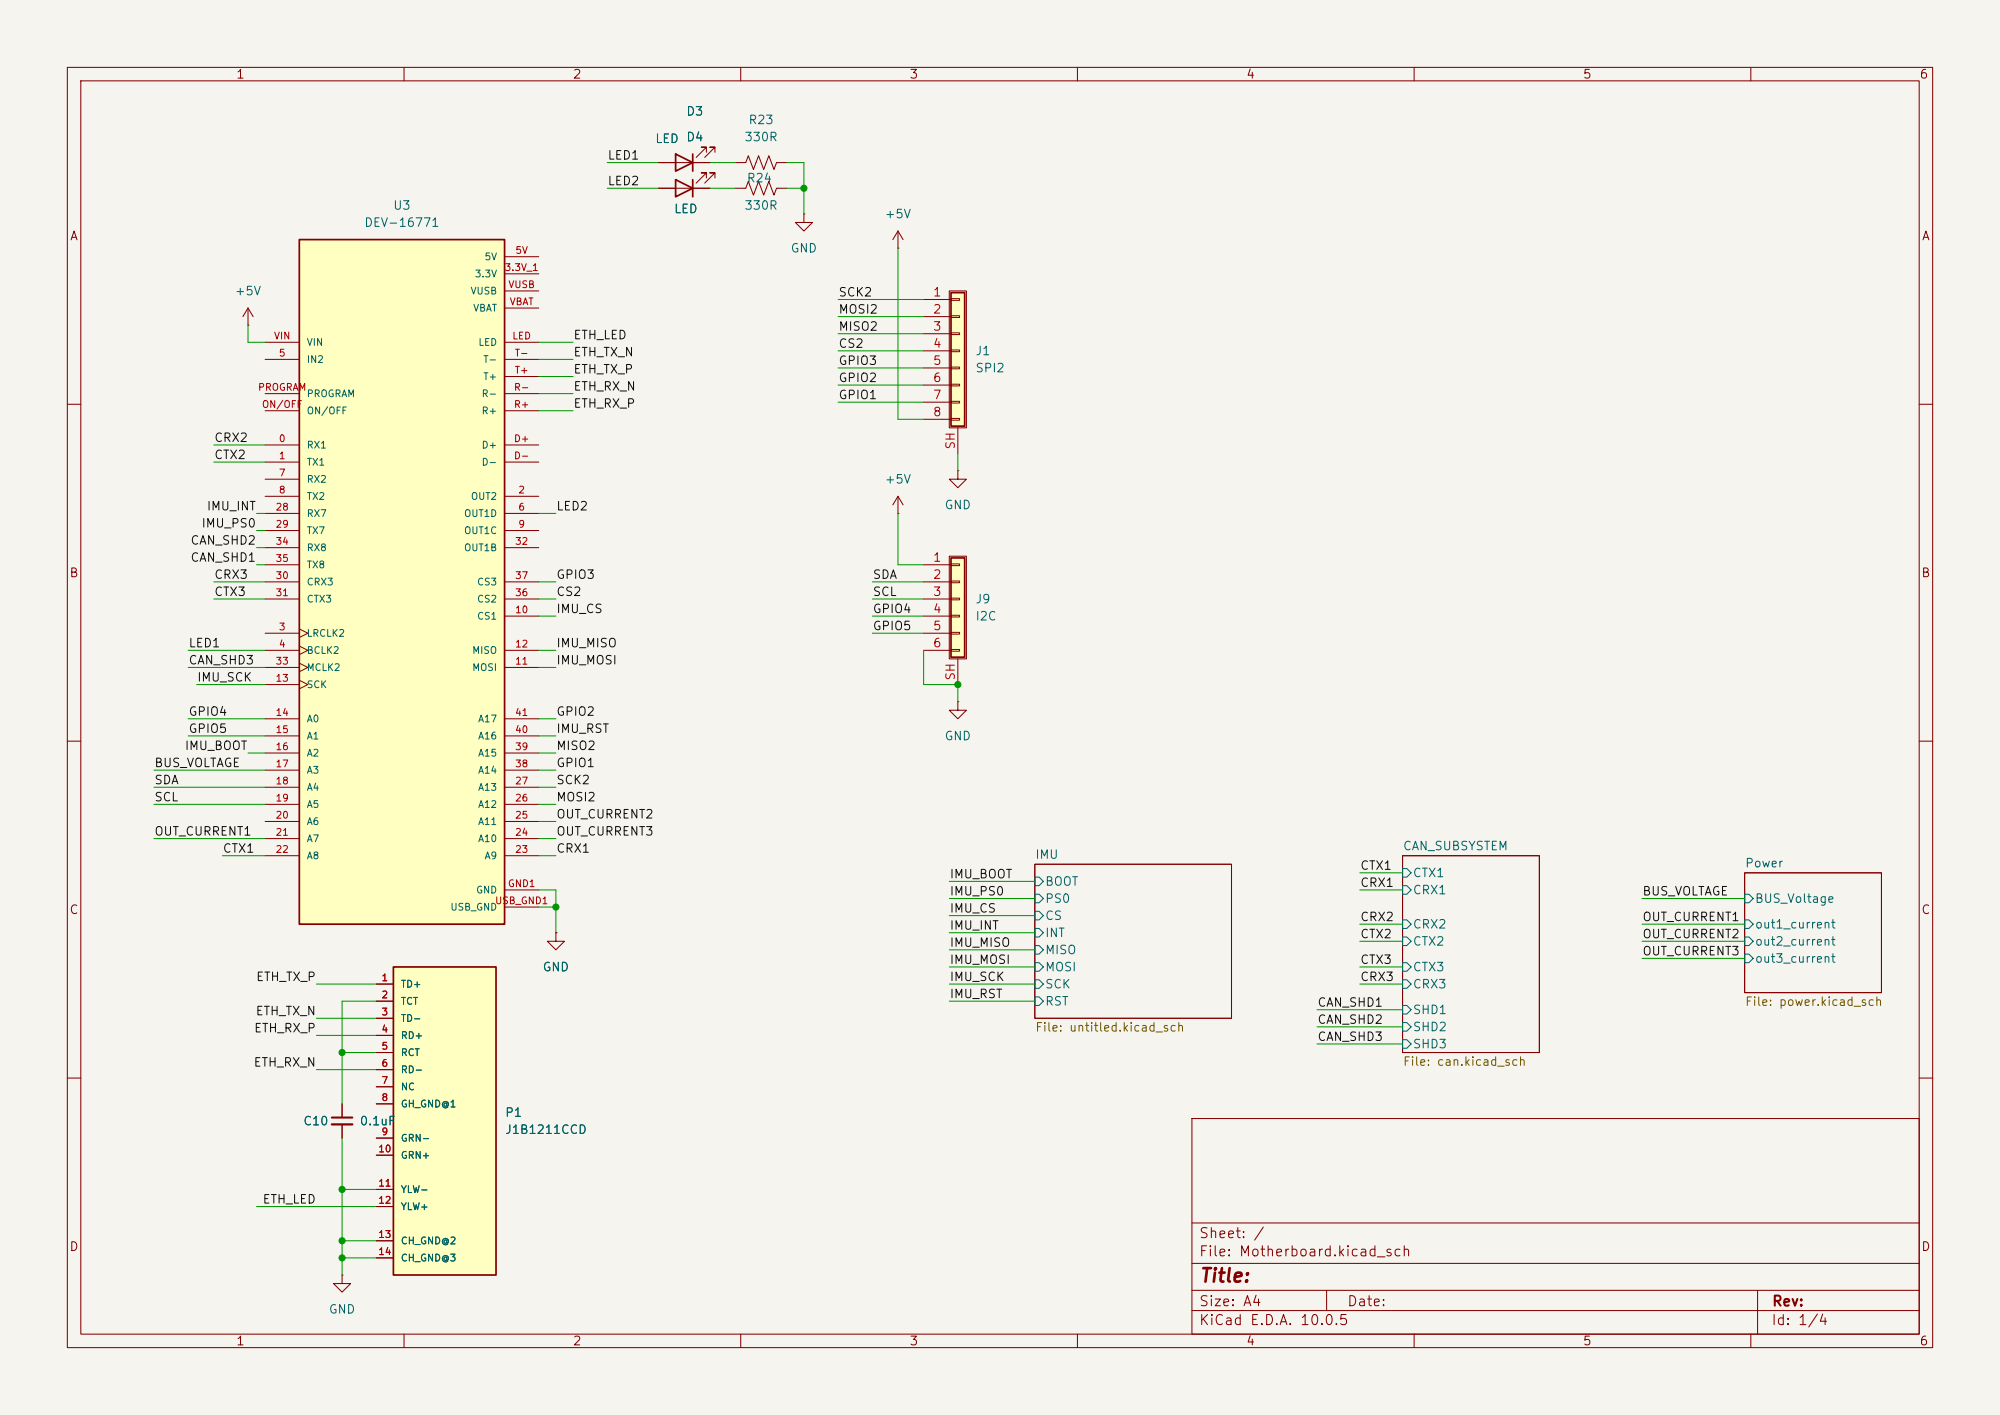
[picture p287: page 1]

IMU
INT MISO MOSI PS0 RST SCK

Size: A4 | Rev:
KiCad E.D.A. 10.0.5 | Id: 1/4

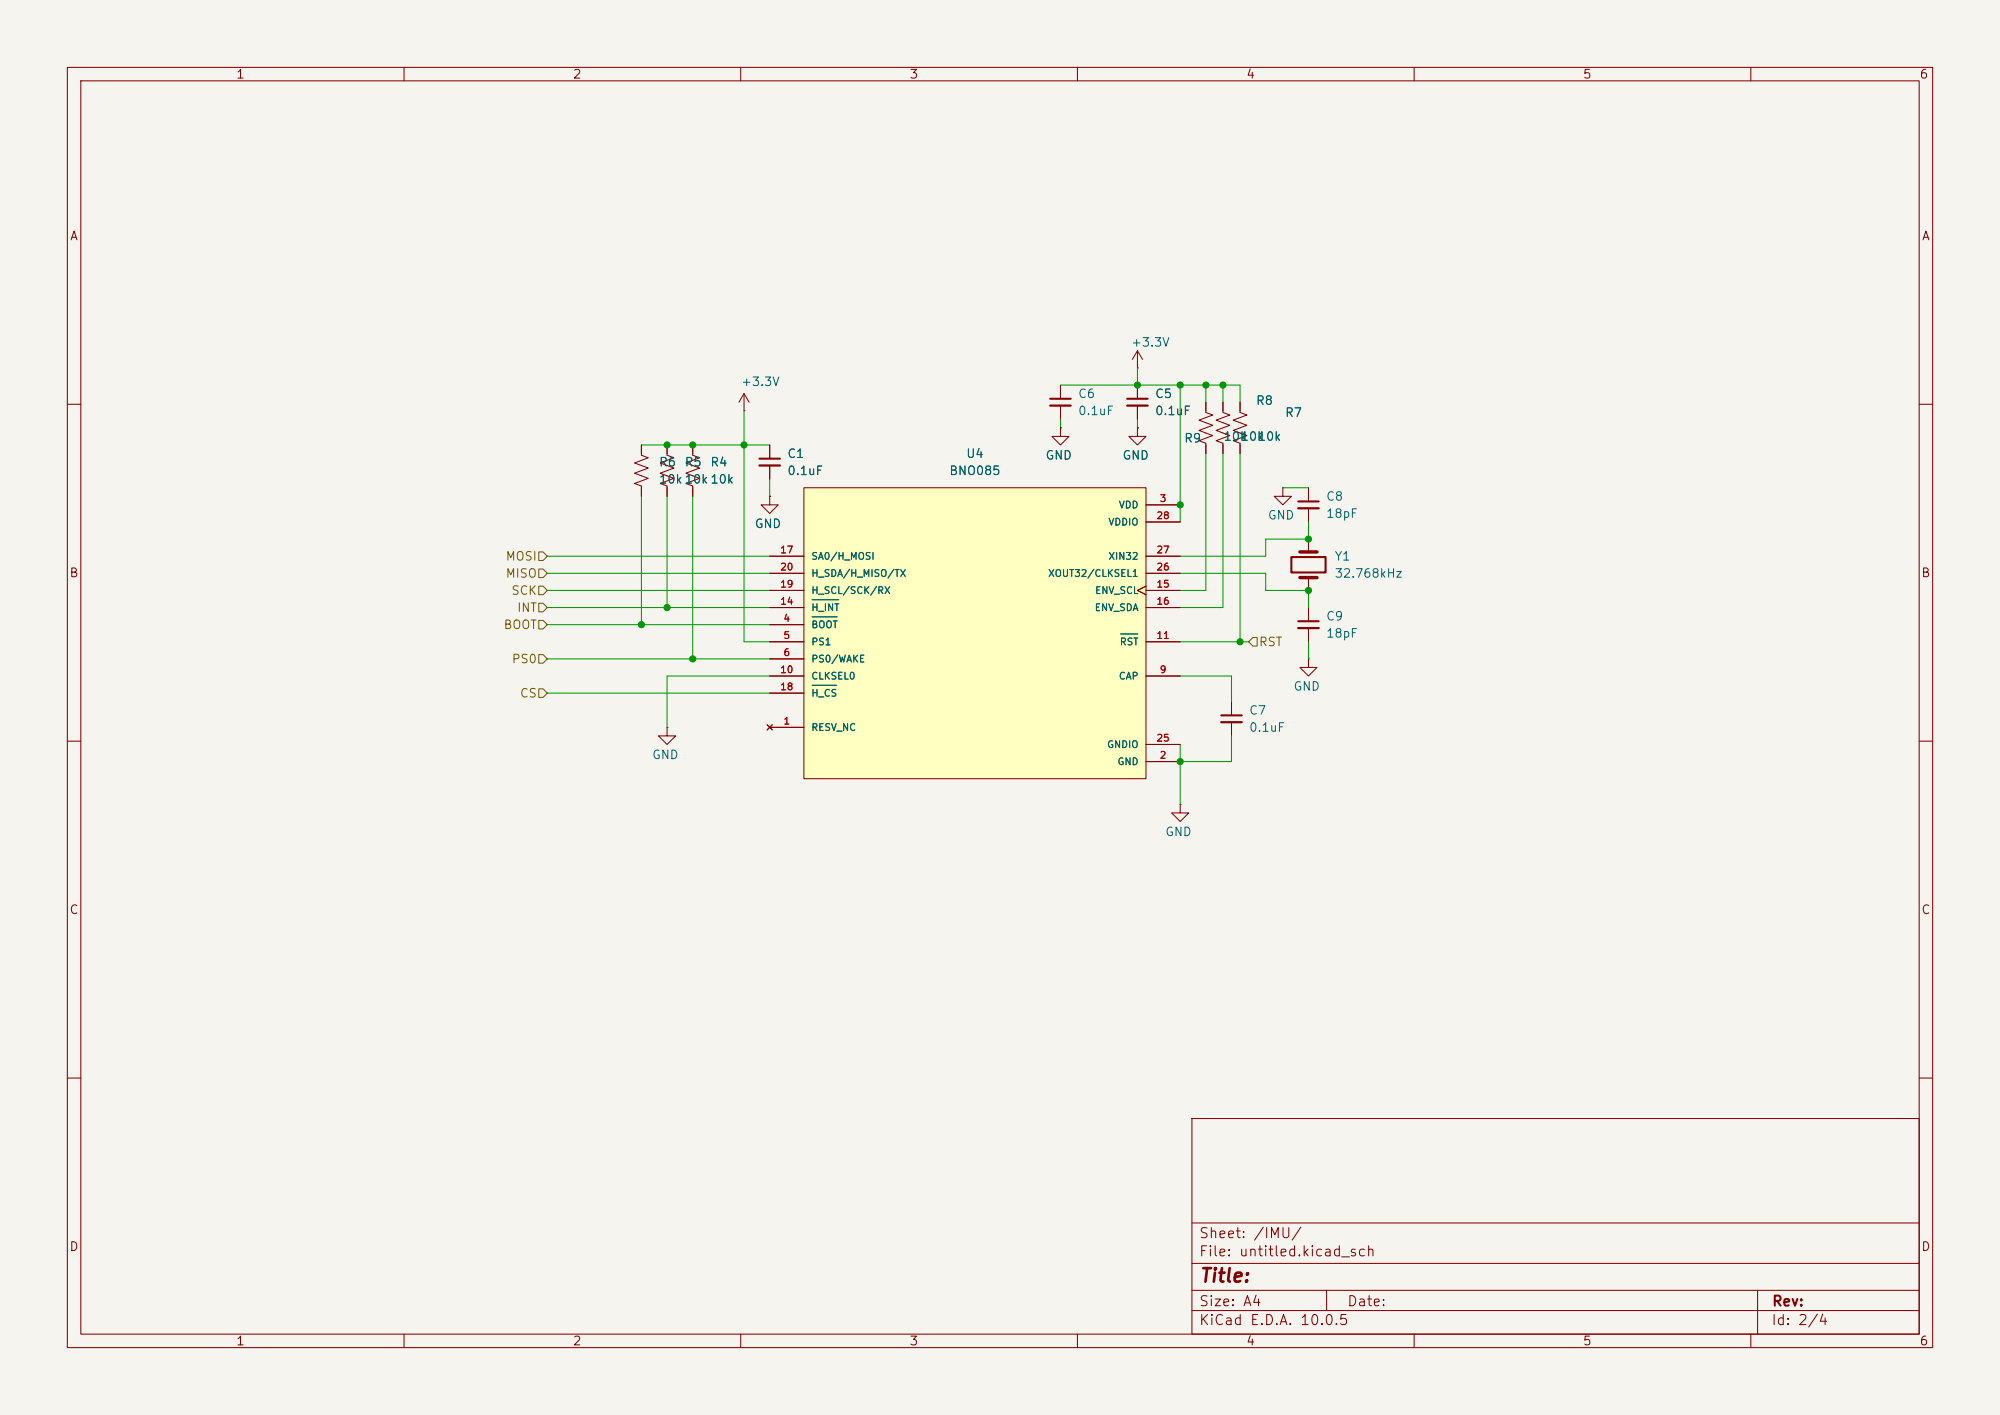
[picture p288: page 2]

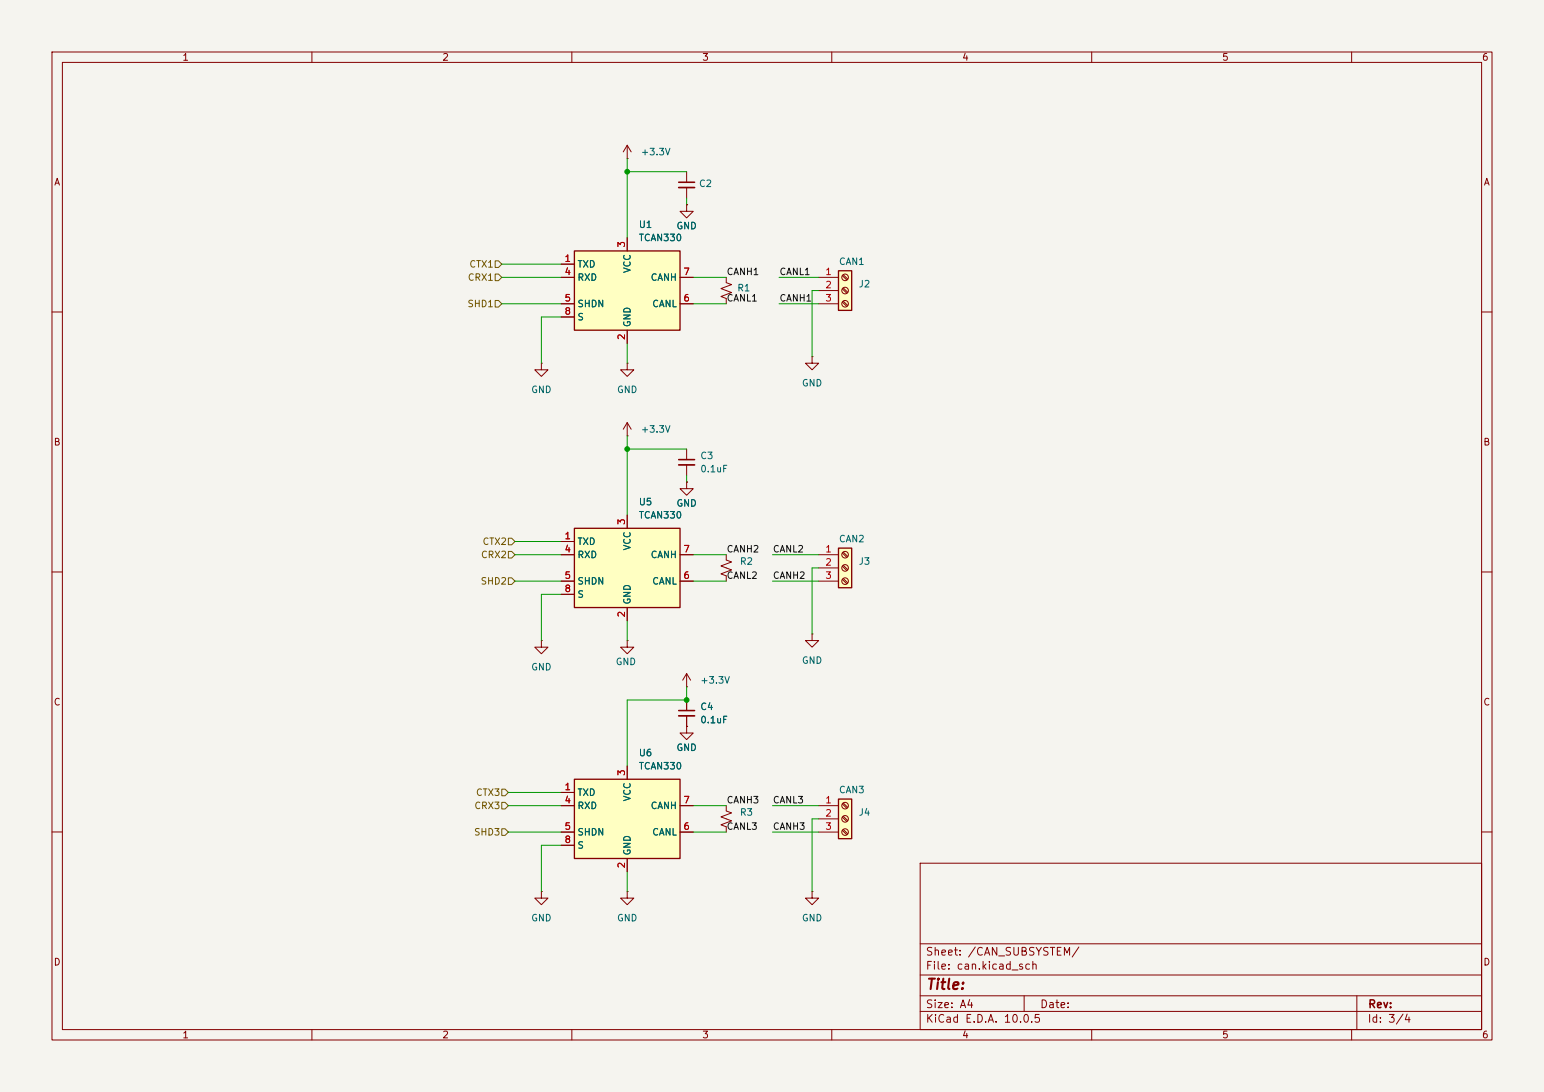
[picture p289: page 3]

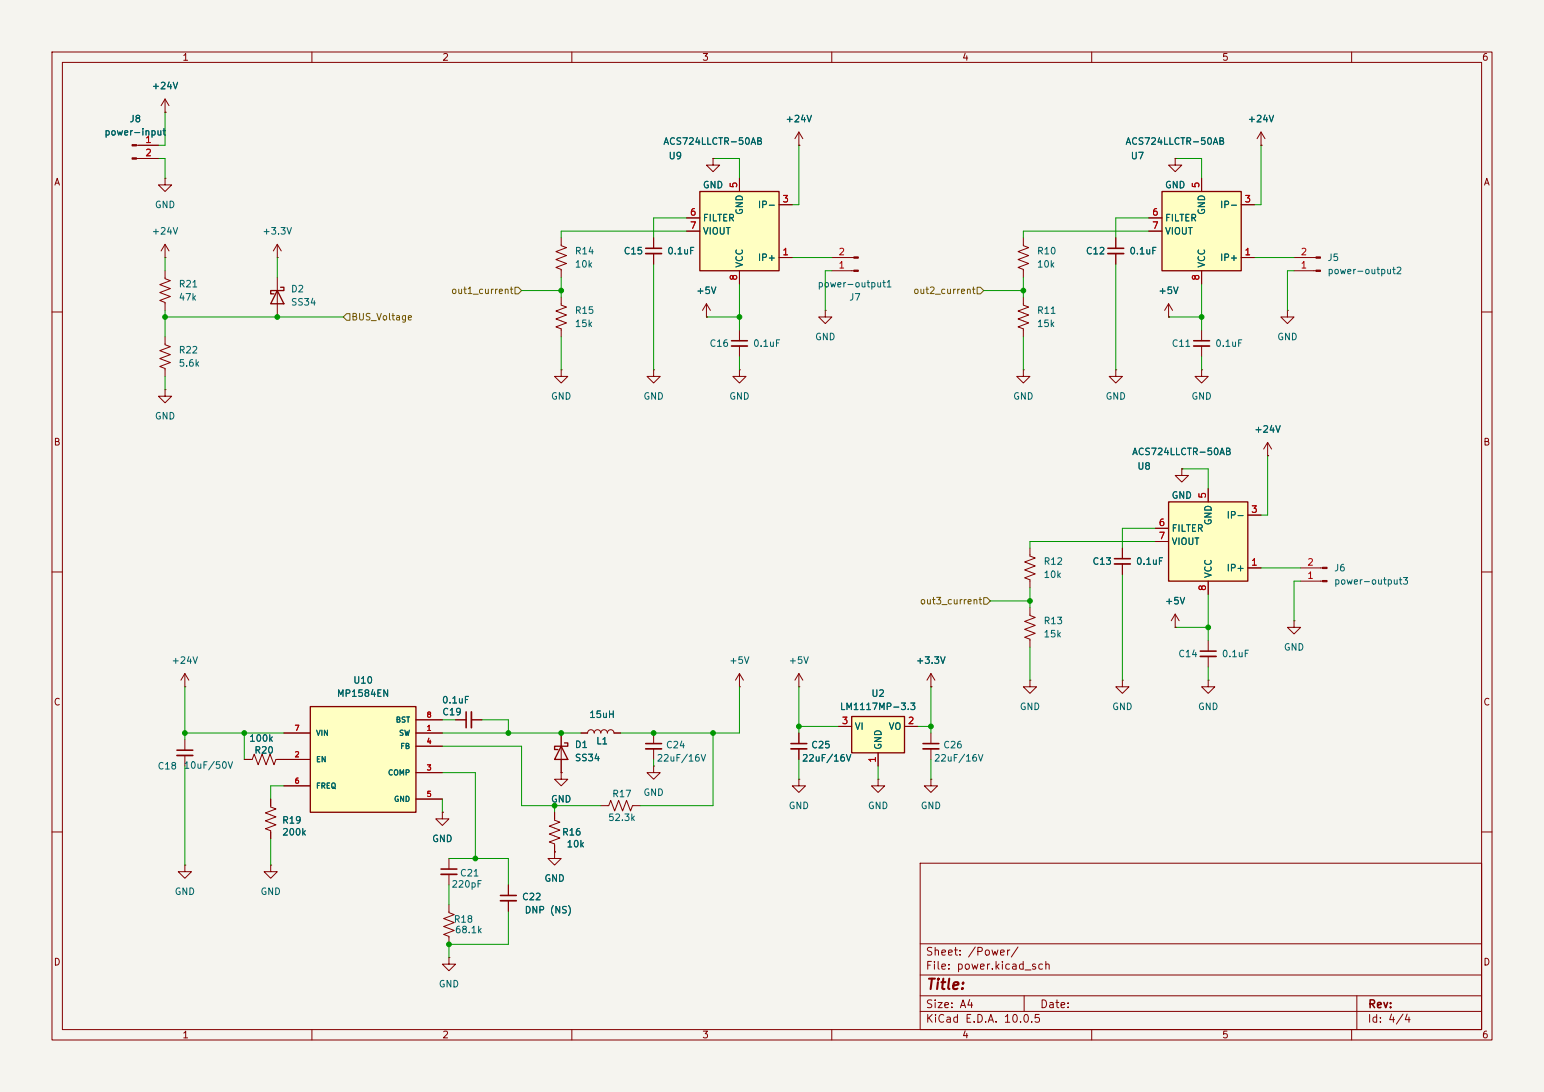
[picture p290: page 4]
