Klajdi00/open_mabel/hardware/bom/figures/bom_choices.pdf

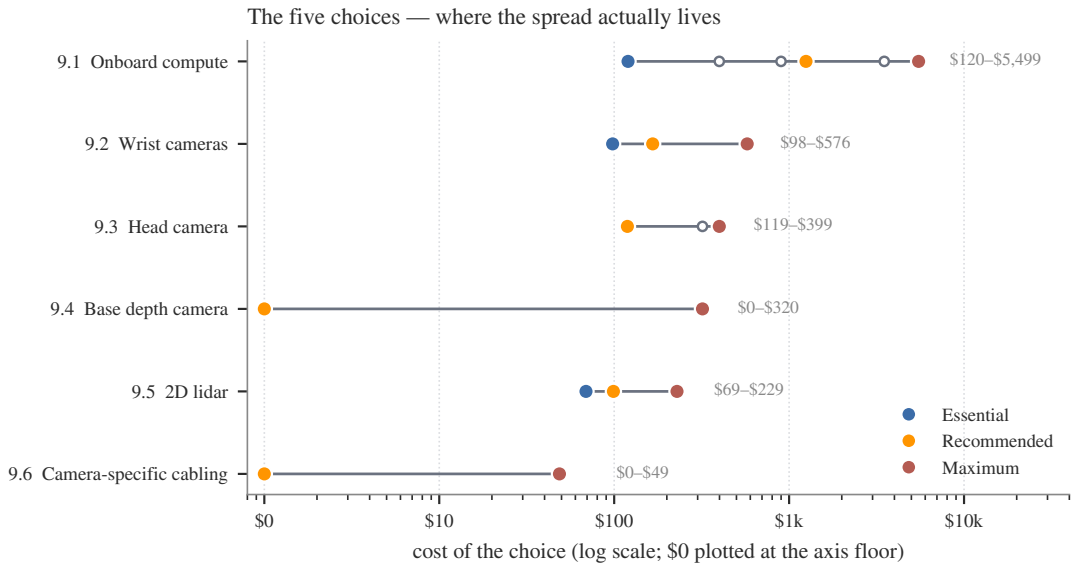
[picture p291: page 1]
9.1 Onboard compute; 9.2 Wrist cameras; 9.3 Head camera; 9.5 2D lidar; Essential Recommended Maximum

The five choices — where the spread actually lives

9.4 Base depth camera

9.6 Camera-specific cabling

cost of the choice (log scale; $0 plotted at the axis floor)
