Klajdi00/open_mabel/hardware/bom/figures/bom_volume.pdf

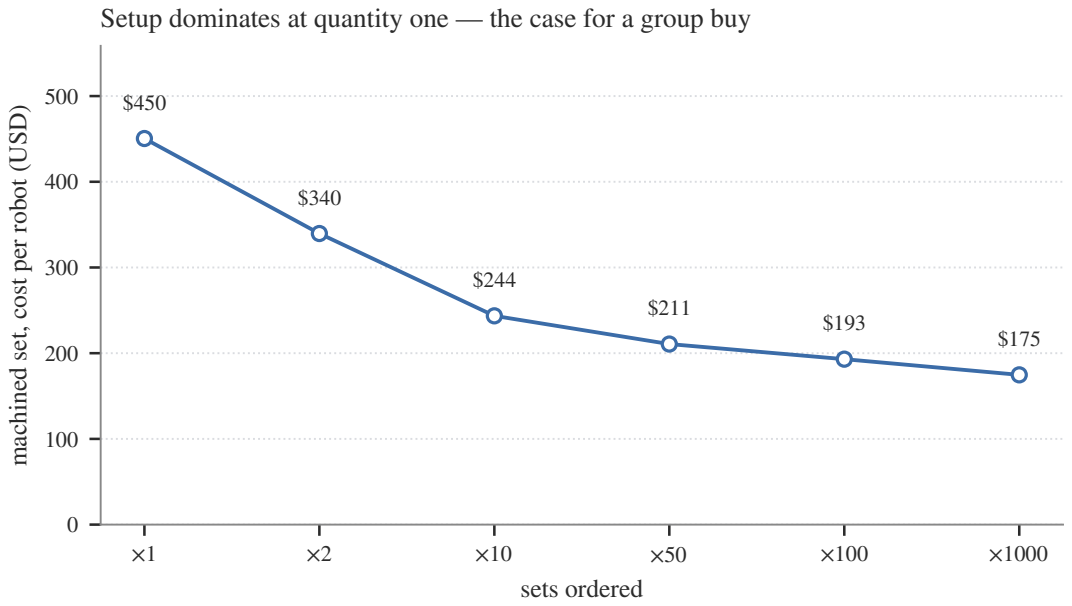
[picture p292: page 1]
sets ordered

Setup dominates at quantity one — the case for a group buy

machined set, cost per robot (USD)
