Klajdi00/open_mabel/calibration/arm_calibration/docs/figures/e5_noise.pdf

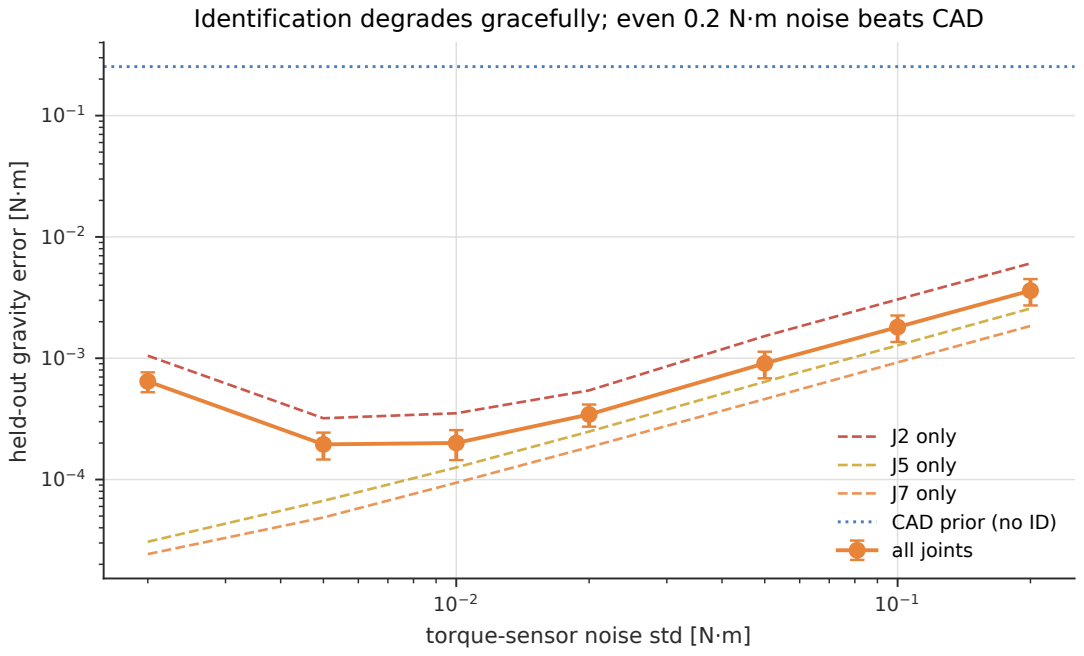
[picture p293: page 1]
error [N⋅m]

Identification degrades gracefully; even 0.2 N⋅m noise beats CAD

held-out gravity

J2 only
J5 only
J7 only
CAD prior (no ID)
all joints

torque-sensor noise std [N⋅m]
