Klajdi00/open_mabel/electrical/exports/Motherboard_layout.pdf

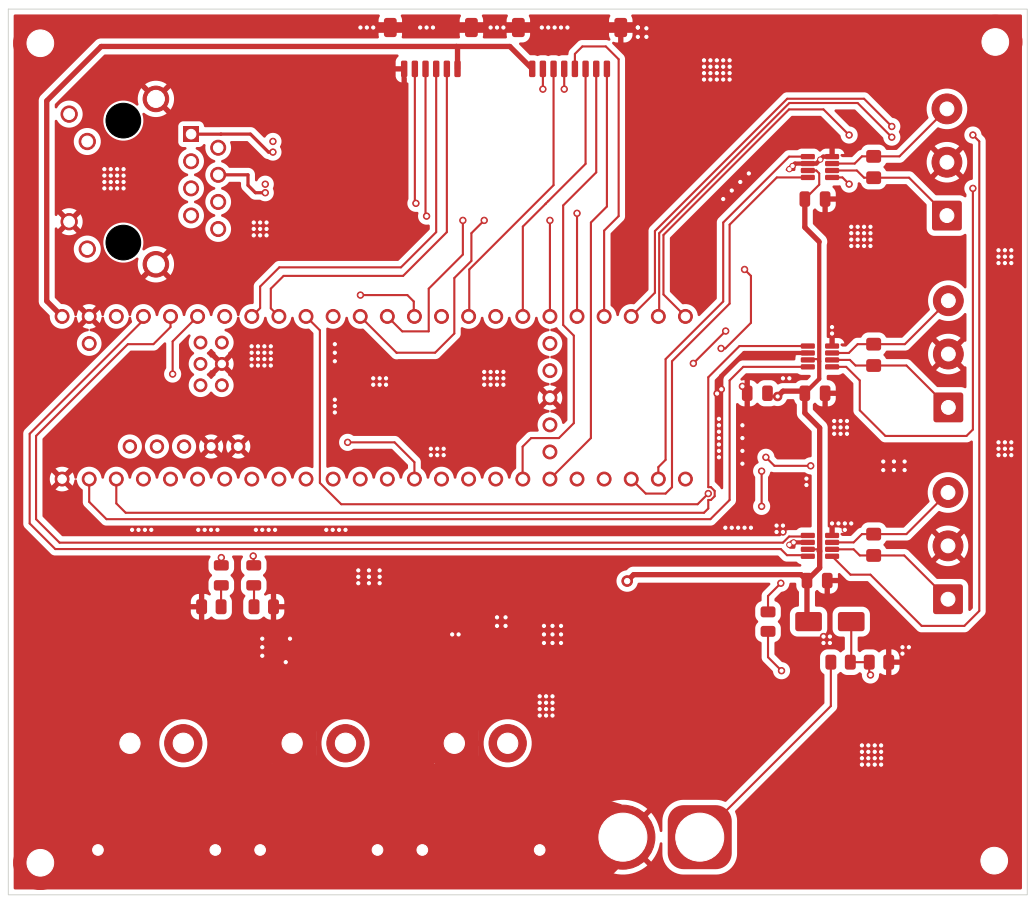
[picture p294: page 1]

Size: A4 | Rev:
KiCad E.D.A. 10.0.5 | Id: 1/6

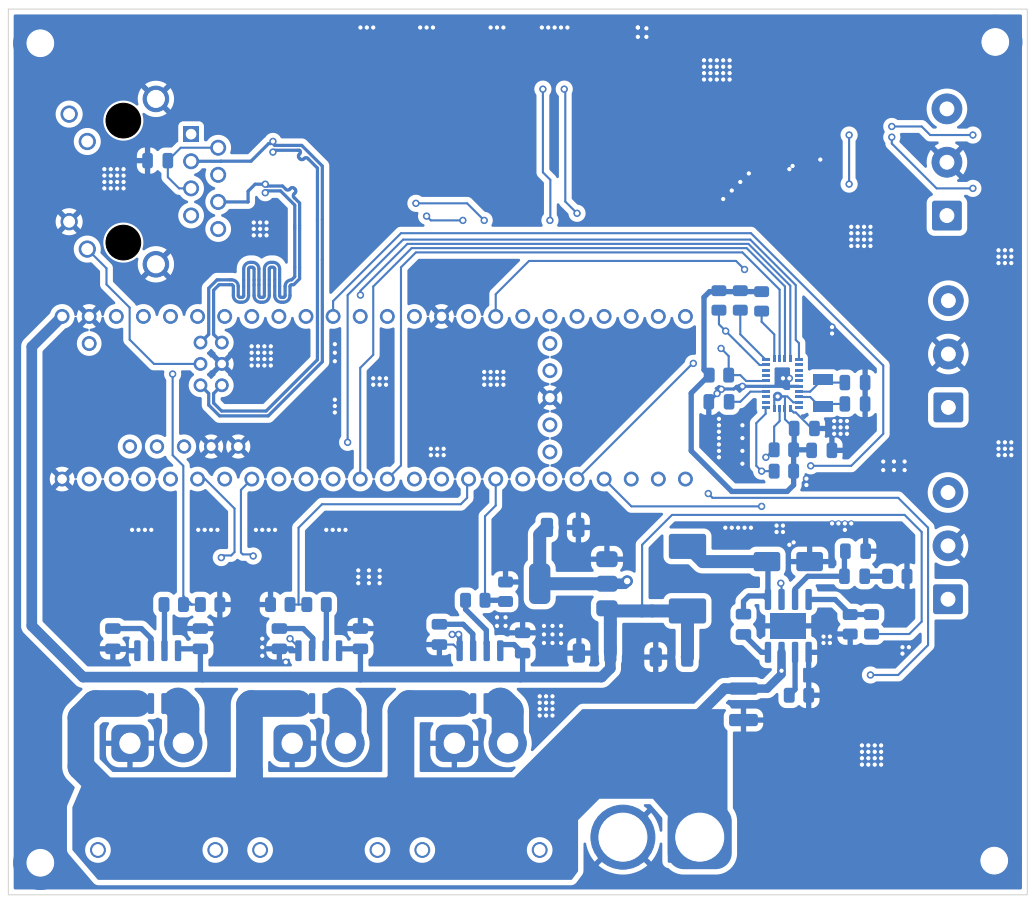
[picture p295: page 2]

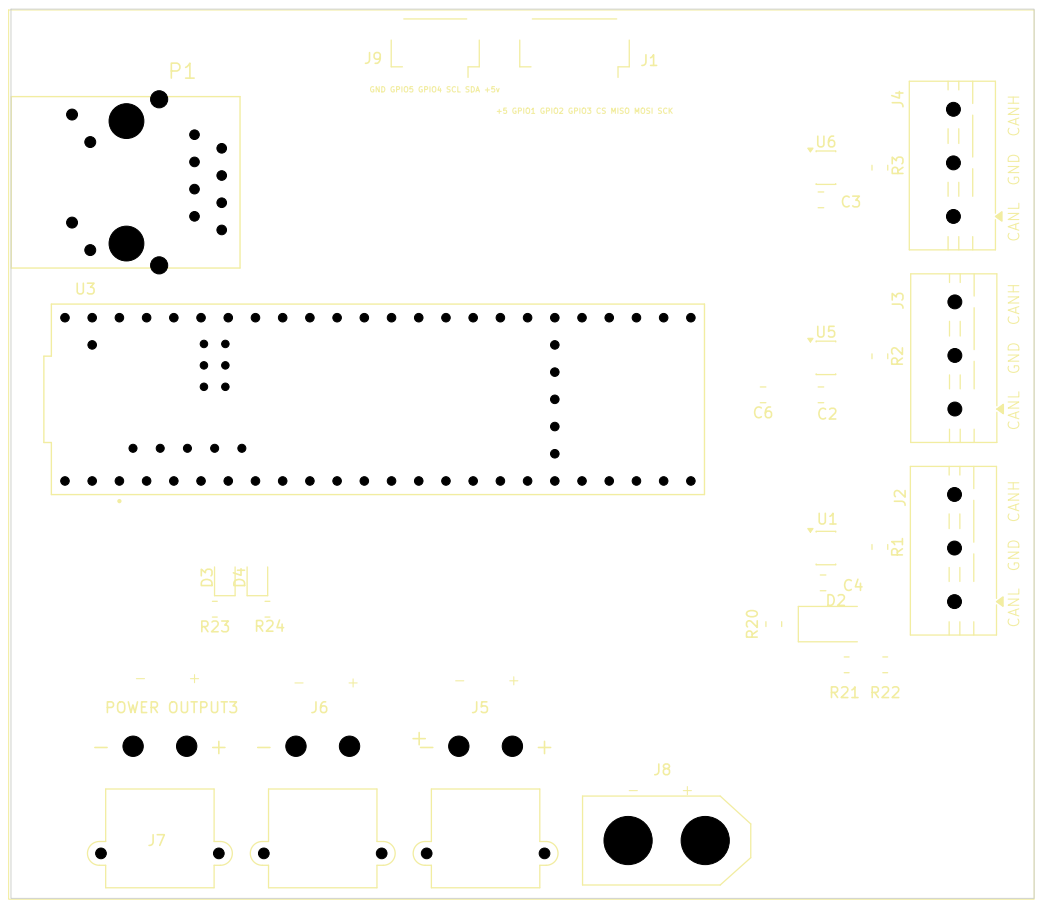
[picture p296: page 3]

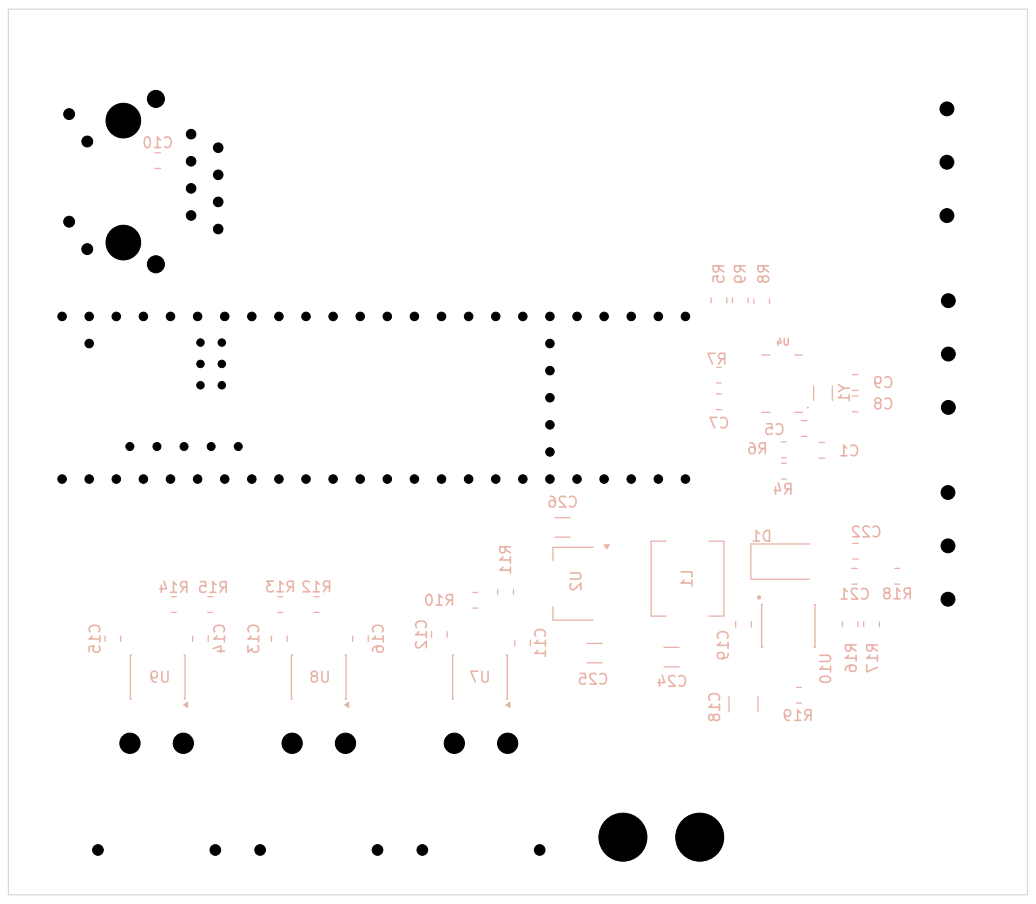
[picture p297: page 4]

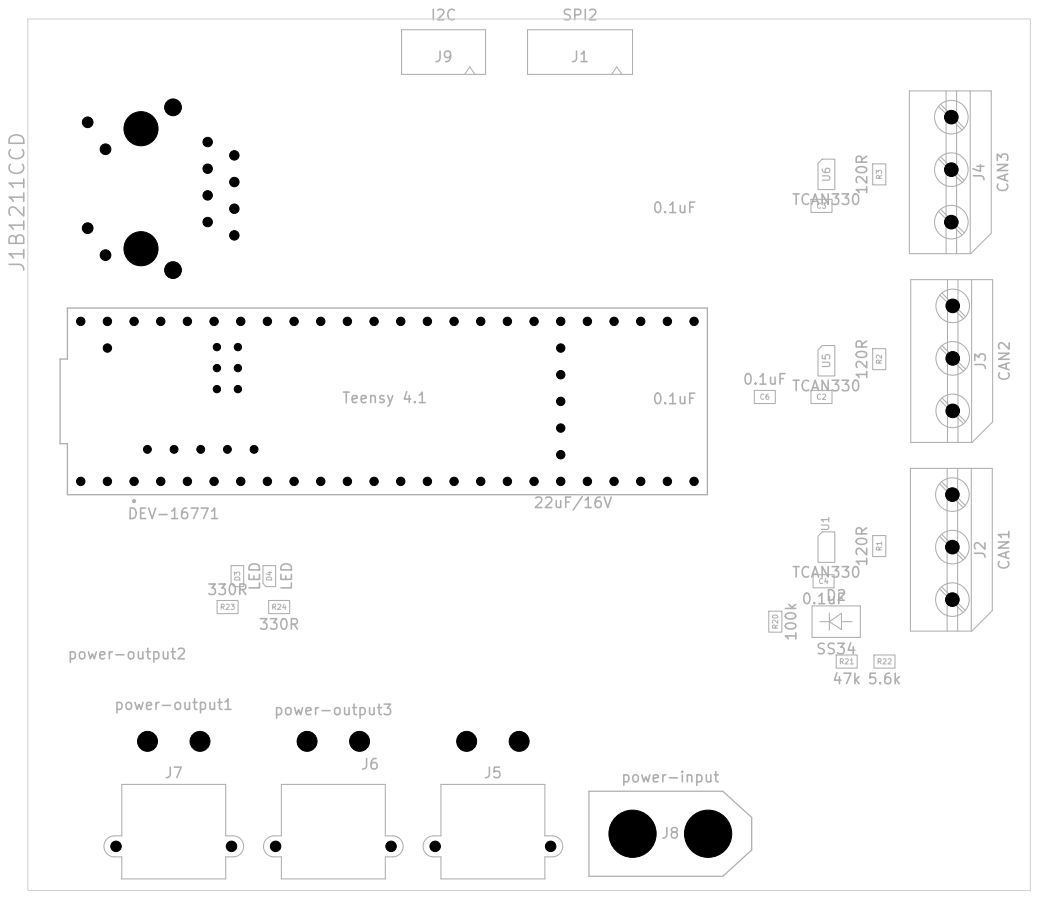
[picture p298: page 5]

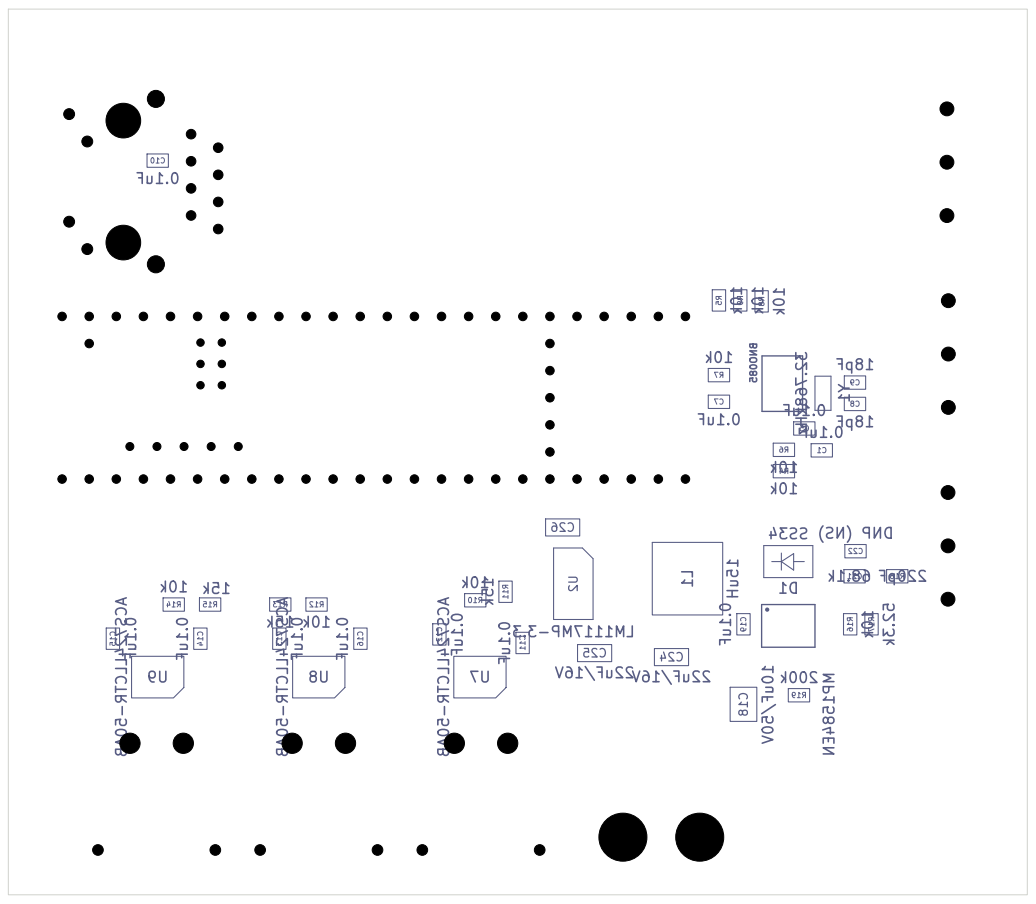
[picture p299: page 6]
