Klajdi00/open_mabel/controller/docs/figures/basic_e1_hold_vs_kp.pdf

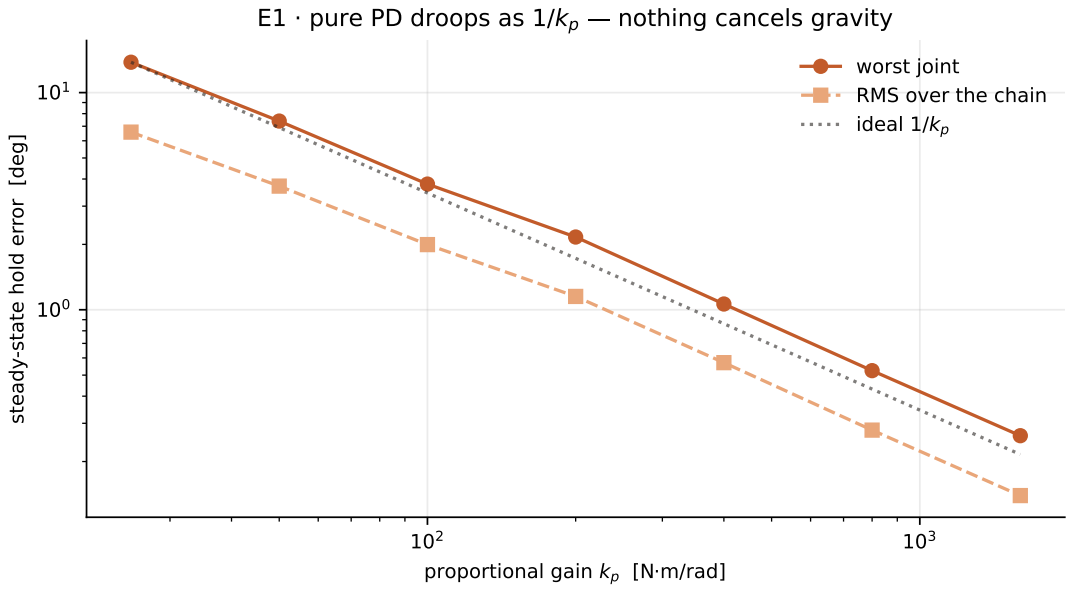
[picture p300: page 1]
tio; ain; hin; els; vit

worst joint
RMS over the chain ideal 1/kp

steady-state hold error [deg]
