Klajdi00/open_mabel/controller/docs/figures/calibration_robustness.pdf

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

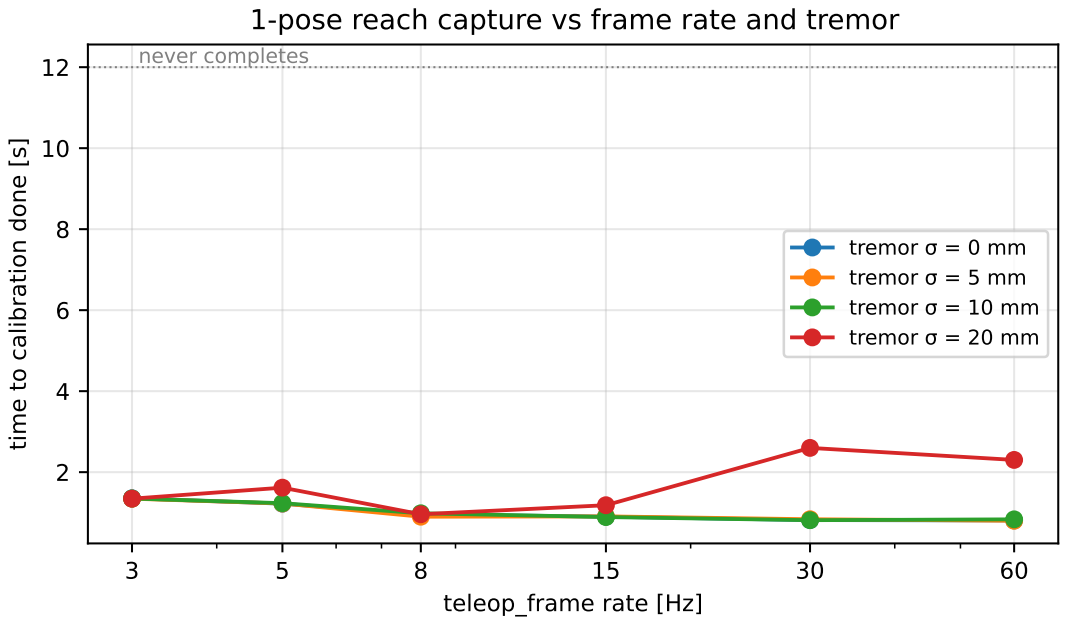
[picture p301: page 1]
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
