Klajdi00/open_mabel/controller/docs/figures/mm_zmp_usage.pdf

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

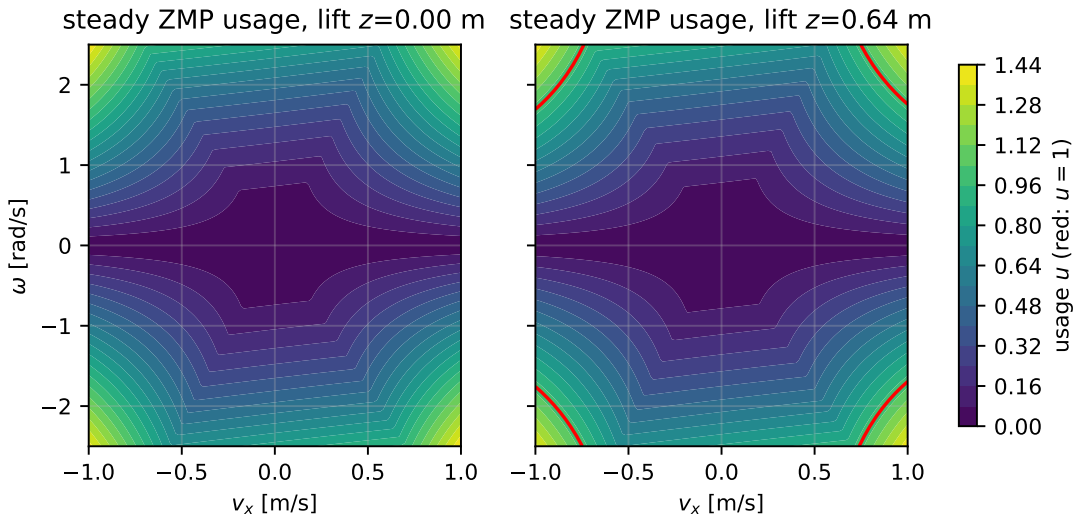
[picture p302: page 1]
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
