Klajdi00/open_mabel/controller/docs/figures/retarget_bimanual.pdf

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

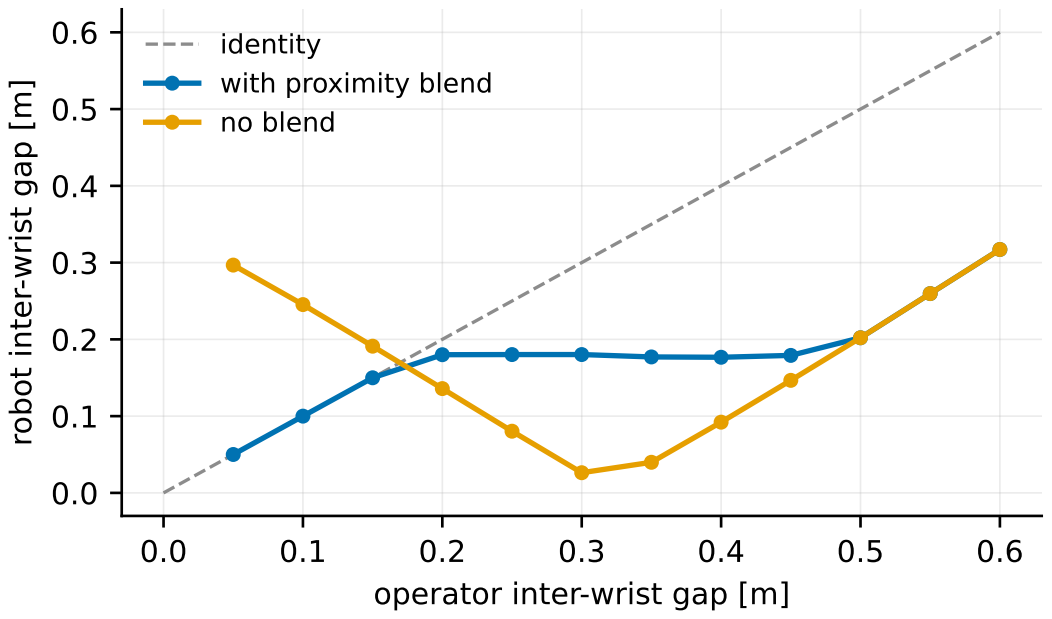
[picture p303: page 1]
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
