Klajdi00/open_mabel/controller/docs/figures/vp_bimanual.pdf

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

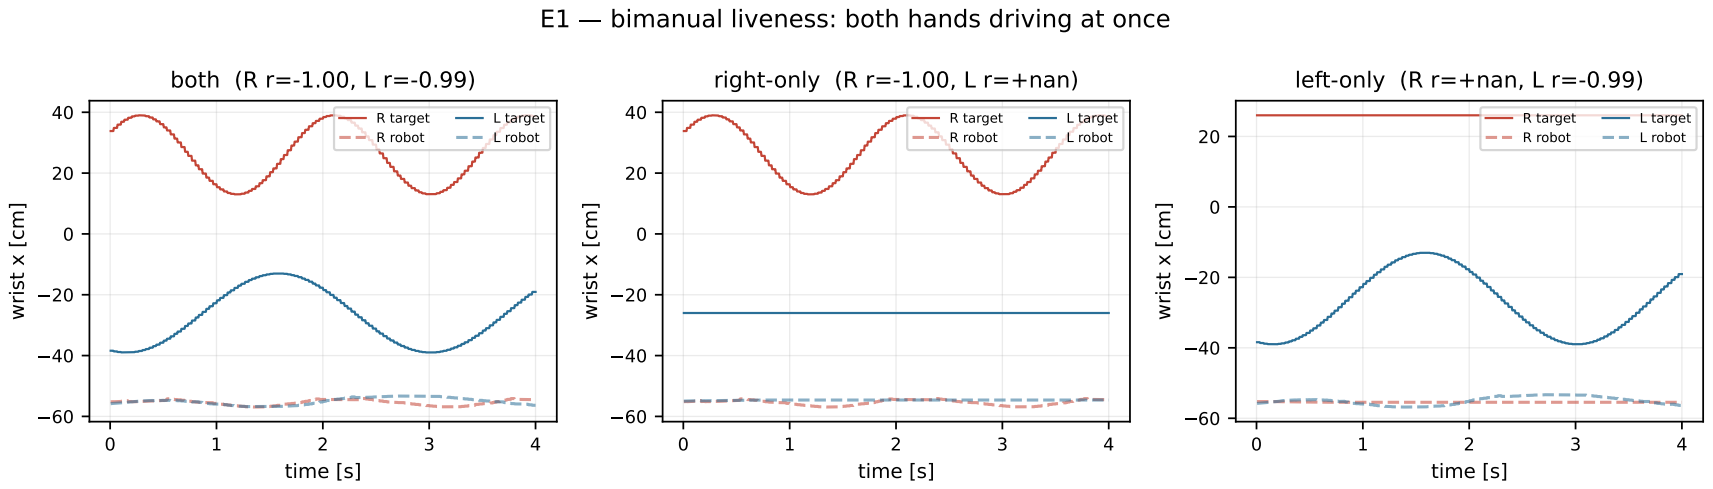
[picture p304: page 1]
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
