Klajdi00/open_mabel/hardware_bridge/docs/figures/hwapi_facade_overhead.pdf

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

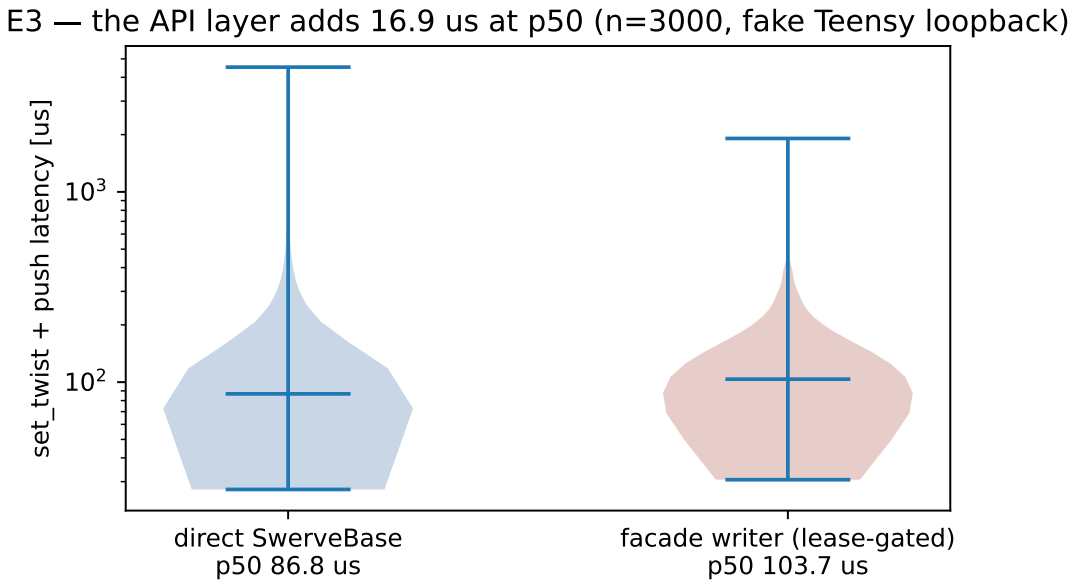
[picture p305: page 1]
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
