Klajdi00/open_mabel/server/docs/figures/arm_step_response.pdf

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

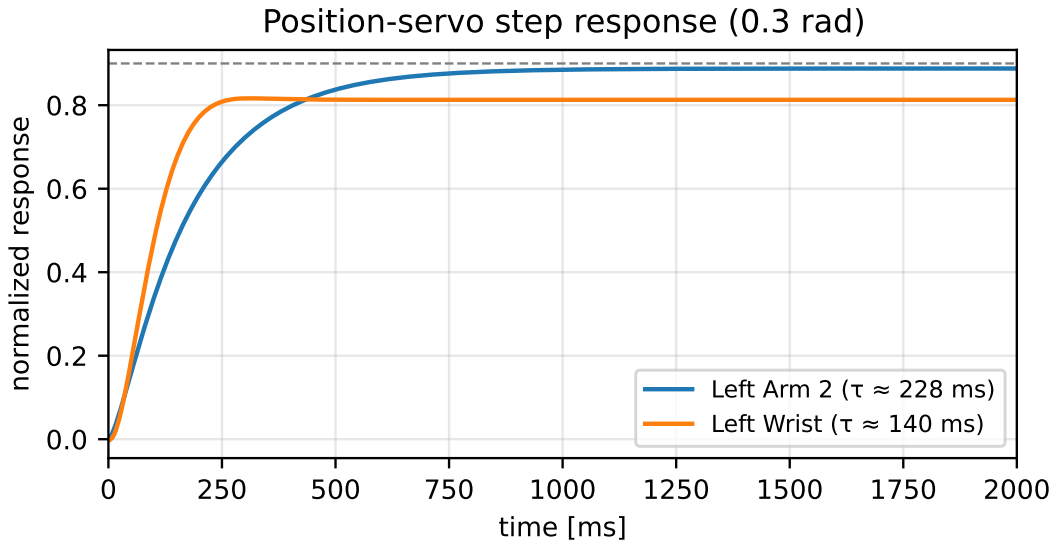
[picture p306: page 1]
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
