Klajdi00/open_mabel/calibration/arm_calibration/docs/figures/e1_identifiability.pdf

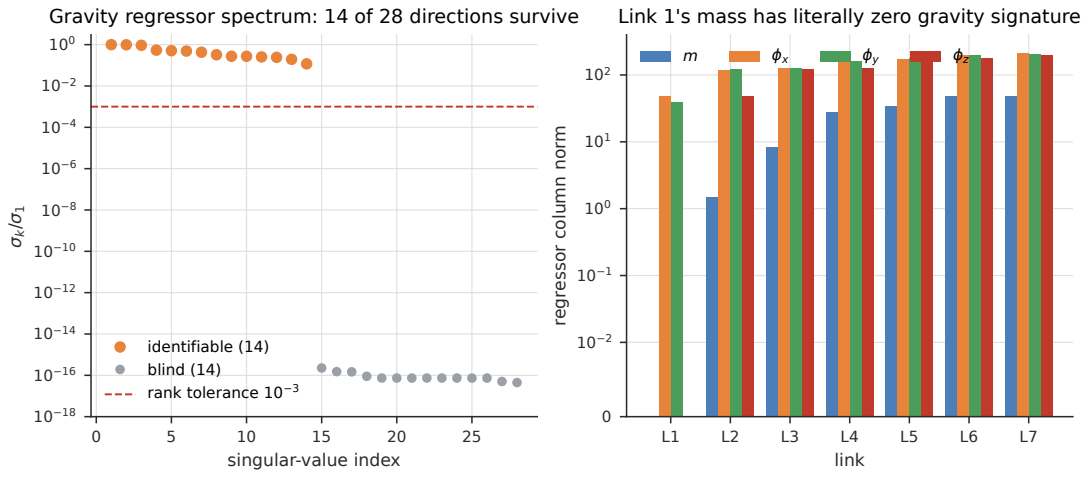
[picture p307: page 1]
identifiable (14) blind (14) rank tolerance 10; link

Gravity regressor spectrum: 14 of 28 directions survive

Link 1's mass has literally zero gravity signature

regressor column norm

singular-value index
