Klajdi00/open_mabel/calibration/arm_calibration/docs/figures/e6_budget.pdf

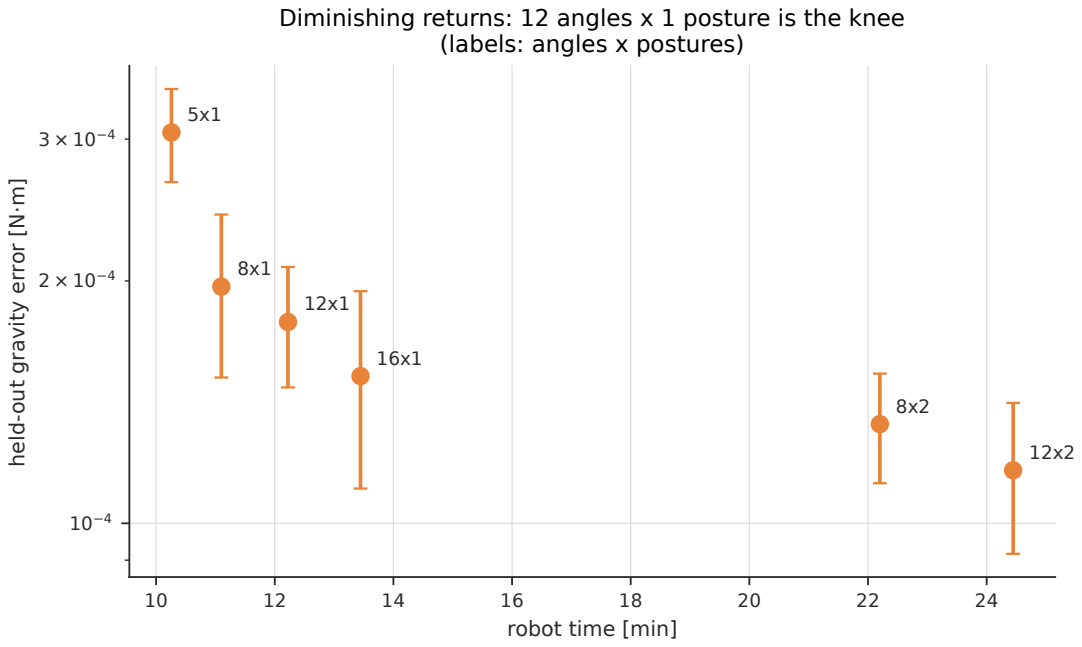
[picture p308: page 1]
error [N⋅m]

Diminishing returns: 12 angles x 1 posture is the knee

(labels: angles x postures)

held-out gravity

robot time [min]
