Klajdi00/open_mabel/calibration/arm_calibration/docs/figures/e7_safety.pdf

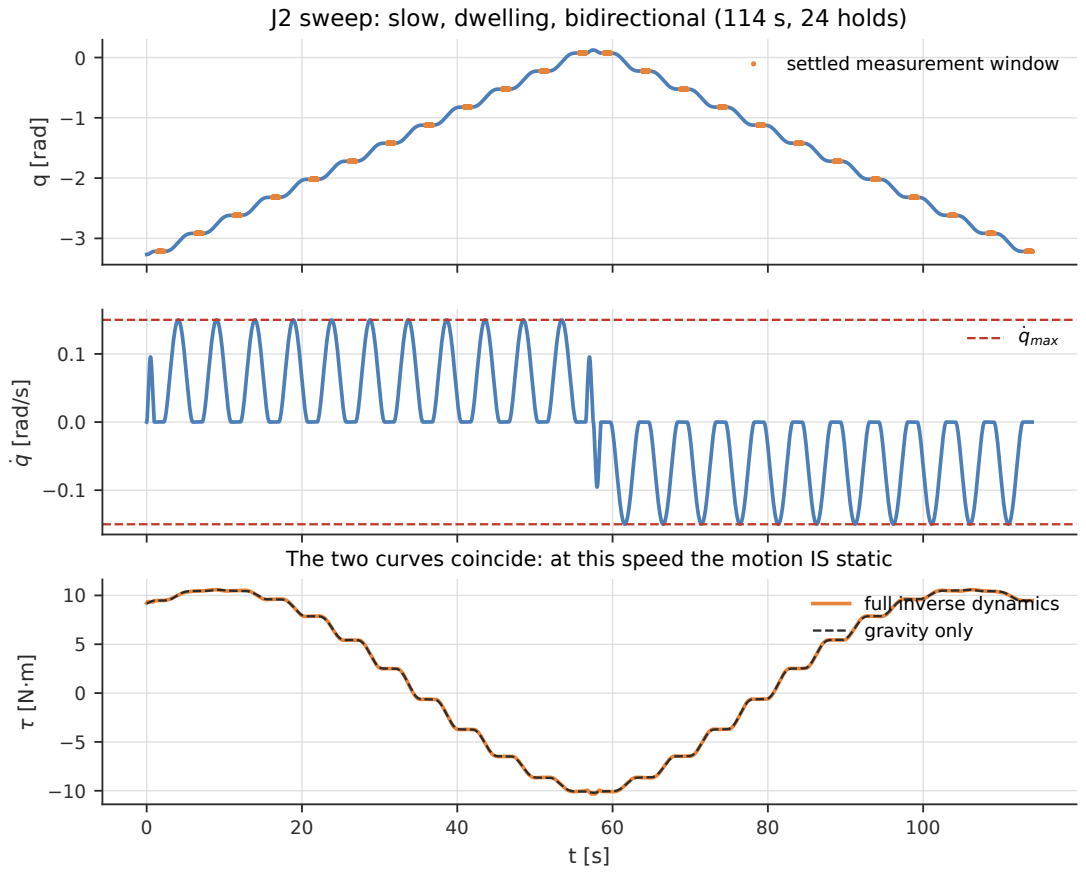
[picture p309: page 1]
q [rad]; ̇ q [rad/s]; q̇max

J2 sweep: slow, dwelling, bidirectional (114 s, 24 holds)

settled measurement window

The two curves coincide: at this speed the motion IS static

full inverse dynamics
gravity only
