Klajdi00/open_mabel/web_gui/simulation_control_center/docs/figures/retarget_step.pdf

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

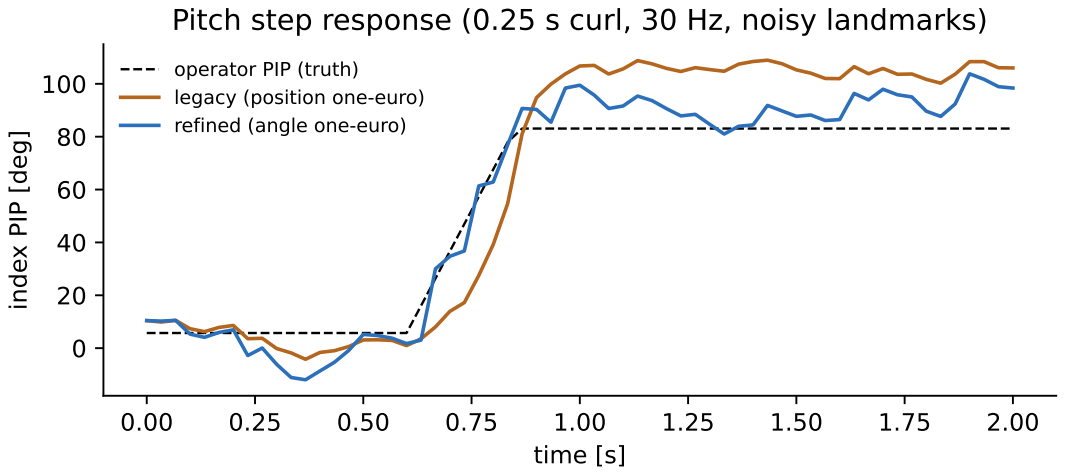
[picture p310: page 1]
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
