Klajdi00/open_mabel/controller/docs/figures/arm_wrist_roll.pdf

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

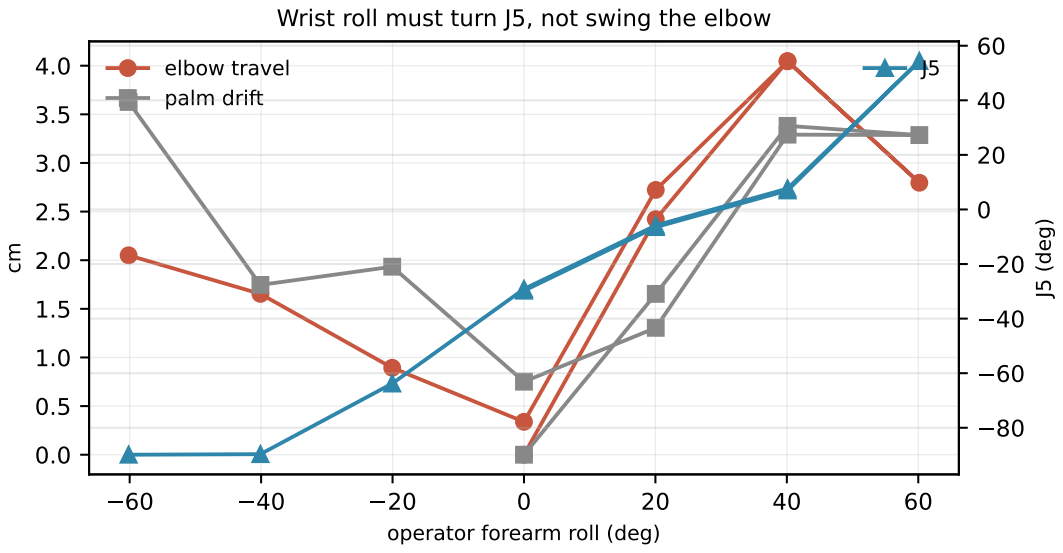
[picture p312: page 1]
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
