Klajdi00/open_mabel/controller/docs/figures/basic_e4_moving_target.pdf

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

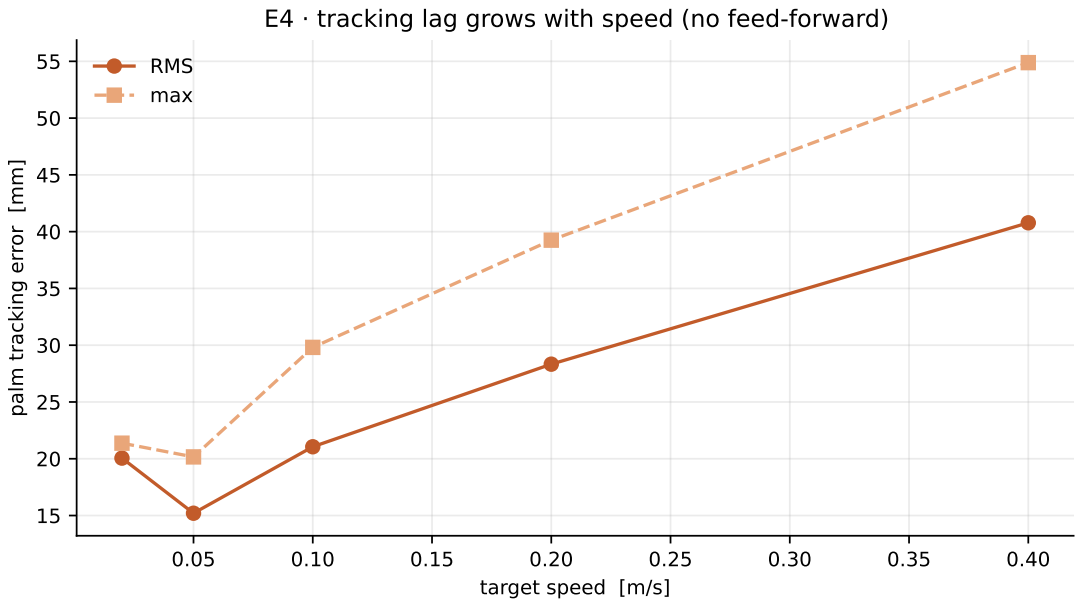
[picture p313: page 1]
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
