Klajdi00/open_mabel/electrical/Motherboard/Motherboard.kicad_pcb

## KiCad design electrical/Motherboard/Motherboard.kicad_pcb (2026-11-04)

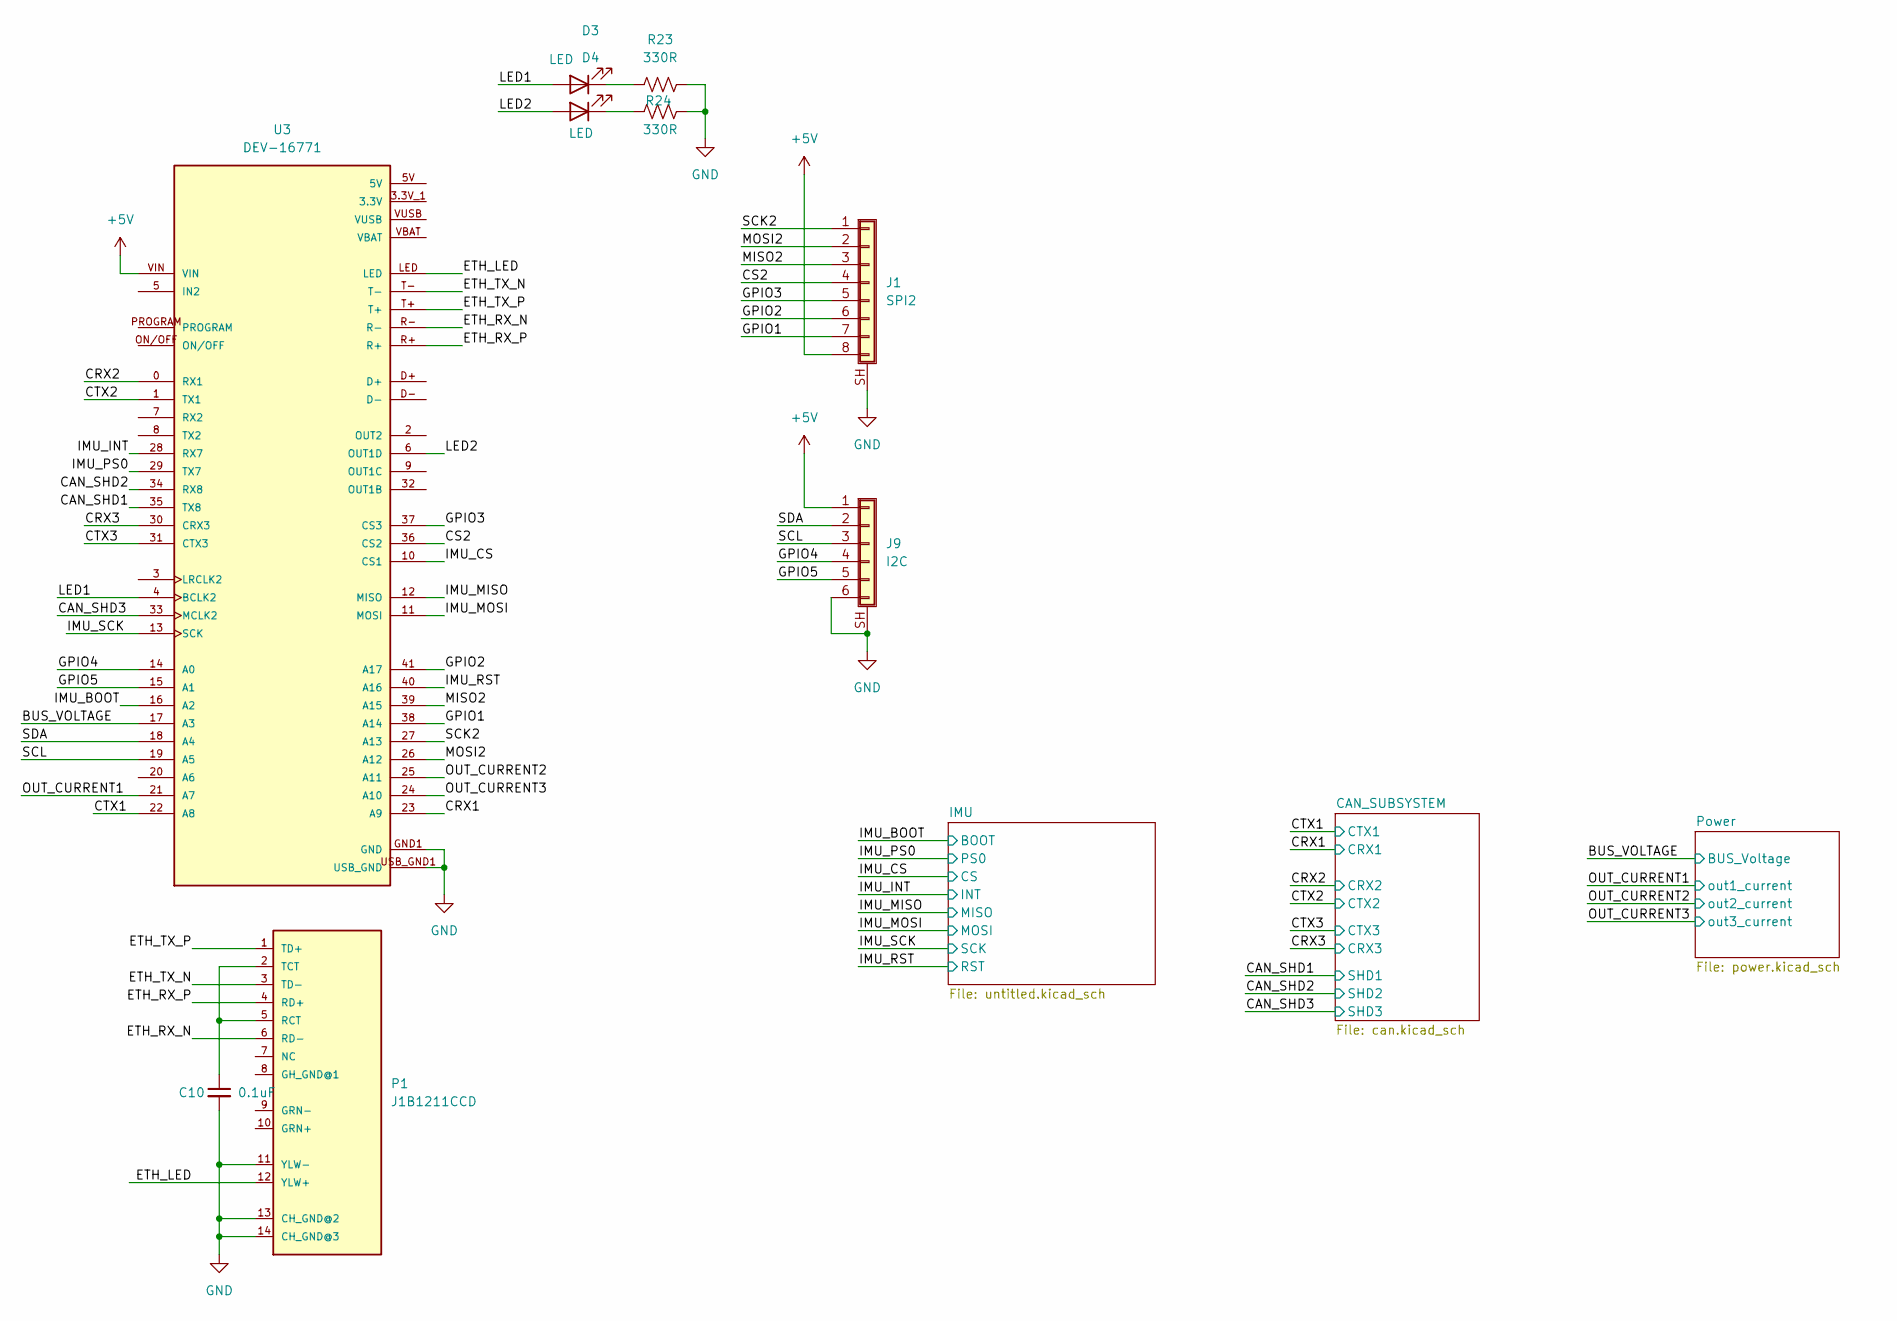
[picture p314: schematic Motherboard.kicad_sch]

Parts:
C10: 0.1uF; C_0805_2012Metric
D3, D4: LED; LED_0805_2012Metric
J1: SPI2; JST_SH_SM08B-SRSS-TB_1x08-1MP_P1.00mm_Horizontal
J9: I2C; JST_SH_SM06B-SRSS-TB_1x06-1MP_P1.00mm_Horizontal
P1: J1B1211CCD
R23, R24: 330R; R_0805_2012Metric
U3: DEV-16771; Teensy41; PARTREV 4.1

Connections:
3.3V: U3.3.3V_1 (3.3V), U3.3.3V_2 (3.3V), U3.3.3V_3 (3.3V)
+5V: J1.8, J9.1, U3.VIN; also elsewhere on the board
/BUS_VOLTAGE: U3.17 (A3); also elsewhere on the board
/CAN_SHD1: U3.35 (TX8); also elsewhere on the board
/CAN_SHD2: U3.34 (RX8); also elsewhere on the board
/CAN_SHD3: U3.33 (MCLK2); also elsewhere on the board
/CRX1: U3.23 (A9); also elsewhere on the board
/CRX2: U3.0 (RX1); also elsewhere on the board
/CRX3: U3.30 (CRX3); also elsewhere on the board
/CS2: J1.4, U3.36 (CS2)
/CTX1: U3.22 (A8); also elsewhere on the board
/CTX2: U3.1 (TX1); also elsewhere on the board
/CTX3: U3.31 (CTX3); also elsewhere on the board
/ETH_LED: P1.12 (YLW+), U3.LED
/ETH_RX_N: P1.6 (RD-), U3.R-
/ETH_RX_P: P1.4 (RD+), U3.R+
/ETH_TX_N: P1.3 (TD-), U3.T-
/ETH_TX_P: P1.1 (TD+), U3.T+
/GPIO1: J1.7, U3.38 (A14)
/GPIO2: J1.6, U3.41 (A17)
/GPIO3: J1.5, U3.37 (CS3)
/GPIO4: J9.4, U3.14 (A0)
/GPIO5: J9.5, U3.15 (A1)
/IMU_BOOT: U3.16 (A2); also elsewhere on the board
/IMU_CS: U3.10 (CS1); also elsewhere on the board
/IMU_INT: U3.28 (RX7); also elsewhere on the board
/IMU_MISO: U3.12 (MISO); also elsewhere on the board
/IMU_MOSI: U3.11 (MOSI); also elsewhere on the board
/IMU_PS0: U3.29 (TX7); also elsewhere on the board
/IMU_RST: U3.40 (A16); also elsewhere on the board
/IMU_SCK: U3.13 (SCK); also elsewhere on the board
/LED1: D3.2 (A), U3.4 (BCLK2)
/LED2: D4.2 (A), U3.6 (OUT1D)
/MISO2: J1.3, U3.39 (A15)
/MOSI2: J1.2, U3.26 (A12)
/OUT_CURRENT1: U3.21 (A7); also elsewhere on the board
/OUT_CURRENT2: U3.25 (A11); also elsewhere on the board
/OUT_CURRENT3: U3.24 (A10); also elsewhere on the board
/SCK2: J1.1, U3.27 (A13)
/SCL: J9.3, U3.19 (A5)
/SDA: J9.2, U3.18 (A4)
GND: C10.2, J1.MP, J1.SH (Shield), J9.6, J9.MP, J9.SH (Shield), P1.11 (YLW-), P1.13 (CH_GND@2), P1.14 (CH_GND@3), R23.2, R24.2, U3.GND1 (GND), U3.GND2 (GND), U3.GND3 (GND), U3.GND4 (GND), U3.GND5 (GND), U3.USB_GND1 (USB_GND), U3.USB_GND2 (USB_GND); also elsewhere on the board
unnamed: D3.1 (K), R23.1
unnamed: D4.1 (K), R24.1
unnamed: C10.1, P1.2 (TCT), P1.5 (RCT)

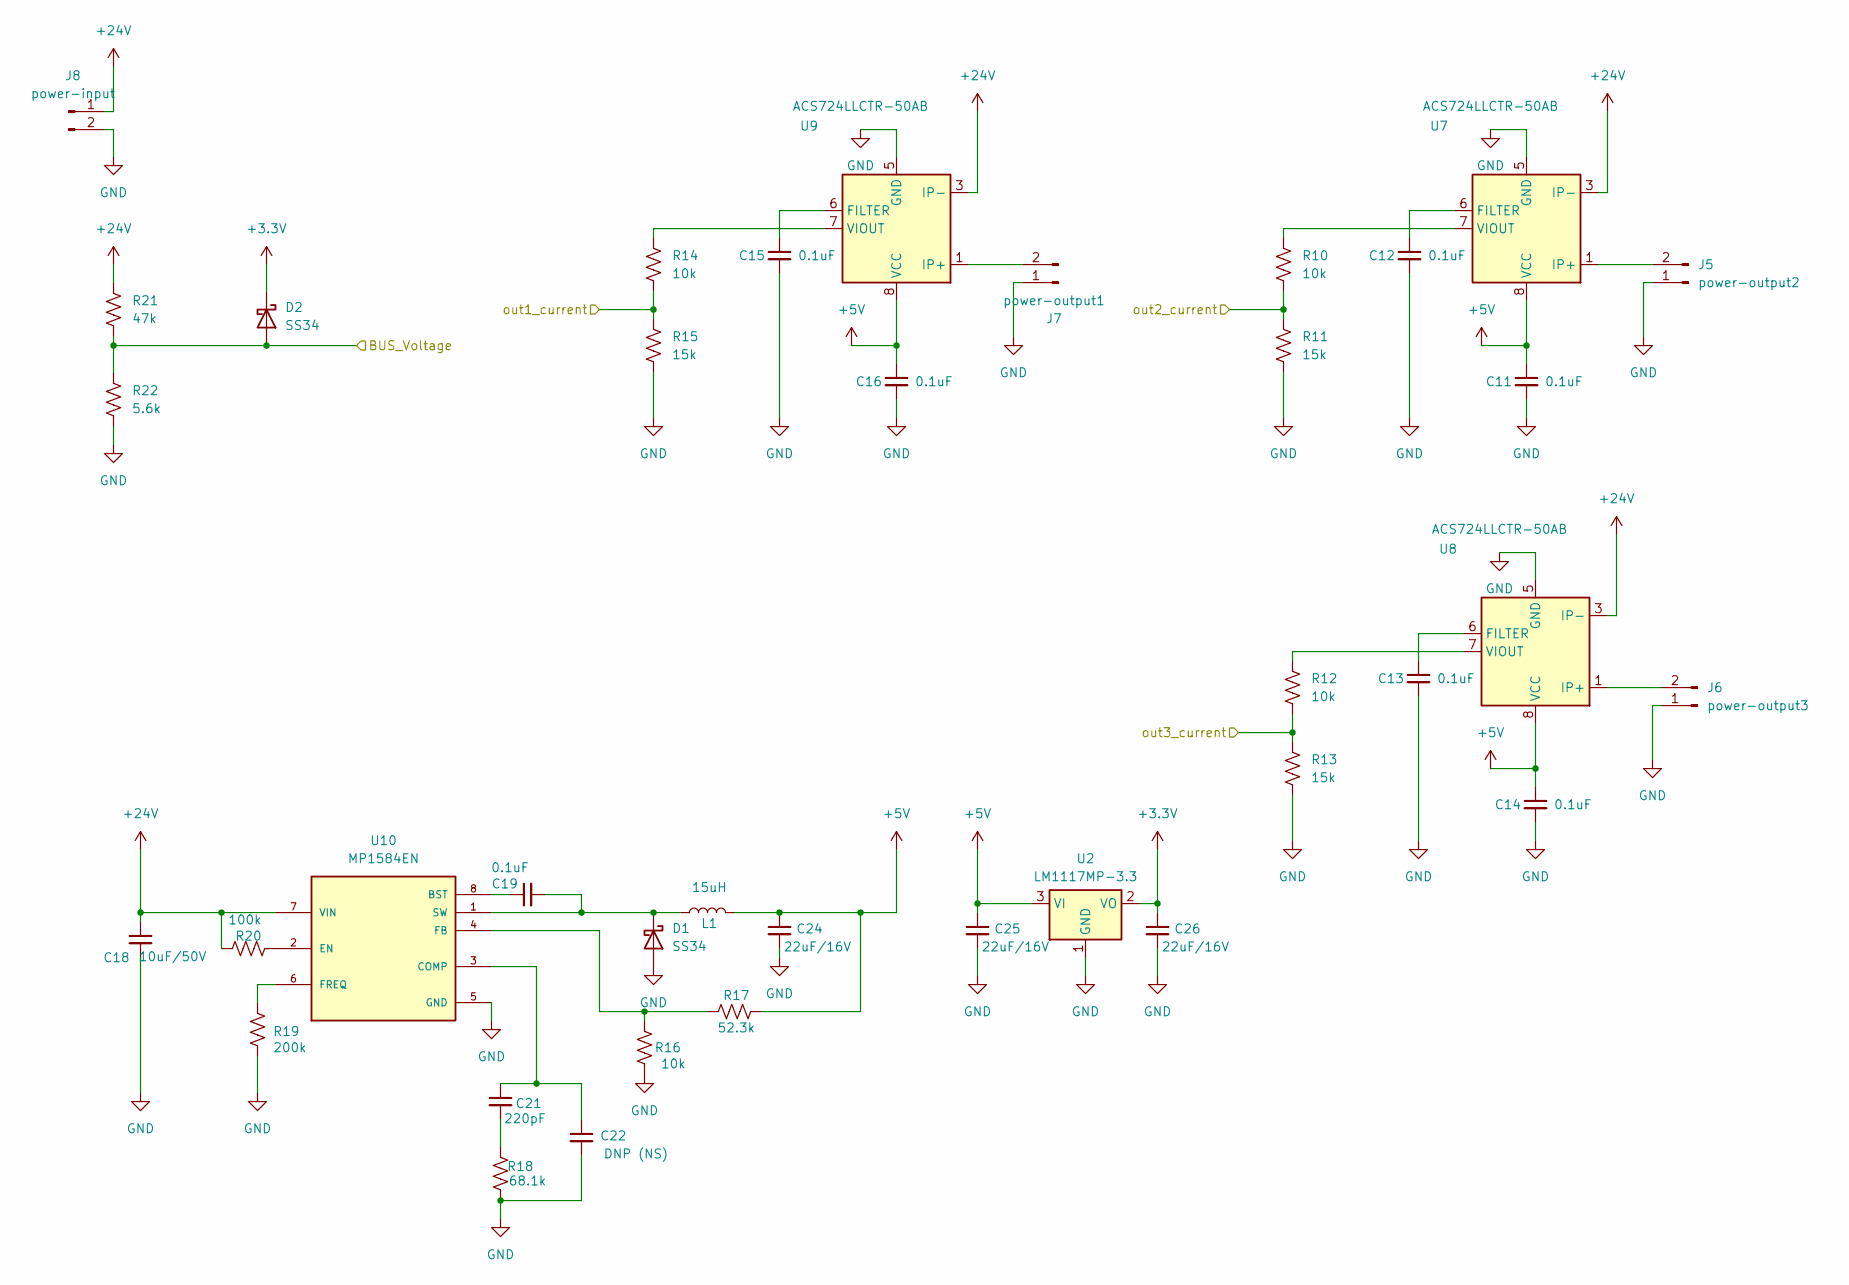
[picture p315: schematic power.kicad_sch]

Parts:
C11, C12, C13, C14, C15, C16, C19: 0.1uF; C_0805_2012Metric
C18: 10uF/50V; C_1210_3225Metric
C21: 220pF; C_0805_2012Metric
C22: DNP (NS); C_0805_2012Metric
C24, C25, C26: 22uF/16V; C_1206_3216Metric
D1, D2: SS34; D_SMA
J5: power-output2; AMASS_XT30PW-M_1x02_P2.50mm_Horizontal
J6: power-output3; AMASS_XT30PW-M_1x02_P2.50mm_Horizontal
J7: power-output1; AMASS_XT30PW-M_1x02_P2.50mm_Horizontal
J8: power-input; AMASS_XT60-F_1x02_P7.20mm_Vertical
L1: 15uH; L_APV_APH0630
R10, R12, R14, R16: 10k; R_0805_2012Metric
R11, R13, R15: 15k; R_0805_2012Metric
R17: 52.3k; R_0805_2012Metric
R18: 68.1k; R_0805_2012Metric
R19: 200k; R_0805_2012Metric
R20: 100k; R_0805_2012Metric
R21: 47k; R_0805_2012Metric
R22: 5.6k; R_0805_2012Metric
U2: LM1117MP-3.3; SOT-223-3_TabPin2
U7, U8, U9: ACS724LLCTR-50AB; SOIC-8_3.9x4.9mm_P1.27mm
U10: MP1584EN; SOIC127P600X170-9N

Connections:
+3.3V: C26.1, D2.1 (K), U2.2 (VO); also elsewhere on the board
+5V: C11.1, C14.1, C16.1, C24.1, C25.1, L1.2, R17.2, U2.3 (VI), U7.8 (VCC), U8.8 (VCC), U9.8 (VCC); also elsewhere on the board
+24V: C18.1, J8.1, R20.1, R21.1, U7.3 (IP-), U7.4 (IP-), U8.3 (IP-), U8.4 (IP-), U9.3 (IP-), U9.4 (IP-), U10.7 (VIN)
/BUS_VOLTAGE: D2.2 (A), R21.2, R22.1; also elsewhere on the board
/OUT_CURRENT1: R14.2, R15.1; also elsewhere on the board
/OUT_CURRENT2: R10.2, R11.1; also elsewhere on the board
/OUT_CURRENT3: R12.2, R13.1; also elsewhere on the board
GND: C11.2, C12.2, C13.2, C14.2, C15.2, C16.2, C18.2, C22.2, C24.2, C25.2, C26.2, D1.2 (A), J5.1, J6.1, J7.1, J8.2, R11.2, R13.2, R15.2, R16.2, R18.2, R19.2, R22.2, U2.1 (GND), U7.5 (GND), U8.5 (GND), U9.5 (GND), U10.5 (GND), U10.9 (GND); also elsewhere on the board
unnamed: C21.2, R18.1
unnamed: C19.2, D1.1 (K), L1.1, U10.1 (SW)
unnamed: J5.2, U7.1 (IP+), U7.2 (IP+)
unnamed: J6.2, U8.1 (IP+), U8.2 (IP+)
unnamed: J7.2, U9.1 (IP+), U9.2 (IP+)
unnamed: C12.1, U7.6 (FILTER)
unnamed: R10.1, U7.7 (VIOUT)
unnamed: C13.1, U8.6 (FILTER)
unnamed: R12.1, U8.7 (VIOUT)
unnamed: C15.1, U9.6 (FILTER)
unnamed: R14.1, U9.7 (VIOUT)
unnamed: C19.1, U10.8 (BST)
unnamed: C21.1, C22.1, U10.3 (COMP)
unnamed: R20.2, U10.2 (EN)
unnamed: R16.1, R17.1, U10.4 (FB)
unnamed: R19.1, U10.6 (FREQ)

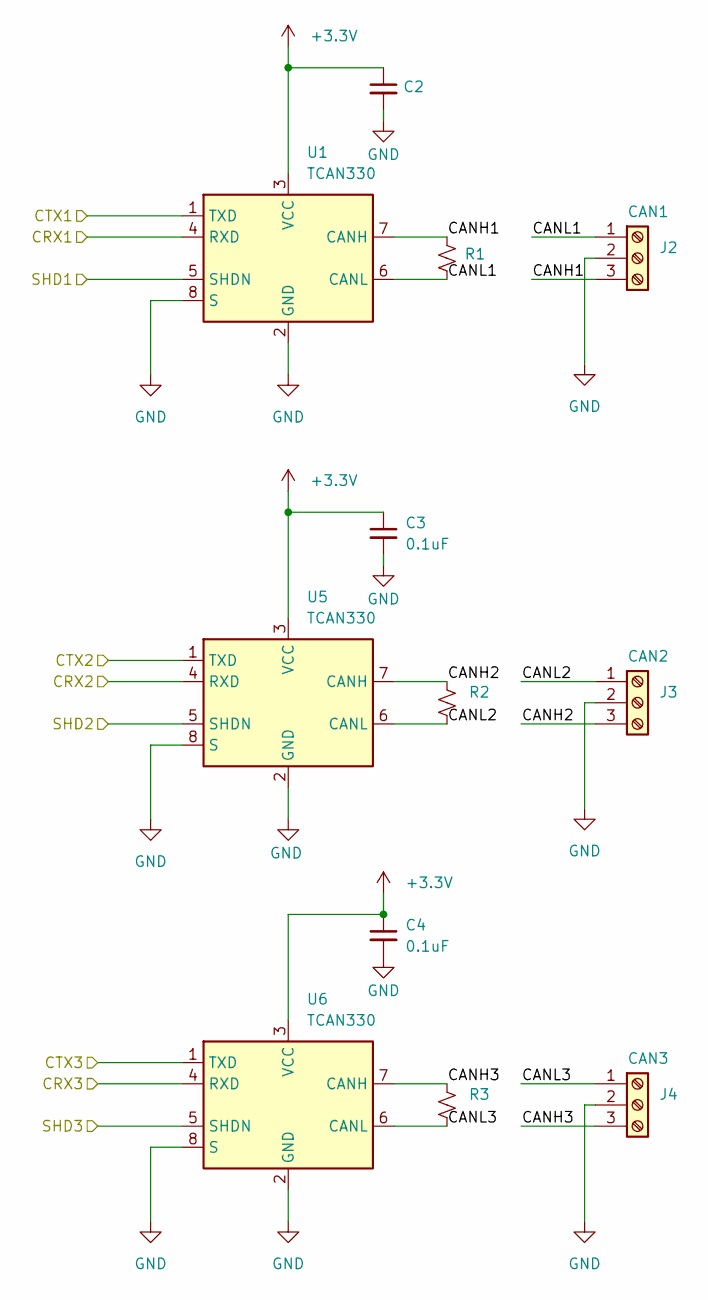
[picture p316: schematic can.kicad_sch]

Parts:
C2, C3, C4: 0.1uF; C_0805_2012Metric
J2: CAN1; TerminalBlock_MaiXu_MX126-5.0-03P_1x03_P5.00mm
J3: CAN2; TerminalBlock_MaiXu_MX126-5.0-03P_1x03_P5.00mm
J4: CAN3; TerminalBlock_MaiXu_MX126-5.0-03P_1x03_P5.00mm
R1, R2, R3: 120R; R_0805_2012Metric_Pad1.20x1.40mm_HandSolder
U1, U5, U6: TCAN330; TSOT-23-8

Connections:
+3.3V: C2.1, C3.1, C4.1, U1.3 (VCC), U5.3 (VCC), U6.3 (VCC); also elsewhere on the board
/CAN_SHD1: U1.5 (SHDN); also elsewhere on the board
/CAN_SHD2: U5.5 (SHDN); also elsewhere on the board
/CAN_SHD3: U6.5 (SHDN); also elsewhere on the board
/CAN_SUBSYSTEM/CANH1: J2.3, R1.1, U1.7 (CANH)
/CAN_SUBSYSTEM/CANH2: J3.3, R2.1, U5.7 (CANH)
/CAN_SUBSYSTEM/CANH3: J4.3, R3.1, U6.7 (CANH)
/CAN_SUBSYSTEM/CANL1: J2.1, R1.2, U1.6 (CANL)
/CAN_SUBSYSTEM/CANL2: J3.1, R2.2, U5.6 (CANL)
/CAN_SUBSYSTEM/CANL3: J4.1, R3.2, U6.6 (CANL)
/CRX1: U1.4 (RXD); also elsewhere on the board
/CRX2: U5.4 (RXD); also elsewhere on the board
/CRX3: U6.4 (RXD); also elsewhere on the board
/CTX1: U1.1 (TXD); also elsewhere on the board
/CTX2: U5.1 (TXD); also elsewhere on the board
/CTX3: U6.1 (TXD); also elsewhere on the board
GND: C2.2, C3.2, C4.2, J2.2, J3.2, J4.2, U1.2 (GND), U1.8 (S), U5.2 (GND), U5.8 (S), U6.2 (GND), U6.8 (S); also elsewhere on the board

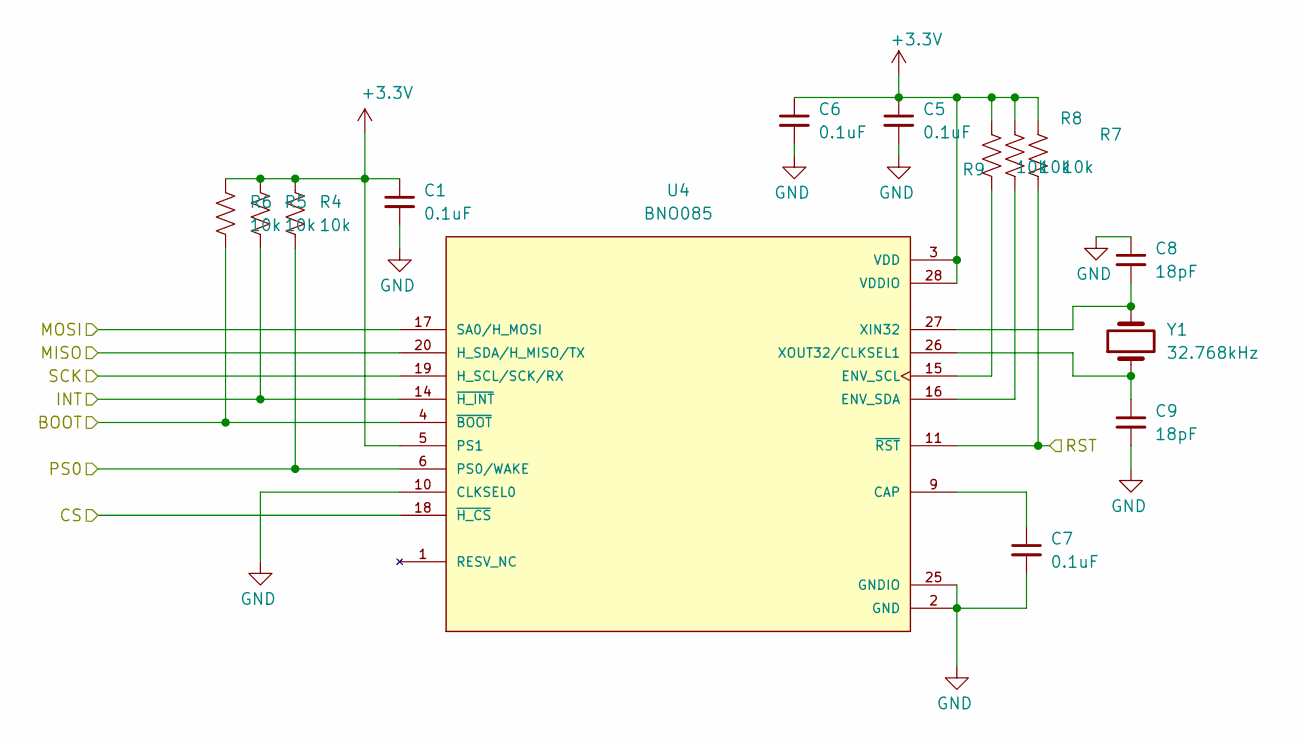
[picture p317: schematic untitled.kicad_sch]

Parts:
C1, C5, C6, C7: 0.1uF; C_0805_2012Metric
C8, C9: 18pF; C_0805_2012Metric
R4, R5, R6, R7, R8, R9: 10k; R_0805_2012Metric
U4: BNO085; IC_BNO085; PARTREV v1.17
Y1: 32.768kHz; Crystal_SMD_3215-2Pin_3.2x1.5mm

Connections:
+3.3V: C1.1, C5.1, C6.1, R4.1, R5.1, R6.1, R7.1, R8.1, R9.1, U4.3 (VDD), U4.5 (PS1), U4.28 (VDDIO); also elsewhere on the board
/IMU_BOOT: R6.2, U4.4 (~BOOT); also elsewhere on the board
/IMU_CS: U4.18 (~H_CS); also elsewhere on the board
/IMU_INT: R5.2, U4.14 (~H_INT); also elsewhere on the board
/IMU_MISO: U4.20 (H_SDA/H_MISO/TX); also elsewhere on the board
/IMU_MOSI: U4.17 (SA0/H_MOSI); also elsewhere on the board
/IMU_PS0: R4.2, U4.6 (PS0/WAKE); also elsewhere on the board
/IMU_RST: R7.2, U4.11 (~RST); also elsewhere on the board
/IMU_SCK: U4.19 (H_SCL/SCK/RX); also elsewhere on the board
GND: C1.2, C5.2, C6.2, C7.2, C8.1, C9.2, U4.2 (GND), U4.10 (CLKSEL0), U4.25 (GNDIO); also elsewhere on the board
unnamed: C7.1, U4.9 (CAP)
unnamed: R9.2, U4.15 (ENV_SCL)
unnamed: R8.2, U4.16 (ENV_SDA)
unnamed: C8.2, U4.27 (XIN32), Y1.2
unnamed: C9.1, U4.26 (XOUT32/CLKSEL1), Y1.1

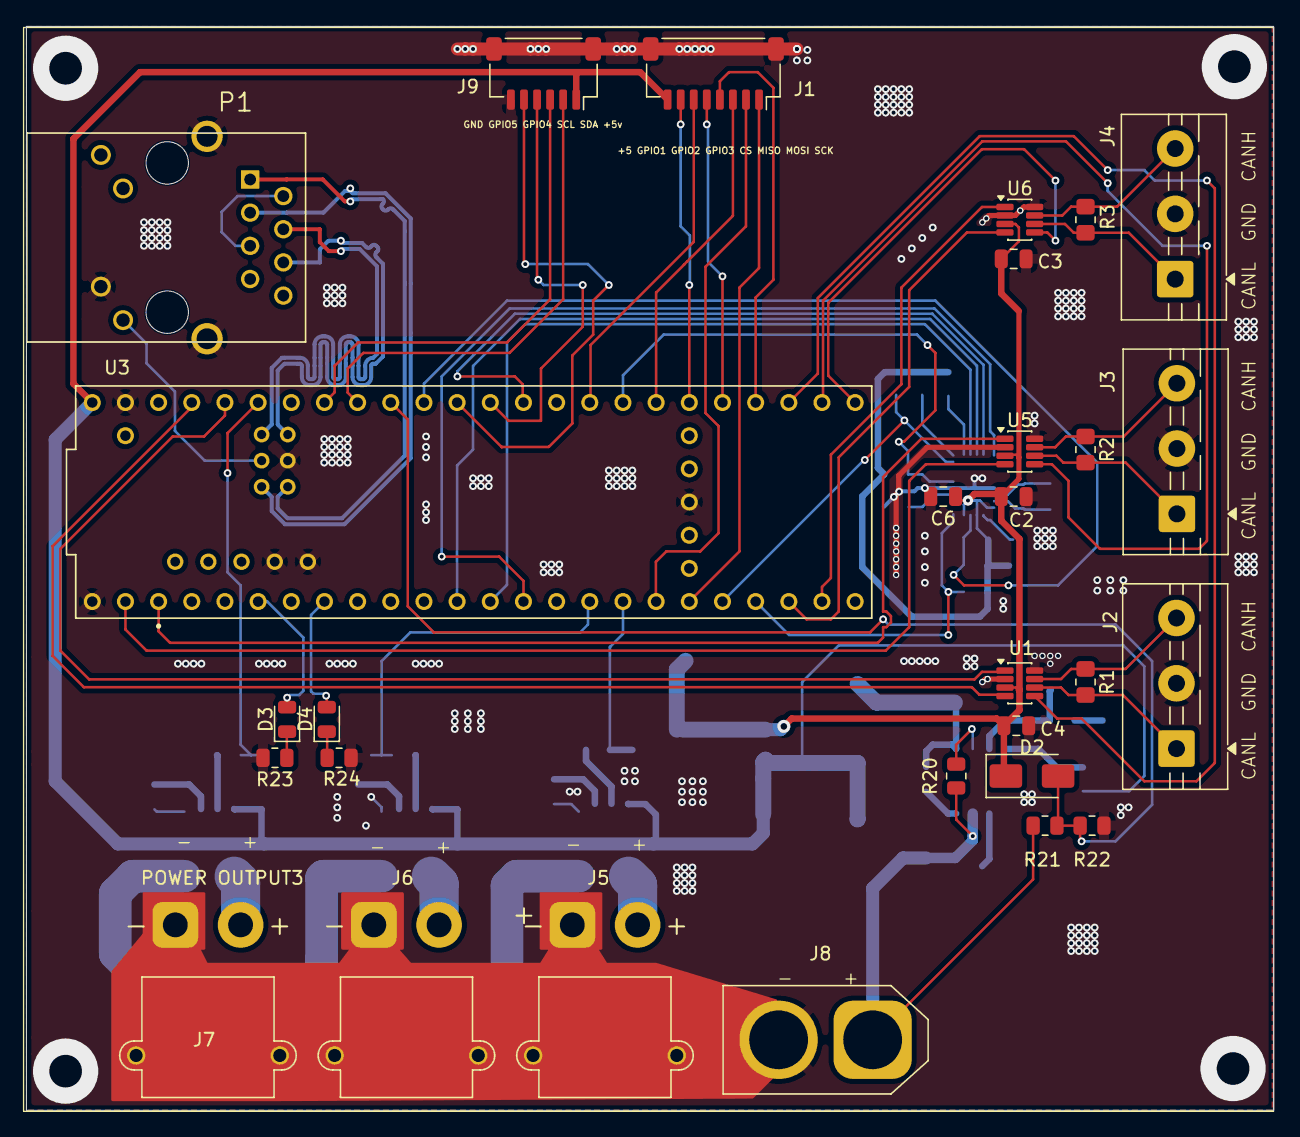
[picture p318: board Motherboard.kicad_pcb from above]

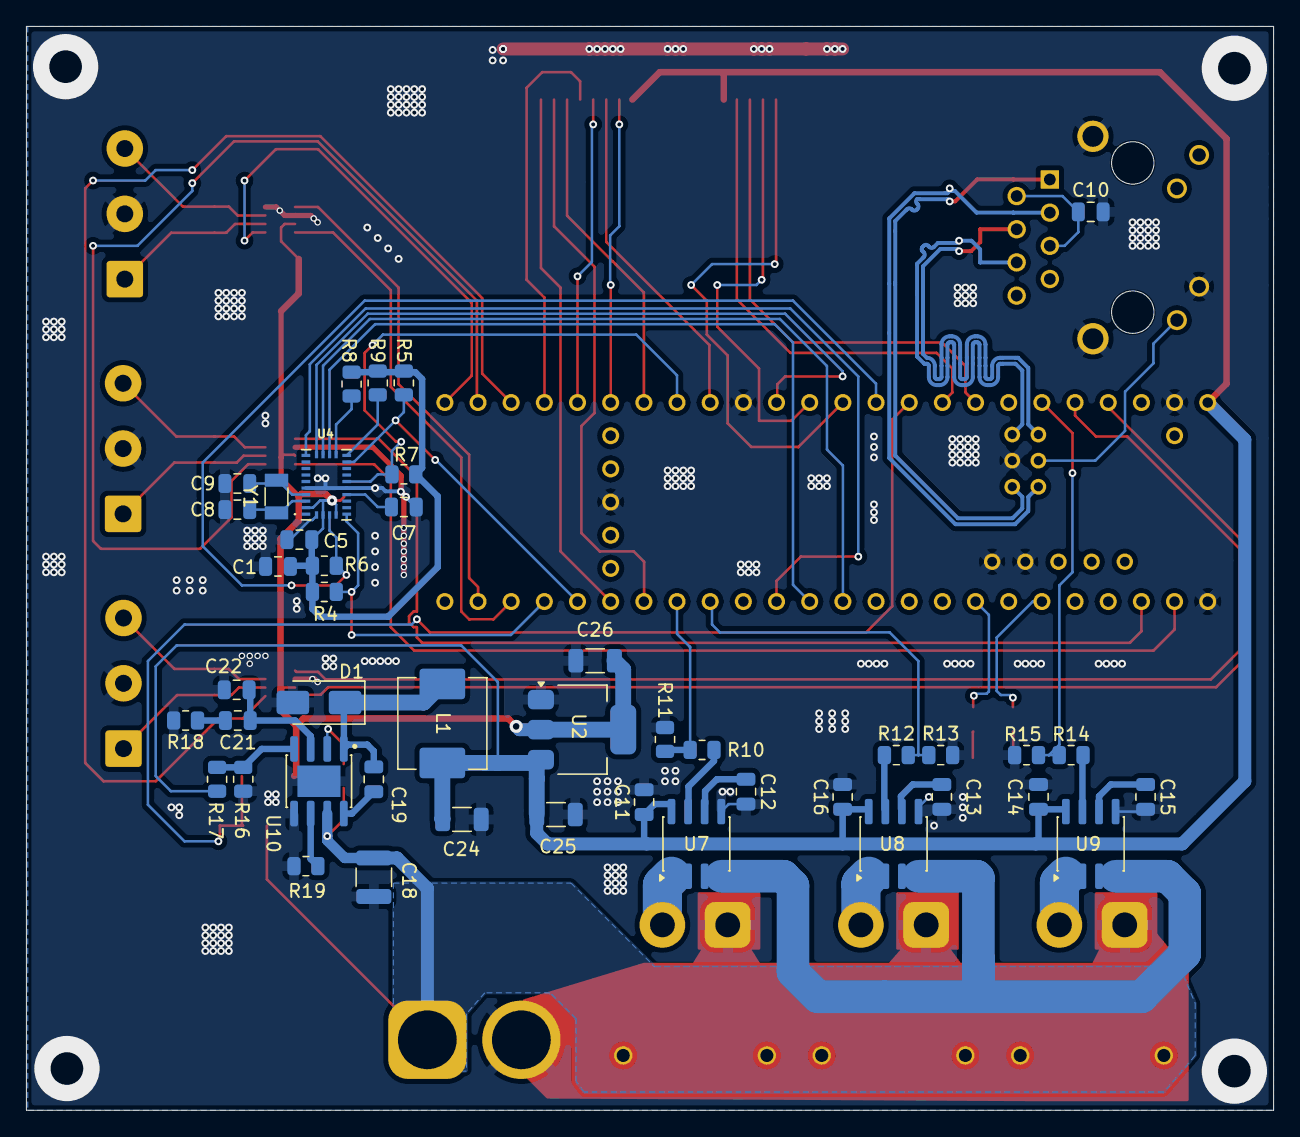
[picture p319: board Motherboard.kicad_pcb from below]

Board: 2 copper layers, 95.5 x 83.0 mm, 73 parts (44 on the bottom side), 74 nets.
