Klajdi00/open_mabel/firmware/orca_hand/feetech/orcahand/hand.py

"""OrcaHand -- the joint-space hardware interface for the MABEL ORCA hand.

This is the one class controllers, learned policies, and the ROS node all use.
It speaks SI units (radians, rad/s) and joint names; everything below it (tick
conversion, calibration clamping, serial framing) is hidden.

Quick start
-----------
::

    from orcahand import OrcaHand

    with OrcaHand("right") as hand:          # auto-detects the USB port
        hand.set_joint_positions({"index_mcp": 0.5, "thumb_cmc": 0.1})  # radians
        state = hand.get_state()
        print(state.position["index_mcp"], state.temperature.hottest())

Design contract
---------------
* All angles are **radians**; all velocities **rad/s**.
* Inputs are dicts ``{joint_name: angle}`` (partial dicts are fine -- only the
  named joints move) or arrays ordered by :attr:`joint_names`.
* Every command is clamped to the calibrated tick range -- a bad target can
  never drive a tendon past its hardware end-stop.
* ``connect`` / ``disconnect`` are idempotent; ``disconnect`` always disables
  torque first. The class is a context manager.
* Thread-safe: the underlying :class:`~orcahand.bus.FeetechBus` serialises every
  transaction, so a feedback thread and a command thread can share one hand.

For development without hardware use :meth:`OrcaHand.mock`, which swaps in an
in-memory bus exposing the identical API.
"""

from __future__ import annotations

import time
from typing import Dict, List, Optional, Sequence, Union

from . import constants as C
from .bus import FeetechBus
from .config import HandConfig
from .poses import POSES
from .state import HandState

JointTargets = Union[Dict[str, float], Sequence[float]]


class OrcaHand:
    """High-level joint-space interface to one physical ORCA hand."""

    def __init__(
        self,
        model: Optional[str] = None,
        *,
        config_path: Optional[str] = None,
        calibration_path: Optional[str] = None,
        port: Optional[str] = None,
        baudrate: int = C.DEFAULT_BAUDRATE,
        torque_limit: int = C.DEFAULT_TORQUE_LIMIT,
        goal_speed: int = C.DEFAULT_GOAL_SPEED,
        goal_acc: int = C.DEFAULT_GOAL_ACC,
        bus: Optional[FeetechBus] = None,
    ):
        """Create a hand interface (does not open the port until ``connect``).
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
