Klajdi00/open_mabel/(commit log)

2026-11-04 MABEL: open-source release
    [1_body_to_head.stl, 1_body_to_shoulder.stl, 2_neck_1.stl, 2_shoulder.stl, 3_neck_2.stl, 3_shoulder_to_elbow.stl, 4_head.stl, 4_head_old.stl]
2026-11-04 CAD: add missing body part to full assembly
