Klajdi00/open_mabel/(notices)

Notices in the files:
simulation/mabel_mujoco/models/meshes/visual/gripper/hand_1.obj:
Copyright 2025 Enactic, Inc.
Licensed under the Apache License, Version 2.0 (the "License");
